luciddreams/ito-controller/3d-review/isometric.png

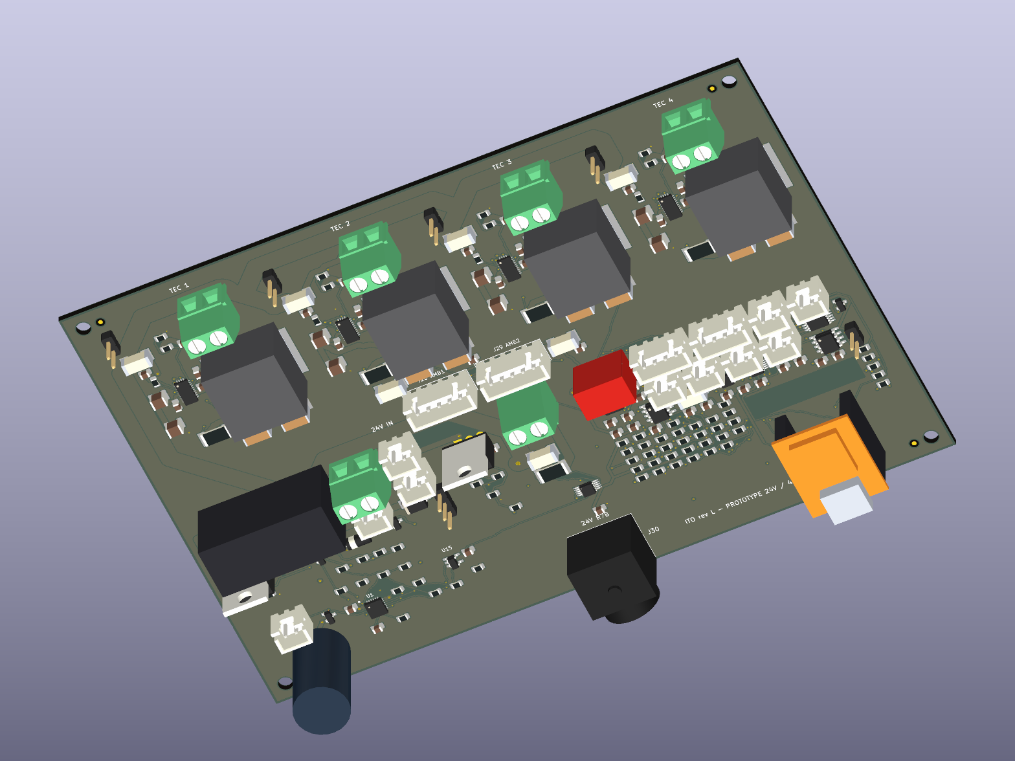
3d-review/isometric.png
