luciddreams/ito-controller/3d-review/top.png

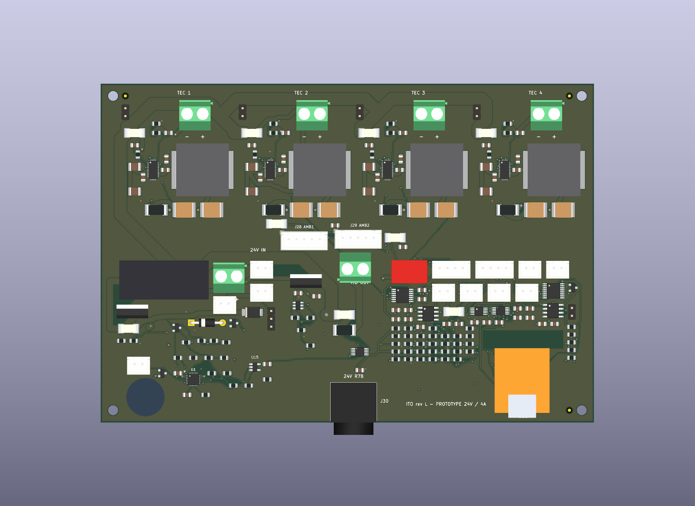
3d-review/top.png
