luciddreams/ito-controller/datasheets/README.md

# Datasheets and component index

Retrieved/checked on 26 September 2026. Exact suffixes and order codes in the BOM remain authoritative. This is a reference collection, not new component qualification.

Local PDFs were checked for readability. All 202 PCB positions are indexed; missing PDF downloads are explicit. Unselected external parts cannot yet have definitive applicable datasheets.

## Complete PCB BOM

| Manufacturer / MPN | References | Document |
|---|---|---|
| Samtec SSW-107-01-G-S | J1, J2 | [Samtec-SSW](Samtec-SSW.pdf) |
| TRACO Power TSR 1-2450 | M1 | [TSR1](TSR1.pdf) |
| Samtec TSW-102-07-G-S | JP1, TP11, TP12, TP13, TP14 | [Samtec-TSW](Samtec-TSW.pdf) |
| Murata GRM21BR61E106KA73L | C1, C2 | [GRM21BR61E106KA73L](GRM21BR61E106KA73L.pdf) |
| Yageo RC0805FR-072K2L | R1, R2, R20 | [Yageo-RC](Yageo-RC.pdf) |
| Yageo RC0805FR-0710KL | R3, R15, R24, R74 | [Yageo-RC](Yageo-RC.pdf) |
| JST B2B-XH-A(LF)(SN) | J5, J6, J7, J8, J21, J22, J23, J24, J25, J9 | [JST-XH](JST-XH.pdf) |
| Yageo RC0805JR-070RL | R4 | [Yageo-RC](Yageo-RC.pdf) |
| Yageo RT0805BRD0710KL | R5, R11, R13, R17, R42, R43, R44, R45, R46, R47, R48, R49, R61, R62, R63, R64, R70 | [Yageo-RT](Yageo-RT.pdf) |
| Yageo RC0805FR-071KL | R6, R18, R65, R66, R67, R68, R71 | [Yageo-RC](Yageo-RC.pdf) |
| Murata GRM21BR71H104KA01L | C3, C4, C10, C12, C20, C21, C22, C23, C24, C26, C28, C30, C31, C105, C205, C305, C405, C40, C41, C42, C43, C44, C50, C7 | [GRM21BR71H104KA01L](GRM21BR71H104KA01L.pdf) |
| Yageo RC0805FR-074K7L | R7, R72 | [Yageo-RC](Yageo-RC.pdf) |
| Phoenix Contact 1715721 | J3, J4, J11, J12, J13, J14 | **PDF missing** — [source](https://www.phoenixcontact.com/services/products/1715721/pdf) |
| Littelfuse 0451010.MRL | F1 | [Littelfuse-451-453](Littelfuse-451-453.pdf) |
| Littelfuse SMBJ33CA | D1 | [SMBJ](SMBJ.pdf) |
| Texas Instruments TPS26630RGER | U1 | [TPS2663](TPS2663.pdf) |
| Yageo RT0805BRD07156KL | R10 | [Yageo-RT](Yageo-RT.pdf) |
| Yageo RT0805BRD07223KL | R12 | [Yageo-RT](Yageo-RT.pdf) |
| Yageo RT0805BRD074K02L | R14 | [Yageo-RT](Yageo-RT.pdf) |
| Infineon IRLB4030PBF | Q2 | [IRLB4030](IRLB4030.pdf) |
| onsemi BSS138LT1G | Q3 | [BSS138](BSS138.pdf) |
| Yageo RT0805BRD07150KL | R16 | [Yageo-RT](Yageo-RT.pdf) |
| Panasonic EEUFR1H471 | C5 | [Panasonic-FR](Panasonic-FR.pdf) |
| Murata GRM21BR71H105KA12L | C6, C11, C103, C104, C203, C204, C303, C304, C403, C404, C51, C52 | [GRM21BR71H105KA12L](GRM21BR71H105KA12L.pdf) |
| Omron G2RL-1A-E DC24 | K1 | [Omron-G2RL](Omron-G2RL.pdf) |
| Vishay 1N4007-E3/54 | D2 | [1N4007](1N4007.pdf) |
| onsemi MMBT3904LT1G | Q4, Q5, Q6 | [MMBT3904](MMBT3904.pdf) |
| Yageo RC0805FR-07100KL | R21, R22, R23, R32, R33, R51, R55, R52, R56, R53, R57, R54, R58, R103, R203, R303, R403, R73, R19 | [Yageo-RC](Yageo-RC.pdf) |
| Panasonic ERJP06F1002V | R25 | [Panasonic-ERJP06](Panasonic-ERJP06.pdf) |
| Samtec TSW-103-07-G-S | TP1 | [Samtec-TSW](Samtec-TSW.pdf) |
| Littelfuse 0451005.MRL | F2 | [Littelfuse-451-453](Littelfuse-451-453.pdf) |
| Vishay WSL2512R0100FEA | RSH1 | [WSL](WSL.pdf) |
| STMicroelectronics STP55NF06L | Q1 | [STP55NF06L](STP55NF06L.pdf) |
| Texas Instruments UCC27511DBVR | U2 | [UCC27511](UCC27511.pdf) |
| Yageo RC0805FR-0722RL | R30 | [Yageo-RC](Yageo-RC.pdf) |
| Yageo RC0805FR-0710RL | R31 | [Yageo-RC](Yageo-RC.pdf) |
| Texas Instruments INA226AIDGSR | U3 | [INA226](INA226.pdf) |
| Microchip MCP4728-E/UN | U4 | [MCP4728](MCP4728.pdf) |
| Texas Instruments OPA2333AIDR | U5, U6 | [OPA333](OPA333.pdf) |
| Texas Instruments TCA9534PWR | U7 | [TCA9534](TCA9534.pdf) |
| Texas Instruments SN74LVC08APWR | U8 | [SN74LVC08A](SN74LVC08A.pdf) |
| Analog Devices LT8613EUDE#PBF | U11, U12, U13, U14 | [LT8613](LT8613.pdf) |
| Littelfuse 045102.5MRL | F11, F12, F13, F14 | [Littelfuse-451-453](Littelfuse-451-453.pdf) |
| Murata GRM32ER71H106KA12L | C101, C102, C201, C202, C301, C302, C401, C402 | **PDF missing** — [Murata product search](https://pim.murata.com/en-global/pim/details/?partNum=GRM32ER71H106KA12L) |
| Murata GRM21BR71H103KA01L | C106, C206, C306, C406 | **PDF missing** — [Murata product search](https://pim.murata.com/en-global/pim/details/?partNum=GRM21BR71H103KA01L) |
| Yageo RC0805FR-0788K7L | R101, R201, R301, R401 | [Yageo-RC](Yageo-RC.pdf) |
| Vishay IHLP6767GZEK100M11 | L1, L2, L3, L4 | [IHLP6767GZ](IHLP6767GZ.pdf) |
| KEMET C2220C476M3R2C7186 | C107, C108, C207, C208, C307, C308, C407, C408 | [KEMET-KPS-X7R](KEMET-KPS-X7R.pdf) |
| Vishay WSL2512R0250FEA | RS1, RS2, RS3, RS4 | [WSL](WSL.pdf) |
| Yageo RC0805FR-071M13L | R102, R202, R302, R402 | [Yageo-RC](Yageo-RC.pdf) |
| KEMET C0805C100J5GACTU | C109, C209, C309, C409 | [KEMET-C0G](KEMET-C0G.pdf) |
| Texas Instruments ADS1115IDGSR | U9 | [ADS1115](ADS1115.pdf) |
| JST B4B-XH-A(LF)(SN) | J26, J27 | [JST-XH](JST-XH.pdf) |
| Littelfuse 0451001.MRL | F3 | [Littelfuse-451-453](Littelfuse-451-453.pdf) |
| Texas Instruments SN74AHC1G08DBVR | U15 | [SN74AHC1G08](SN74AHC1G08.pdf) |
| JST B5B-XH-A(LF)(SN) | J28, J29 | [JST-XH](JST-XH.pdf) |
| Littelfuse 0451.250MRL | F4, F5 | [Littelfuse-451-453](Littelfuse-451-453.pdf) |
| Kycon KPJX-4S | J30 | [KPJX-4S](KPJX-4S.pdf) |

## System and external modules

| Item | Reference |
|---|---|
| GST160A | [GST160A.pdf](GST160A.pdf) |
| XIAO-nRF52840-schematic | [XIAO-nRF52840-schematic.pdf](XIAO-nRF52840-schematic.pdf) |
| XIAO-series-manual | [XIAO-series-manual.pdf](XIAO-series-manual.pdf) |
| TEC1-12706-reference | [TEC1-12706-reference.pdf](TEC1-12706-reference.pdf) |
| PCA9615 | [PCA9615.pdf](PCA9615.pdf) |
| SHT3x-DIS | [SHT3x-DIS.pdf](SHT3x-DIS.pdf) |
| SparkFun COM-16988 | [Official adapter schematic](https://github.com/sparkfun/QwiicBus_EndPoint/blob/main/Hardware/SparkFun_QwiicBus_Endpoint.sch) |
| Adafruit 2857 | [Official module guide](https://learn.adafruit.com/adafruit-sht31-d-temperature-and-humidity-sensor-breakout/pinouts); SHT3x PDF above |
| Phoenix 1715721 | [Official product data and drawings](https://www.phoenixcontact.com/en-sg/products/printed-circuit-board-terminal-mkds-15-2-508-1715721) |

TEC1-12706 is a generic type designation; the reference PDF does not identify the manufacturer of the purchased modules. XIAO documents may cover several variants: use the BLE nRF52840 and the specified pinout, not Plus/Sense.

Still to select: exact 10 kΩ NTC probes, NC thermostats/emergency stop, 24 V fan, air/water cooling, coating and thermal interfaces. Definitive datasheets depend on the eventual order codes.

## Provenance and integrity

`manifest.json` records source URL, date, size and SHA-256, or a download error. `bom-coverage.json` maps all 202 positions. The GRM21BR61E106KA73L manufacturer document was retrieved through a third-party mirror; this does not establish that it is the latest revision. Check current manufacturer specifications before production.
