luciddreams/ito-controller/manufacturing/drill-report.txt

Drill report for ito-controller.kicad_pcb
Created on 2026-09-24T10:47:52+0100

Copper Layer Stackup:
    =============================================================
    L1 :  F.Cu                      front
    L2 :  In1.Cu                    in1
    L3 :  In2.Cu                    in2
    L4 :  B.Cu                      back

Drill file 'ito-controller-PTH.drl' contains
    plated through holes:
    =============================================================
    T1  0.250mm  0.0098"  (159 holes)
    T2  0.300mm  0.0118"  (126 holes)
    T3  0.350mm  0.0138"  (1 hole)
    T4  0.400mm  0.0157"  (4 holes)
    T5  0.500mm  0.0197"  (27 holes)
    T6  0.600mm  0.0236"  (4 holes)
    T7  0.600mm  0.0236"  (4 holes)  (with 4 slots)
    T8  0.950mm  0.0374"  (18 holes)
    T9  1.000mm  0.0394"  (2 holes)
    T10  1.000mm  0.0394"  (50 holes)
    T11  1.100mm  0.0433"  (8 holes)
    T12  1.200mm  0.0472"  (2 holes)
    T13  1.300mm  0.0512"  (18 holes)

    Total plated holes count 423

Drill file 'ito-controller-NPTH.drl' contains
    unplated through holes:
    =============================================================
    T1  1.000mm  0.0394"  (1 hole)  (with 1 slot)
    T2  1.700mm  0.0669"  (2 holes)
    T3  3.200mm  0.1260"  (4 holes)

    Total unplated holes count 7
