luciddreams/ito-controller/docs/GITHUB-IMPORT.md

# Revision L GitHub import

Target: https://github.com/luciddreams/ito-controller

On 26 September 2026, access was confirmed for the connected user `jasjazuidmeer`, including write permission. The repository was empty before the import. Initial full-project commit: `78a5e5b91e51cb6c364b3cd9b65e039dc381aa2d`.

The import included revision L, firmware, fabrication output, models, detailed documentation and 40 available manufacturer PDFs. The datasheet index maps all 202 PCB positions and explicitly identifies three part types with missing PDFs. Exact external NTC probes, fan and thermostats remain unselected.

PCB, schematic and firmware engineering files were unchanged by the initial documentation import. Existing checks were retained; no physical tests were performed. Historical revisions are explicitly archived. No project license has been selected.

The subsequent English-language update translates current documentation and schematic annotations. See `english-localization-validation.json` for verification of that update.
