luciddreams/ito-controller/THIRD-PARTY-NOTICES.md

# Third-party documents and models

Manufacturer datasheets, drawings, module names and trademarks remain the property of their respective rights holders. They are included as engineering references at the project owner's request and are not relicensed under a new project license. Source URL, retrieval date and SHA-256 are recorded in `datasheets/manifest.json`. Family datasheets cover multiple order codes; verify the exact suffix and ratings before ordering.

Model provenance is described in `3D-INSPECTION.md` and the model directory. Firmware depends on the external Seeed/Adafruit board core described in `firmware/README.md`; the complete core is not bundled. No license has been selected for the project's own work. Manufacturer documents retain their original language and content.
