luciddreams/ito-controller/3d-review/bottom.png

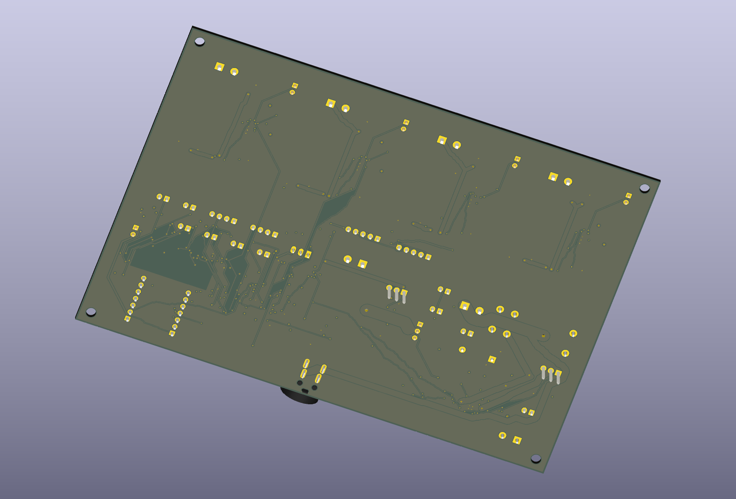
3d-review/bottom.png
