luciddreams/ito-controller/pcb-routing-preview.png

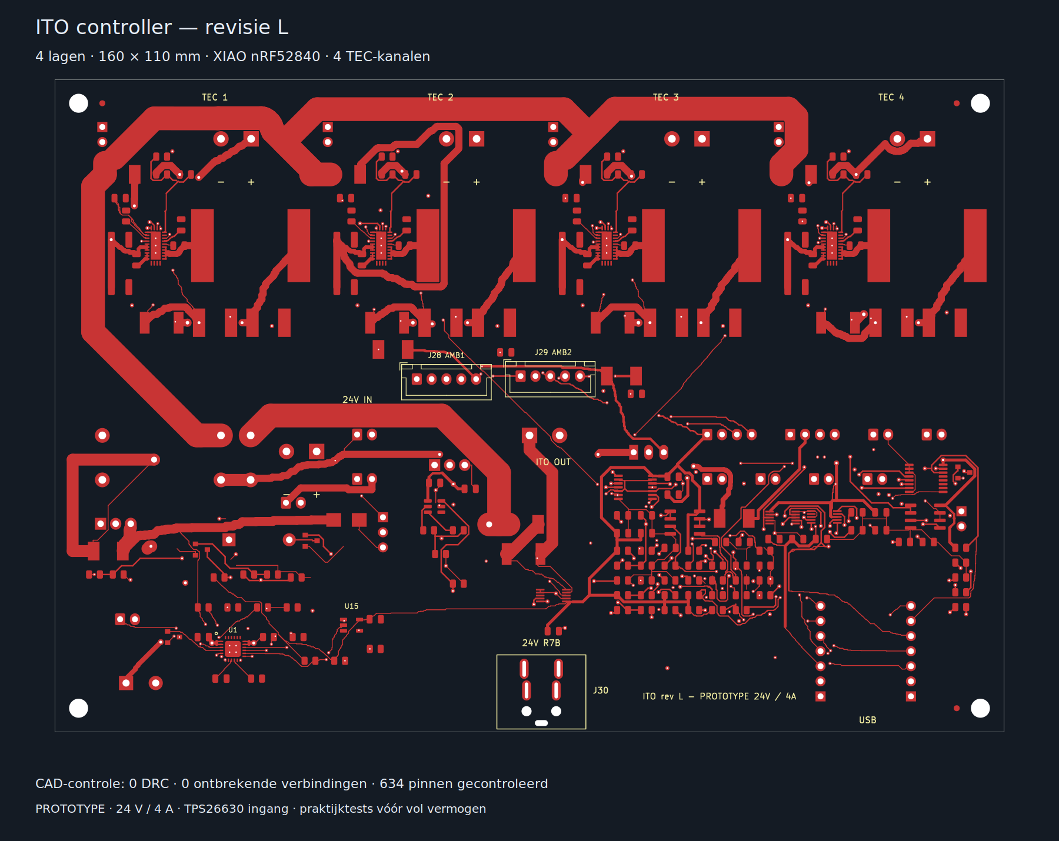
pcb-routing-preview.png
