luciddreams/ito-controller/BOM-prototype.csv

Reference | Quantity | Value | Description_EN | Manufacturer | MPN | Footprint | Specification | Assembly
J1 | 1 | XIAO right socket 1x7 - USB down | XIAO right socket 1x7 - USB down | Samtec | SSW-107-01-G-S | ITO_PCB:PinSocket_1x07_P2.54mm_Vertical |  | THT manual
J2 | 1 | XIAO left socket 1x7 - USB down | XIAO left socket 1x7 - USB down | Samtec | SSW-107-01-G-S | ITO_PCB:PinSocket_1x07_P2.54mm_Vertical |  | THT manual
M1 | 1 | TSR 1-2450 | TSR 1-2450 | TRACO Power | TSR 1-2450 | ITO_PCB:Converter_DCDC_TRACO_TSR-1_THT |  | THT manual
JP1 | 1 | Voedingsjumper - standaard OPEN | Power jumper - default OPEN | Samtec | TSW-102-07-G-S | ITO_PCB:PinHeader_1x02_P2.54mm_Vertical |  | THT manual
C1 | 1 | 10u / 10V | 10u / 10V | Murata | GRM21BR61E106KA73L | ITO_PCB:C_0805_2012Metric | 0805, 10uF, 25V, X5R, 10%; used on <=5V rails | SMT
C2 | 1 | 10u / 10V | 10u / 10V | Murata | GRM21BR61E106KA73L | ITO_PCB:C_0805_2012Metric | 0805, 10uF, 25V, X5R, 10%; used on <=5V rails | SMT
R1 | 1 | 2k2 | 2k2 | Yageo | RC0805FR-072K2L | ITO_PCB:R_0805_2012Metric | 0805, 1%, >=0.125W, >=50V | SMT
R2 | 1 | 2k2 | 2k2 | Yageo | RC0805FR-072K2L | ITO_PCB:R_0805_2012Metric | 0805, 1%, >=0.125W, >=50V | SMT
R3 | 1 | 10k | 10k | Yageo | RC0805FR-0710KL | ITO_PCB:R_0805_2012Metric | 0805, 1%, >=0.125W, >=50V | SMT
J5 | 1 | Connector 2 pins | Connector 2 pins | JST | B2B-XH-A(LF)(SN) | ITO_PCB:JST_XH_B2B-XH-A_1x02_P2.50mm_Vertical |  | THT manual
R4 | 1 | 0R | 0R | Yageo | RC0805JR-070RL | ITO_PCB:R_0805_2012Metric | 0805 zero-ohm link; signal only | SMT
R5 | 1 | 10k 0.1% | 10k 0.1% | Yageo | RT0805BRD0710KL | ITO_PCB:R_0805_2012Metric | 0805 thin film, 0.1%, 25ppm/K or better, >=0.125W | SMT
R6 | 1 | 1k | 1k | Yageo | RC0805FR-071KL | ITO_PCB:R_0805_2012Metric | 0805, 1%, >=0.125W, >=50V | SMT
C3 | 1 | 100n | 100n | Murata | GRM21BR71H104KA01L | ITO_PCB:C_0805_2012Metric | 0805, 100nF, 50V, X7R, 10% | SMT
R7 | 1 | 4k7 | 4k7 | Yageo | RC0805FR-074K7L | ITO_PCB:R_0805_2012Metric | 0805, 1%, >=0.125W, >=50V | SMT
J3 | 1 | Connector 2 pins | Connector 2 pins | Phoenix Contact | 1715721 | ITO_PCB:TerminalBlock_Phoenix_MKDS-1,5-2-5.08_1x02_P5.08mm_Horizontal | MKDS 1,5/2-5,08; 2 positions, pitch 5.08mm | THT manual
F1 | 1 | 10A / 125V DC 0451010.MRL | 10A / 125V DC 0451010.MRL | Littelfuse | 0451010.MRL | ITO_PCB:Littelfuse_451 |  | SMT
D1 | 1 | SMBJ33CA bidirectioneel | SMBJ33CA bidirectioneel | Littelfuse | SMBJ33CA | ITO_PCB:D_SMB |  | SMT
U1 | 1 | TPS26630RGER | TPS26630RGER | Texas Instruments | TPS26630RGER | ITO_PCB:TI_RGE0024H_4x4_EP2.7 |  | SMT
R10 | 1 | 156k 0.1% | 156k 0.1% | Yageo | RT0805BRD07156KL | ITO_PCB:R_0805_2012Metric | 0805 thin film, 0.1%, 25ppm/K or better, >=0.125W | SMT
R11 | 1 | 10k 0.1% | 10k 0.1% | Yageo | RT0805BRD0710KL | ITO_PCB:R_0805_2012Metric | 0805 thin film, 0.1%, 25ppm/K or better, >=0.125W | SMT
R12 | 1 | 223k 0.1% | 223k 0.1% | Yageo | RT0805BRD07223KL | ITO_PCB:R_0805_2012Metric | 0805 thin film, 0.1%, 25ppm/K or better, >=0.125W | SMT
R13 | 1 | 10k 0.1% | 10k 0.1% | Yageo | RT0805BRD0710KL | ITO_PCB:R_0805_2012Metric | 0805 thin film, 0.1%, 25ppm/K or better, >=0.125W | SMT
R14 | 1 | 4.02k 0.1% | 4.02k 0.1% | Yageo | RT0805BRD074K02L | ITO_PCB:R_0805_2012Metric | 0805 thin film, 0.1%, 25ppm/K or better, >=0.125W | SMT
R15 | 1 | 10k | 10k | Yageo | RC0805FR-0710KL | ITO_PCB:R_0805_2012Metric | 0805, 1%, >=0.125W, >=50V | SMT
Q2 | 1 | IRLB4030PBF | IRLB4030PBF | Infineon | IRLB4030PBF | ITO_PCB:TO-220-3_Vertical |  | THT manual
Q3 | 1 | BSS138LT1G | BSS138LT1G | onsemi | BSS138LT1G | ITO_PCB:SOT-23 |  | SMT
R16 | 1 | 150k 0.1% | 150k 0.1% | Yageo | RT0805BRD07150KL | ITO_PCB:R_0805_2012Metric | 0805 thin film, 0.1%, 25ppm/K or better, >=0.125W | SMT
R17 | 1 | 10k 0.1% | 10k 0.1% | Yageo | RT0805BRD0710KL | ITO_PCB:R_0805_2012Metric | 0805 thin film, 0.1%, 25ppm/K or better, >=0.125W | SMT
R18 | 1 | 1k | 1k | Yageo | RC0805FR-071KL | ITO_PCB:R_0805_2012Metric | 0805, 1%, >=0.125W, >=50V | SMT
C4 | 1 | 100n / 50V X7R 10% | 100n / 50V X7R 10% | Murata | GRM21BR71H104KA01L | ITO_PCB:C_0805_2012Metric | dVdt timing; calculate with effective C = 70..127nF, including temperature/aging allowance | SMT
C5 | 1 | 470u / 50V EEUFR1H471 | 470u / 50V EEUFR1H471 | Panasonic | EEUFR1H471 | ITO_PCB:CP_Radial_D12.5mm_P5.00mm | 470uF 50V radial; 12.5mm diameter, 5mm pitch; reserve22mm height | THT manual
C6 | 1 | 1u / 50V X7R | 1u / 50V X7R | Murata | GRM21BR71H105KA12L | ITO_PCB:C_0805_2012Metric | 0805, 1uF, 50V, X7R, 10% | SMT
J6 | 1 | Connector 2 pins | Connector 2 pins | JST | B2B-XH-A(LF)(SN) | ITO_PCB:JST_XH_B2B-XH-A_1x02_P2.50mm_Vertical |  | THT manual
J7 | 1 | Connector 2 pins | Connector 2 pins | JST | B2B-XH-A(LF)(SN) | ITO_PCB:JST_XH_B2B-XH-A_1x02_P2.50mm_Vertical |  | THT manual
J8 | 1 | Connector 2 pins | Connector 2 pins | JST | B2B-XH-A(LF)(SN) | ITO_PCB:JST_XH_B2B-XH-A_1x02_P2.50mm_Vertical |  | THT manual
K1 | 1 | G2RL-1A-E DC24 | G2RL-1A-E DC24 | Omron | G2RL-1A-E DC24 | ITO_PCB:G2RL_1A_E_review |  | THT manual
D2 | 1 | 1N4007 | 1N4007 | Vishay | 1N4007-E3/54 | ITO_PCB:D_DO-41_SOD81_P10.16mm_Horizontal |  | THT manual
Q4 | 1 | MMBT3904 | MMBT3904 | onsemi | MMBT3904LT1G | ITO_PCB:SOT-23 |  | SMT
R20 | 1 | 2k2 | 2k2 | Yageo | RC0805FR-072K2L | ITO_PCB:R_0805_2012Metric | 0805, 1%, >=0.125W, >=50V | SMT
R21 | 1 | 100k | 100k | Yageo | RC0805FR-07100KL | ITO_PCB:R_0805_2012Metric | 0805, 1%, >=0.125W, >=50V | SMT
Q5 | 1 | MMBT3904 | MMBT3904 | onsemi | MMBT3904LT1G | ITO_PCB:SOT-23 |  | SMT
R22 | 1 | 100k | 100k | Yageo | RC0805FR-07100KL | ITO_PCB:R_0805_2012Metric | 0805, 1%, >=0.125W, >=50V | SMT
R23 | 1 | 100k | 100k | Yageo | RC0805FR-07100KL | ITO_PCB:R_0805_2012Metric | 0805, 1%, >=0.125W, >=50V | SMT
R24 | 1 | 10k | 10k | Yageo | RC0805FR-0710KL | ITO_PCB:R_0805_2012Metric | 0805, 1%, >=0.125W, >=50V | SMT
R25 | 1 | 10k / 0.25W | 10k / 0.25W | Panasonic | ERJP06F1002V | ITO_PCB:R_0805_2012Metric | 0805 10k 1%, 0.5W; output bleeder. | SMT
TP1 | 1 | Connector 3 pins | Connector 3 pins | Samtec | TSW-103-07-G-S | ITO_PCB:PinHeader_1x03_P2.54mm_Vertical |  | THT manual
F2 | 1 | 5A / 125V DC 0451005.MRL | 5A / 125V DC 0451005.MRL | Littelfuse | 0451005.MRL | ITO_PCB:Littelfuse_451 |  | SMT
RSH1 | 1 | 10m / 1W / 1% WSL2512R0100FEA | 10m / 1W / 1% WSL2512R0100FEA | Vishay | WSL2512R0100FEA | ITO_PCB:WSL2512_7m_to_500m |  | SMT
J4 | 1 | Connector 2 pins | Connector 2 pins | Phoenix Contact | 1715721 | ITO_PCB:TerminalBlock_Phoenix_MKDS-1,5-2-5.08_1x02_P5.08mm_Horizontal | MKDS 1,5/2-5,08; 2 positions, pitch 5.08mm | THT manual
Q1 | 1 | STP55NF06L | STP55NF06L | STMicroelectronics | STP55NF06L | ITO_PCB:TO-220-3_Vertical |  | THT manual
U2 | 1 | UCC27511DBV | UCC27511DBV | Texas Instruments | UCC27511DBVR | ITO_PCB:SOT-23-6 |  | SMT
R30 | 1 | 22R | 22R | Yageo | RC0805FR-0722RL | ITO_PCB:R_0805_2012Metric | 0805, 1%, >=0.125W, >=50V | SMT
R31 | 1 | 10R | 10R | Yageo | RC0805FR-0710RL | ITO_PCB:R_0805_2012Metric | 0805, 1%, >=0.125W, >=50V | SMT
R32 | 1 | 100k | 100k | Yageo | RC0805FR-07100KL | ITO_PCB:R_0805_2012Metric | 0805, 1%, >=0.125W, >=50V | SMT
R33 | 1 | 100k | 100k | Yageo | RC0805FR-07100KL | ITO_PCB:R_0805_2012Metric | 0805, 1%, >=0.125W, >=50V | SMT
C10 | 1 | 100n / 10V | 100n / 10V | Murata | GRM21BR71H104KA01L | ITO_PCB:C_0805_2012Metric | 0805, 100nF, 50V, X7R, 10% | SMT
C11 | 1 | 1u / 10V | 1u / 10V | Murata | GRM21BR71H105KA12L | ITO_PCB:C_0805_2012Metric | 0805, 1uF, 50V, X7R, 10% | SMT
U3 | 1 | INA226AIDGS | INA226AIDGS | Texas Instruments | INA226AIDGSR | ITO_PCB:VSSOP-10_3x3mm_P0.5mm |  | SMT
C12 | 1 | 100n / 10V | 100n / 10V | Murata | GRM21BR71H104KA01L | ITO_PCB:C_0805_2012Metric | 0805, 100nF, 50V, X7R, 10% | SMT
U4 | 1 | MCP4728-E-UN | MCP4728-E-UN | Microchip | MCP4728-E/UN | ITO_PCB:MSOP-10_3x3mm_P0.5mm |  | SMT
C20 | 1 | 100n / 10V | 100n / 10V | Murata | GRM21BR71H104KA01L | ITO_PCB:C_0805_2012Metric | 0805, 100nF, 50V, X7R, 10% | SMT
R42 | 1 | 10k 0.1% | 10k 0.1% | Yageo | RT0805BRD0710KL | ITO_PCB:R_0805_2012Metric | 0805 thin film, 0.1%, 25ppm/K or better, >=0.125W | SMT
R43 | 1 | 10k 0.1% | 10k 0.1% | Yageo | RT0805BRD0710KL | ITO_PCB:R_0805_2012Metric | 0805 thin film, 0.1%, 25ppm/K or better, >=0.125W | SMT
C21 | 1 | 100n / 10V | 100n / 10V | Murata | GRM21BR71H104KA01L | ITO_PCB:C_0805_2012Metric | 0805, 100nF, 50V, X7R, 10% | SMT
R44 | 1 | 10k 0.1% | 10k 0.1% | Yageo | RT0805BRD0710KL | ITO_PCB:R_0805_2012Metric | 0805 thin film, 0.1%, 25ppm/K or better, >=0.125W | SMT
R45 | 1 | 10k 0.1% | 10k 0.1% | Yageo | RT0805BRD0710KL | ITO_PCB:R_0805_2012Metric | 0805 thin film, 0.1%, 25ppm/K or better, >=0.125W | SMT
C22 | 1 | 100n / 10V | 100n / 10V | Murata | GRM21BR71H104KA01L | ITO_PCB:C_0805_2012Metric | 0805, 100nF, 50V, X7R, 10% | SMT
R46 | 1 | 10k 0.1% | 10k 0.1% | Yageo | RT0805BRD0710KL | ITO_PCB:R_0805_2012Metric | 0805 thin film, 0.1%, 25ppm/K or better, >=0.125W | SMT
R47 | 1 | 10k 0.1% | 10k 0.1% | Yageo | RT0805BRD0710KL | ITO_PCB:R_0805_2012Metric | 0805 thin film, 0.1%, 25ppm/K or better, >=0.125W | SMT
C23 | 1 | 100n / 10V | 100n / 10V | Murata | GRM21BR71H104KA01L | ITO_PCB:C_0805_2012Metric | 0805, 100nF, 50V, X7R, 10% | SMT
R48 | 1 | 10k 0.1% | 10k 0.1% | Yageo | RT0805BRD0710KL | ITO_PCB:R_0805_2012Metric | 0805 thin film, 0.1%, 25ppm/K or better, >=0.125W | SMT
R49 | 1 | 10k 0.1% | 10k 0.1% | Yageo | RT0805BRD0710KL | ITO_PCB:R_0805_2012Metric | 0805 thin film, 0.1%, 25ppm/K or better, >=0.125W | SMT
C24 | 1 | 100n / 10V | 100n / 10V | Murata | GRM21BR71H104KA01L | ITO_PCB:C_0805_2012Metric | 0805, 100nF, 50V, X7R, 10% | SMT
U5 | 1 | OPA2333AID | OPA2333AID | Texas Instruments | OPA2333AIDR | ITO_PCB:SOIC-8_3.9x4.9mm_P1.27mm |  | SMT
C26 | 1 | 100n / 10V | 100n / 10V | Murata | GRM21BR71H104KA01L | ITO_PCB:C_0805_2012Metric | 0805, 100nF, 50V, X7R, 10% | SMT
U6 | 1 | OPA2333AID | OPA2333AID | Texas Instruments | OPA2333AIDR | ITO_PCB:SOIC-8_3.9x4.9mm_P1.27mm |  | SMT
C28 | 1 | 100n / 10V | 100n / 10V | Murata | GRM21BR71H104KA01L | ITO_PCB:C_0805_2012Metric | 0805, 100nF, 50V, X7R, 10% | SMT
U7 | 1 | TCA9534PWR | TCA9534PWR | Texas Instruments | TCA9534PWR | ITO_PCB:TSSOP-16_4.4x5mm_P0.65mm |  | SMT
U8 | 1 | SN74LVC08APWR | SN74LVC08APWR | Texas Instruments | SN74LVC08APWR | ITO_PCB:TSSOP-14_4.4x5mm_P0.65mm |  | SMT
C30 | 1 | 100n / 10V | 100n / 10V | Murata | GRM21BR71H104KA01L | ITO_PCB:C_0805_2012Metric | 0805, 100nF, 50V, X7R, 10% | SMT
C31 | 1 | 100n / 10V | 100n / 10V | Murata | GRM21BR71H104KA01L | ITO_PCB:C_0805_2012Metric | 0805, 100nF, 50V, X7R, 10% | SMT
R51 | 1 | 100k | 100k | Yageo | RC0805FR-07100KL | ITO_PCB:R_0805_2012Metric | 0805, 1%, >=0.125W, >=50V | SMT
R55 | 1 | 100k | 100k | Yageo | RC0805FR-07100KL | ITO_PCB:R_0805_2012Metric | 0805, 1%, >=0.125W, >=50V | SMT
R52 | 1 | 100k | 100k | Yageo | RC0805FR-07100KL | ITO_PCB:R_0805_2012Metric | 0805, 1%, >=0.125W, >=50V | SMT
R56 | 1 | 100k | 100k | Yageo | RC0805FR-07100KL | ITO_PCB:R_0805_2012Metric | 0805, 1%, >=0.125W, >=50V | SMT
R53 | 1 | 100k | 100k | Yageo | RC0805FR-07100KL | ITO_PCB:R_0805_2012Metric | 0805, 1%, >=0.125W, >=50V | SMT
R57 | 1 | 100k | 100k | Yageo | RC0805FR-07100KL | ITO_PCB:R_0805_2012Metric | 0805, 1%, >=0.125W, >=50V | SMT
R54 | 1 | 100k | 100k | Yageo | RC0805FR-07100KL | ITO_PCB:R_0805_2012Metric | 0805, 1%, >=0.125W, >=50V | SMT
R58 | 1 | 100k | 100k | Yageo | RC0805FR-07100KL | ITO_PCB:R_0805_2012Metric | 0805, 1%, >=0.125W, >=50V | SMT
U11 | 1 | LT8613EUDE | LT8613EUDE | Analog Devices | LT8613EUDE#PBF | ITO_PCB:QFN-28-1EP_3x6mm_P0.5mm_EP1.7x4.75mm |  | SMT
F11 | 1 | 2.5A / 125V DC 045102.5MRL | 2.5A / 125V DC 045102.5MRL | Littelfuse | 045102.5MRL | ITO_PCB:Littelfuse_451 |  | SMT
C101 | 1 | 10u / 50V X7R | 10u / 50V X7R | Murata | GRM32ER71H106KA12L | ITO_PCB:C_1210_3225Metric | 1210, 10uF, 50V, X7R, 10%; no 0805 substitution | SMT
C102 | 1 | 10u / 50V X7R | 10u / 50V X7R | Murata | GRM32ER71H106KA12L | ITO_PCB:C_1210_3225Metric | 1210, 10uF, 50V, X7R, 10%; no 0805 substitution | SMT
C103 | 1 | 1u / 50V X7R | 1u / 50V X7R | Murata | GRM21BR71H105KA12L | ITO_PCB:C_0805_2012Metric | 0805, 1uF, 50V, X7R, 10% | SMT
C104 | 1 | 1u / 10V | 1u / 10V | Murata | GRM21BR71H105KA12L | ITO_PCB:C_0805_2012Metric | 0805, 1uF, 50V, X7R, 10% | SMT
C105 | 1 | 100n / 10V | 100n / 10V | Murata | GRM21BR71H104KA01L | ITO_PCB:C_0805_2012Metric | 0805, 100nF, 50V, X7R, 10% | SMT
C106 | 1 | 10n / 10V | 10n / 10V | Murata | GRM21BR71H103KA01L | ITO_PCB:C_0805_2012Metric | 0805, 10nF, 50V, X7R, 10% | SMT
R101 | 1 | 88k7 1% | 88k7 1% | Yageo | RC0805FR-0788K7L | ITO_PCB:R_0805_2012Metric | 0805, 1%, >=0.125W, >=50V | SMT
L1 | 1 | 10uH IHLP6767GZEK100M11 | 10uH IHLP6767GZEK100M11 | Vishay | IHLP6767GZEK100M11 | ITO_PCB:L_Vishay_IHLP-6767 |  | SMT
C107 | 1 | 47u / 25V X7R C2220C476M3R2C7186 | 47u / 25V X7R C2220C476M3R2C7186 | KEMET | C2220C476M3R2C7186 | ITO_PCB:KEMET_KPS_2220_Double | KPS stacked 2220, 47uF, 25V, X7R, 20%; custom pads | SMT
C108 | 1 | 47u / 25V X7R C2220C476M3R2C7186 | 47u / 25V X7R C2220C476M3R2C7186 | KEMET | C2220C476M3R2C7186 | ITO_PCB:KEMET_KPS_2220_Double | KPS stacked 2220, 47uF, 25V, X7R, 20%; custom pads | SMT
RS1 | 1 | 25m / 1W / 1% WSL2512R0250FEA | 25m / 1W / 1% WSL2512R0250FEA | Vishay | WSL2512R0250FEA | ITO_PCB:WSL2512_7m_to_500m |  | SMT
R102 | 1 | 1M13 1% | 1M13 1% | Yageo | RC0805FR-071M13L | ITO_PCB:R_0805_2012Metric | 0805, 1%, >=0.125W, >=50V | SMT
R103 | 1 | 100k 1% | 100k 1% | Yageo | RC0805FR-07100KL | ITO_PCB:R_0805_2012Metric | 0805, 1%, >=0.125W, >=50V | SMT
C109 | 1 | 10p C0G | 10p C0G | KEMET | C0805C100J5GACTU | ITO_PCB:C_0805_2012Metric | 0805, 10pF, C0G, 50V, 5% | SMT
J11 | 1 | Connector 2 pins | Connector 2 pins | Phoenix Contact | 1715721 | ITO_PCB:TerminalBlock_Phoenix_MKDS-1,5-2-5.08_1x02_P5.08mm_Horizontal | MKDS 1,5/2-5,08; 2 positions, pitch 5.08mm | THT manual
TP11 | 1 | Connector 2 pins | Connector 2 pins | Samtec | TSW-102-07-G-S | ITO_PCB:PinHeader_1x02_P2.54mm_Vertical |  | THT manual
U12 | 1 | LT8613EUDE | LT8613EUDE | Analog Devices | LT8613EUDE#PBF | ITO_PCB:QFN-28-1EP_3x6mm_P0.5mm_EP1.7x4.75mm |  | SMT
F12 | 1 | 2.5A / 125V DC 045102.5MRL | 2.5A / 125V DC 045102.5MRL | Littelfuse | 045102.5MRL | ITO_PCB:Littelfuse_451 |  | SMT
C201 | 1 | 10u / 50V X7R | 10u / 50V X7R | Murata | GRM32ER71H106KA12L | ITO_PCB:C_1210_3225Metric | 1210, 10uF, 50V, X7R, 10%; no 0805 substitution | SMT
C202 | 1 | 10u / 50V X7R | 10u / 50V X7R | Murata | GRM32ER71H106KA12L | ITO_PCB:C_1210_3225Metric | 1210, 10uF, 50V, X7R, 10%; no 0805 substitution | SMT
C203 | 1 | 1u / 50V X7R | 1u / 50V X7R | Murata | GRM21BR71H105KA12L | ITO_PCB:C_0805_2012Metric | 0805, 1uF, 50V, X7R, 10% | SMT
C204 | 1 | 1u / 10V | 1u / 10V | Murata | GRM21BR71H105KA12L | ITO_PCB:C_0805_2012Metric | 0805, 1uF, 50V, X7R, 10% | SMT
C205 | 1 | 100n / 10V | 100n / 10V | Murata | GRM21BR71H104KA01L | ITO_PCB:C_0805_2012Metric | 0805, 100nF, 50V, X7R, 10% | SMT
C206 | 1 | 10n / 10V | 10n / 10V | Murata | GRM21BR71H103KA01L | ITO_PCB:C_0805_2012Metric | 0805, 10nF, 50V, X7R, 10% | SMT
R201 | 1 | 88k7 1% | 88k7 1% | Yageo | RC0805FR-0788K7L | ITO_PCB:R_0805_2012Metric | 0805, 1%, >=0.125W, >=50V | SMT
L2 | 1 | 10uH IHLP6767GZEK100M11 | 10uH IHLP6767GZEK100M11 | Vishay | IHLP6767GZEK100M11 | ITO_PCB:L_Vishay_IHLP-6767 |  | SMT
C207 | 1 | 47u / 25V X7R C2220C476M3R2C7186 | 47u / 25V X7R C2220C476M3R2C7186 | KEMET | C2220C476M3R2C7186 | ITO_PCB:KEMET_KPS_2220_Double | KPS stacked 2220, 47uF, 25V, X7R, 20%; custom pads | SMT
C208 | 1 | 47u / 25V X7R C2220C476M3R2C7186 | 47u / 25V X7R C2220C476M3R2C7186 | KEMET | C2220C476M3R2C7186 | ITO_PCB:KEMET_KPS_2220_Double | KPS stacked 2220, 47uF, 25V, X7R, 20%; custom pads | SMT
RS2 | 1 | 25m / 1W / 1% WSL2512R0250FEA | 25m / 1W / 1% WSL2512R0250FEA | Vishay | WSL2512R0250FEA | ITO_PCB:WSL2512_7m_to_500m |  | SMT
R202 | 1 | 1M13 1% | 1M13 1% | Yageo | RC0805FR-071M13L | ITO_PCB:R_0805_2012Metric | 0805, 1%, >=0.125W, >=50V | SMT
R203 | 1 | 100k 1% | 100k 1% | Yageo | RC0805FR-07100KL | ITO_PCB:R_0805_2012Metric | 0805, 1%, >=0.125W, >=50V | SMT
C209 | 1 | 10p C0G | 10p C0G | KEMET | C0805C100J5GACTU | ITO_PCB:C_0805_2012Metric | 0805, 10pF, C0G, 50V, 5% | SMT
J12 | 1 | Connector 2 pins | Connector 2 pins | Phoenix Contact | 1715721 | ITO_PCB:TerminalBlock_Phoenix_MKDS-1,5-2-5.08_1x02_P5.08mm_Horizontal | MKDS 1,5/2-5,08; 2 positions, pitch 5.08mm | THT manual
TP12 | 1 | Connector 2 pins | Connector 2 pins | Samtec | TSW-102-07-G-S | ITO_PCB:PinHeader_1x02_P2.54mm_Vertical |  | THT manual
U13 | 1 | LT8613EUDE | LT8613EUDE | Analog Devices | LT8613EUDE#PBF | ITO_PCB:QFN-28-1EP_3x6mm_P0.5mm_EP1.7x4.75mm |  | SMT
F13 | 1 | 2.5A / 125V DC 045102.5MRL | 2.5A / 125V DC 045102.5MRL | Littelfuse | 045102.5MRL | ITO_PCB:Littelfuse_451 |  | SMT
C301 | 1 | 10u / 50V X7R | 10u / 50V X7R | Murata | GRM32ER71H106KA12L | ITO_PCB:C_1210_3225Metric | 1210, 10uF, 50V, X7R, 10%; no 0805 substitution | SMT
C302 | 1 | 10u / 50V X7R | 10u / 50V X7R | Murata | GRM32ER71H106KA12L | ITO_PCB:C_1210_3225Metric | 1210, 10uF, 50V, X7R, 10%; no 0805 substitution | SMT
C303 | 1 | 1u / 50V X7R | 1u / 50V X7R | Murata | GRM21BR71H105KA12L | ITO_PCB:C_0805_2012Metric | 0805, 1uF, 50V, X7R, 10% | SMT
C304 | 1 | 1u / 10V | 1u / 10V | Murata | GRM21BR71H105KA12L | ITO_PCB:C_0805_2012Metric | 0805, 1uF, 50V, X7R, 10% | SMT
C305 | 1 | 100n / 10V | 100n / 10V | Murata | GRM21BR71H104KA01L | ITO_PCB:C_0805_2012Metric | 0805, 100nF, 50V, X7R, 10% | SMT
C306 | 1 | 10n / 10V | 10n / 10V | Murata | GRM21BR71H103KA01L | ITO_PCB:C_0805_2012Metric | 0805, 10nF, 50V, X7R, 10% | SMT
R301 | 1 | 88k7 1% | 88k7 1% | Yageo | RC0805FR-0788K7L | ITO_PCB:R_0805_2012Metric | 0805, 1%, >=0.125W, >=50V | SMT
L3 | 1 | 10uH IHLP6767GZEK100M11 | 10uH IHLP6767GZEK100M11 | Vishay | IHLP6767GZEK100M11 | ITO_PCB:L_Vishay_IHLP-6767 |  | SMT
C307 | 1 | 47u / 25V X7R C2220C476M3R2C7186 | 47u / 25V X7R C2220C476M3R2C7186 | KEMET | C2220C476M3R2C7186 | ITO_PCB:KEMET_KPS_2220_Double | KPS stacked 2220, 47uF, 25V, X7R, 20%; custom pads | SMT
C308 | 1 | 47u / 25V X7R C2220C476M3R2C7186 | 47u / 25V X7R C2220C476M3R2C7186 | KEMET | C2220C476M3R2C7186 | ITO_PCB:KEMET_KPS_2220_Double | KPS stacked 2220, 47uF, 25V, X7R, 20%; custom pads | SMT
RS3 | 1 | 25m / 1W / 1% WSL2512R0250FEA | 25m / 1W / 1% WSL2512R0250FEA | Vishay | WSL2512R0250FEA | ITO_PCB:WSL2512_7m_to_500m |  | SMT
R302 | 1 | 1M13 1% | 1M13 1% | Yageo | RC0805FR-071M13L | ITO_PCB:R_0805_2012Metric | 0805, 1%, >=0.125W, >=50V | SMT
R303 | 1 | 100k 1% | 100k 1% | Yageo | RC0805FR-07100KL | ITO_PCB:R_0805_2012Metric | 0805, 1%, >=0.125W, >=50V | SMT
C309 | 1 | 10p C0G | 10p C0G | KEMET | C0805C100J5GACTU | ITO_PCB:C_0805_2012Metric | 0805, 10pF, C0G, 50V, 5% | SMT
J13 | 1 | Connector 2 pins | Connector 2 pins | Phoenix Contact | 1715721 | ITO_PCB:TerminalBlock_Phoenix_MKDS-1,5-2-5.08_1x02_P5.08mm_Horizontal | MKDS 1,5/2-5,08; 2 positions, pitch 5.08mm | THT manual
TP13 | 1 | Connector 2 pins | Connector 2 pins | Samtec | TSW-102-07-G-S | ITO_PCB:PinHeader_1x02_P2.54mm_Vertical |  | THT manual
U14 | 1 | LT8613EUDE | LT8613EUDE | Analog Devices | LT8613EUDE#PBF | ITO_PCB:QFN-28-1EP_3x6mm_P0.5mm_EP1.7x4.75mm |  | SMT
F14 | 1 | 2.5A / 125V DC 045102.5MRL | 2.5A / 125V DC 045102.5MRL | Littelfuse | 045102.5MRL | ITO_PCB:Littelfuse_451 |  | SMT
C401 | 1 | 10u / 50V X7R | 10u / 50V X7R | Murata | GRM32ER71H106KA12L | ITO_PCB:C_1210_3225Metric | 1210, 10uF, 50V, X7R, 10%; no 0805 substitution | SMT
C402 | 1 | 10u / 50V X7R | 10u / 50V X7R | Murata | GRM32ER71H106KA12L | ITO_PCB:C_1210_3225Metric | 1210, 10uF, 50V, X7R, 10%; no 0805 substitution | SMT
C403 | 1 | 1u / 50V X7R | 1u / 50V X7R | Murata | GRM21BR71H105KA12L | ITO_PCB:C_0805_2012Metric | 0805, 1uF, 50V, X7R, 10% | SMT
C404 | 1 | 1u / 10V | 1u / 10V | Murata | GRM21BR71H105KA12L | ITO_PCB:C_0805_2012Metric | 0805, 1uF, 50V, X7R, 10% | SMT
C405 | 1 | 100n / 10V | 100n / 10V | Murata | GRM21BR71H104KA01L | ITO_PCB:C_0805_2012Metric | 0805, 100nF, 50V, X7R, 10% | SMT
C406 | 1 | 10n / 10V | 10n / 10V | Murata | GRM21BR71H103KA01L | ITO_PCB:C_0805_2012Metric | 0805, 10nF, 50V, X7R, 10% | SMT
R401 | 1 | 88k7 1% | 88k7 1% | Yageo | RC0805FR-0788K7L | ITO_PCB:R_0805_2012Metric | 0805, 1%, >=0.125W, >=50V | SMT
L4 | 1 | 10uH IHLP6767GZEK100M11 | 10uH IHLP6767GZEK100M11 | Vishay | IHLP6767GZEK100M11 | ITO_PCB:L_Vishay_IHLP-6767 |  | SMT
C407 | 1 | 47u / 25V X7R C2220C476M3R2C7186 | 47u / 25V X7R C2220C476M3R2C7186 | KEMET | C2220C476M3R2C7186 | ITO_PCB:KEMET_KPS_2220_Double | KPS stacked 2220, 47uF, 25V, X7R, 20%; custom pads | SMT
C408 | 1 | 47u / 25V X7R C2220C476M3R2C7186 | 47u / 25V X7R C2220C476M3R2C7186 | KEMET | C2220C476M3R2C7186 | ITO_PCB:KEMET_KPS_2220_Double | KPS stacked 2220, 47uF, 25V, X7R, 20%; custom pads | SMT
RS4 | 1 | 25m / 1W / 1% WSL2512R0250FEA | 25m / 1W / 1% WSL2512R0250FEA | Vishay | WSL2512R0250FEA | ITO_PCB:WSL2512_7m_to_500m |  | SMT
R402 | 1 | 1M13 1% | 1M13 1% | Yageo | RC0805FR-071M13L | ITO_PCB:R_0805_2012Metric | 0805, 1%, >=0.125W, >=50V | SMT
R403 | 1 | 100k 1% | 100k 1% | Yageo | RC0805FR-07100KL | ITO_PCB:R_0805_2012Metric | 0805, 1%, >=0.125W, >=50V | SMT
C409 | 1 | 10p C0G | 10p C0G | KEMET | C0805C100J5GACTU | ITO_PCB:C_0805_2012Metric | 0805, 10pF, C0G, 50V, 5% | SMT
J14 | 1 | Connector 2 pins | Connector 2 pins | Phoenix Contact | 1715721 | ITO_PCB:TerminalBlock_Phoenix_MKDS-1,5-2-5.08_1x02_P5.08mm_Horizontal | MKDS 1,5/2-5,08; 2 positions, pitch 5.08mm | THT manual
TP14 | 1 | Connector 2 pins | Connector 2 pins | Samtec | TSW-102-07-G-S | ITO_PCB:PinHeader_1x02_P2.54mm_Vertical |  | THT manual
U9 | 1 | ADS1115IDGS | ADS1115IDGS | Texas Instruments | ADS1115IDGSR | ITO_PCB:VSSOP-10_3x3mm_P0.5mm |  | SMT
C40 | 1 | 100n / 10V | 100n / 10V | Murata | GRM21BR71H104KA01L | ITO_PCB:C_0805_2012Metric | 0805, 100nF, 50V, X7R, 10% | SMT
R61 | 1 | 10k 0.1% | 10k 0.1% | Yageo | RT0805BRD0710KL | ITO_PCB:R_0805_2012Metric | 0805 thin film, 0.1%, 25ppm/K or better, >=0.125W | SMT
R65 | 1 | 1k | 1k | Yageo | RC0805FR-071KL | ITO_PCB:R_0805_2012Metric | 0805, 1%, >=0.125W, >=50V | SMT
C41 | 1 | 100n / 10V | 100n / 10V | Murata | GRM21BR71H104KA01L | ITO_PCB:C_0805_2012Metric | 0805, 100nF, 50V, X7R, 10% | SMT
J21 | 1 | Connector 2 pins | Connector 2 pins | JST | B2B-XH-A(LF)(SN) | ITO_PCB:JST_XH_B2B-XH-A_1x02_P2.50mm_Vertical |  | THT manual
R62 | 1 | 10k 0.1% | 10k 0.1% | Yageo | RT0805BRD0710KL | ITO_PCB:R_0805_2012Metric | 0805 thin film, 0.1%, 25ppm/K or better, >=0.125W | SMT
R66 | 1 | 1k | 1k | Yageo | RC0805FR-071KL | ITO_PCB:R_0805_2012Metric | 0805, 1%, >=0.125W, >=50V | SMT
C42 | 1 | 100n / 10V | 100n / 10V | Murata | GRM21BR71H104KA01L | ITO_PCB:C_0805_2012Metric | 0805, 100nF, 50V, X7R, 10% | SMT
J22 | 1 | Connector 2 pins | Connector 2 pins | JST | B2B-XH-A(LF)(SN) | ITO_PCB:JST_XH_B2B-XH-A_1x02_P2.50mm_Vertical |  | THT manual
R63 | 1 | 10k 0.1% | 10k 0.1% | Yageo | RT0805BRD0710KL | ITO_PCB:R_0805_2012Metric | 0805 thin film, 0.1%, 25ppm/K or better, >=0.125W | SMT
R67 | 1 | 1k | 1k | Yageo | RC0805FR-071KL | ITO_PCB:R_0805_2012Metric | 0805, 1%, >=0.125W, >=50V | SMT
C43 | 1 | 100n / 10V | 100n / 10V | Murata | GRM21BR71H104KA01L | ITO_PCB:C_0805_2012Metric | 0805, 100nF, 50V, X7R, 10% | SMT
J23 | 1 | Connector 2 pins | Connector 2 pins | JST | B2B-XH-A(LF)(SN) | ITO_PCB:JST_XH_B2B-XH-A_1x02_P2.50mm_Vertical |  | THT manual
R64 | 1 | 10k 0.1% | 10k 0.1% | Yageo | RT0805BRD0710KL | ITO_PCB:R_0805_2012Metric | 0805 thin film, 0.1%, 25ppm/K or better, >=0.125W | SMT
R68 | 1 | 1k | 1k | Yageo | RC0805FR-071KL | ITO_PCB:R_0805_2012Metric | 0805, 1%, >=0.125W, >=50V | SMT
C44 | 1 | 100n / 10V | 100n / 10V | Murata | GRM21BR71H104KA01L | ITO_PCB:C_0805_2012Metric | 0805, 100nF, 50V, X7R, 10% | SMT
J24 | 1 | Connector 2 pins | Connector 2 pins | JST | B2B-XH-A(LF)(SN) | ITO_PCB:JST_XH_B2B-XH-A_1x02_P2.50mm_Vertical |  | THT manual
R70 | 1 | 10k 0.1% | 10k 0.1% | Yageo | RT0805BRD0710KL | ITO_PCB:R_0805_2012Metric | 0805 thin film, 0.1%, 25ppm/K or better, >=0.125W | SMT
R71 | 1 | 1k | 1k | Yageo | RC0805FR-071KL | ITO_PCB:R_0805_2012Metric | 0805, 1%, >=0.125W, >=50V | SMT
C50 | 1 | 100n / 10V | 100n / 10V | Murata | GRM21BR71H104KA01L | ITO_PCB:C_0805_2012Metric | 0805, 100nF, 50V, X7R, 10% | SMT
J25 | 1 | Connector 2 pins | Connector 2 pins | JST | B2B-XH-A(LF)(SN) | ITO_PCB:JST_XH_B2B-XH-A_1x02_P2.50mm_Vertical |  | THT manual
J26 | 1 | Connector 4 pins | Connector 4 pins | JST | B4B-XH-A(LF)(SN) | ITO_PCB:JST_XH_B4B-XH-A_1x04_P2.50mm_Vertical |  | THT manual
F3 | 1 | 1A / 125V DC 0451001.MRL | 1A / 125V DC 0451001.MRL | Littelfuse | 0451001.MRL | ITO_PCB:Littelfuse_451 |  | SMT
J27 | 1 | Connector 4 pins | Connector 4 pins | JST | B4B-XH-A(LF)(SN) | ITO_PCB:JST_XH_B4B-XH-A_1x04_P2.50mm_Vertical |  | THT manual
Q6 | 1 | MMBT3904 | MMBT3904 | onsemi | MMBT3904LT1G | ITO_PCB:SOT-23 |  | SMT
R72 | 1 | 4k7 | 4k7 | Yageo | RC0805FR-074K7L | ITO_PCB:R_0805_2012Metric | 0805, 1%, >=0.125W, >=50V | SMT
R73 | 1 | 100k | 100k | Yageo | RC0805FR-07100KL | ITO_PCB:R_0805_2012Metric | 0805, 1%, >=0.125W, >=50V | SMT
R74 | 1 | 10k | 10k | Yageo | RC0805FR-0710KL | ITO_PCB:R_0805_2012Metric | 0805, 1%, >=0.125W, >=50V | SMT
J9 | 1 | EFUSE RESET NO | EFUSE RESET NO | JST | B2B-XH-A(LF)(SN) | ITO_PCB:JST_XH_B2B-XH-A_1x02_P2.50mm_Vertical |  | THT manual
U15 | 1 | SN74AHC1G08DBVR | SN74AHC1G08DBVR | Texas Instruments | SN74AHC1G08DBVR | ITO_PCB:SOT-23-5 |  | SMT
C7 | 1 | 100n / 10V | 100n / 10V | Murata | GRM21BR71H104KA01L | ITO_PCB:C_0805_2012Metric | 0805, 100nF, 50V, X7R, 10% | SMT
R19 | 1 | 100k | 100k | Yageo | RC0805FR-07100KL | ITO_PCB:R_0805_2012Metric | 0805, 1%, >=0.125W, >=50V | SMT
J28 | 1 | AMBIENT 1 - LOCAL ADAPTER | AMBIENT 1 - LOCAL ADAPTER | JST | B5B-XH-A(LF)(SN) | ITO_PCB:JST_XH_B5B-XH-A_1x05_P2.50mm_Vertical | Short <=10cm lead to local PCA9615 adapter; differential cable only beyond adapter. Pin1=3V3 reference, pin5=fused5V. See REMOTE-SENSORS.md. | THT manual
F4 | 1 | 250mA / 125V 0451.250MRL | 250mA / 125V 0451.250MRL | Littelfuse | 0451.250MRL | ITO_PCB:Littelfuse_451 | Remote adapter/cable 5V branch fuse; normal branch budget <=150mA. | SMT
C51 | 1 | 1u / 50V X7R | 1u / 50V X7R | Murata | GRM21BR71H105KA12L | ITO_PCB:C_0805_2012Metric | Connector branch decoupling. | SMT
J29 | 1 | AMBIENT 2 - LOCAL ADAPTER | AMBIENT 2 - LOCAL ADAPTER | JST | B5B-XH-A(LF)(SN) | ITO_PCB:JST_XH_B5B-XH-A_1x05_P2.50mm_Vertical | Short <=10cm lead to local PCA9615 adapter; differential cable only beyond adapter. Pin1=3V3 reference, pin5=fused5V. See REMOTE-SENSORS.md. | THT manual
F5 | 1 | 250mA / 125V 0451.250MRL | 250mA / 125V 0451.250MRL | Littelfuse | 0451.250MRL | ITO_PCB:Littelfuse_451 | Remote adapter/cable 5V branch fuse; normal branch budget <=150mA. | SMT
C52 | 1 | 1u / 50V X7R | 1u / 50V X7R | Murata | GRM21BR71H105KA12L | ITO_PCB:C_0805_2012Metric | Connector branch decoupling. | SMT
J30 | 1 | R7B 24V IN - KPJX-4S | R7B 24V IN - KPJX-4S | Kycon | KPJX-4S | ITO_PCB:Kycon_KPJX-4S | 7.5A per contact at48VDC; use both contacts per polarity; 4P snap-lock PCB socket; Direct GST160A24-R7B input. Pins1/4=+24_IN, pins2/3=GND. J3 alternative input only; never connect two supplies. Prototype remains <=4A total. | THT manual
