luciddreams/ito-controller/procurement/ITO-Controller-Order-Tracker.xlsx

ITO controller — purchasing BOM
202 PCB positions · 58 PCB part types · 6 remote sensor items · 4 system items
Build quantity | 1 |  | Priced order total (EUR) | €0.00 |  | Order lines missing price | 0
Amber cells are editable. Ordered / Delivered: choose Yes or No. Prices: EUR excluding VAT and shipping.
Delivered means the whole order arrived. Also enter Received qty; partial deliveries remain visible.
Stock is the quantity already on hand before these orders. Each row assumes one supplier and unit price.
Source: github.com/luciddreams/ito-controller, commit 02f71dd. Browser and Excel progress are independent.
Scope excludes unresolved thermal/mechanical parts and remaining wiring; see procurement/README.md.
Part / MPN | Category | Per build | Required | Stock | Still needed | Ordered | Order qty | Supplier | Supplier SKU | Unit price EUR | Line total EUR | Received qty | Delivered | Status | Order reference | Expected date | Product URL | References / purpose | Specification / notes | Manufacturer
LT8613EUDE#PBF | PCB | 4 | 4 | 0 | 4 | No | 0 |  |  |  |  | 0 | No | To order |  |  |  | U11, U12, U13, U14 | LT8613EUDE | Analog Devices
IRLB4030PBF | PCB | 1 | 1 | 0 | 1 | No | 0 |  |  |  |  | 0 | No | To order |  |  |  | Q2 | IRLB4030PBF | Infineon
B2B-XH-A(LF)(SN) | PCB | 10 | 10 | 0 | 10 | No | 0 |  |  |  |  | 0 | No | To order |  |  |  | J5, J6, J7, J8, J21, J22, J23, J24, J25, J9 | Connector 2 pins / EFUSE RESET NO | JST
B4B-XH-A(LF)(SN) | PCB | 2 | 2 | 0 | 2 | No | 0 |  |  |  |  | 0 | No | To order |  |  |  | J26, J27 | Connector 4 pins | JST
B5B-XH-A(LF)(SN) | PCB | 2 | 2 | 0 | 2 | No | 0 |  |  |  |  | 0 | No | To order |  |  |  | J28, J29 | Short <=10cm lead to local PCA9615 adapter; differential cable only beyond adapter. Pin1=3V3 reference, pin5=fused5V. See REMOTE-SENSORS.md. | JST
C0805C100J5GACTU | PCB | 4 | 4 | 0 | 4 | No | 0 |  |  |  |  | 0 | No | To order |  |  |  | C109, C209, C309, C409 | 0805, 10pF, C0G, 50V, 5% | KEMET
C2220C476M3R2C7186 | PCB | 8 | 8 | 0 | 8 | No | 0 |  |  |  |  | 0 | No | To order |  |  |  | C107, C108, C207, C208, C307, C308, C407, C408 | KPS stacked 2220, 47uF, 25V, X7R, 20%; custom pads | KEMET
KPJX-4S | PCB | 1 | 1 | 0 | 1 | No | 0 |  |  |  |  | 0 | No | To order |  |  |  | J30 | 7.5A per contact at48VDC; use both contacts per polarity; 4P snap-lock PCB socket; Direct GST160A24-R7B input. Pins1/4=+24_IN, pins2/3=GND. J3 alternative input only; never connect two supplies. Prototype remains <=4A total. | Kycon
0451.250MRL | PCB | 2 | 2 | 0 | 2 | No | 0 |  |  |  |  | 0 | No | To order |  |  |  | F4, F5 | Remote adapter/cable 5V branch fuse; normal branch budget <=150mA. | Littelfuse
0451001.MRL | PCB | 1 | 1 | 0 | 1 | No | 0 |  |  |  |  | 0 | No | To order |  |  |  | F3 | 1A / 125V DC 0451001.MRL | Littelfuse
0451005.MRL | PCB | 1 | 1 | 0 | 1 | No | 0 |  |  |  |  | 0 | No | To order |  |  |  | F2 | 5A / 125V DC 0451005.MRL | Littelfuse
0451010.MRL | PCB | 1 | 1 | 0 | 1 | No | 0 |  |  |  |  | 0 | No | To order |  |  |  | F1 | 10A / 125V DC 0451010.MRL | Littelfuse
045102.5MRL | PCB | 4 | 4 | 0 | 4 | No | 0 |  |  |  |  | 0 | No | To order |  |  |  | F11, F12, F13, F14 | 2.5A / 125V DC 045102.5MRL | Littelfuse
SMBJ33CA | PCB | 1 | 1 | 0 | 1 | No | 0 |  |  |  |  | 0 | No | To order |  |  |  | D1 | SMBJ33CA bidirectioneel | Littelfuse
MCP4728-E/UN | PCB | 1 | 1 | 0 | 1 | No | 0 |  |  |  |  | 0 | No | To order |  |  |  | U4 | MCP4728-E-UN | Microchip
GRM21BR61E106KA73L | PCB | 2 | 2 | 0 | 2 | No | 0 |  |  |  |  | 0 | No | To order |  |  |  | C1, C2 | 0805, 10uF, 25V, X5R, 10%; used on <=5V rails | Murata
GRM21BR71H103KA01L | PCB | 4 | 4 | 0 | 4 | No | 0 |  |  |  |  | 0 | No | To order |  |  |  | C106, C206, C306, C406 | 0805, 10nF, 50V, X7R, 10% | Murata
GRM21BR71H104KA01L | PCB | 24 | 24 | 0 | 24 | No | 0 |  |  |  |  | 0 | No | To order |  |  |  | C3, C4, C10, C12, C20, C21, C22, C23, C24, C26, C28, C30, C31, C105, C205, C305, C405, C40, C41, C42, C43, C44, C50, C7 | 0805, 100nF, 50V, X7R, 10% / dVdt timing; calculate with effective C = 70..127nF, including temperature/aging allowance | Murata
GRM21BR71H105KA12L | PCB | 12 | 12 | 0 | 12 | No | 0 |  |  |  |  | 0 | No | To order |  |  |  | C6, C11, C103, C104, C203, C204, C303, C304, C403, C404, C51, C52 | 0805, 1uF, 50V, X7R, 10% / Connector branch decoupling. | Murata
GRM32ER71H106KA12L | PCB | 8 | 8 | 0 | 8 | No | 0 |  |  |  |  | 0 | No | To order |  |  |  | C101, C102, C201, C202, C301, C302, C401, C402 | 1210, 10uF, 50V, X7R, 10%; no 0805 substitution | Murata
G2RL-1A-E DC24 | PCB | 1 | 1 | 0 | 1 | No | 0 |  |  |  |  | 0 | No | To order |  |  |  | K1 | G2RL-1A-E DC24 | Omron
BSS138LT1G | PCB | 1 | 1 | 0 | 1 | No | 0 |  |  |  |  | 0 | No | To order |  |  |  | Q3 | BSS138LT1G | onsemi
MMBT3904LT1G | PCB | 3 | 3 | 0 | 3 | No | 0 |  |  |  |  | 0 | No | To order |  |  |  | Q4, Q5, Q6 | MMBT3904 | onsemi
EEUFR1H471 | PCB | 1 | 1 | 0 | 1 | No | 0 |  |  |  |  | 0 | No | To order |  |  |  | C5 | 470uF 50V radial; 12.5mm diameter, 5mm pitch; reserve22mm height | Panasonic
ERJP06F1002V | PCB | 1 | 1 | 0 | 1 | No | 0 |  |  |  |  | 0 | No | To order |  |  |  | R25 | 0805 10k 1%, 0.5W; output bleeder. | Panasonic
1715721 | PCB | 6 | 6 | 0 | 6 | No | 0 |  |  |  |  | 0 | No | To order |  |  |  | J3, J4, J11, J12, J13, J14 | MKDS 1,5/2-5,08; 2 positions, pitch 5.08mm | Phoenix Contact
SSW-107-01-G-S | PCB | 2 | 2 | 0 | 2 | No | 0 |  |  |  |  | 0 | No | To order |  |  |  | J1, J2 | XIAO right socket 1x7 - USB down / XIAO left socket 1x7 - USB down | Samtec
TSW-102-07-G-S | PCB | 5 | 5 | 0 | 5 | No | 0 |  |  |  |  | 0 | No | To order |  |  |  | JP1, TP11, TP12, TP13, TP14 | Power jumper - default OPEN / Connector 2 pins | Samtec
TSW-103-07-G-S | PCB | 1 | 1 | 0 | 1 | No | 0 |  |  |  |  | 0 | No | To order |  |  |  | TP1 | Connector 3 pins | Samtec
STP55NF06L | PCB | 1 | 1 | 0 | 1 | No | 0 |  |  |  |  | 0 | No | To order |  |  |  | Q1 | STP55NF06L | STMicroelectronics
ADS1115IDGSR | PCB | 1 | 1 | 0 | 1 | No | 0 |  |  |  |  | 0 | No | To order |  |  |  | U9 | ADS1115IDGS | Texas Instruments
INA226AIDGSR | PCB | 1 | 1 | 0 | 1 | No | 0 |  |  |  |  | 0 | No | To order |  |  |  | U3 | INA226AIDGS | Texas Instruments
OPA2333AIDR | PCB | 2 | 2 | 0 | 2 | No | 0 |  |  |  |  | 0 | No | To order |  |  |  | U5, U6 | OPA2333AID | Texas Instruments
SN74AHC1G08DBVR | PCB | 1 | 1 | 0 | 1 | No | 0 |  |  |  |  | 0 | No | To order |  |  |  | U15 | SN74AHC1G08DBVR | Texas Instruments
SN74LVC08APWR | PCB | 1 | 1 | 0 | 1 | No | 0 |  |  |  |  | 0 | No | To order |  |  |  | U8 | SN74LVC08APWR | Texas Instruments
TCA9534PWR | PCB | 1 | 1 | 0 | 1 | No | 0 |  |  |  |  | 0 | No | To order |  |  |  | U7 | TCA9534PWR | Texas Instruments
TPS26630RGER | PCB | 1 | 1 | 0 | 1 | No | 0 |  |  |  |  | 0 | No | To order |  |  |  | U1 | TPS26630RGER | Texas Instruments
UCC27511DBVR | PCB | 1 | 1 | 0 | 1 | No | 0 |  |  |  |  | 0 | No | To order |  |  |  | U2 | UCC27511DBV | Texas Instruments
TSR 1-2450 | PCB | 1 | 1 | 0 | 1 | No | 0 |  |  |  |  | 0 | No | To order |  |  |  | M1 | TSR 1-2450 | TRACO Power
1N4007-E3/54 | PCB | 1 | 1 | 0 | 1 | No | 0 |  |  |  |  | 0 | No | To order |  |  |  | D2 | 1N4007 | Vishay
IHLP6767GZEK100M11 | PCB | 4 | 4 | 0 | 4 | No | 0 |  |  |  |  | 0 | No | To order |  |  |  | L1, L2, L3, L4 | 10uH IHLP6767GZEK100M11 | Vishay
WSL2512R0100FEA | PCB | 1 | 1 | 0 | 1 | No | 0 |  |  |  |  | 0 | No | To order |  |  |  | RSH1 | 10m / 1W / 1% WSL2512R0100FEA | Vishay
WSL2512R0250FEA | PCB | 4 | 4 | 0 | 4 | No | 0 |  |  |  |  | 0 | No | To order |  |  |  | RS1, RS2, RS3, RS4 | 25m / 1W / 1% WSL2512R0250FEA | Vishay
RC0805FR-07100KL | PCB | 19 | 19 | 0 | 19 | No | 0 |  |  |  |  | 0 | No | To order |  |  |  | R21, R22, R23, R32, R33, R51, R55, R52, R56, R53, R57, R54, R58, R103, R203, R303, R403, R73, R19 | 0805, 1%, >=0.125W, >=50V | Yageo
RC0805FR-0710KL | PCB | 4 | 4 | 0 | 4 | No | 0 |  |  |  |  | 0 | No | To order |  |  |  | R3, R15, R24, R74 | 0805, 1%, >=0.125W, >=50V | Yageo
RC0805FR-0710RL | PCB | 1 | 1 | 0 | 1 | No | 0 |  |  |  |  | 0 | No | To order |  |  |  | R31 | 0805, 1%, >=0.125W, >=50V | Yageo
RC0805FR-071KL | PCB | 7 | 7 | 0 | 7 | No | 0 |  |  |  |  | 0 | No | To order |  |  |  | R6, R18, R65, R66, R67, R68, R71 | 0805, 1%, >=0.125W, >=50V | Yageo
RC0805FR-071M13L | PCB | 4 | 4 | 0 | 4 | No | 0 |  |  |  |  | 0 | No | To order |  |  |  | R102, R202, R302, R402 | 0805, 1%, >=0.125W, >=50V | Yageo
RC0805FR-0722RL | PCB | 1 | 1 | 0 | 1 | No | 0 |  |  |  |  | 0 | No | To order |  |  |  | R30 | 0805, 1%, >=0.125W, >=50V | Yageo
RC0805FR-072K2L | PCB | 3 | 3 | 0 | 3 | No | 0 |  |  |  |  | 0 | No | To order |  |  |  | R1, R2, R20 | 0805, 1%, >=0.125W, >=50V | Yageo
RC0805FR-074K7L | PCB | 2 | 2 | 0 | 2 | No | 0 |  |  |  |  | 0 | No | To order |  |  |  | R7, R72 | 0805, 1%, >=0.125W, >=50V | Yageo
RC0805FR-0788K7L | PCB | 4 | 4 | 0 | 4 | No | 0 |  |  |  |  | 0 | No | To order |  |  |  | R101, R201, R301, R401 | 0805, 1%, >=0.125W, >=50V | Yageo
RC0805JR-070RL | PCB | 1 | 1 | 0 | 1 | No | 0 |  |  |  |  | 0 | No | To order |  |  |  | R4 | 0805 zero-ohm link; signal only | Yageo
RT0805BRD0710KL | PCB | 17 | 17 | 0 | 17 | No | 0 |  |  |  |  | 0 | No | To order |  |  |  | R5, R11, R13, R17, R42, R43, R44, R45, R46, R47, R48, R49, R61, R62, R63, R64, R70 | 0805 thin film, 0.1%, 25ppm/K or better, >=0.125W | Yageo
RT0805BRD07150KL | PCB | 1 | 1 | 0 | 1 | No | 0 |  |  |  |  | 0 | No | To order |  |  |  | R16 | 0805 thin film, 0.1%, 25ppm/K or better, >=0.125W | Yageo
RT0805BRD07156KL | PCB | 1 | 1 | 0 | 1 | No | 0 |  |  |  |  | 0 | No | To order |  |  |  | R10 | 0805 thin film, 0.1%, 25ppm/K or better, >=0.125W | Yageo
RT0805BRD07223KL | PCB | 1 | 1 | 0 | 1 | No | 0 |  |  |  |  | 0 | No | To order |  |  |  | R12 | 0805 thin film, 0.1%, 25ppm/K or better, >=0.125W | Yageo
RT0805BRD074K02L | PCB | 1 | 1 | 0 | 1 | No | 0 |  |  |  |  | 0 | No | To order |  |  |  | R14 | 0805 thin film, 0.1%, 25ppm/K or better, >=0.125W | Yageo
COM-16988 QwiicBus EndPoint | Remote sensors | 4 | 4 | 0 | 4 | No | 0 |  |  |  |  | 0 | No | To order |  |  |  | 2 local + 2 remote PCA9615 adapters | Set jumpers exactly as REMOTE-SENSORS.md | SparkFun
2857 SHT31-D breakout | Remote sensors | 2 | 2 | 0 | 2 | No | 0 |  |  |  |  | 0 | No | To order |  |  |  | Remote T/RH sensing | Vin5V; addresses0x44/0x45 | Adafruit
XHP-5 | Remote sensors | 2 | 2 | 0 | 2 | No | 0 |  |  |  |  | 0 | No | To order |  |  |  | Cable housing at J28/J29 | 2.5mm XH | JST
SXH-001T-P0.6 | Remote sensors | 10 | 10 | 0 | 10 | No | 0 |  |  |  |  | 0 | No | To order |  |  |  | Crimp contacts | Use wire within contact specification | JST
CAT5e/CAT6 straight RJ45 patch cable | Remote sensors | 2 | 2 | 0 | 2 | No | 0 |  |  |  |  | 0 | No | To order |  |  |  | Differential link | Start1m; qualify chosen maximum up to3m | Generic
Ventilated sensor cap | Remote sensors | 2 | 2 | 0 | 2 | No | 0 |  |  |  |  | 0 | No | To order |  |  |  | Ambient exposure | Separate from warm adapter; no coating on sensing aperture | Generic
XIAO BLE nRF52840 | System | 1 | 1 | 0 | 1 | No | 0 |  |  |  |  | 0 | No | To order |  |  |  |  | Module on J1/J2; user already owns a module, enter available stock. | Seeed Studio
GST160A24-R7B | System | 1 | 1 | 0 | 1 | No | 0 |  |  |  |  | 0 | No | To order |  |  |  |  | 24 V supply; direct connection to J30. No P1J adapter required. | Mean Well
TEC1-12706 | System | 4 | 4 | 0 | 4 | No | 0 |  |  |  |  | 0 | No | To order |  |  |  |  | Exact supplier to select; follow prototype operating limits. | Supplier to select
ITO controller revision L bare PCB | System | 1 | 1 | 0 | 1 | No | 0 |  |  |  |  | 0 | No | To order |  |  |  |  | Fabricate to FABRICATION.md; do not order from this checklist alone. | PCB manufacturer to select
