luciddreams/ito-controller/3dmodels/component-coverage.csv

reference | model | status
C1 | C_0805_2012Metric | included
C10 | C_0805_2012Metric | included
C101 | C_1210_3225Metric | included
C102 | C_1210_3225Metric | included
C103 | C_0805_2012Metric | included
C104 | C_0805_2012Metric | included
C105 | C_0805_2012Metric | included
C106 | C_0805_2012Metric | included
C107 | KEMET_KPS_2220_Double | included
C108 | KEMET_KPS_2220_Double | included
C109 | C_0805_2012Metric | included
C11 | C_0805_2012Metric | included
C12 | C_0805_2012Metric | included
C2 | C_0805_2012Metric | included
C20 | C_0805_2012Metric | included
C201 | C_1210_3225Metric | included
C202 | C_1210_3225Metric | included
C203 | C_0805_2012Metric | included
C204 | C_0805_2012Metric | included
C205 | C_0805_2012Metric | included
C206 | C_0805_2012Metric | included
C207 | KEMET_KPS_2220_Double | included
C208 | KEMET_KPS_2220_Double | included
C209 | C_0805_2012Metric | included
C21 | C_0805_2012Metric | included
C22 | C_0805_2012Metric | included
C23 | C_0805_2012Metric | included
C24 | C_0805_2012Metric | included
C26 | C_0805_2012Metric | included
C28 | C_0805_2012Metric | included
C3 | C_0805_2012Metric | included
C30 | C_0805_2012Metric | included
C301 | C_1210_3225Metric | included
C302 | C_1210_3225Metric | included
C303 | C_0805_2012Metric | included
C304 | C_0805_2012Metric | included
C305 | C_0805_2012Metric | included
C306 | C_0805_2012Metric | included
C307 | KEMET_KPS_2220_Double | included
C308 | KEMET_KPS_2220_Double | included
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
U3 | VSSOP-10_3x3mm_P0.5mm | included
U4 | MSOP-10_3x3mm_P0.5mm | included
U5 | SOIC-8_3.9x4.9mm_P1.27mm | included
U6 | SOIC-8_3.9x4.9mm_P1.27mm | included
U7 | TSSOP-16_4.4x5mm_P0.65mm | included
U8 | TSSOP-14_4.4x5mm_P0.65mm | included
U9 | VSSOP-10_3x3mm_P0.5mm | included
