luciddreams/ito-controller/3d-review/ito-controller-rev-l.step

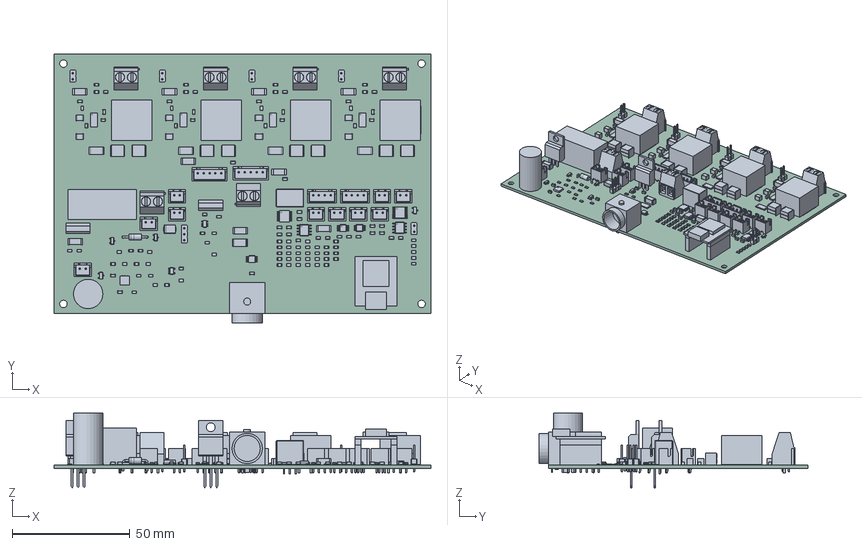
[picture p5: CAD file, 2026-09-26]
3d-review/ito-controller-rev-l.step
160.0 x 114.0 x 31.8 mm
C_0805_2012Metric x 46
R_0805_2012Metric x 68
SOIC-8_3.9x4.9mm_P1.27mm x 2
PinHeader_1x03_P2.54mm_Vertical
D_SMB
TSSOP-16_4.4x5mm_P0.65mm
JST_XH_B5B-XH-A_1x05_P2.50mm_Vertical x 2
JST_XH_B2B-XH-A_1x02_P2.50mm_Vertical x 10
PinHeader_1x02_P2.54mm_Vertical x 5
Converter_DCDC_TRACO_TSR-1_THT
TI_RGE0024H_4x4_EP2.7
QFN-28-1EP_3x6mm_P0.5mm_EP1.7x4.75mm x 4
TerminalBlock_Phoenix_MKDS-1,5-2-5.08_1x02_P5.08mm_Horizontal x 6
D_DO-41_SOD81_P10.16mm_Horizontal
WSL2512_7m_to_500m x 5
SOT-23-6
C_1210_3225Metric x 8
insulator
pin1
pin2
pin3
pin4
TO-220-3_Vertical x 2
JST_XH_B4B-XH-A_1x04_P2.50mm_Vertical x 2
SOT-23 x 4
SOT-23-5
MSOP-10_3x3mm_P0.5mm
VSSOP-10_3x3mm_P0.5mm x 2
TSSOP-14_4.4x5mm_P0.65mm
ito-controller_PCB
