luciddreams/ito-controller/3dmodels/PinHeader_1x03_P2.54mm_Vertical.step

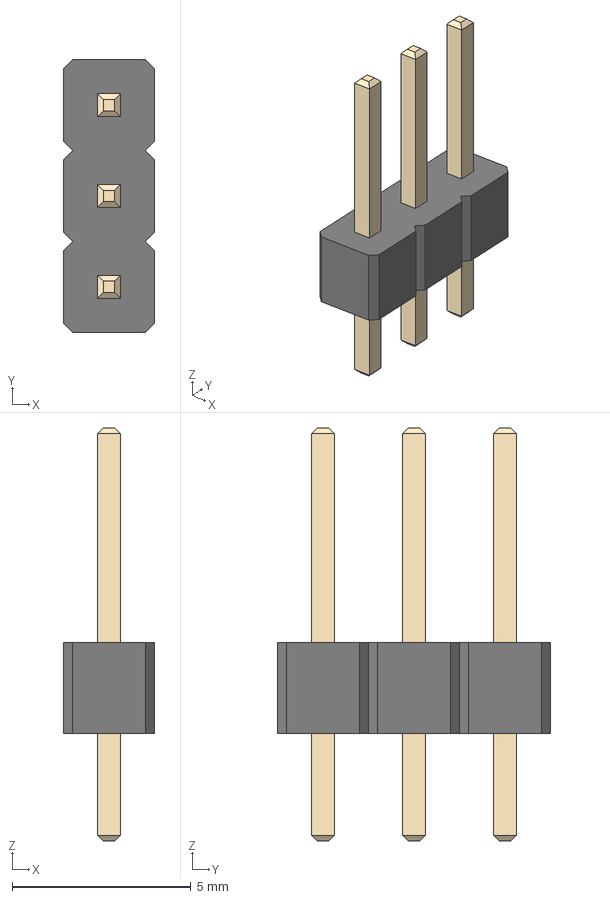
[picture p6: CAD file, 2026-09-26]
3dmodels/PinHeader_1x03_P2.54mm_Vertical.step
2.54 x 7.62 x 11.5 mm
