luciddreams/ito-controller/3dmodels/L_Vishay_IHLP-6767.step

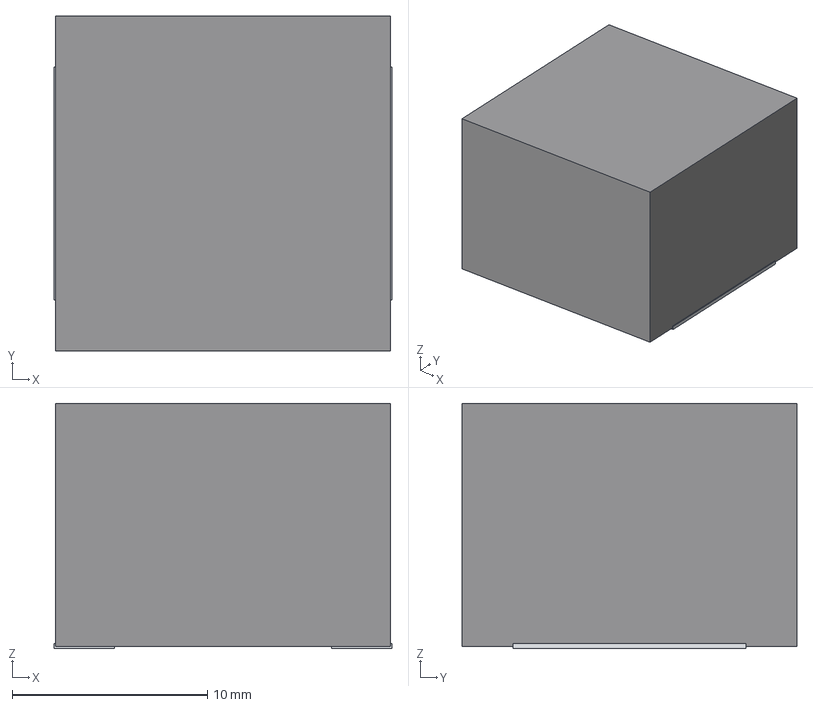
[picture p7: CAD file, 2026-09-26]
3dmodels/L_Vishay_IHLP-6767.step
17.3 x 17.1 x 12.6 mm
