luciddreams/ito-controller/3dmodels/JST_XH_B4B-XH-A_1x04_P2.50mm_Vertical.step

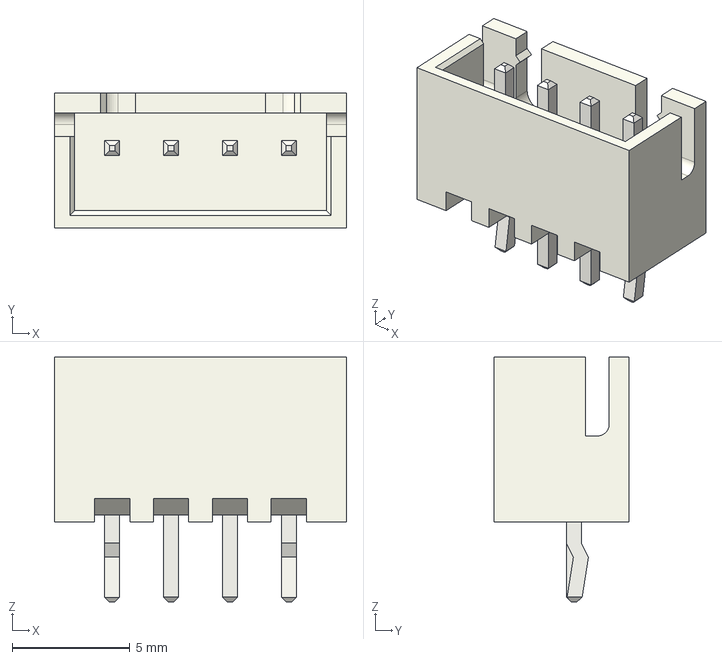
[picture p8: CAD file, 2026-09-26]
3dmodels/JST_XH_B4B-XH-A_1x04_P2.50mm_Vertical.step
12.4 x 5.75 x 10.4 mm
