luciddreams/ito-controller/3dmodels/PinSocket_1x07_P2.54mm_Vertical.step

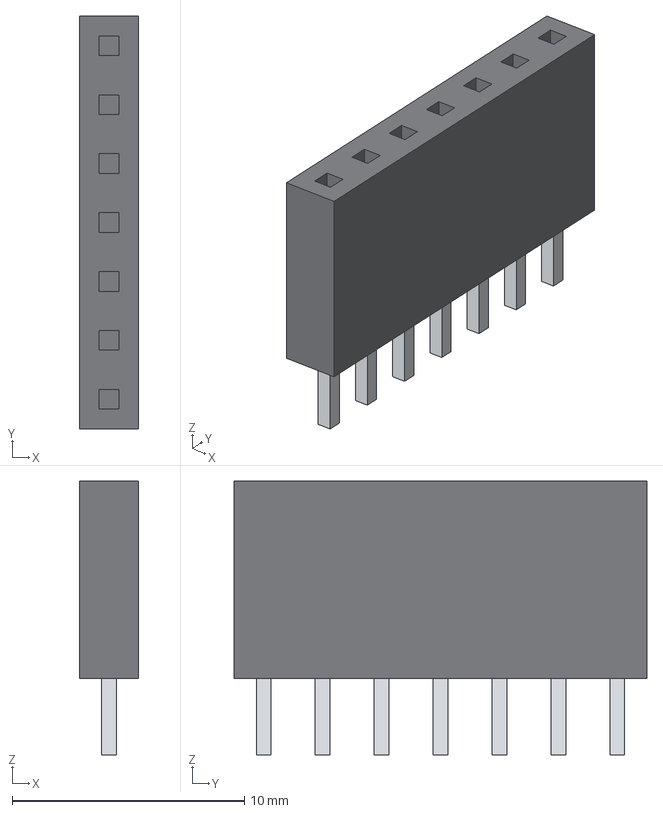
[picture p9: CAD file, 2026-09-26]
3dmodels/PinSocket_1x07_P2.54mm_Vertical.step
2.54 x 17.8 x 11.8 mm
