luciddreams/ito-controller/3dmodels/Littelfuse_451.step

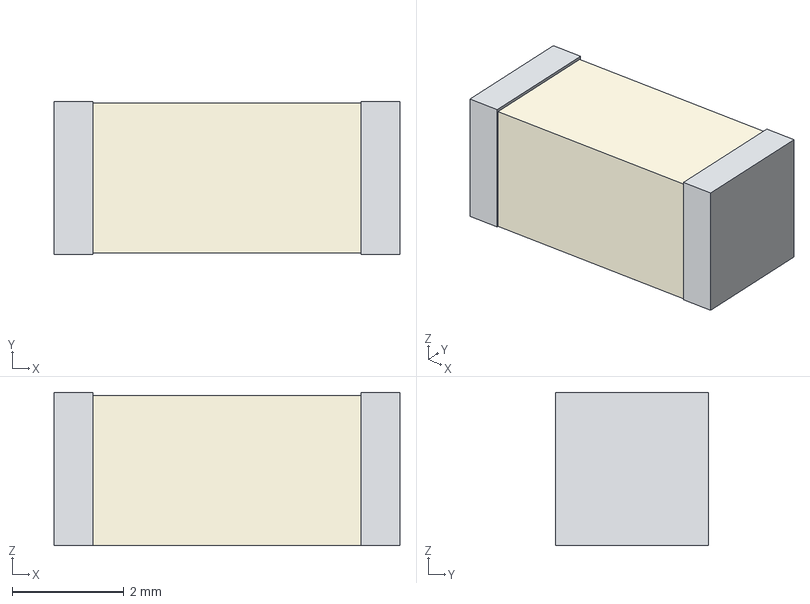
[picture p10: CAD file, 2026-09-26]
3dmodels/Littelfuse_451.step
6.20 x 2.75 x 2.75 mm
