luciddreams/ito-controller/3dmodels/Kycon_KPJX-4S_review.step

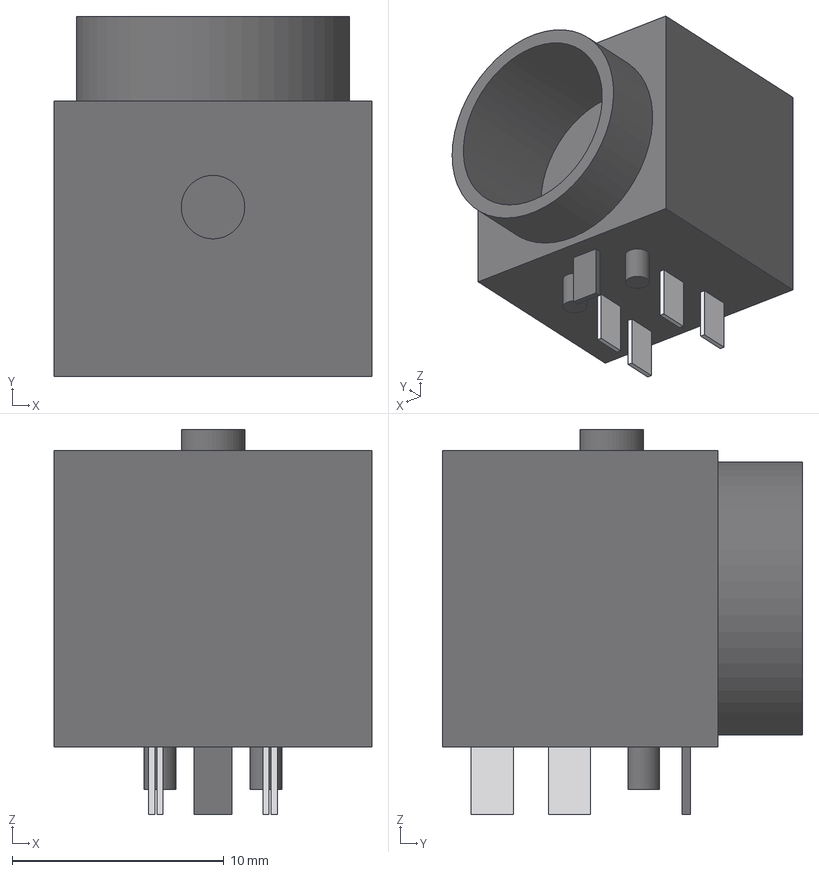
[picture p12: CAD file, 2026-09-26]
3dmodels/Kycon_KPJX-4S_review.step
15.0 x 17.0 x 18.2 mm
insulator
pin1
pin2
pin3
pin4
