luciddreams/ito-controller/3dmodels/TI_RGE0024H_4x4_EP2.7.step

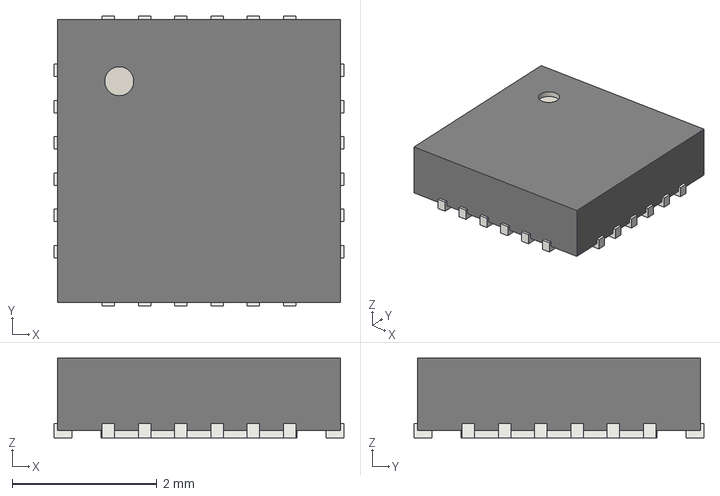
[picture p13: CAD file, 2026-09-26]
3dmodels/TI_RGE0024H_4x4_EP2.7.step
4.00 x 4.00 x 1.10 mm
