luciddreams/ito-controller/3dmodels/R_0805_2012Metric.step

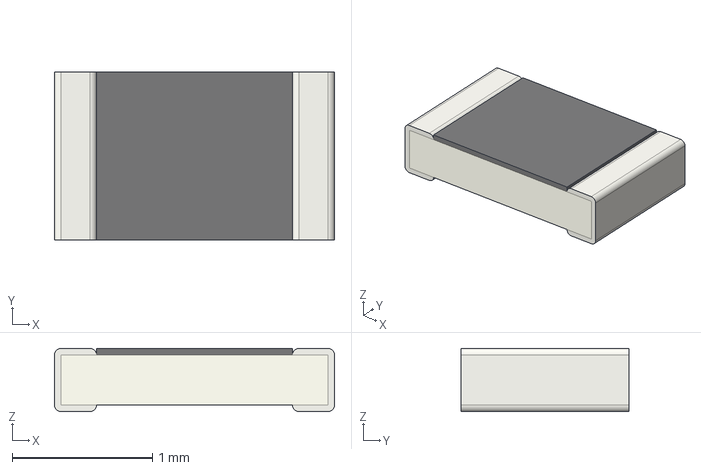
[picture p14: CAD file, 2026-09-26]
3dmodels/R_0805_2012Metric.step
2.00 x 1.20 x 0.45 mm
