luciddreams/ito-controller/3dmodels/D_SMB.step

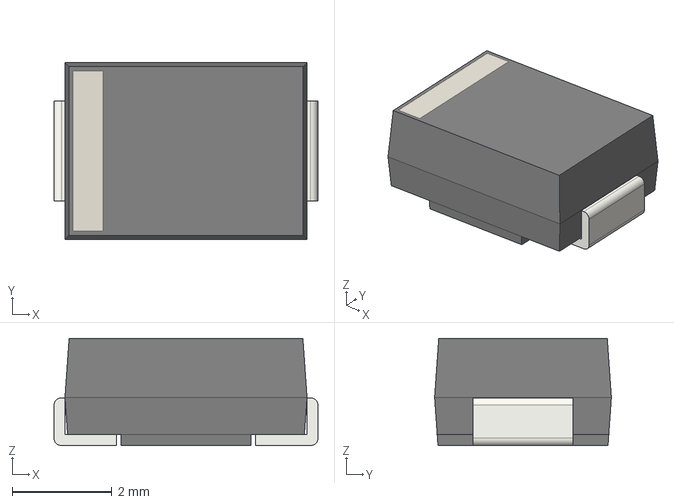
[picture p15: CAD file, 2026-09-26]
3dmodels/D_SMB.step
5.30 x 3.55 x 2.15 mm
