luciddreams/ito-controller/3dmodels/TSOT-23-8.step

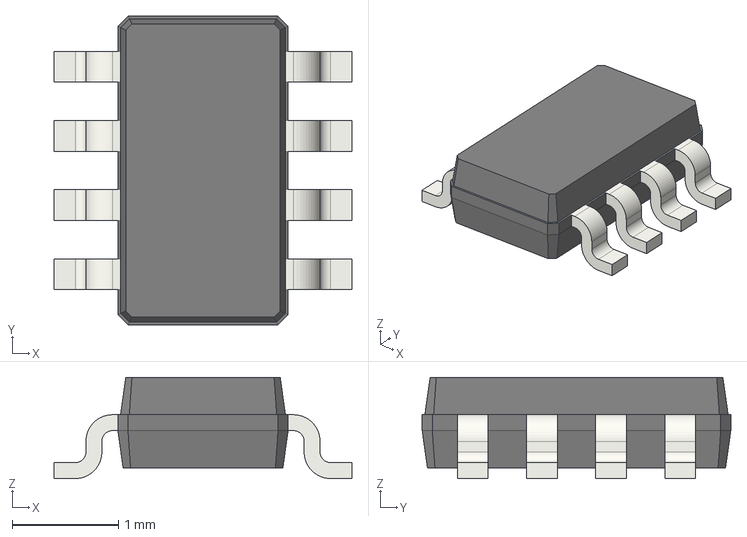
[picture p17: CAD file, 2026-09-26]
3dmodels/TSOT-23-8.step
2.80 x 2.90 x 0.95 mm
