luciddreams/ito-controller/3dmodels/G2RL_1A_E_review.step

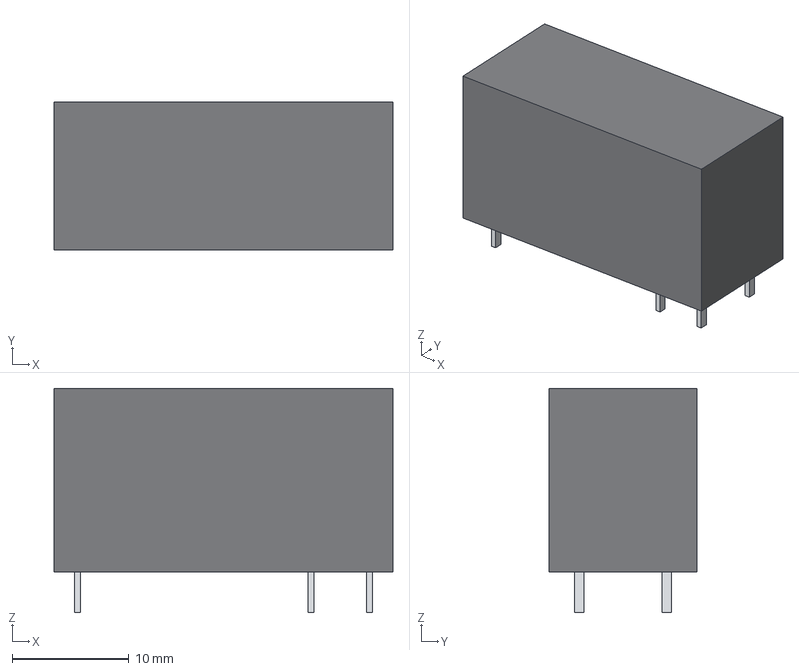
[picture p18: CAD file, 2026-09-26]
3dmodels/G2RL_1A_E_review.step
29.0 x 12.7 x 19.2 mm
