luciddreams/ito-controller/3dmodels/PinHeader_1x02_P2.54mm_Vertical.step

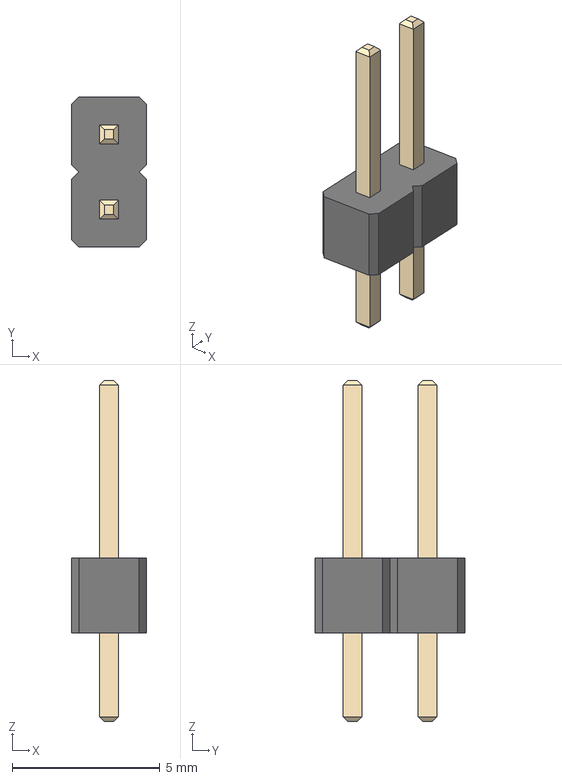
[picture p19: CAD file, 2026-09-26]
3dmodels/PinHeader_1x02_P2.54mm_Vertical.step
2.54 x 5.08 x 11.5 mm
