luciddreams/ito-controller/3dmodels/TO-220-3_Vertical.step

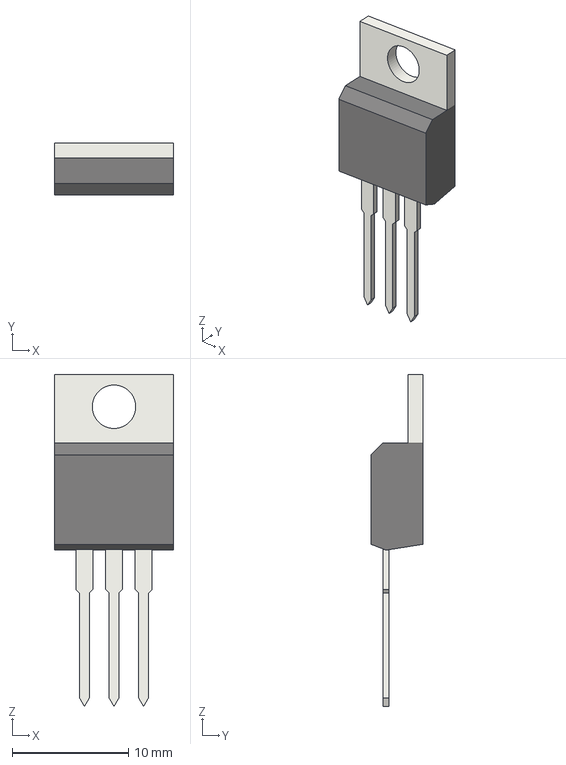
[picture p20: CAD file, 2026-09-26]
3dmodels/TO-220-3_Vertical.step
10.2 x 4.46 x 28.5 mm
