luciddreams/ito-controller/3dmodels/CP_Radial_D12.5mm_P5.00mm.step

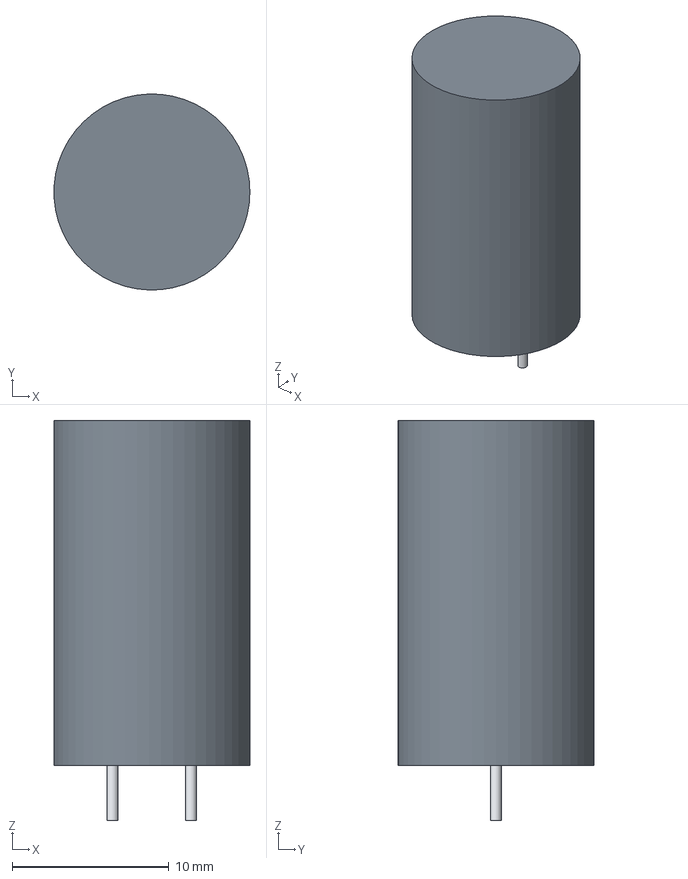
[picture p21: CAD file, 2026-09-26]
3dmodels/CP_Radial_D12.5mm_P5.00mm.step
12.5 x 12.5 x 25.5 mm
