luciddreams/ito-controller/3dmodels/R_2512_6332Metric.step

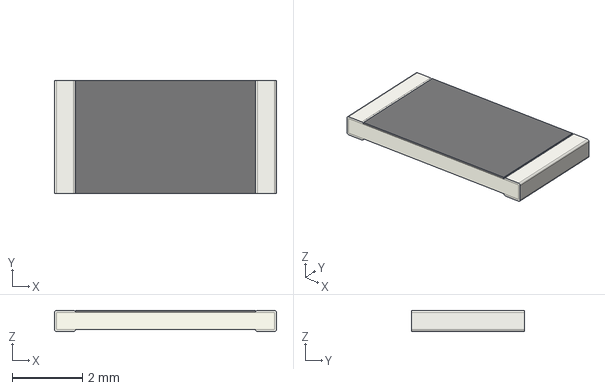
[picture p22: CAD file, 2026-09-26]
3dmodels/R_2512_6332Metric.step
6.30 x 3.20 x 0.6 mm
