luciddreams/ito-controller/3dmodels/KEMET_KPS_2220_Double.step

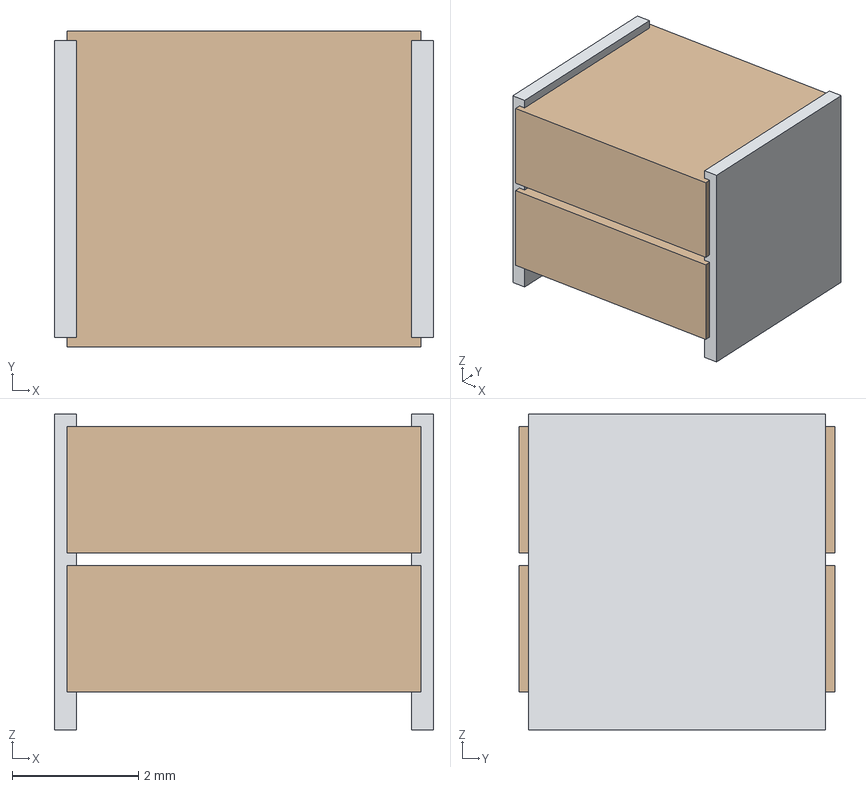
[picture p23: CAD file, 2026-09-26]
3dmodels/KEMET_KPS_2220_Double.step
6.00 x 5.00 x 5.00 mm
