luciddreams/ito-controller/3dmodels/QFN-28-1EP_3x6mm_P0.5mm_EP1.7x4.75mm.step

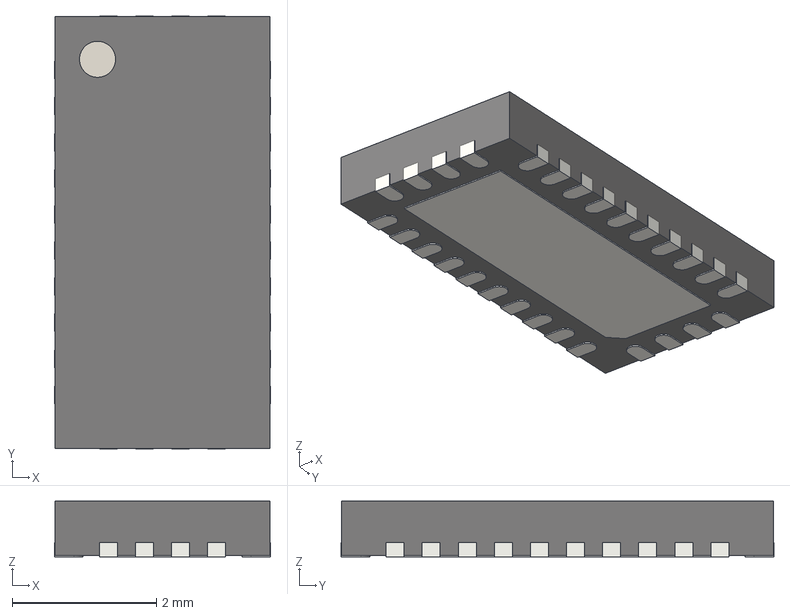
[picture p24: CAD file, 2026-09-26]
3dmodels/QFN-28-1EP_3x6mm_P0.5mm_EP1.7x4.75mm.step
3.00 x 6.00 x 0.77 mm
