luciddreams/ito-controller/3dmodels/TerminalBlock_Phoenix_MKDS-1,5-2-5.08_1x02_P5.08mm_Horizontal.step

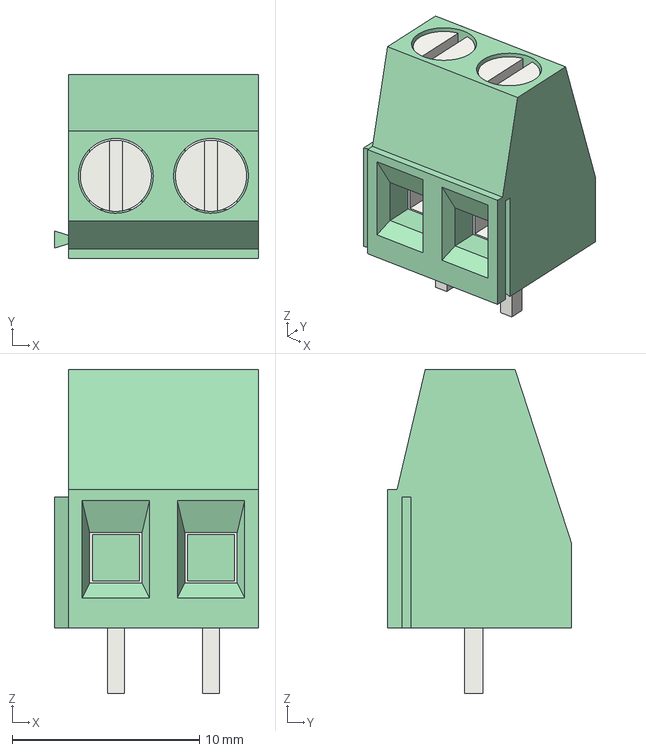
[picture p26: CAD file, 2026-09-26]
3dmodels/TerminalBlock_Phoenix_MKDS-1,5-2-5.08_1x02_P5.08mm_Horizontal.step
10.9 x 9.80 x 17.3 mm
