luciddreams/ito-controller/3dmodels/TSSOP-14_4.4x5mm_P0.65mm.step

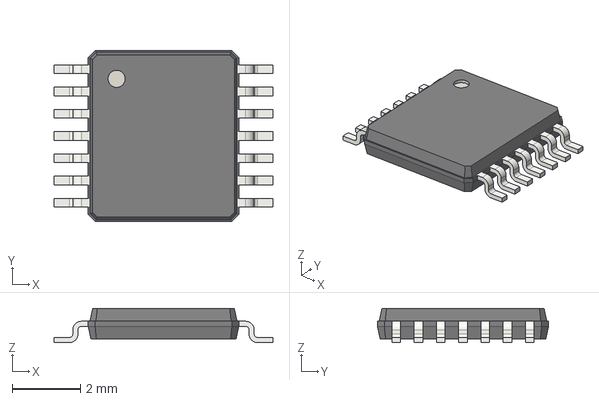
[picture p28: CAD file, 2026-09-26]
3dmodels/TSSOP-14_4.4x5mm_P0.65mm.step
6.40 x 5.00 x 1 mm
