luciddreams/ito-controller/3dmodels/Converter_DCDC_TRACO_TSR-1_THT.step

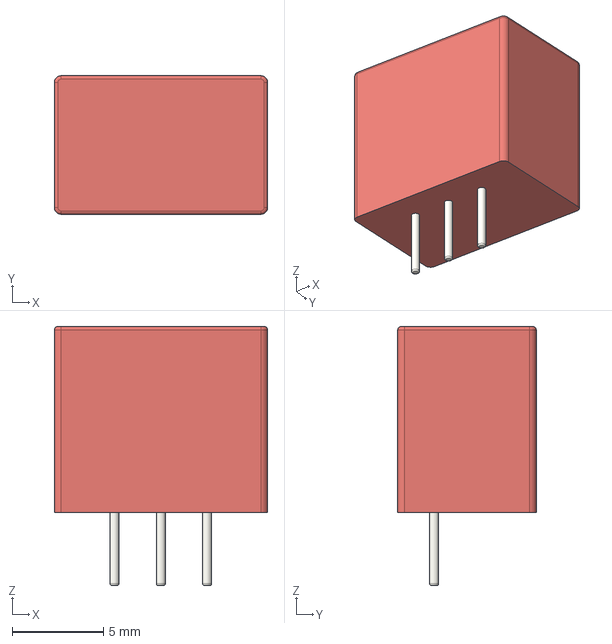
[picture p29: CAD file, 2026-09-26]
3dmodels/Converter_DCDC_TRACO_TSR-1_THT.step
11.7 x 7.60 x 14.2 mm
