luciddreams/ito-controller/3dmodels/JST_XH_B5B-XH-A_1x05_P2.50mm_Vertical.step

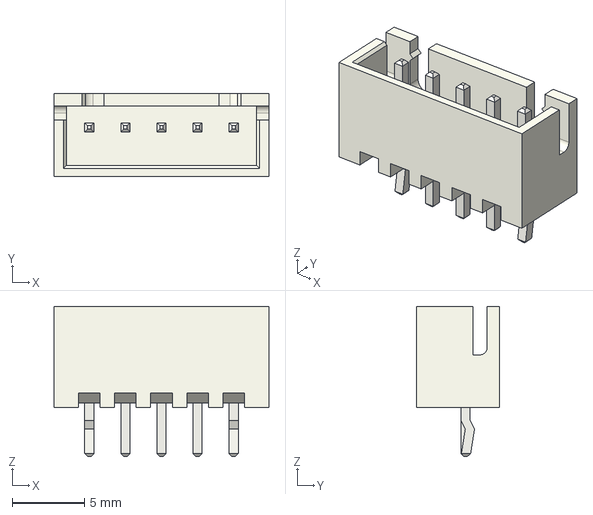
[picture p30: CAD file, 2026-09-26]
3dmodels/JST_XH_B5B-XH-A_1x05_P2.50mm_Vertical.step
14.9 x 5.75 x 10.4 mm
