luciddreams/ito-controller/3dmodels/SOIC-8_3.9x4.9mm_P1.27mm.step

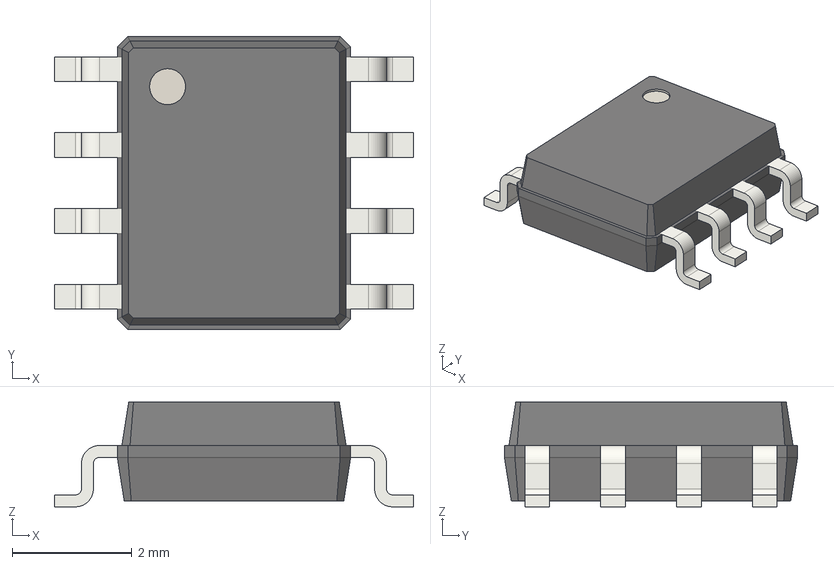
[picture p31: CAD file, 2026-09-26]
3dmodels/SOIC-8_3.9x4.9mm_P1.27mm.step
6.00 x 4.90 x 1.75 mm
