luciddreams/ito-controller/3dmodels/SOT-23-6.step

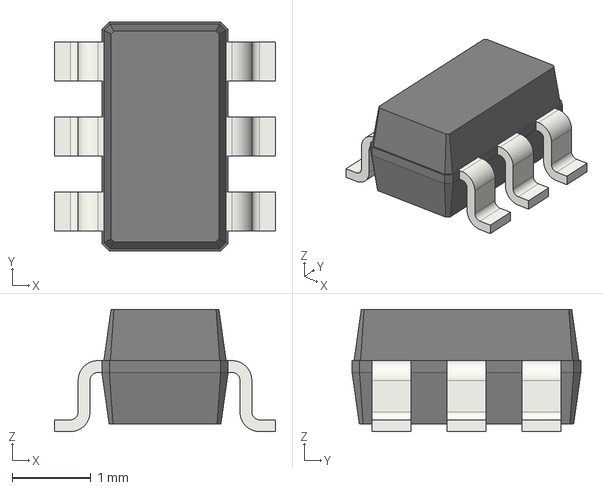
[picture p32: CAD file, 2026-09-26]
3dmodels/SOT-23-6.step
2.80 x 2.90 x 1.55 mm
