luciddreams/ito-controller/3dmodels/C_0805_2012Metric.step

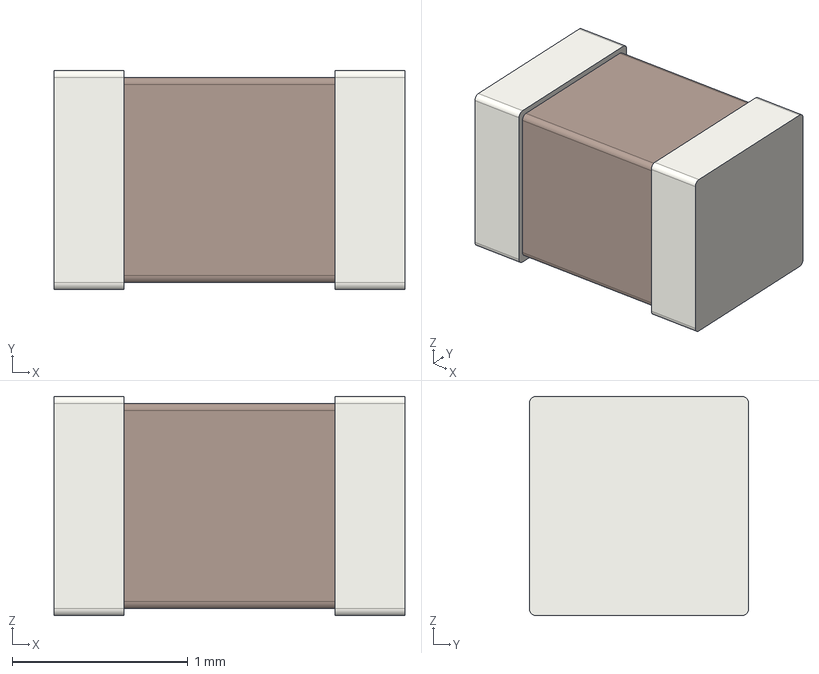
[picture p33: CAD file, 2026-09-26]
3dmodels/C_0805_2012Metric.step
2.00 x 1.25 x 1.25 mm
