luciddreams/ito-controller/3dmodels/C_1210_3225Metric.step

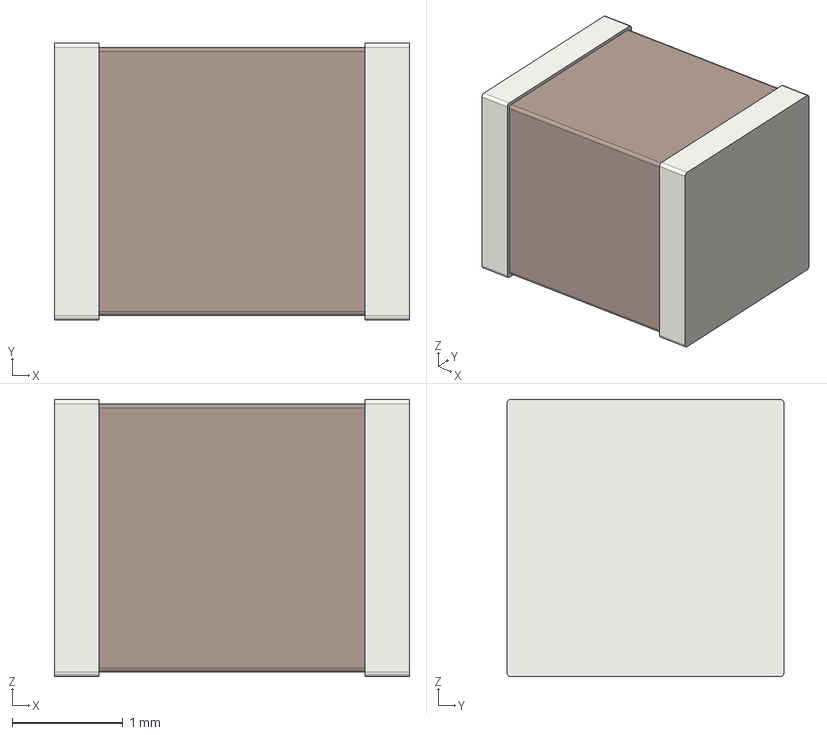
[picture p34: CAD file, 2026-09-26]
3dmodels/C_1210_3225Metric.step
3.20 x 2.50 x 2.50 mm
