luciddreams/ito-controller/3dmodels/SOT-23.step

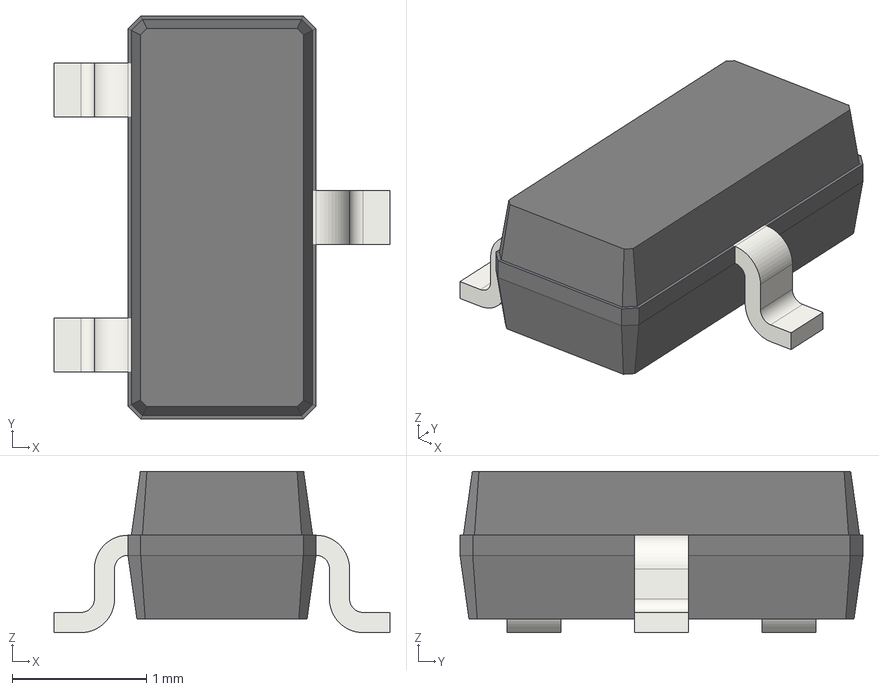
[picture p35: CAD file, 2026-09-26]
3dmodels/SOT-23.step
2.50 x 3.00 x 1.20 mm
