luciddreams/ito-controller/3dmodels/JST_XH_B2B-XH-A_1x02_P2.50mm_Vertical.step

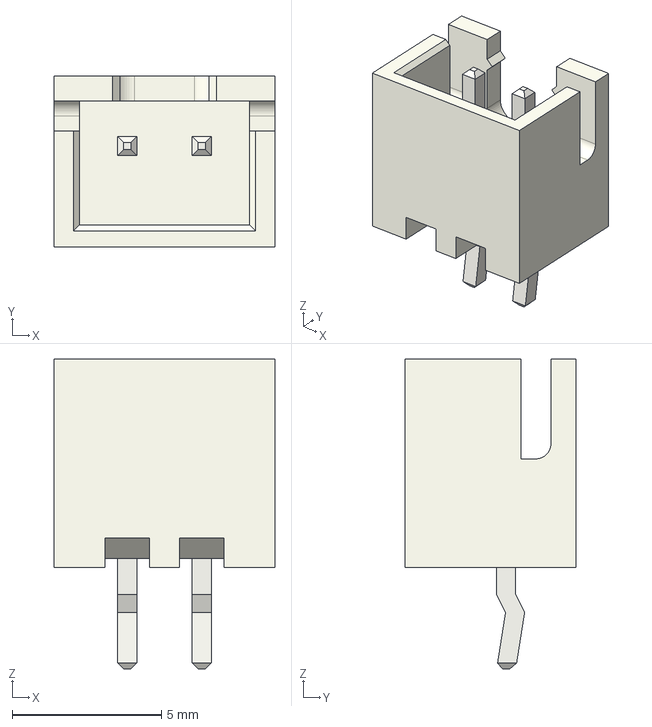
[picture p36: CAD file, 2026-09-26]
3dmodels/JST_XH_B2B-XH-A_1x02_P2.50mm_Vertical.step
7.40 x 5.75 x 10.4 mm
