luciddreams/ito-controller/3dmodels/XIAO_nRF52840_ENVELOPE.step

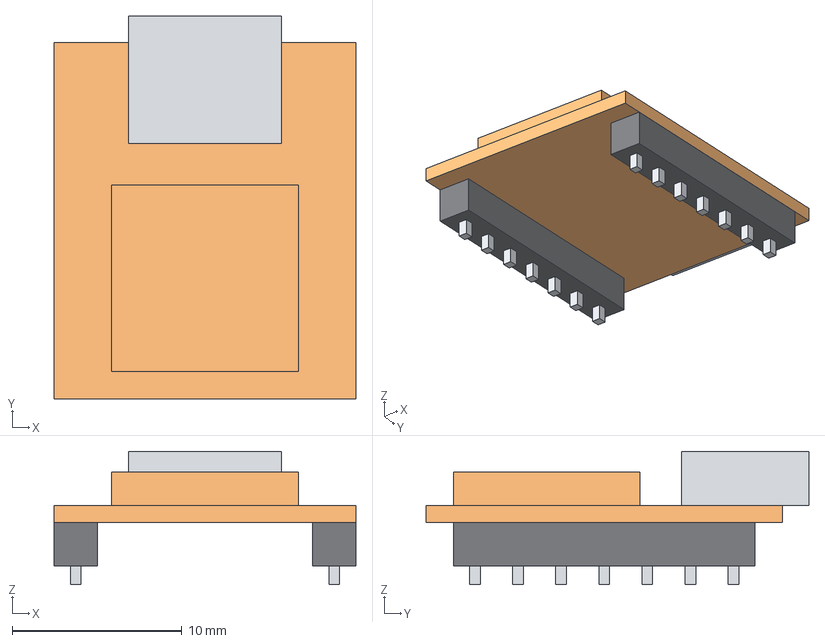
[picture p37: CAD file, 2026-09-26]
3dmodels/XIAO_nRF52840_ENVELOPE.step
17.8 x 22.6 x 7.85 mm
