luciddreams/ito-controller/3dmodels/VSSOP-10_3x3mm_P0.5mm.step

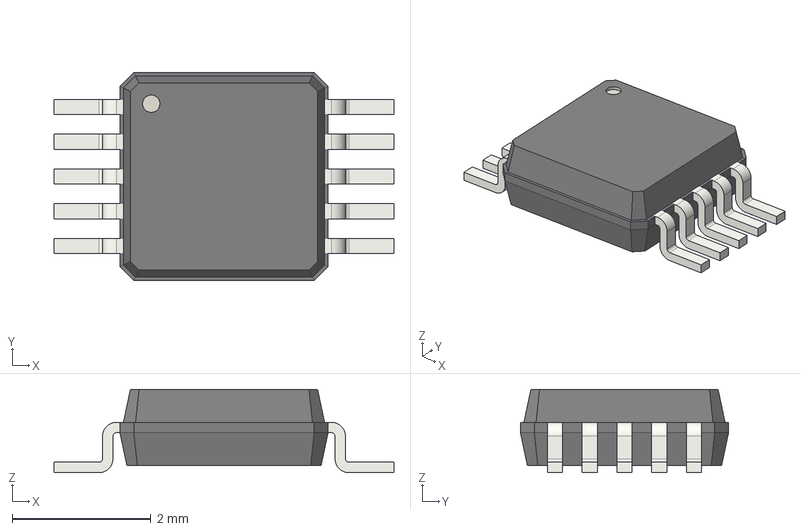
[picture p38: CAD file, 2026-09-26]
3dmodels/VSSOP-10_3x3mm_P0.5mm.step
4.90 x 3.00 x 1.20 mm
