luciddreams/ito-controller/(list of files, cad)

Other CAD files:
3dmodels/Fuse_2410_6125Metric.step
