luciddreams/ito-controller/manufacturing/gerber-bottom-readback.png

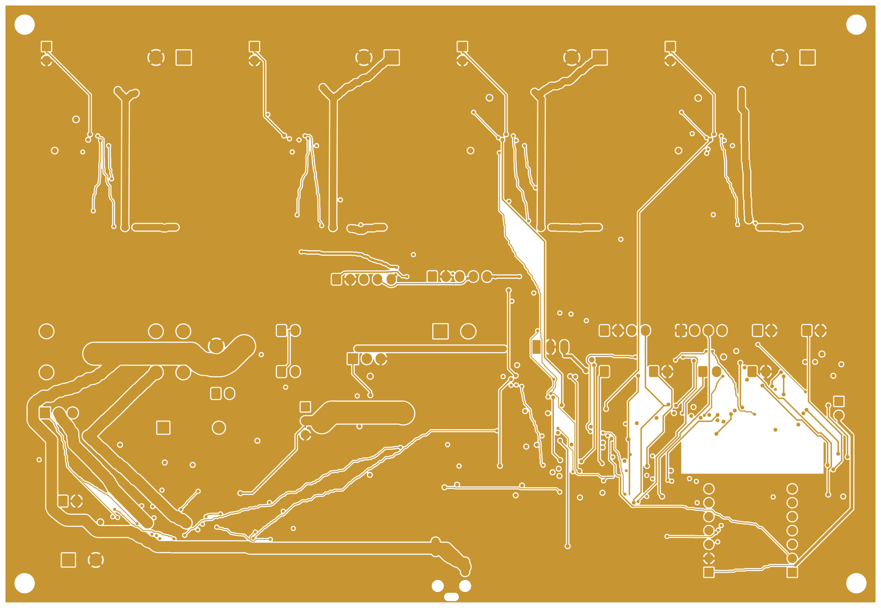
manufacturing/gerber-bottom-readback.png
