luciddreams/ito-controller/manufacturing/gerber-top-readback.png

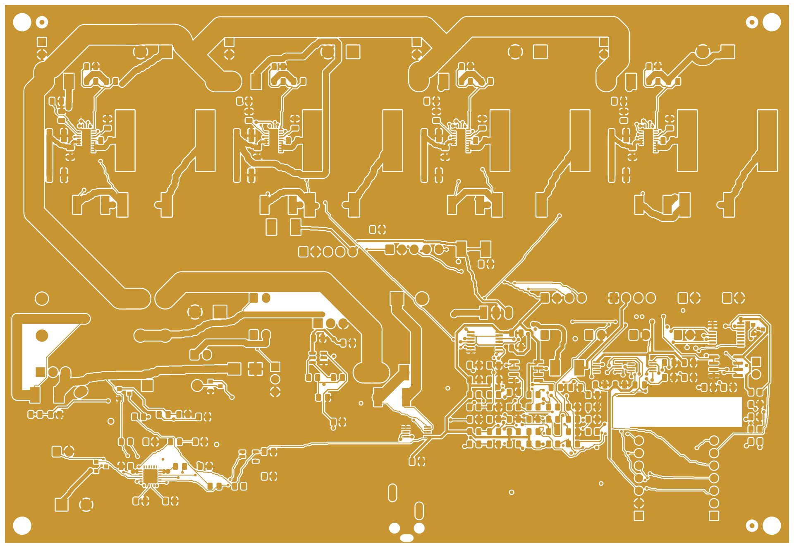
manufacturing/gerber-top-readback.png
