luciddreams/ito-controller/commissioning-results.csv

ID | Test | Acceptance | Status | Measured | Date | Operator | Evidence
A01 | Visual assembly/QFN inspection | Pinout/polarity correct; no bridges | NOT TESTED
A02 | Unpowered short check | No persistent short on input/logic rails | NOT TESTED
A03 | Lab supply logic-only startup | 5V correct; relay/load outputs off | NOT TESTED
A04 | USB/JP1 and XIAO placement | JP1 open with USB; USB points to lower board edge | NOT TESTED
A05 | Reset/I2C timeout/sensor open and short | All power outputs disabled; fault latched | NOT TESTED
A06 | Heater/TEC hardware interlock | TEC_ARM blocks heater at U2 for every PWM state | NOT TESTED
A07 | Current ADC calibration | External meter comparison at two points; <=4A actual limit | NOT TESTED
A08 | eFuse overload and reset | Trip consistent with4.18..4.82A band; specified latch/reset behavior | NOT TESTED
A09 | Cold/hot input plug-in | Stable startup; +24_PROT peak<32V; no repeated oscillation | NOT TESTED
A10 | One TEC channel CC/CV dynamic test | No sustained oscillation; current overshoot remains<=2A; ISP/ISN ripple target<30mVpp | NOT TESTED
A11 | All channels under aggregate budget | Measured input<=4A; measured output<=2A/channel | NOT TESTED
A12 | Thermal steady-state | Below defined component/connector/ambient test limits | NOT TESTED
A13 | Thermostat/e-stop fan failure | Relay drops; firmware fault latched; no automatic power restart | NOT TESTED
A14 | Glass low-power pulses | All sensors plausible; no hotspots/adhesion damage; <=40C provisional stop | NOT TESTED
A15 | Stepped heater boost and clearing time | Power/duration accepted only from recorded temperature/condensation measurements | NOT TESTED
F01 | Power-up diagnosis firmware | Outputs off with default config; all expected devices readable | NOT TESTED
F02 | ADC and NTC calibration | Both ADC channels and all 5 probes verified; independent third current point | NOT TESTED
F03 | Deadman and USB loss | Direct power enables fall; fault latched; no automatic restart | NOT TESTED
F04 | I2C stuck SDA/SCL | Bounded transaction failure; direct power enables off; verify scope timing | NOT TESTED
F05 | Watchdog stall injection | Measured reset near nominal 250ms; output pins low after reset; no resume | NOT TESTED
F06 | DAC/TCA/ADC register reset | Configuration mismatch detected; power disabled | NOT TESTED
F07 | PWM and pulse duration | 10Hz heater waveform; commanded duration plus measured bounded latency; no excessive energy | NOT TESTED
F08 | Fan tach loss | Start prohibited or active pulse stopped; full fan command preserved | NOT TESTED
F09 | Mode change decay | At least2s off; scope proves current decayed before next mode | NOT TESTED
F10 | Calibrated code limits | Each enabled channel <=2A measured incl warm/ripple/overshoot | NOT TESTED
S01 | Adapter jumpers and wiring | 3V3/5V separate; local0-1 open; correct sensor addresses | NOT TESTED
S02 | Remote supply under load | All PCA9615 VDDB3..5.5V; remote target4.5..5.25V; branch<=150mA | NOT TESTED
S03 | 1m and maximum cable signal test | Fresh data and valid CRC with TEC/heater/fan active; scope rise/low levels | NOT TESTED
S04 | Remote sensor removal/fault | Pulse blocked or stopped; missing data not treated as valid | NOT TESTED
S05 | Thermal measurement location | 30min installation off/on comparison; reference outside disturbed airflow | NOT TESTED
