luciddreams/ito-controller/history-rev-j/README.md

# Historische reviewbestanden

Alle bestanden hier zijn achtergrond uit revisie J en ouder. Ze zijn geen montage- of vrijgave-instructie voor revisie K. De ingangstrap, stroommeting, voeding en bedrijfsgrenzen zijn in K gewijzigd. Gebruik de documenten in de hoofdmap.
