luciddreams/ito-controller/history-rev-j/input-stage-candidate/preview/input-stage-candidate.png

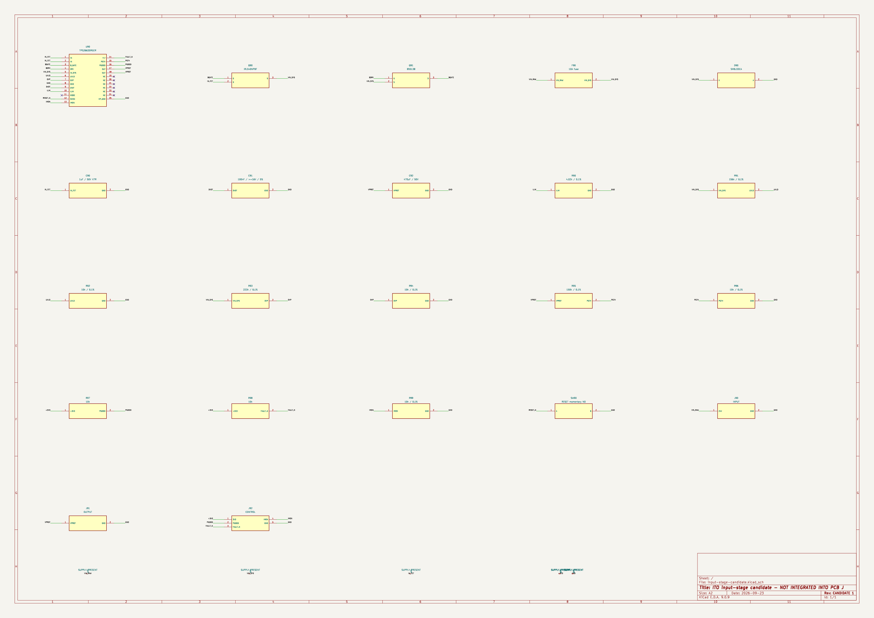
history-rev-j/input-stage-candidate/preview/input-stage-candidate.png
