luciddreams/ito-controller/history-rev-k/ito-controller-schema-rev-k.pdf

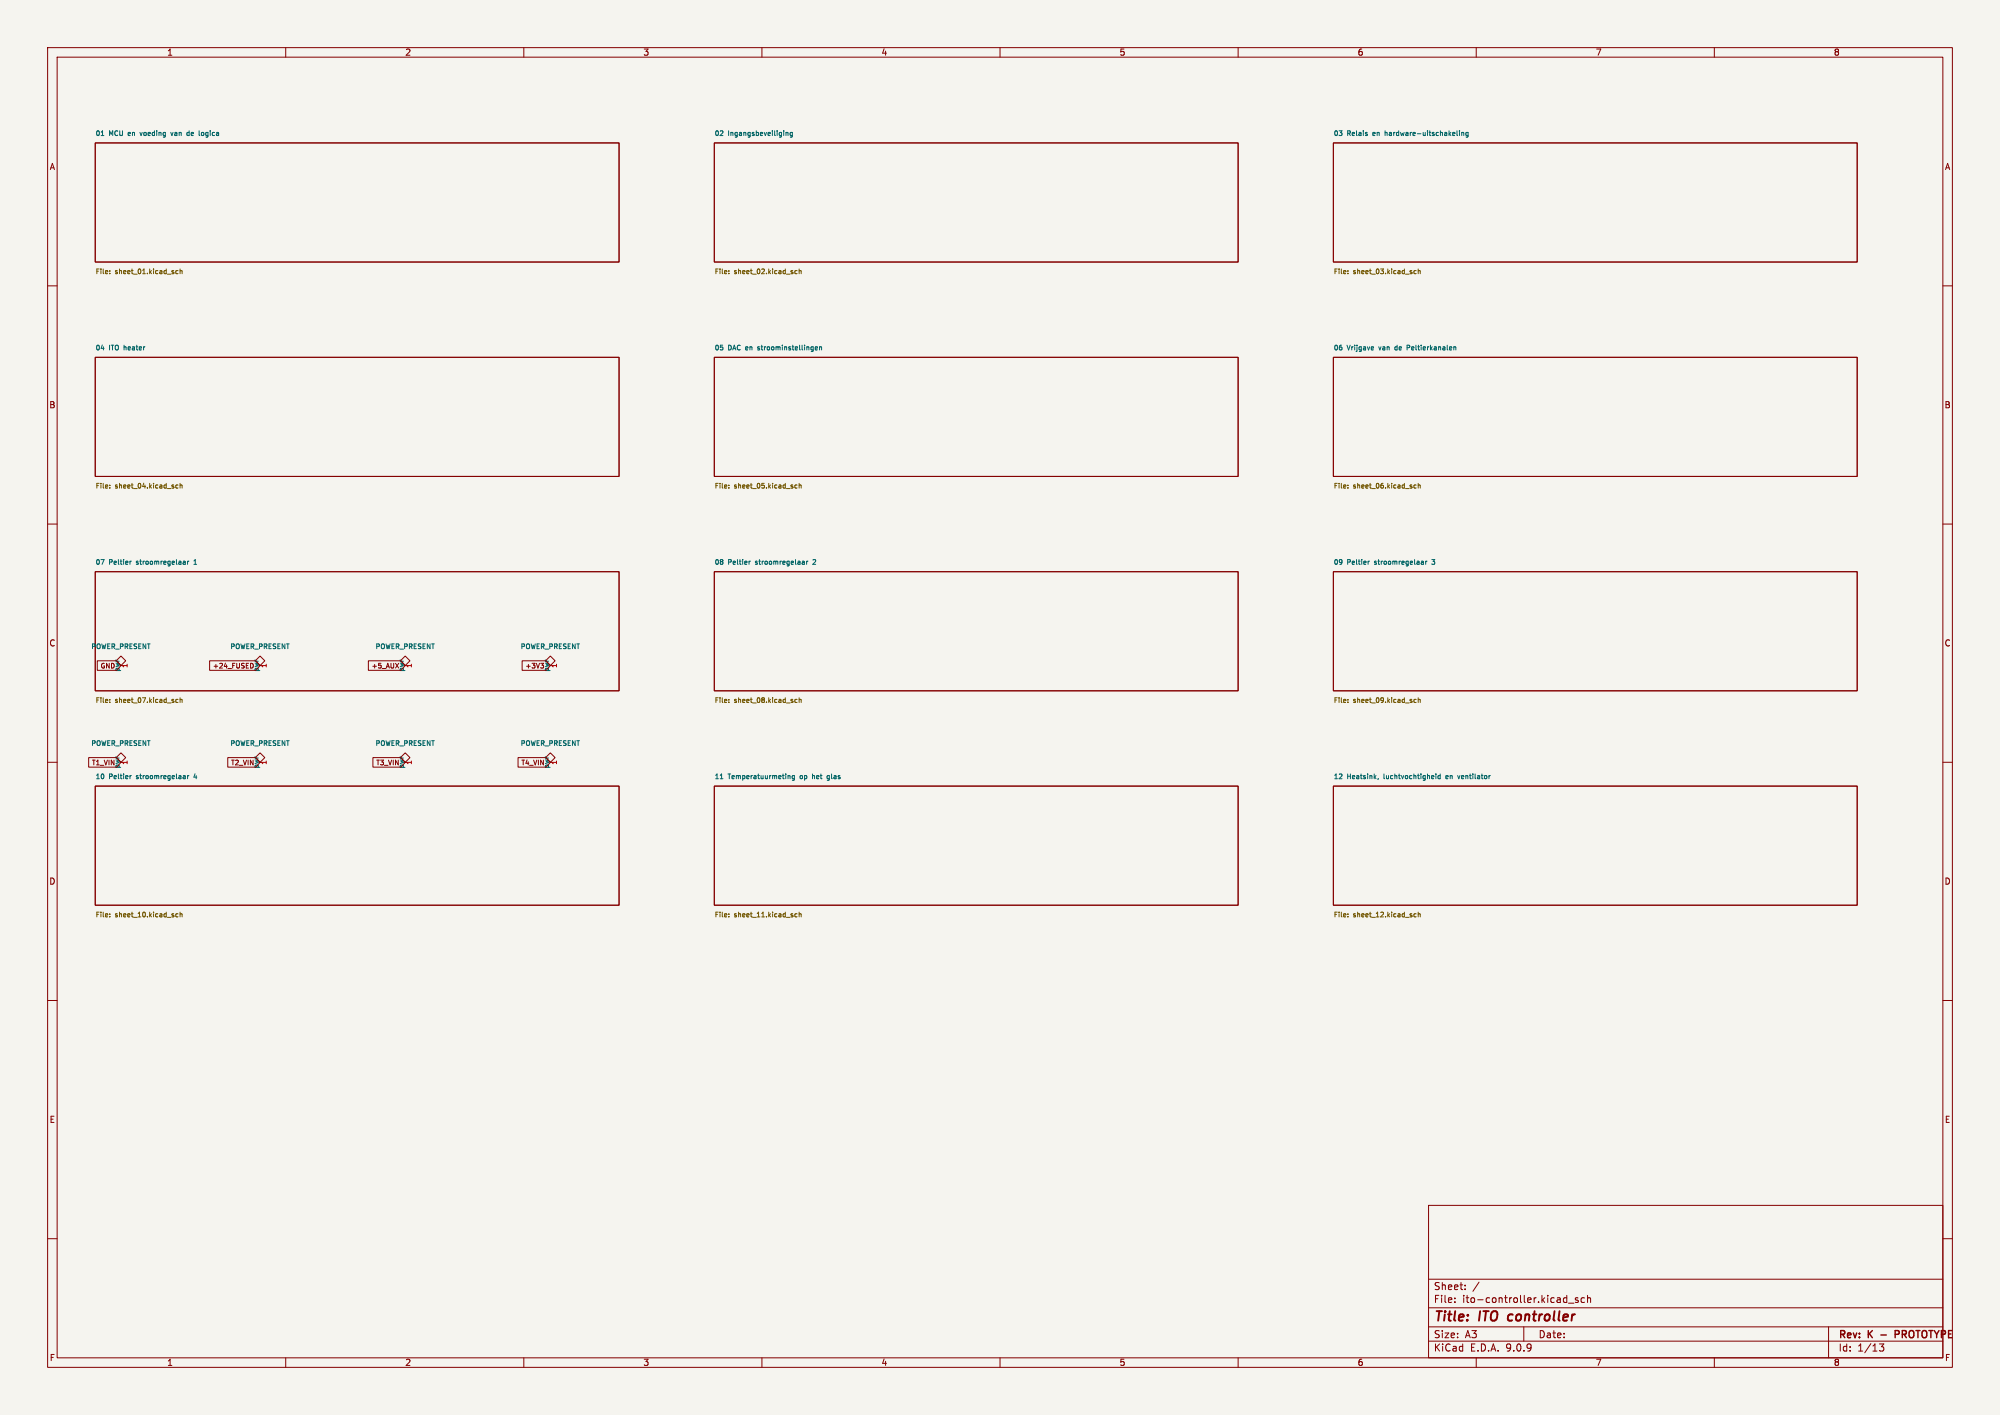
[picture p42: page 1]

01 MCU en voeding van de logica File: sheet_01.kicad_sch

03 Relais en hardware-uitschakeling File: sheet_03.kicad_sch

06 Vrijgave van de Peltierkanalen File: sheet_06.kicad_sch

Id: 1/13 Title: ITO controller File: ito-controller.kicad_sch Sheet: /

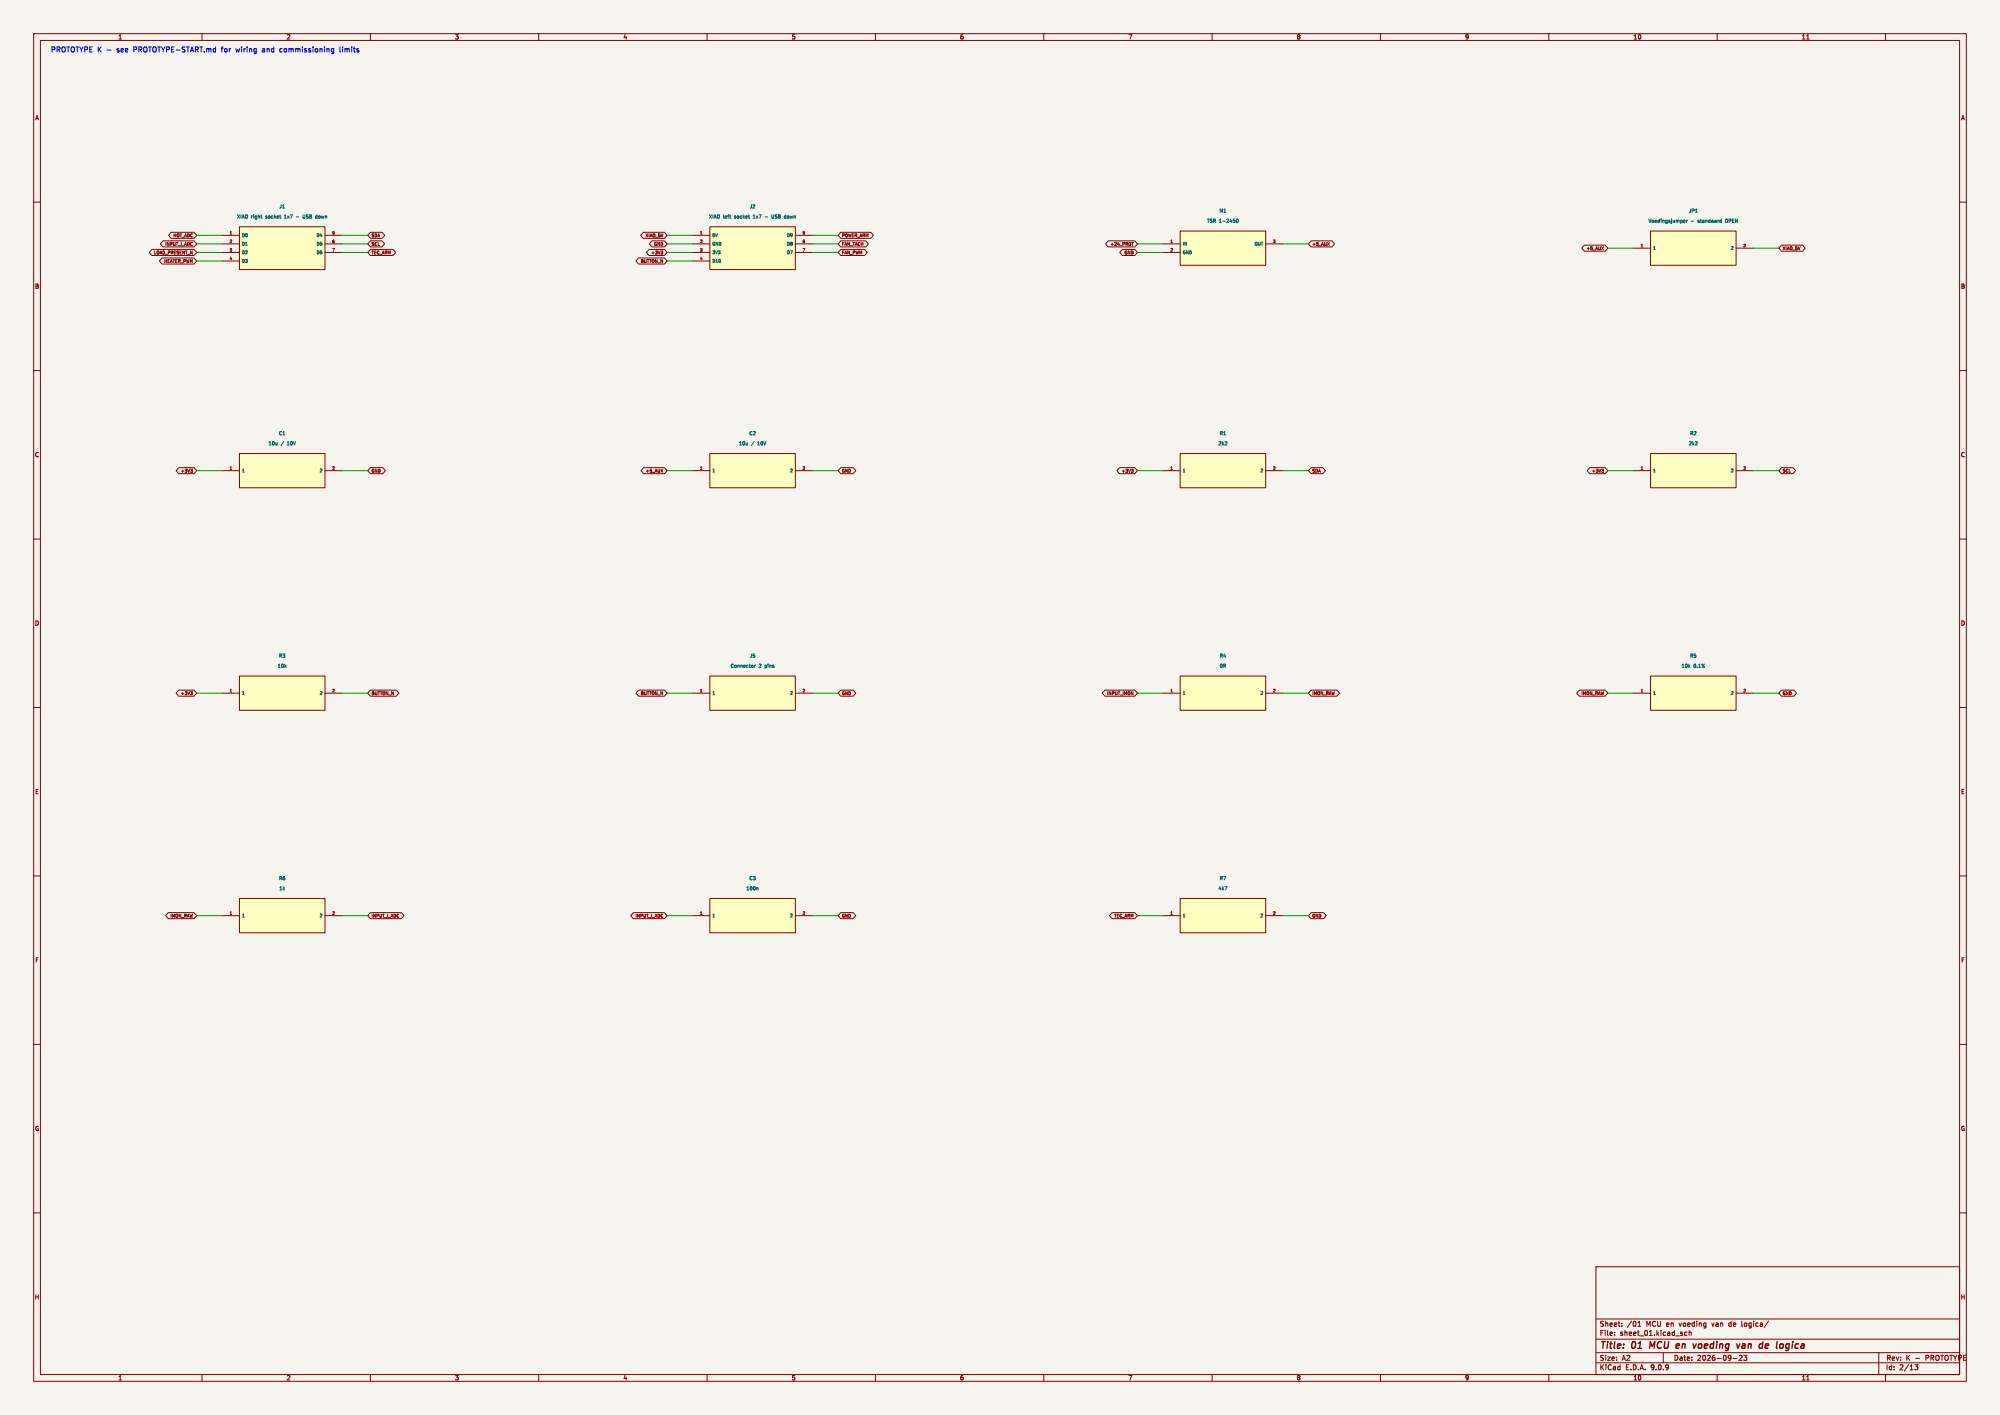
[picture p43: page 2]

7 J1 XIAO right socket 1x7 - USB down

7 J2 XIAO left socket 1x7 - USB down

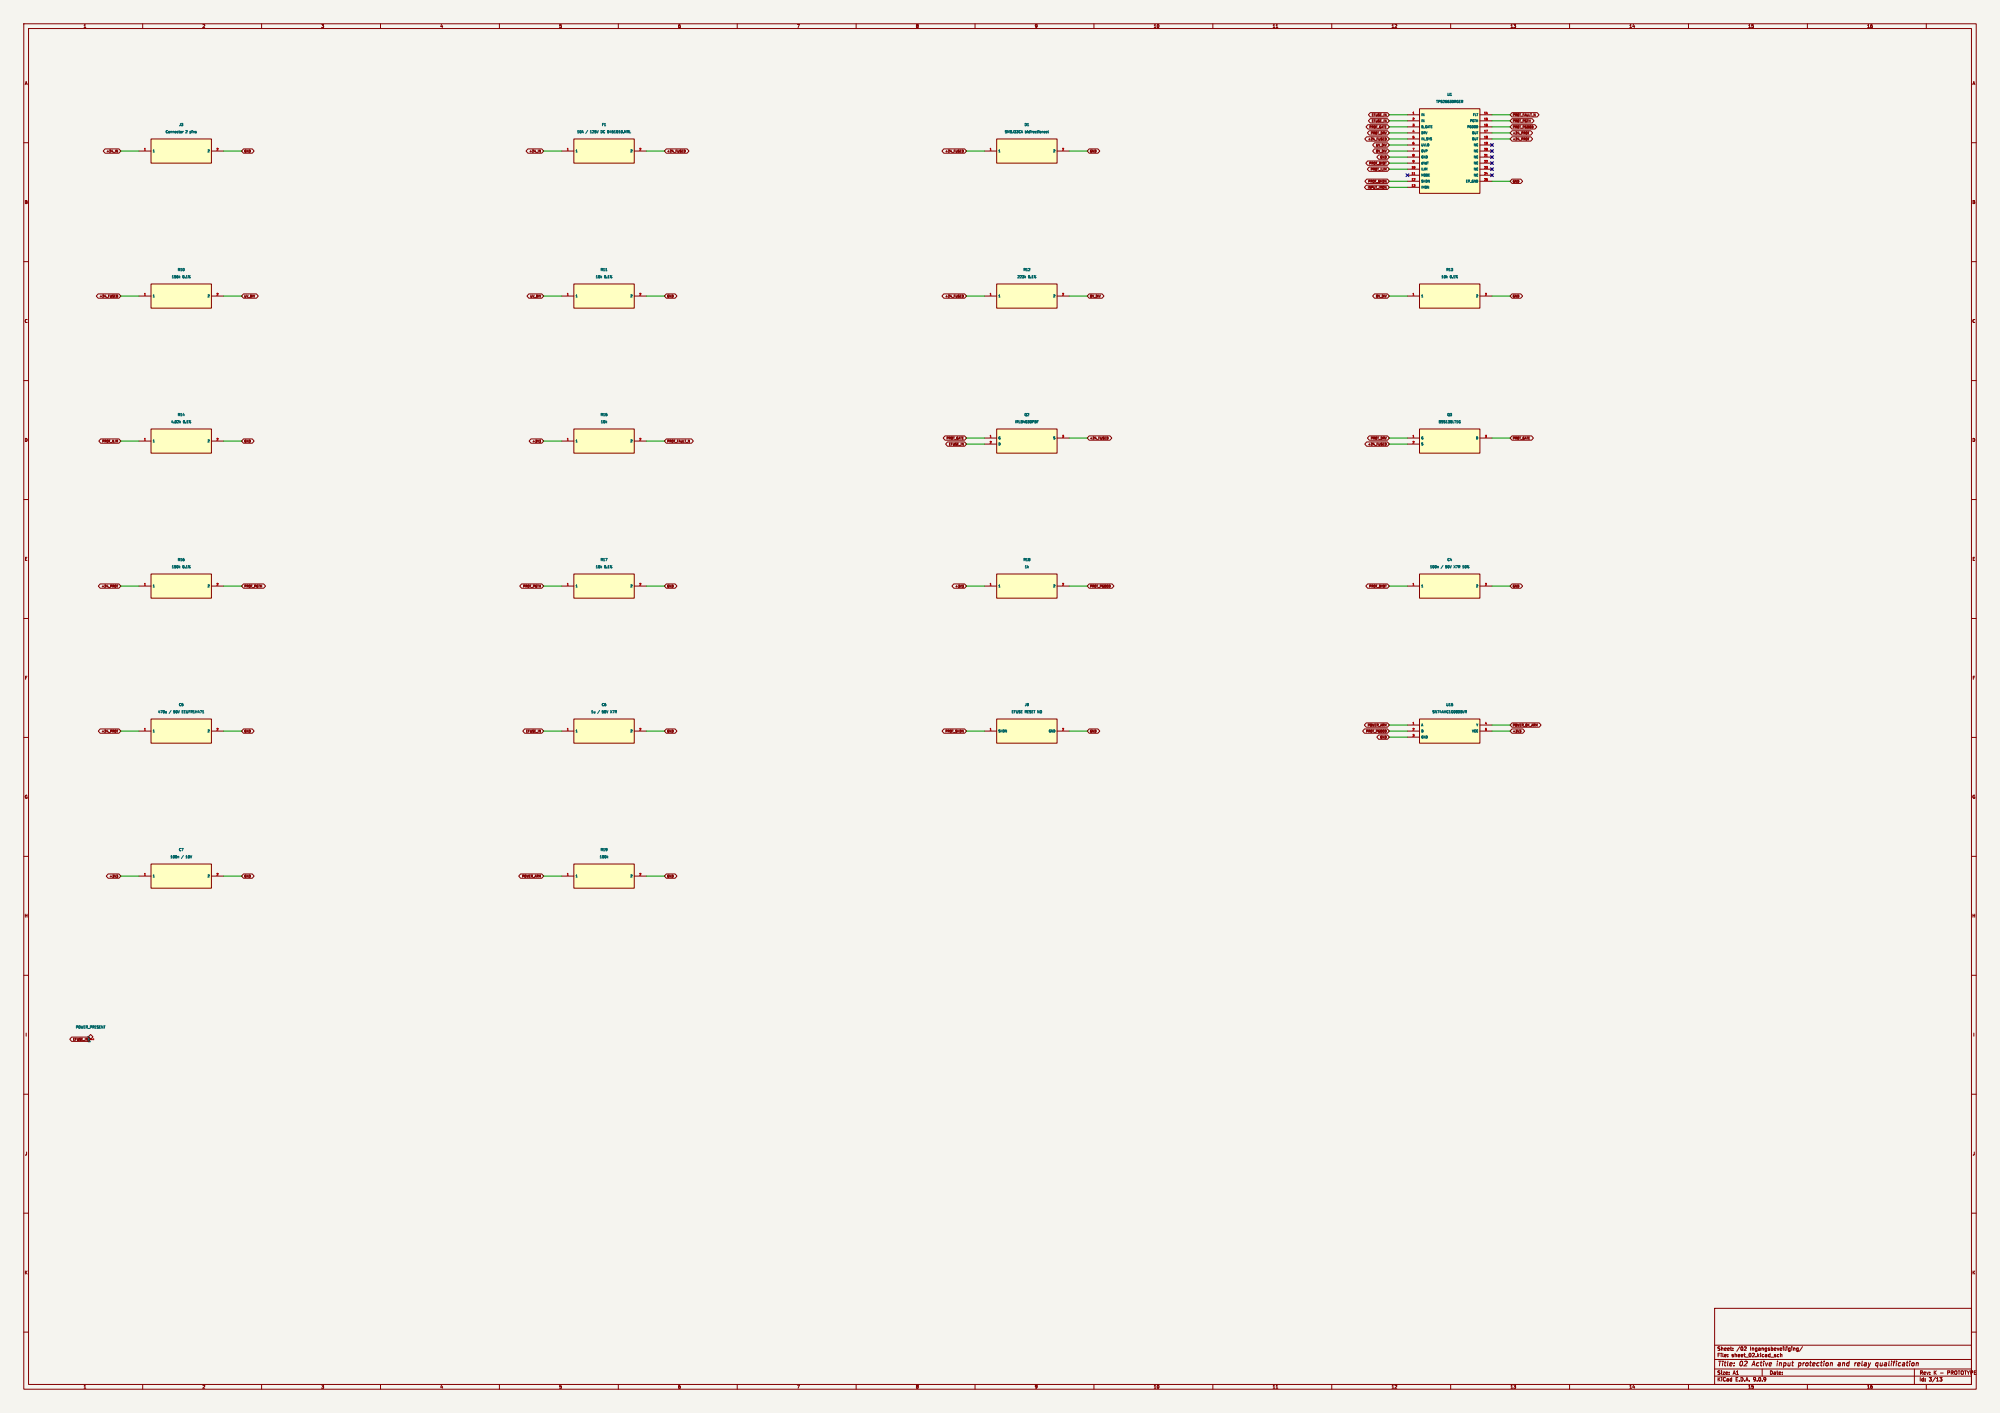
[picture p44: page 3]

Id: 3/13 Title: 02 Active input protection and relay qualification

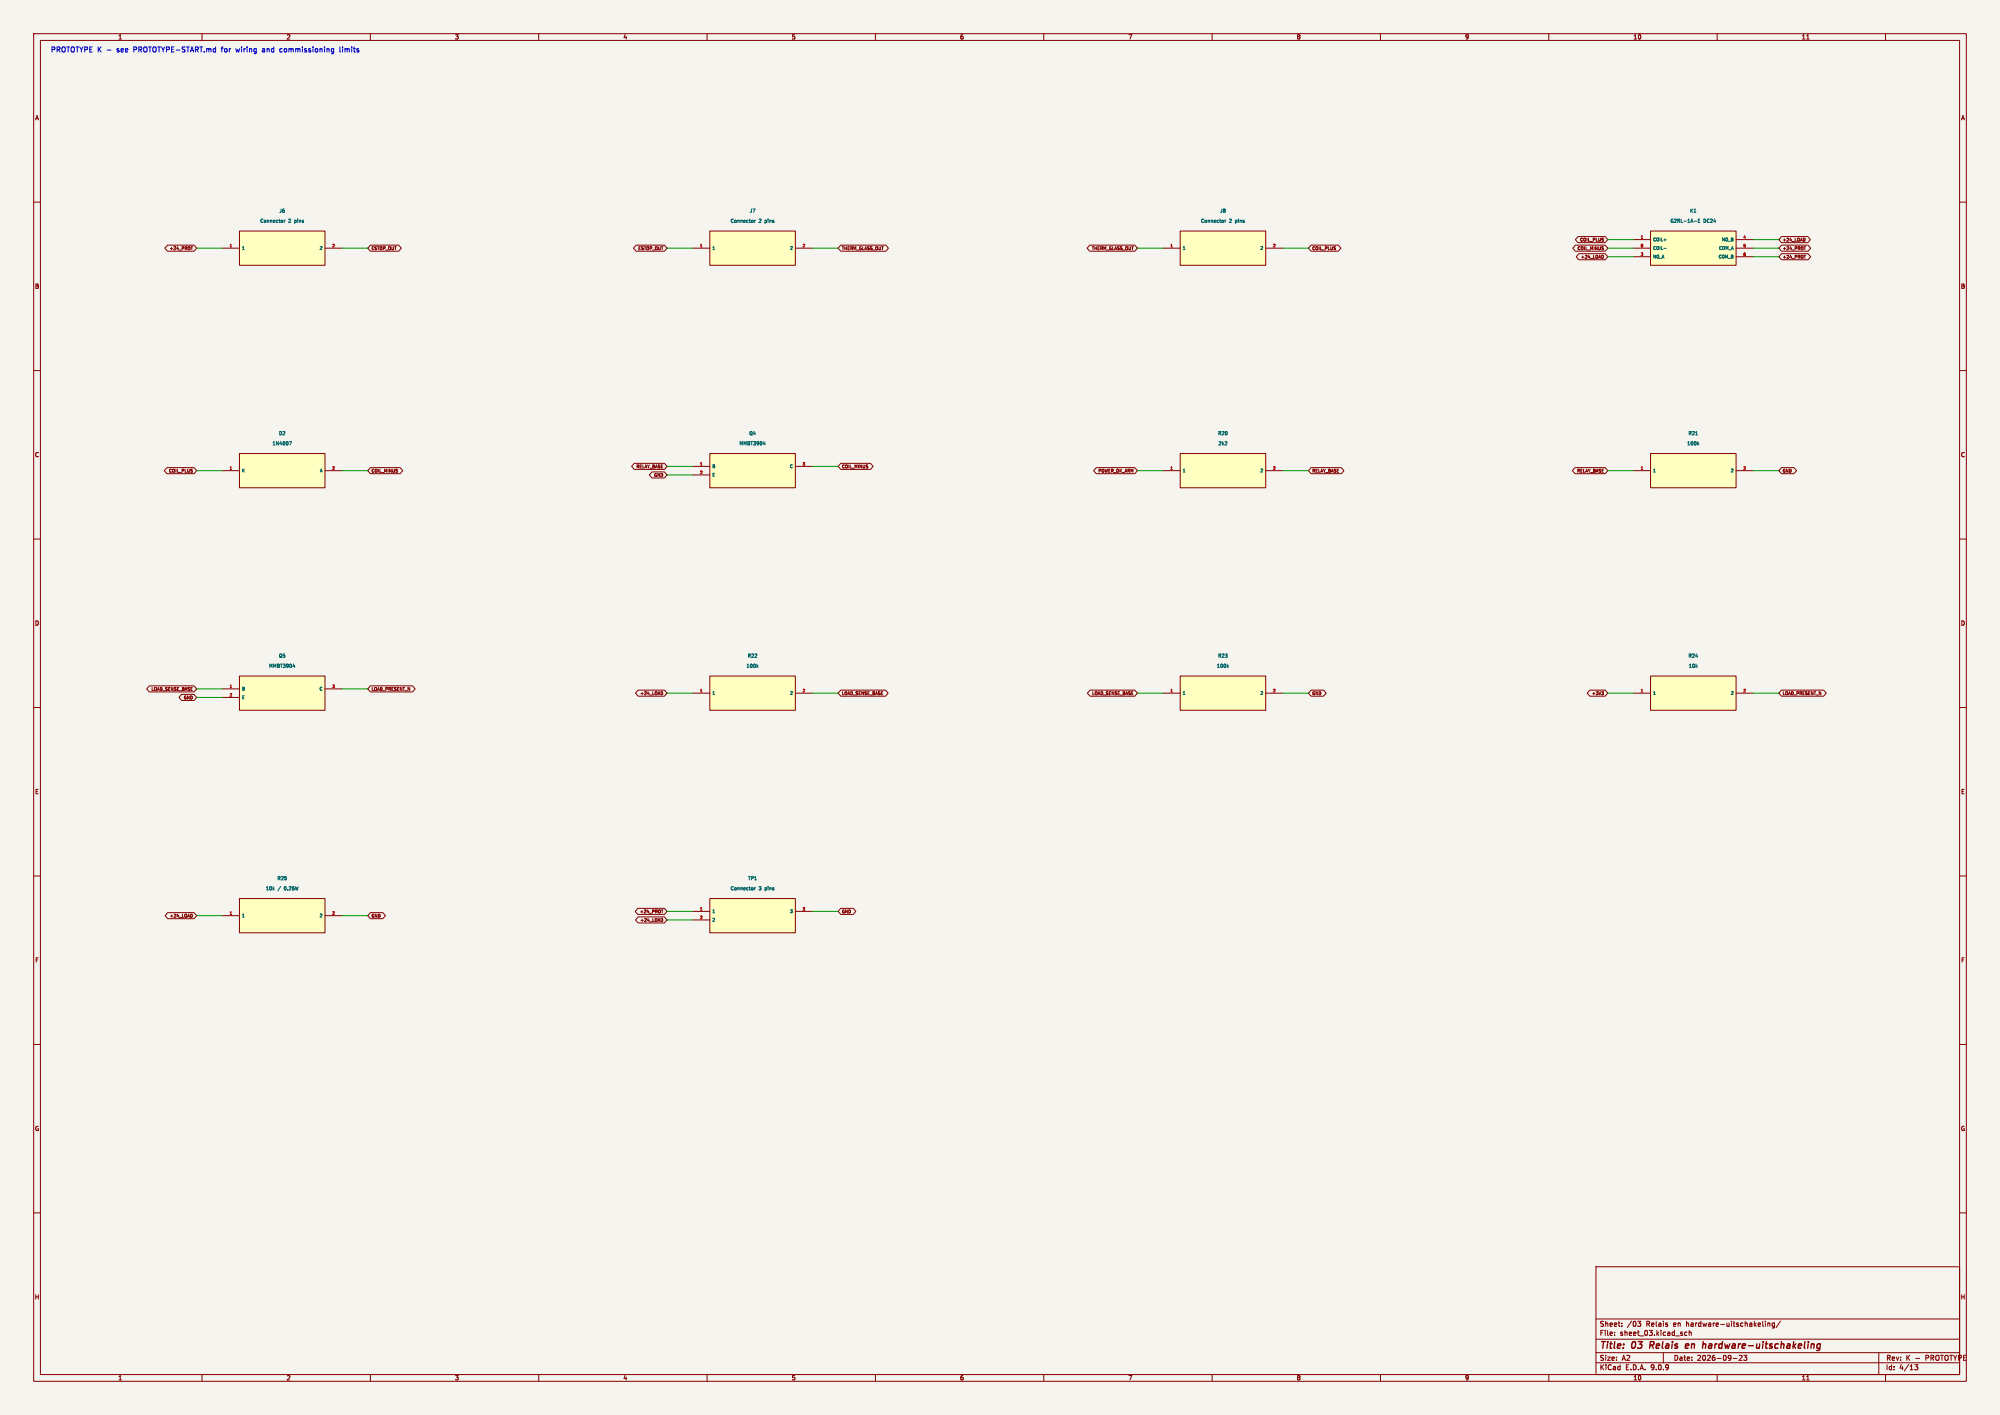
[picture p45: page 4]

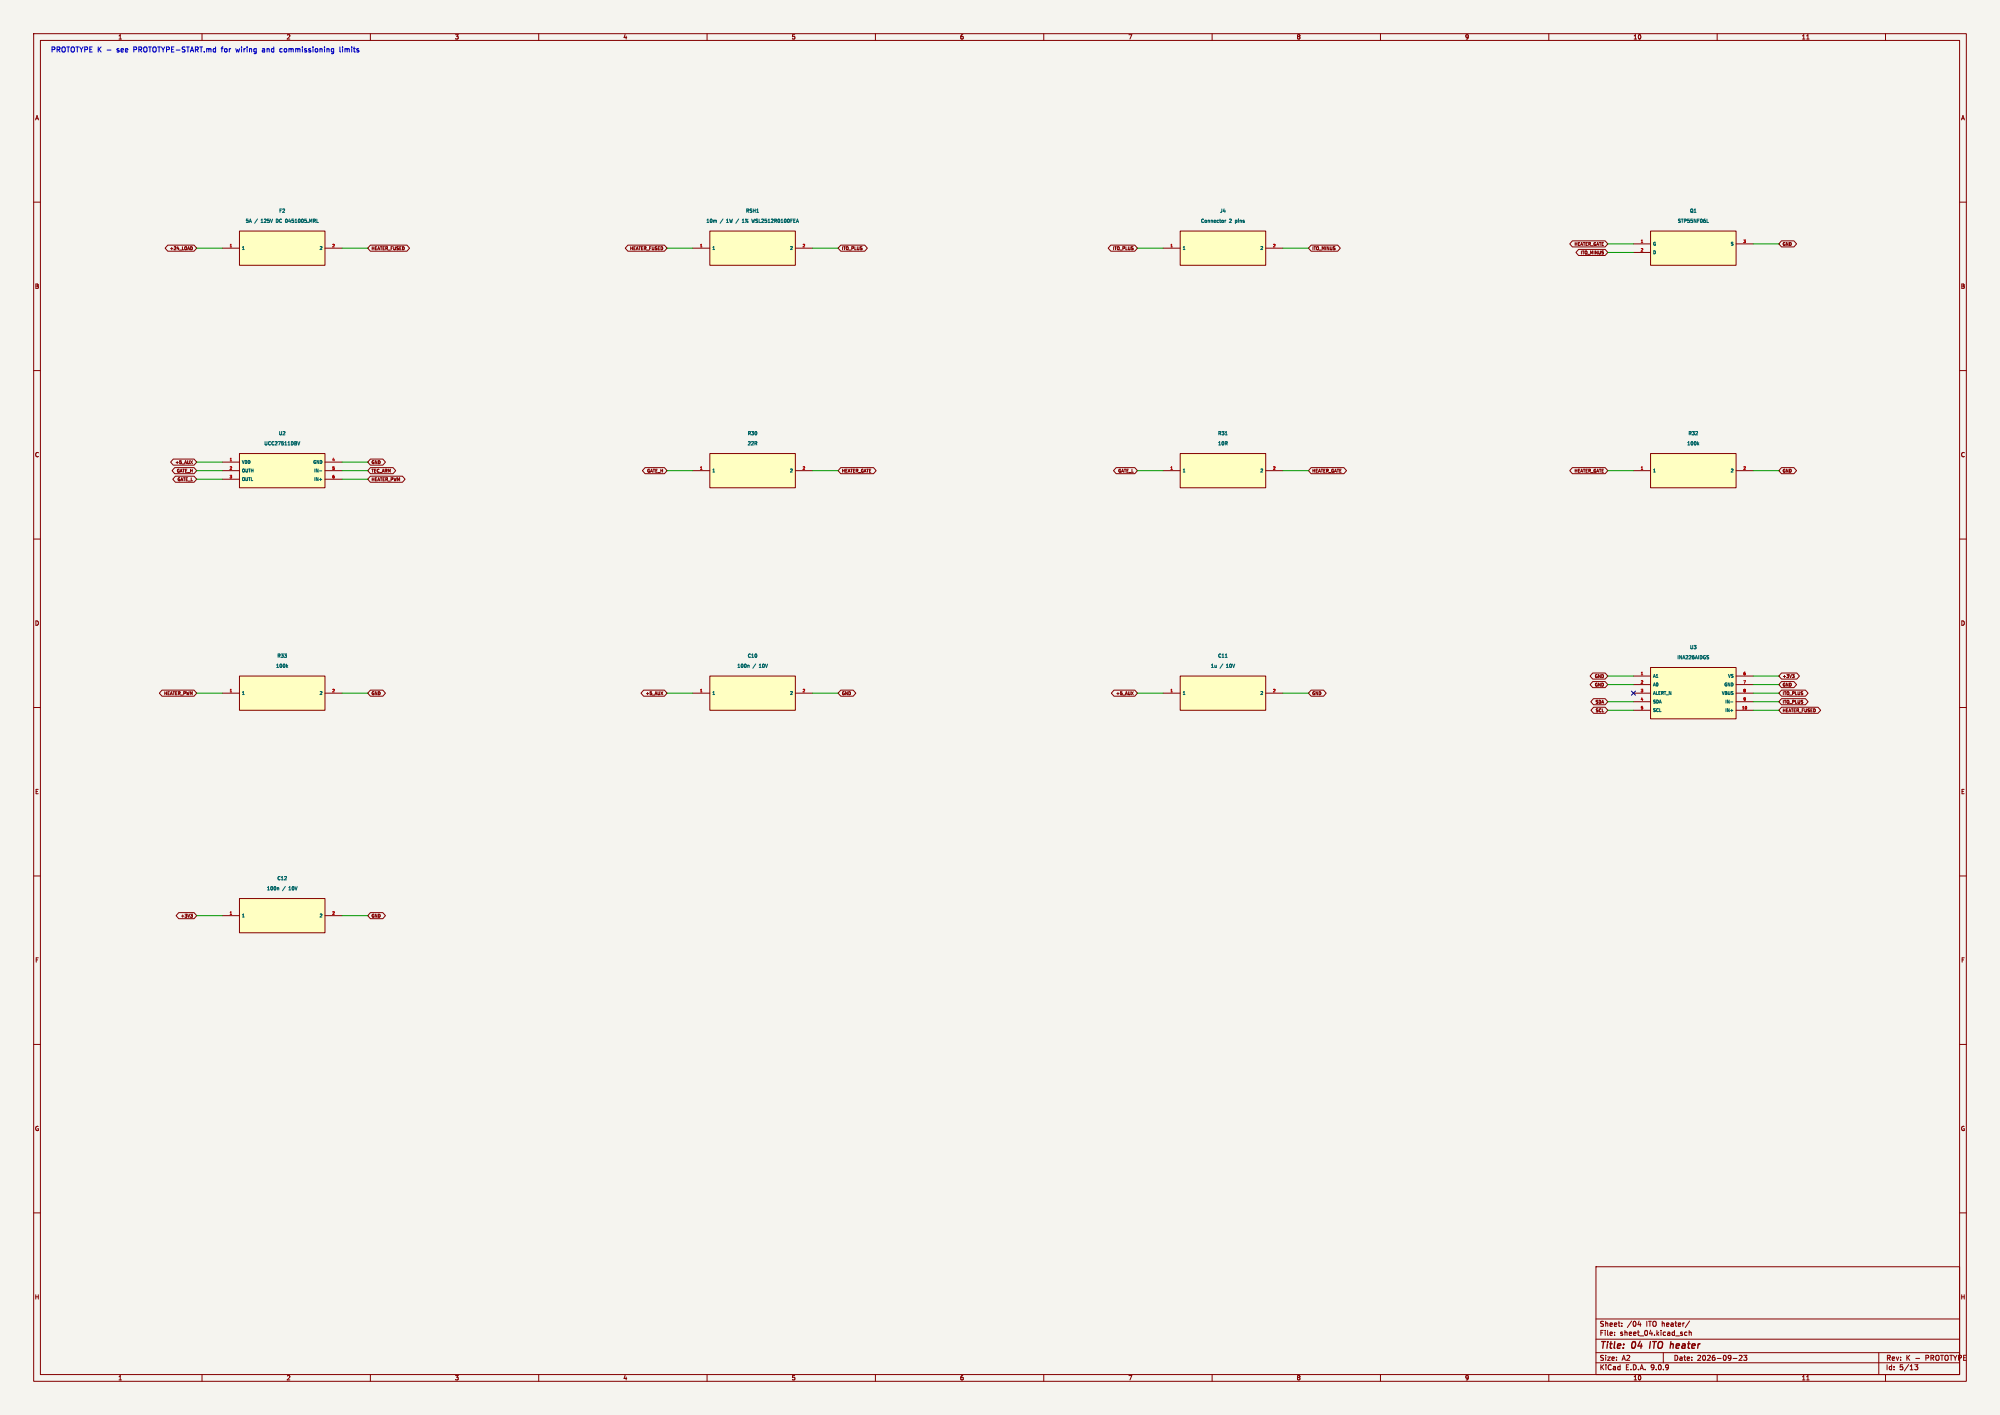
[picture p46: page 5]

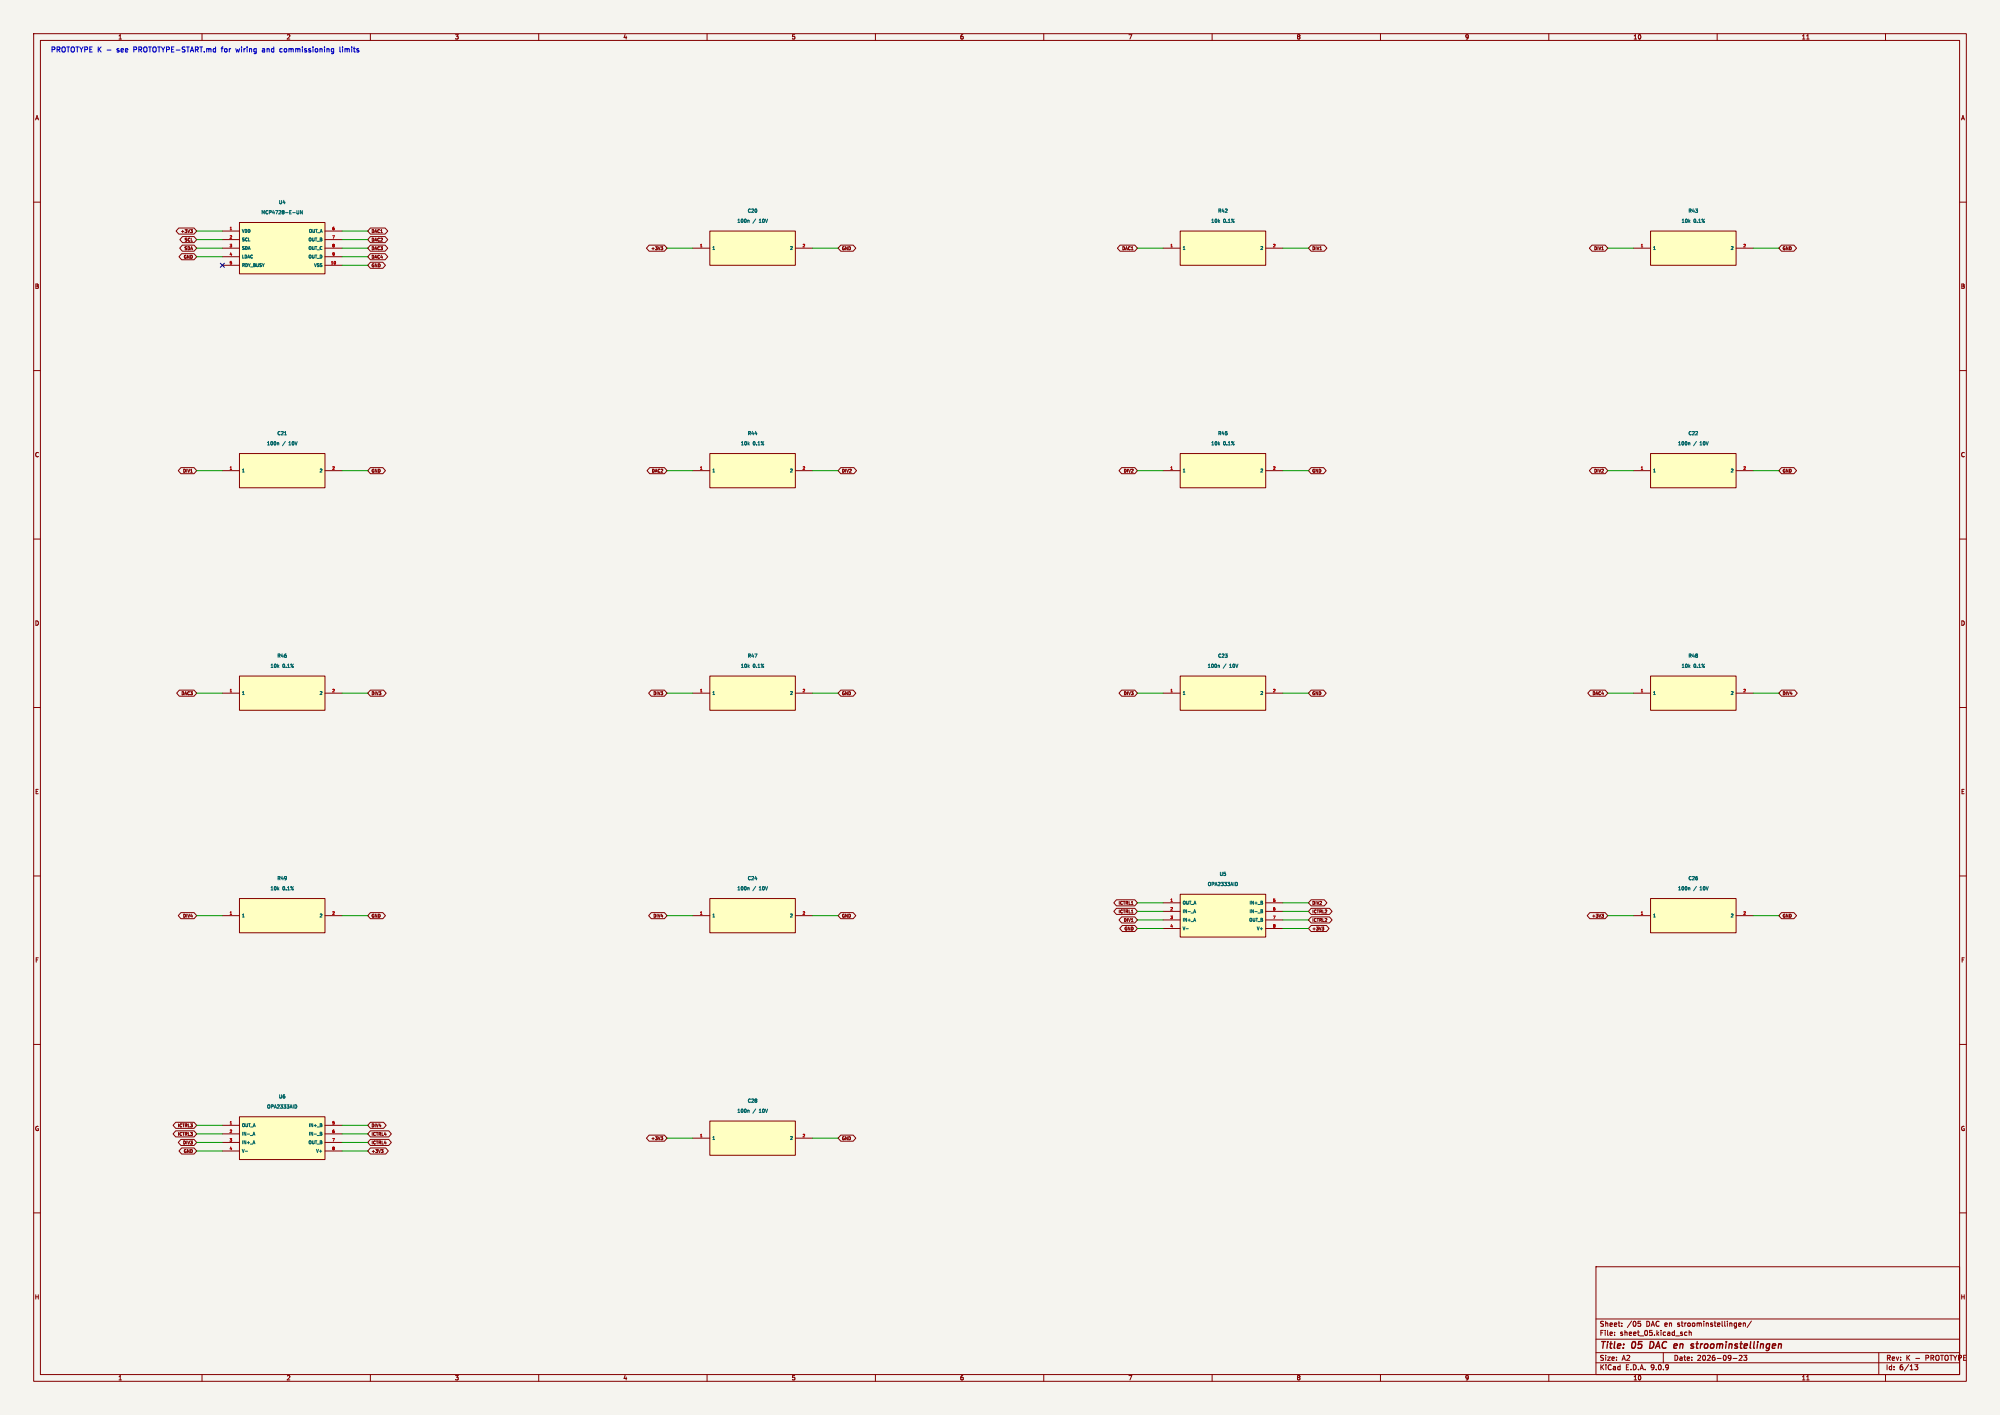
[picture p47: page 6]

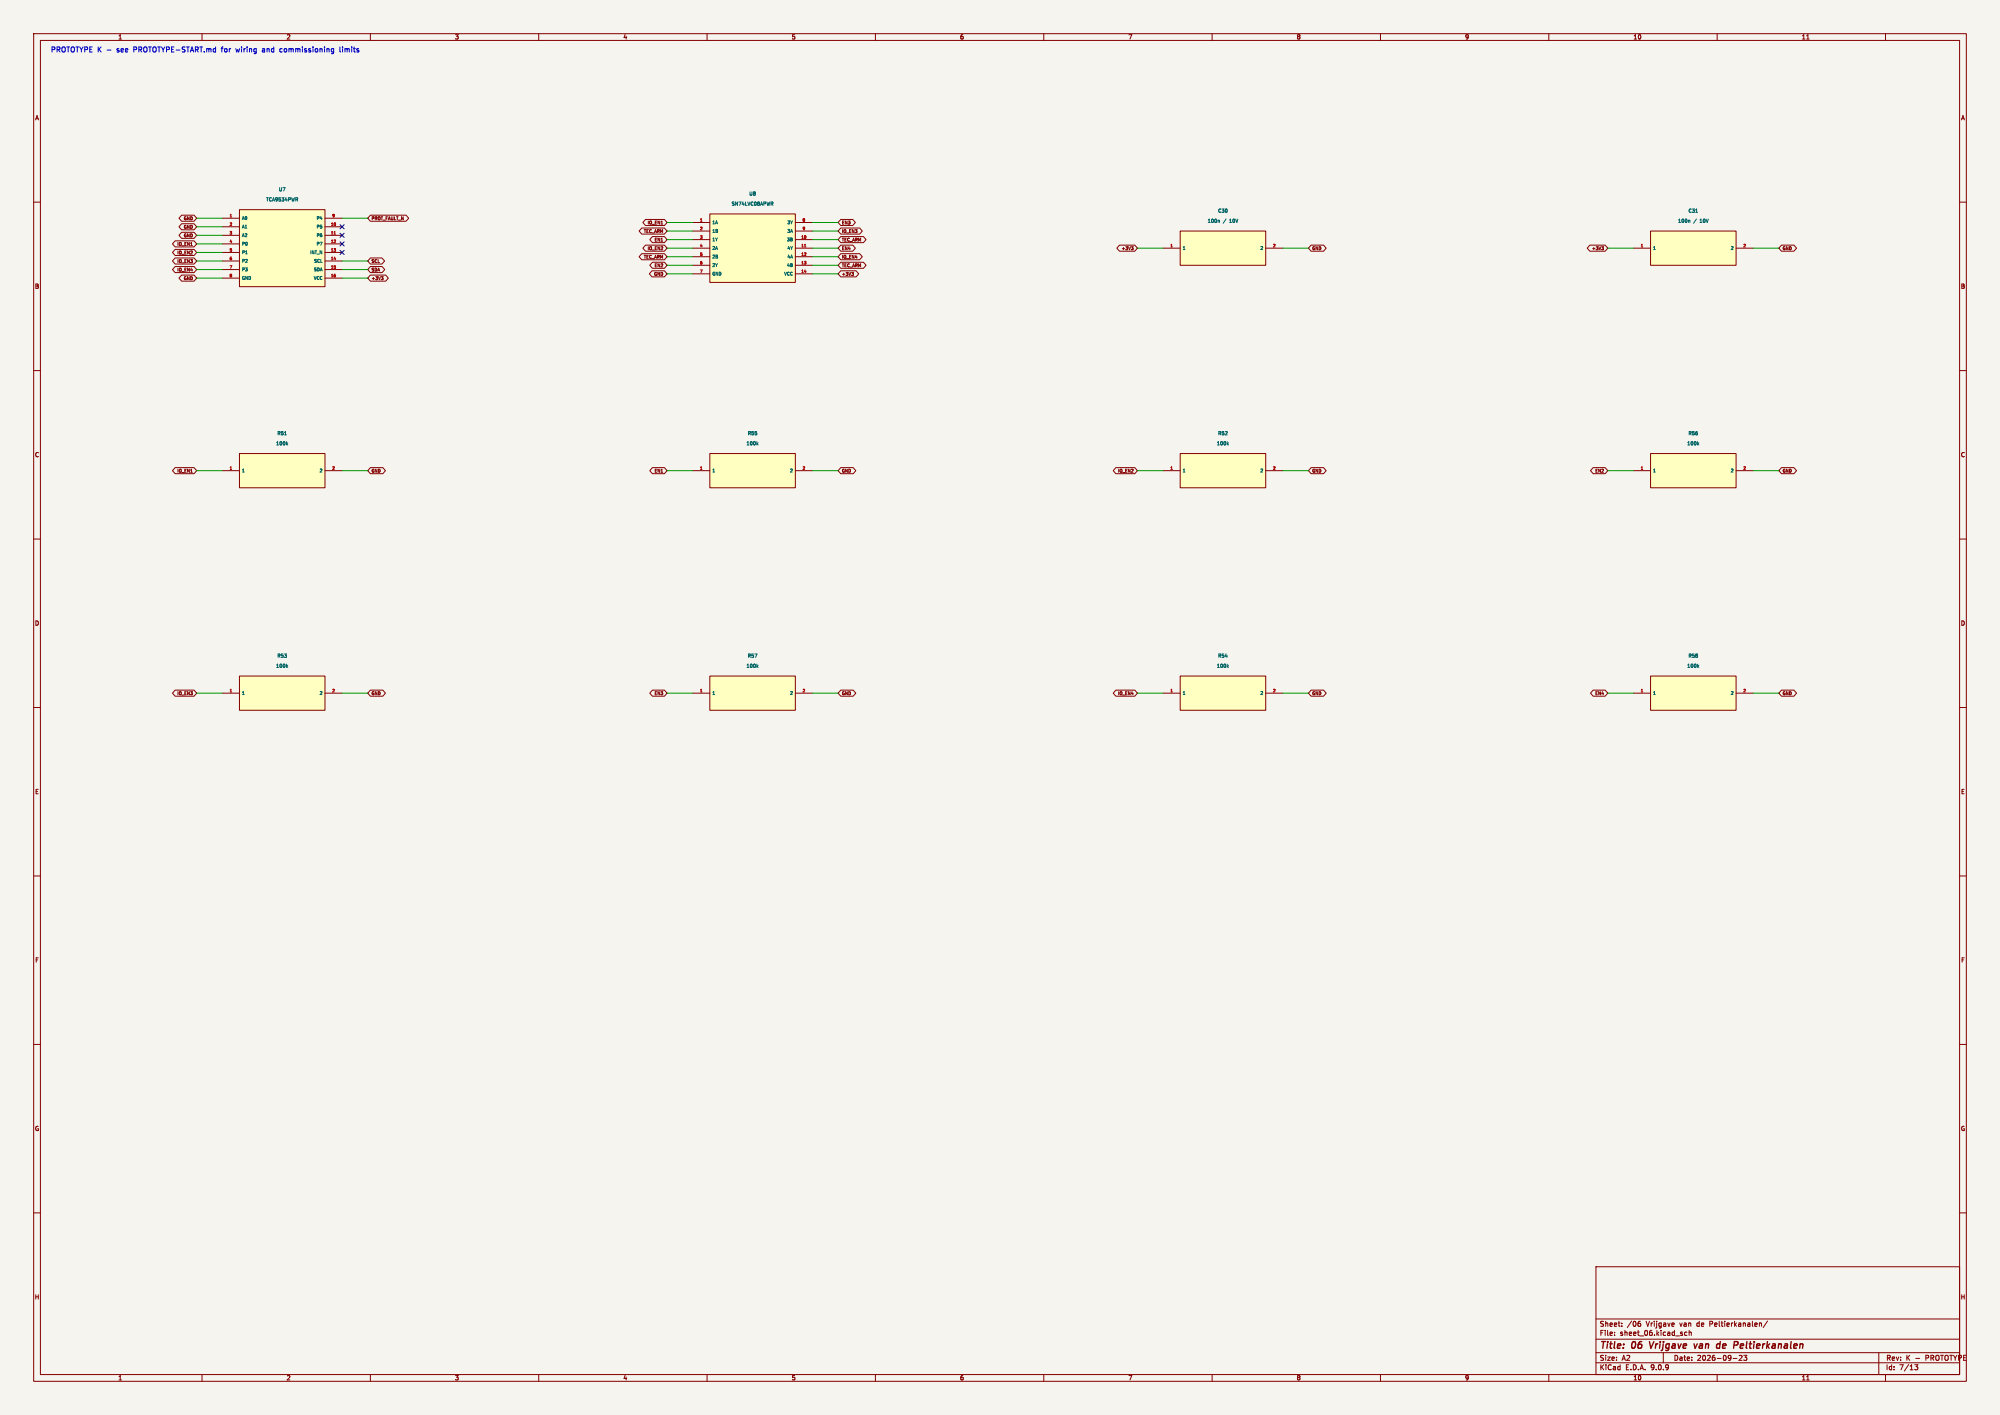
[picture p48: page 7]

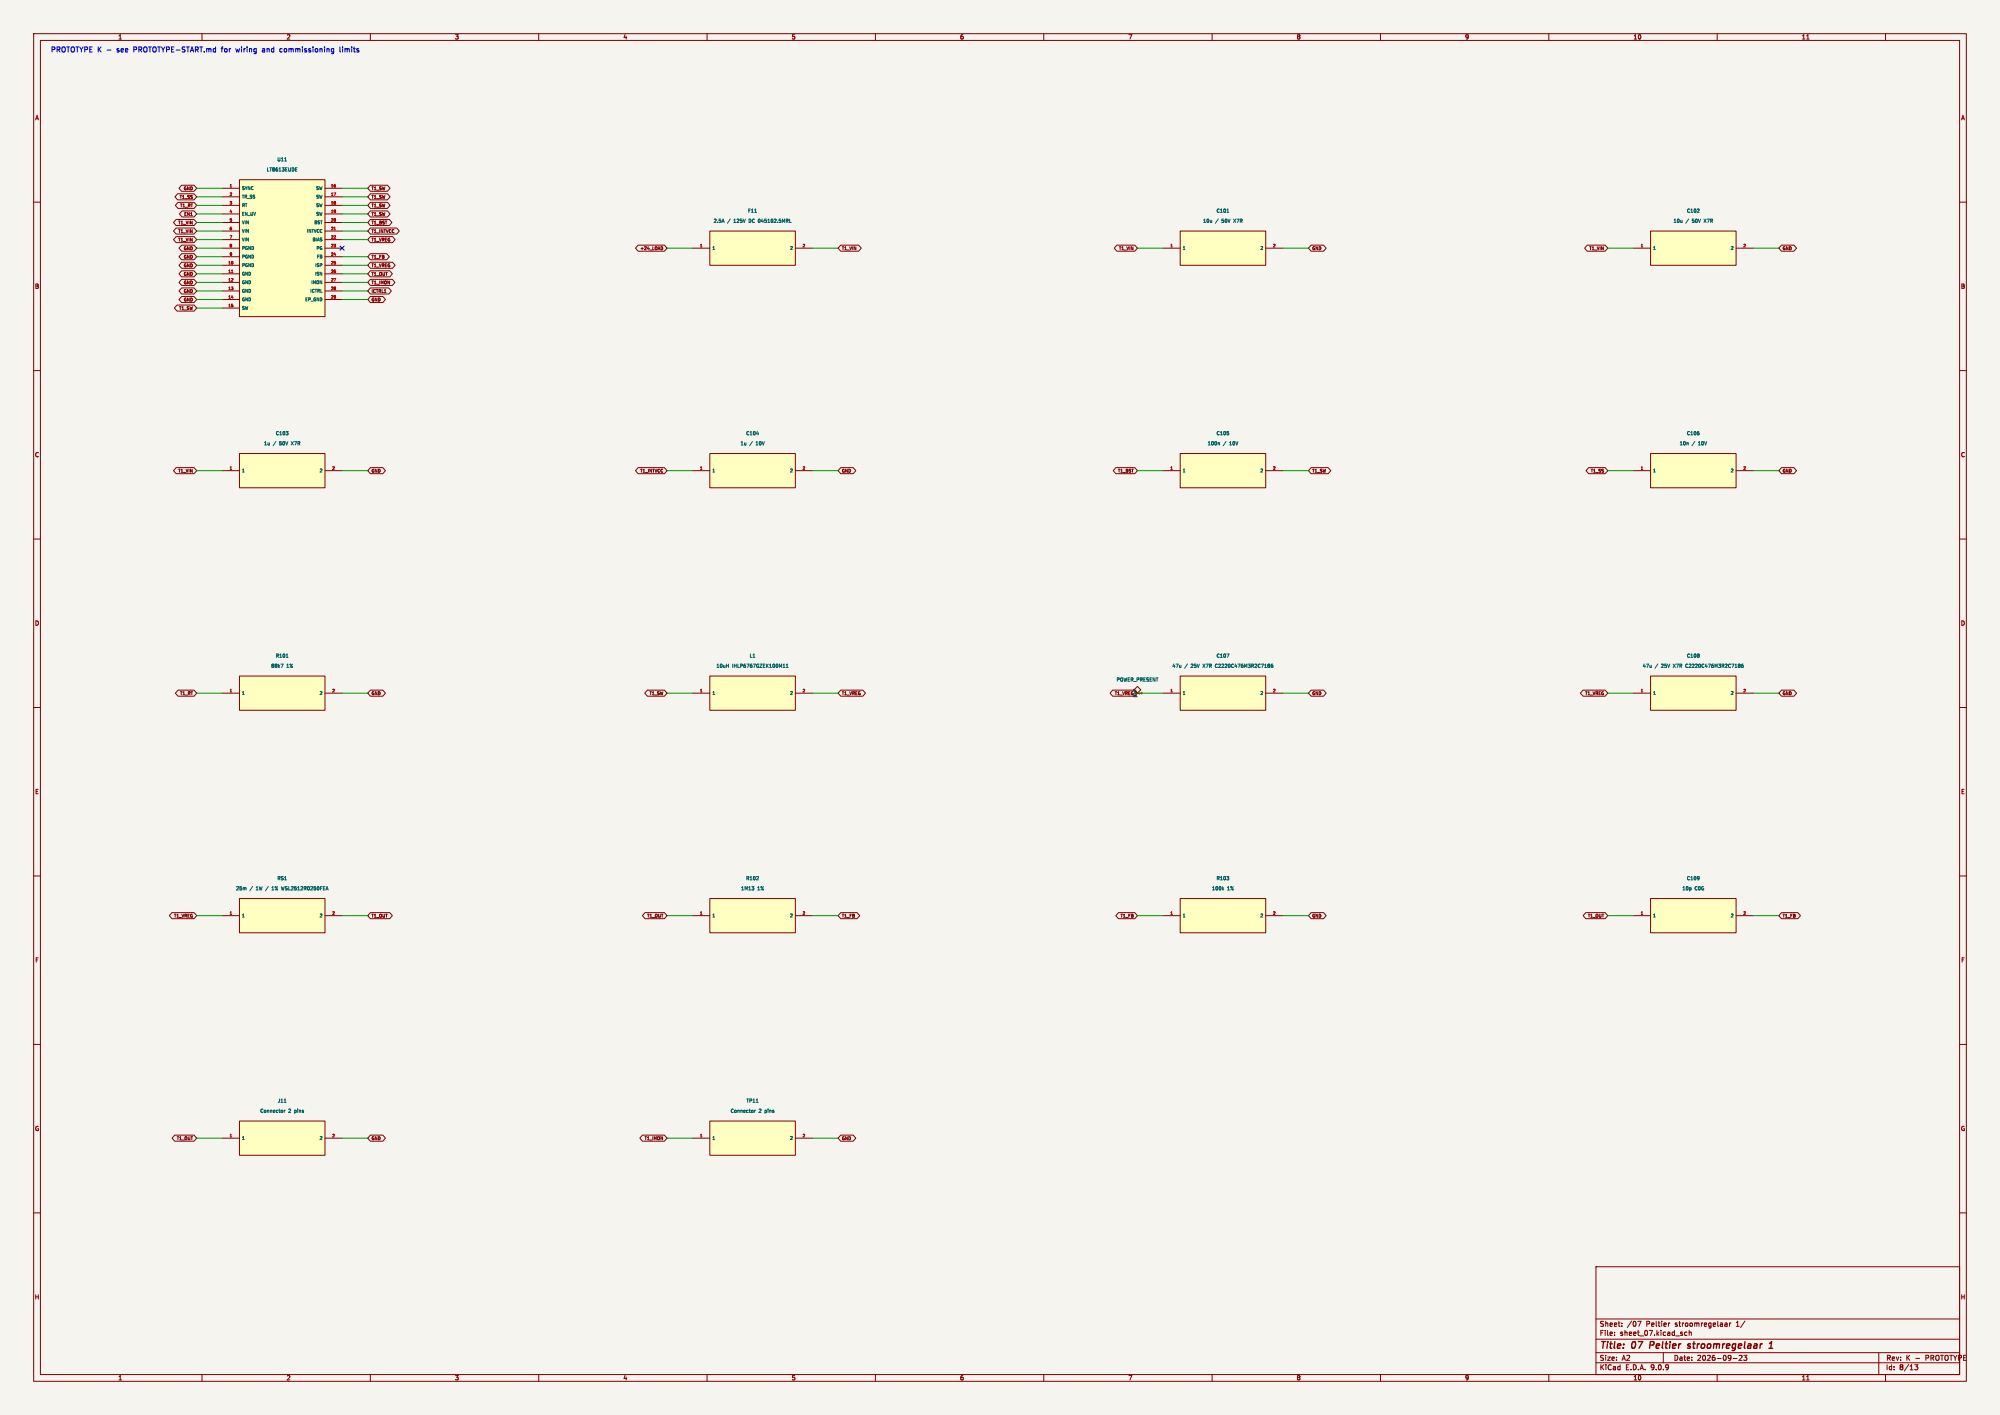
[picture p49: page 8]

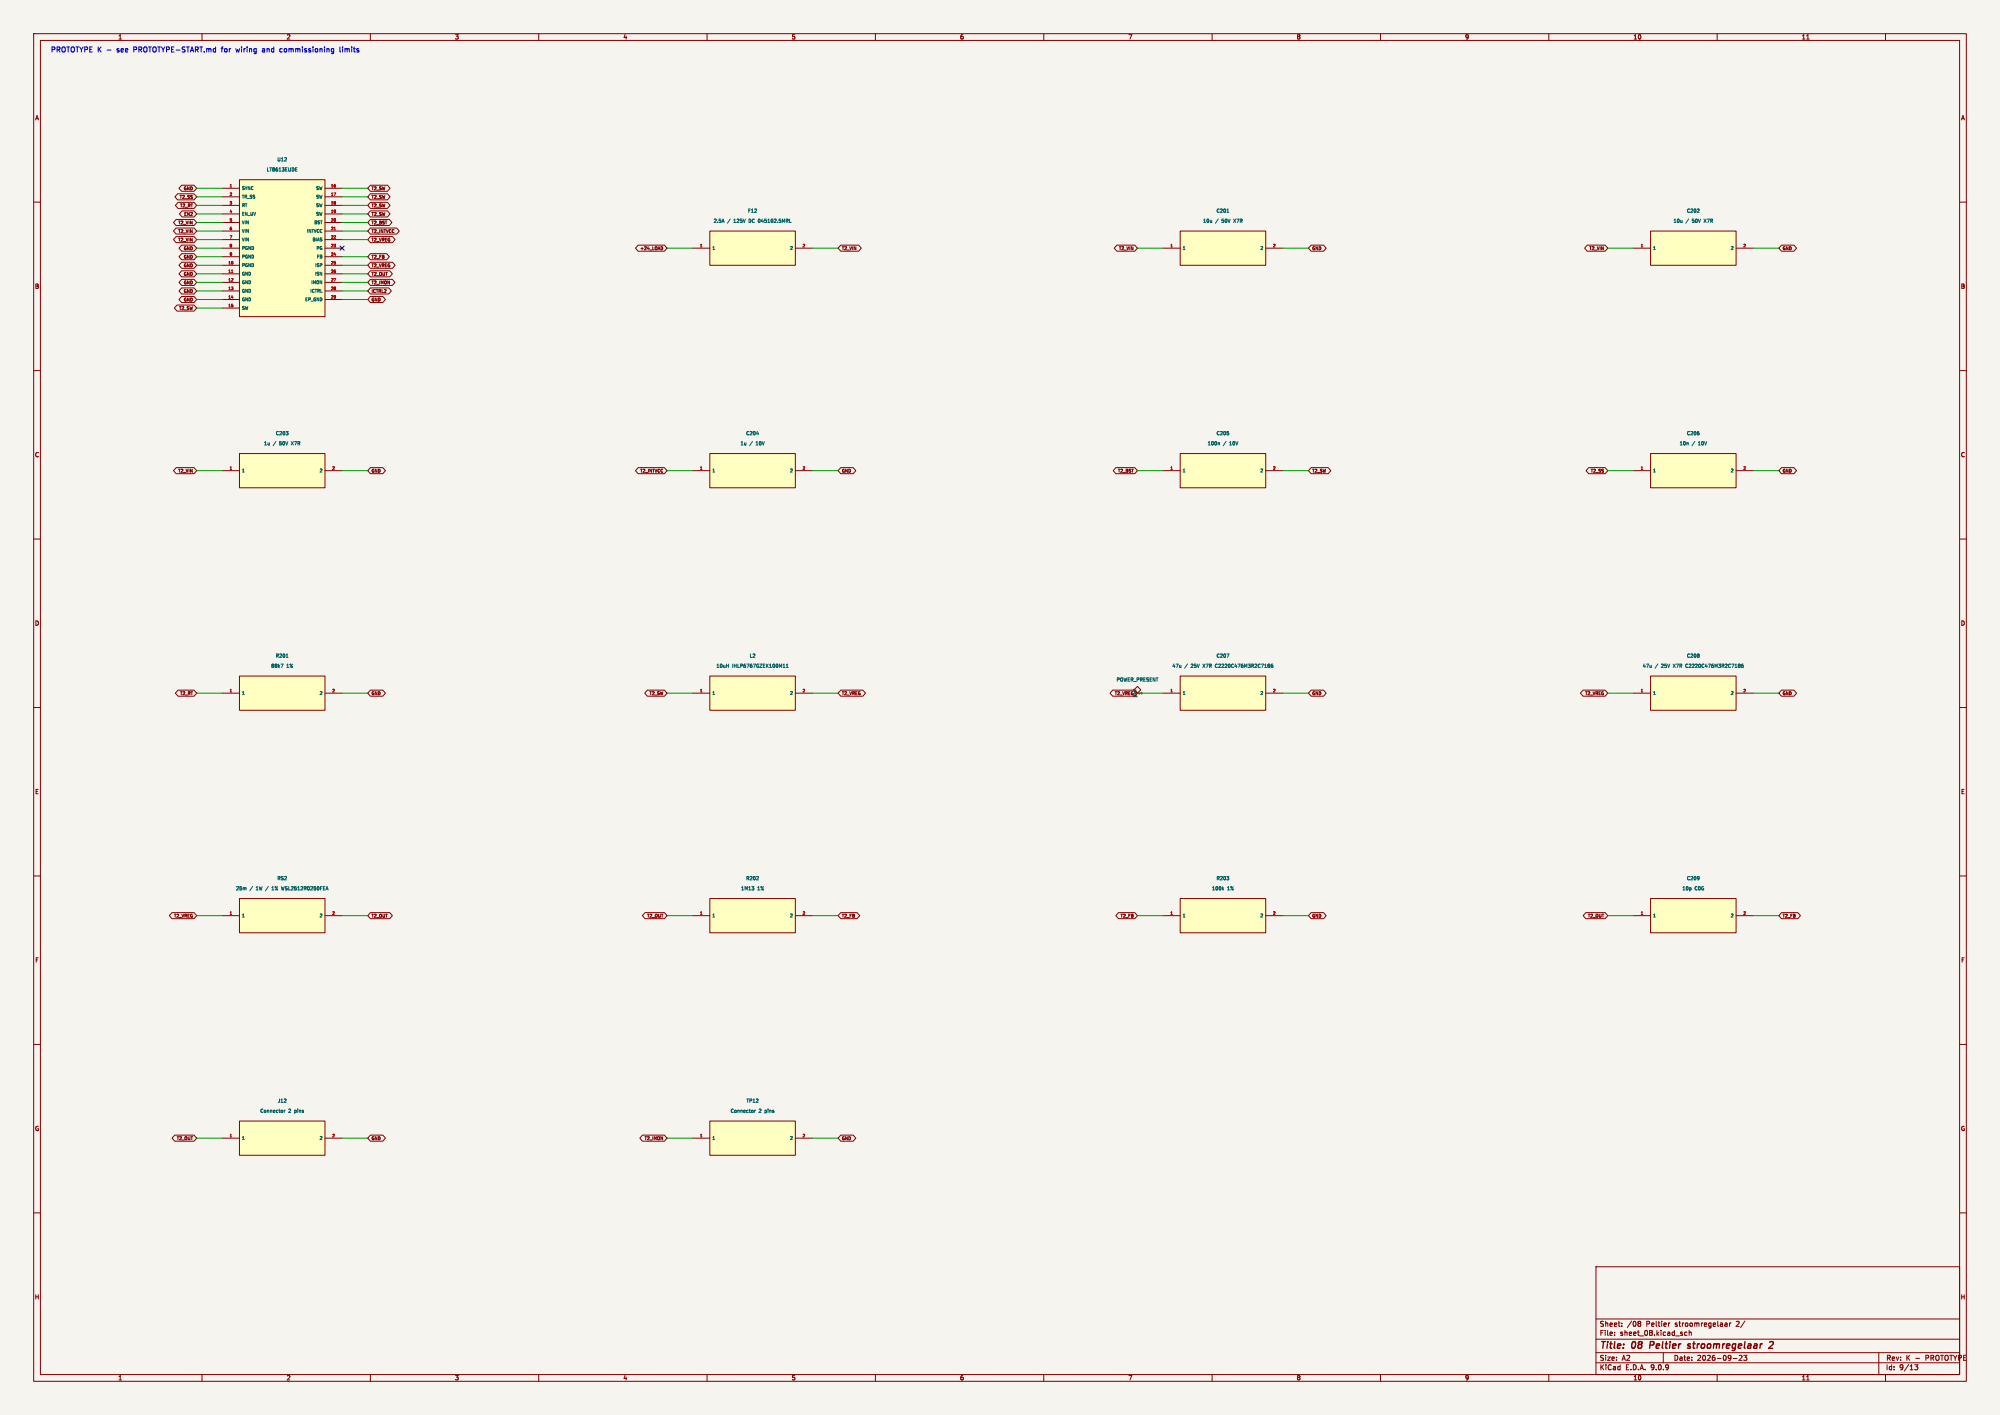
[picture p50: page 9]

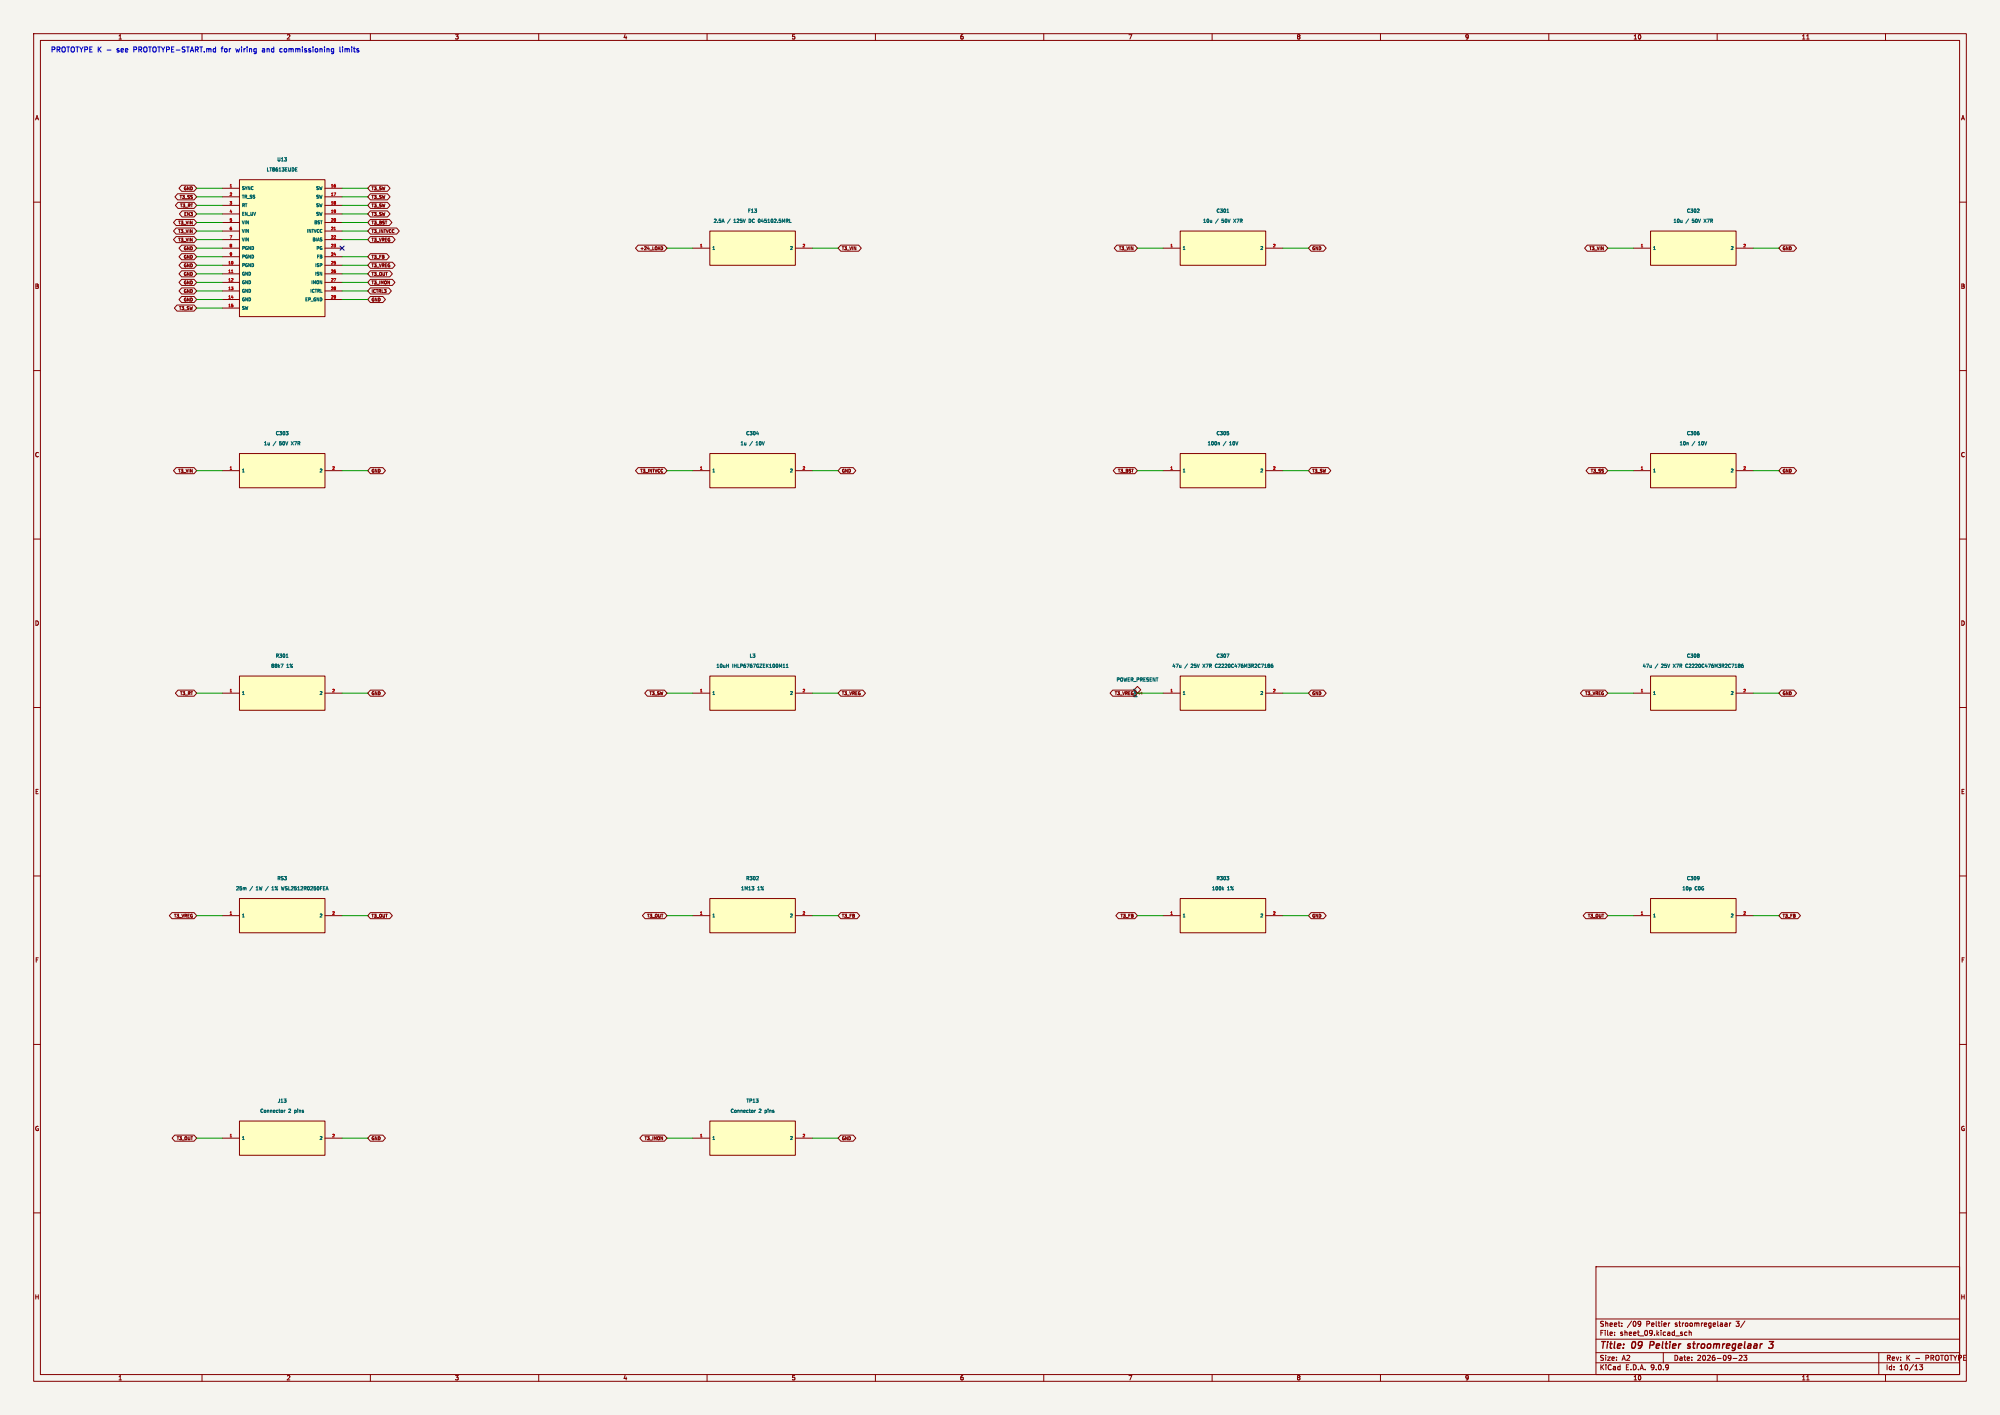
[picture p51: page 10]

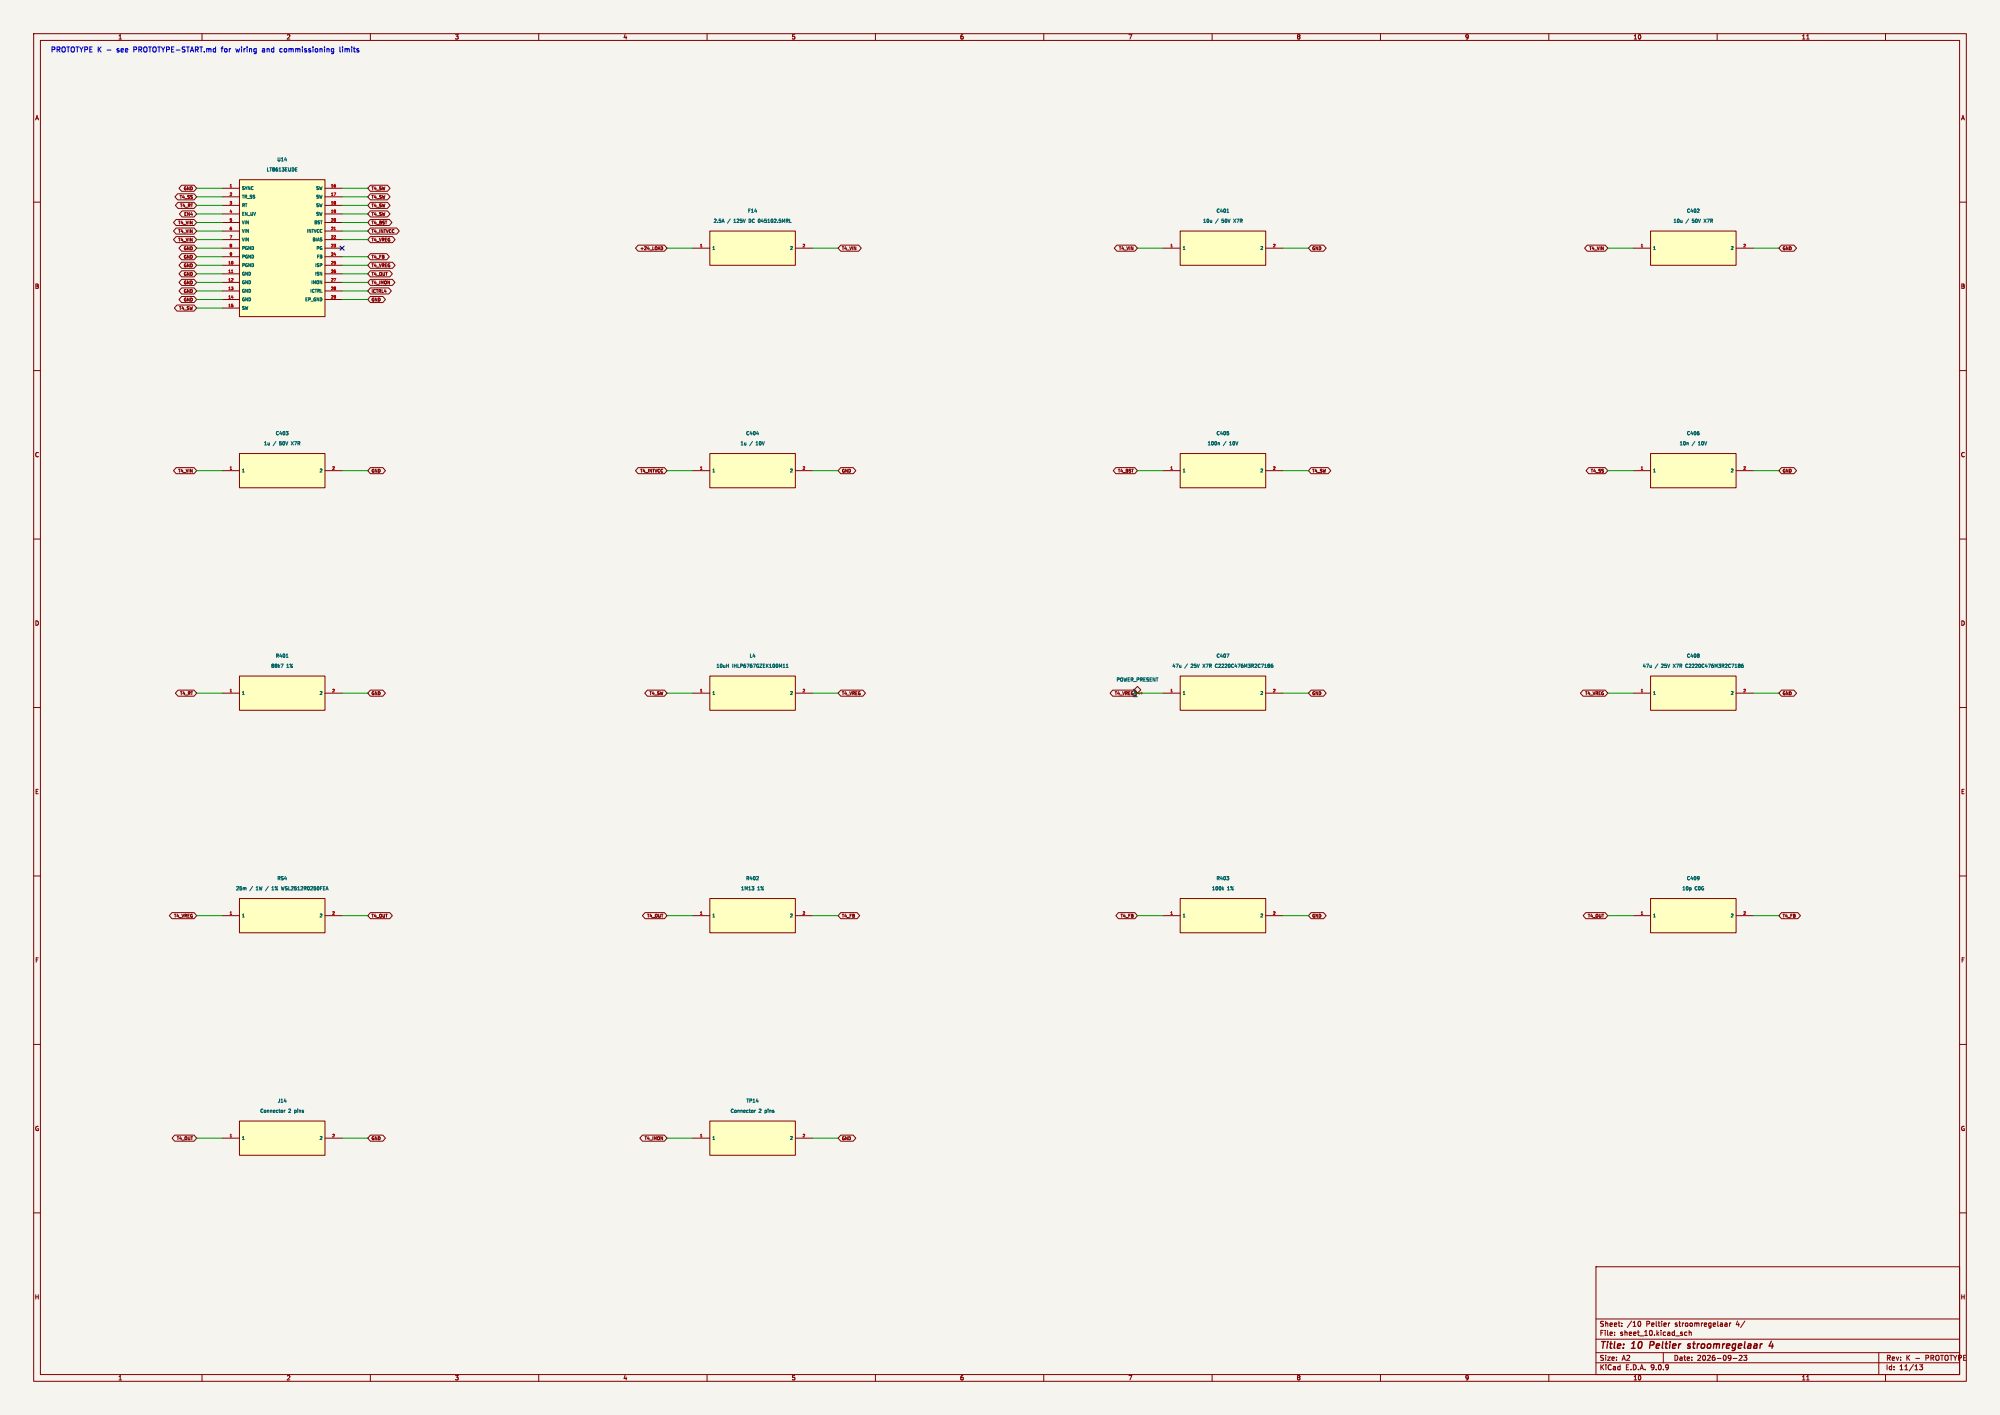
[picture p52: page 11]

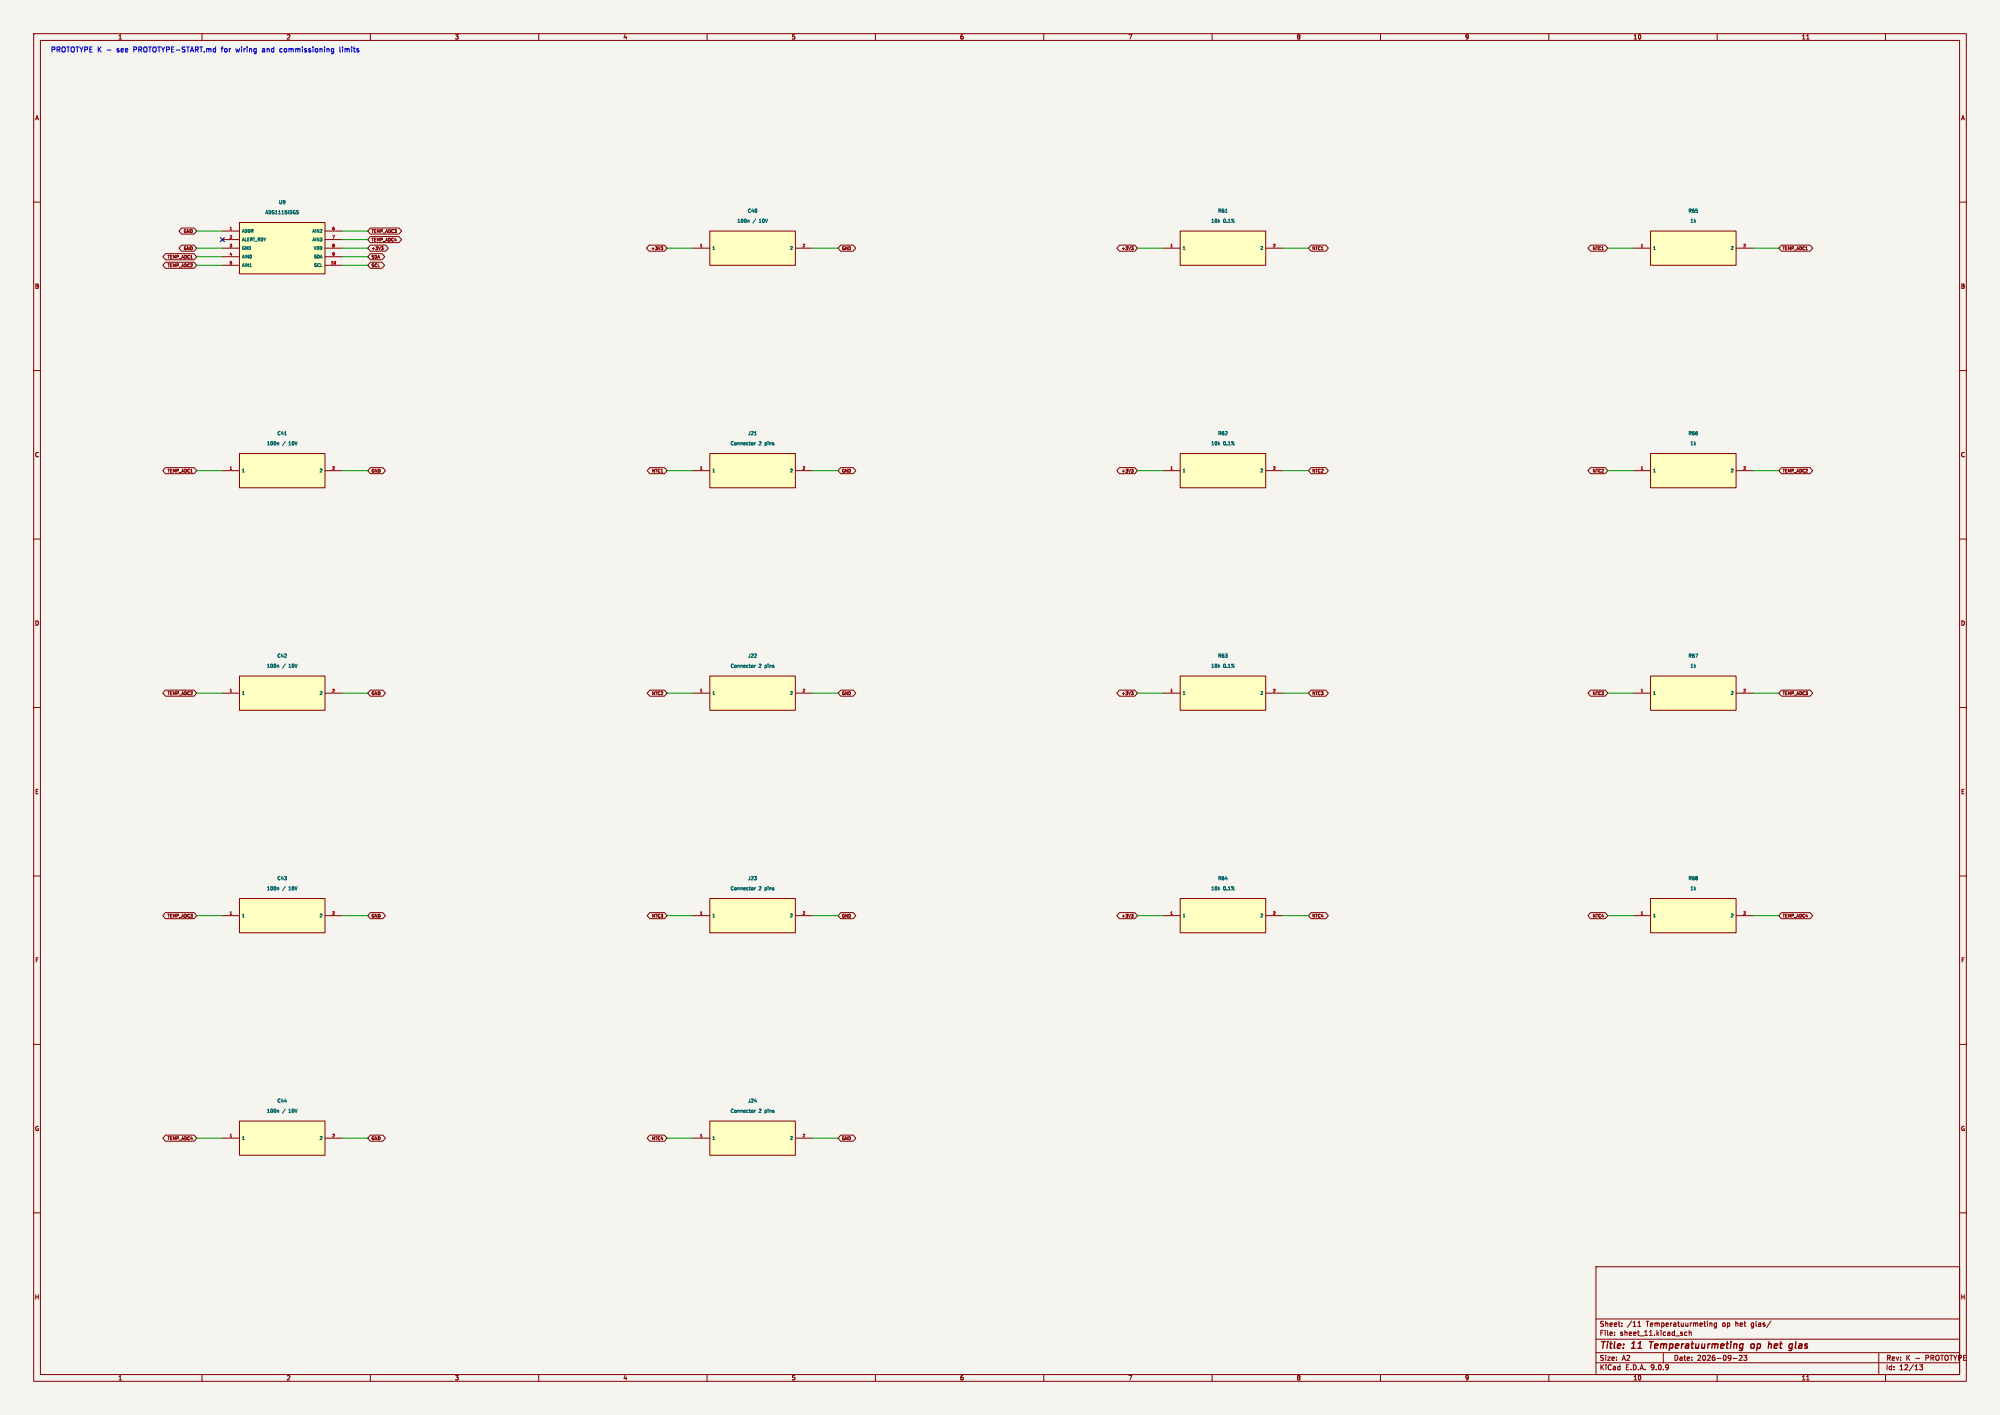
[picture p53: page 12]

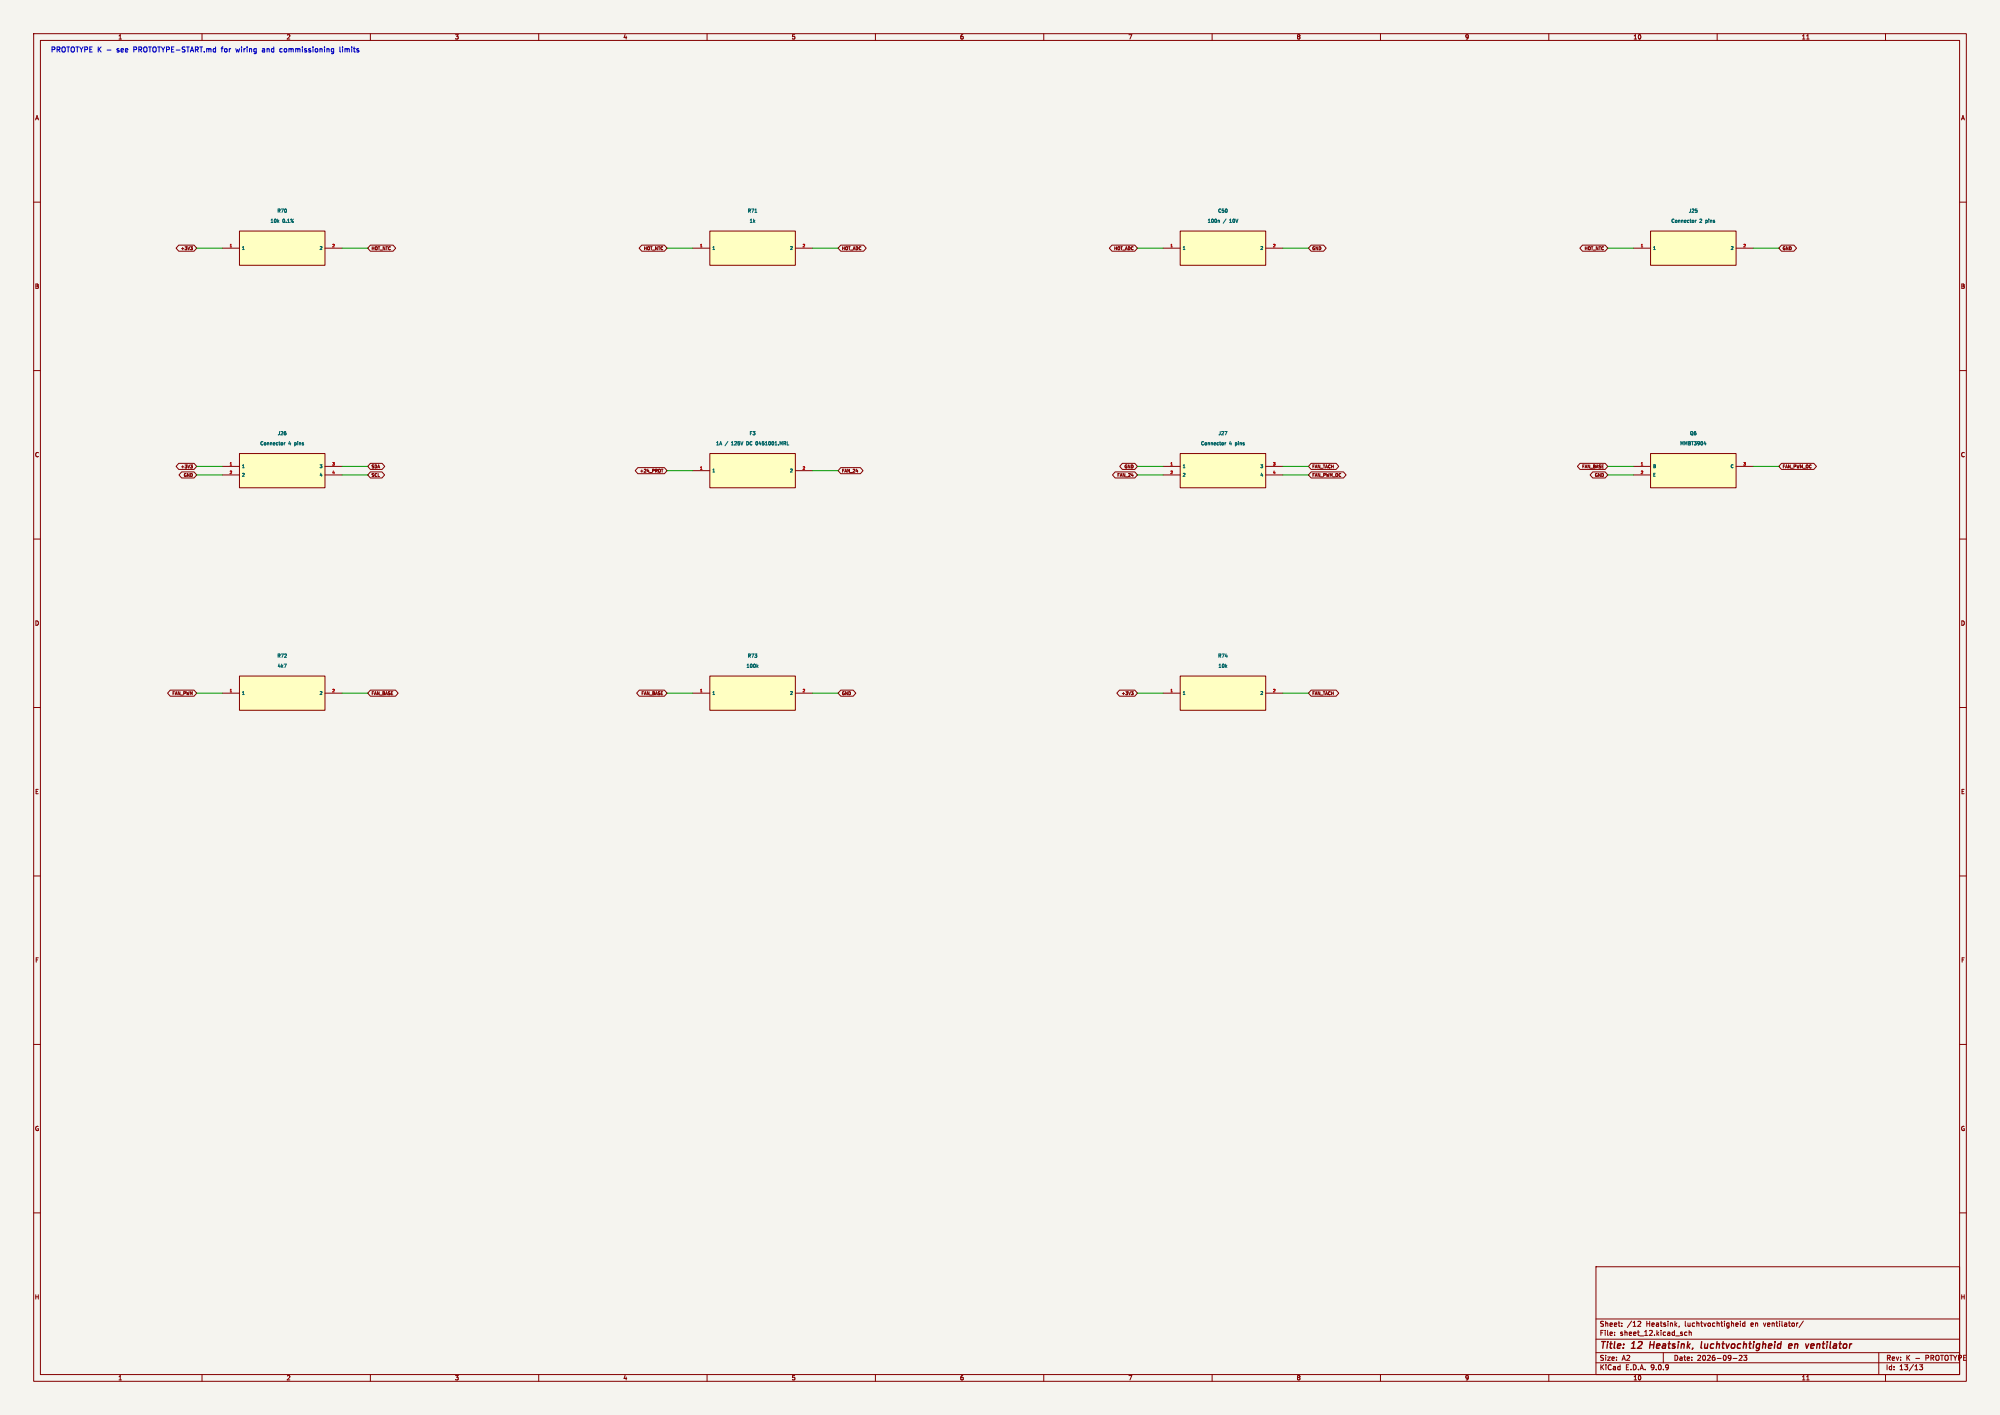
[picture p54: page 13]
