luciddreams/ito-controller/ito-controller-schema-rev-l.pdf

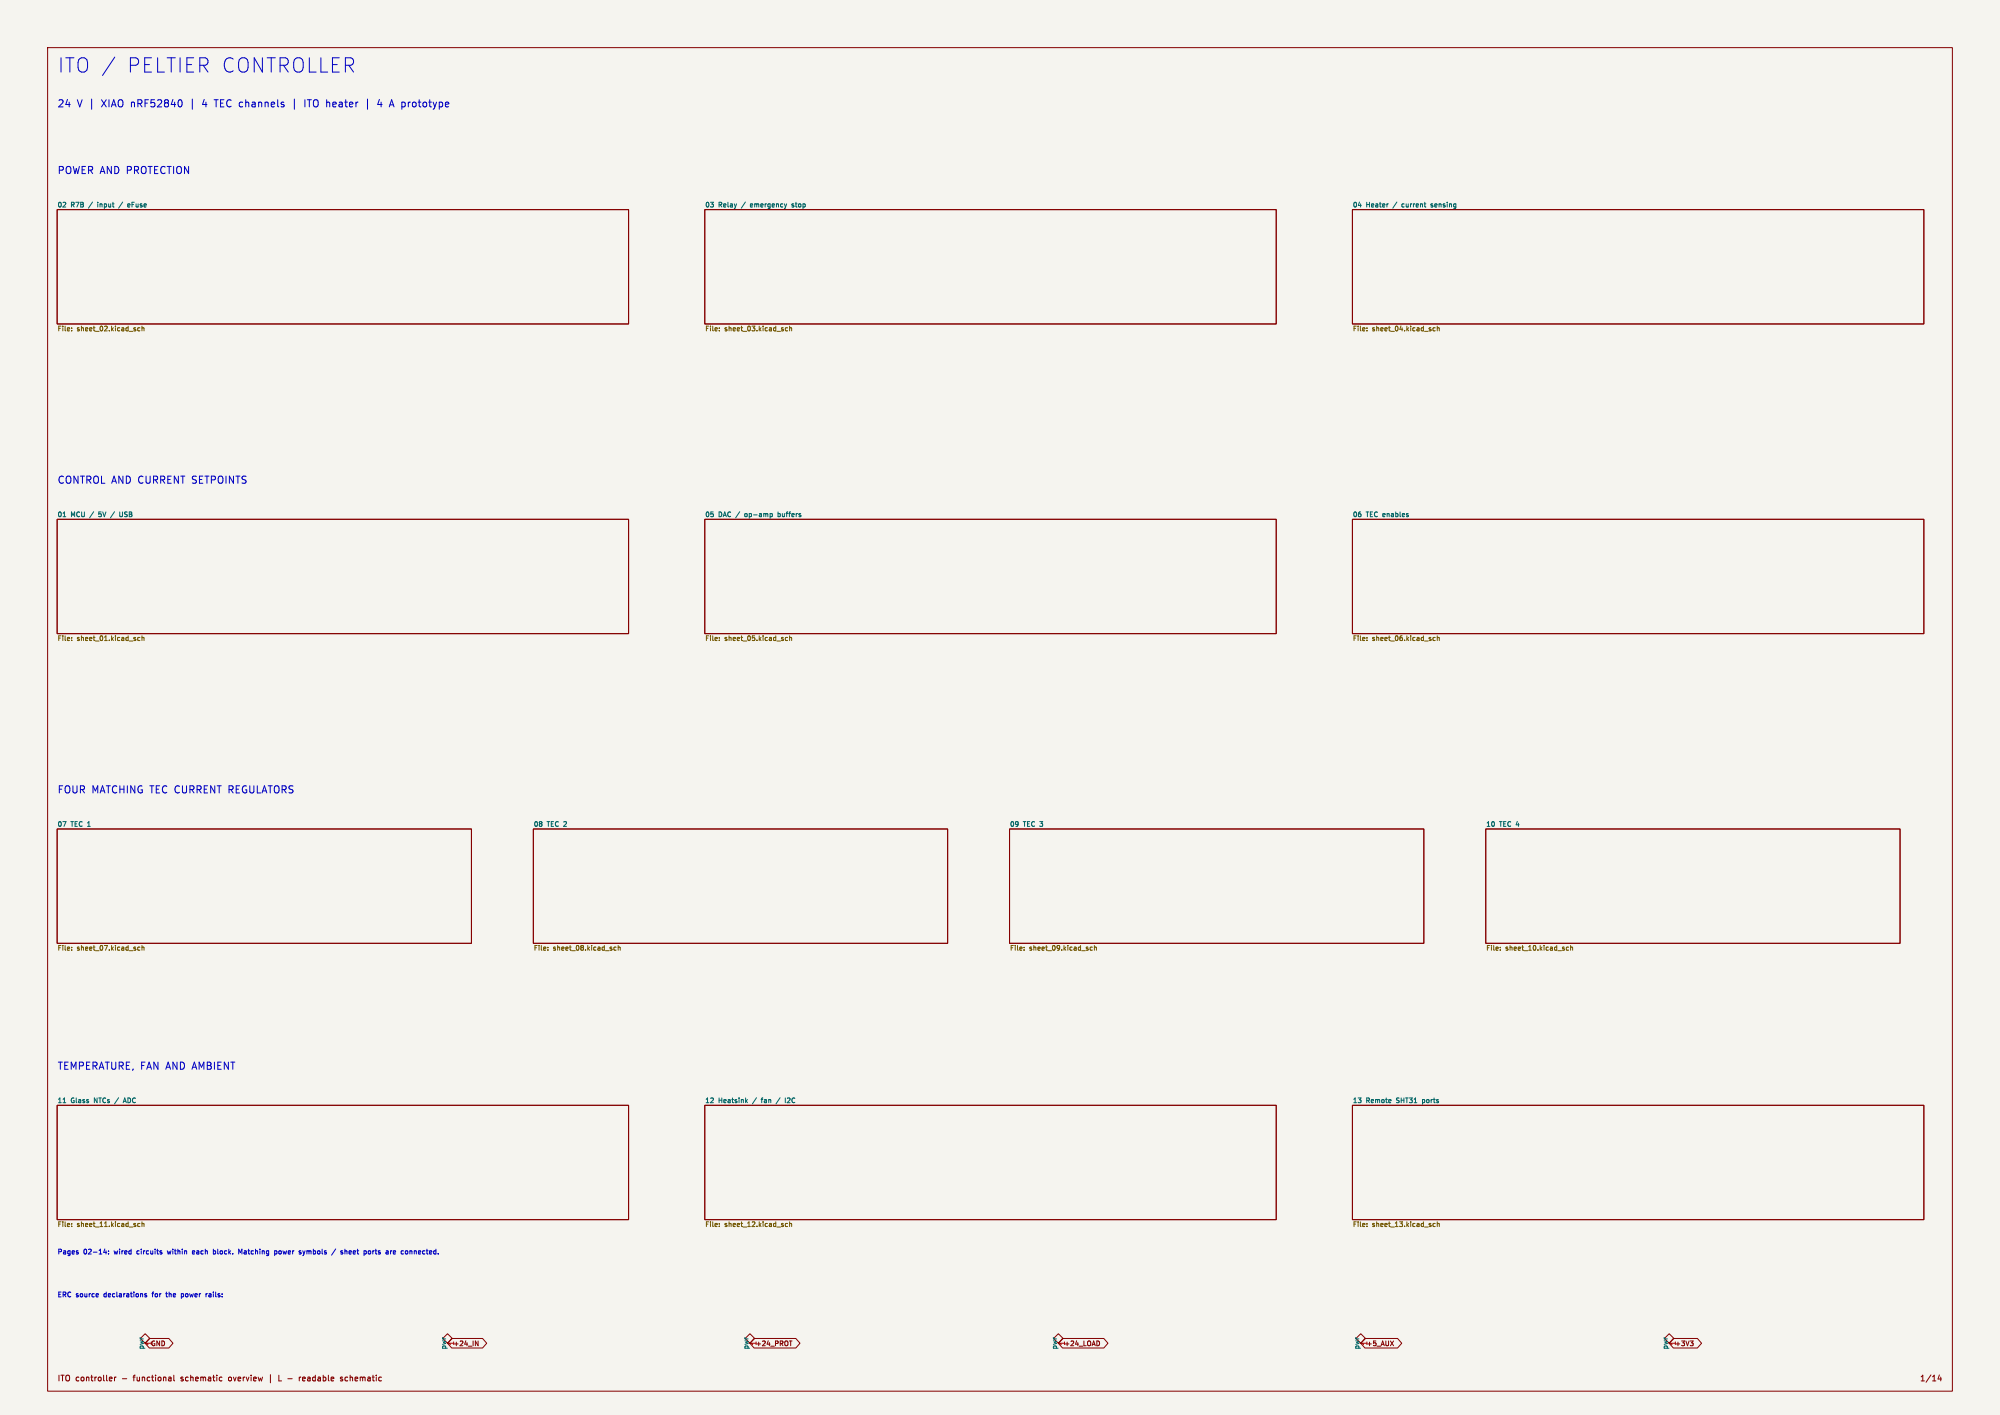
[picture p55: page 1]

CONTROL AND CURRENT SETPOINTS

FOUR MATCHING TEC CURRENT REGULATORS

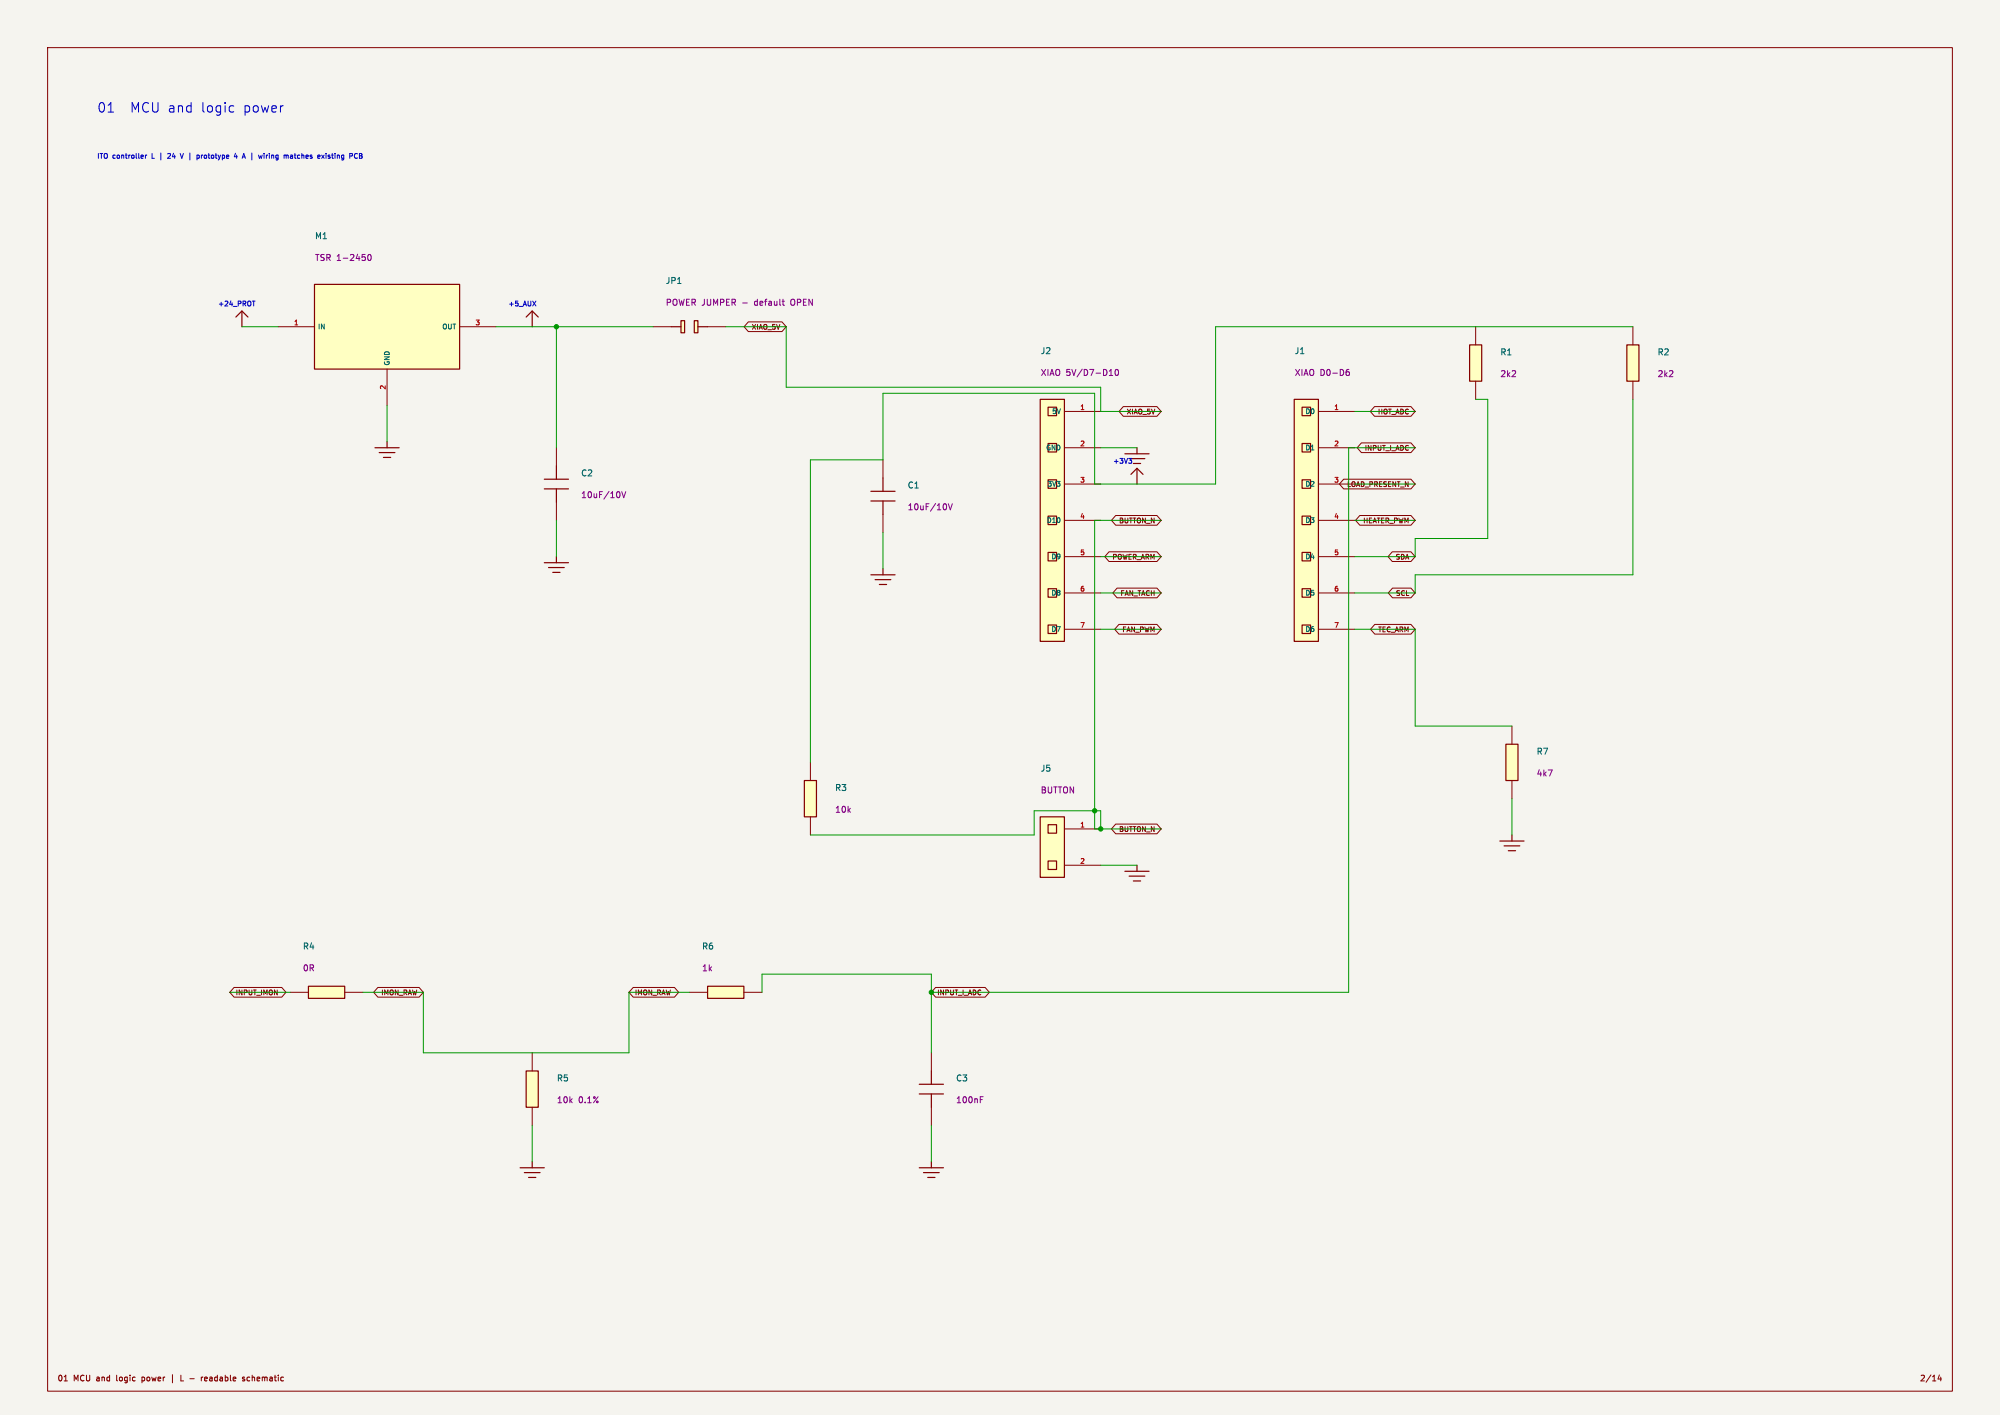
[picture p56: page 2]

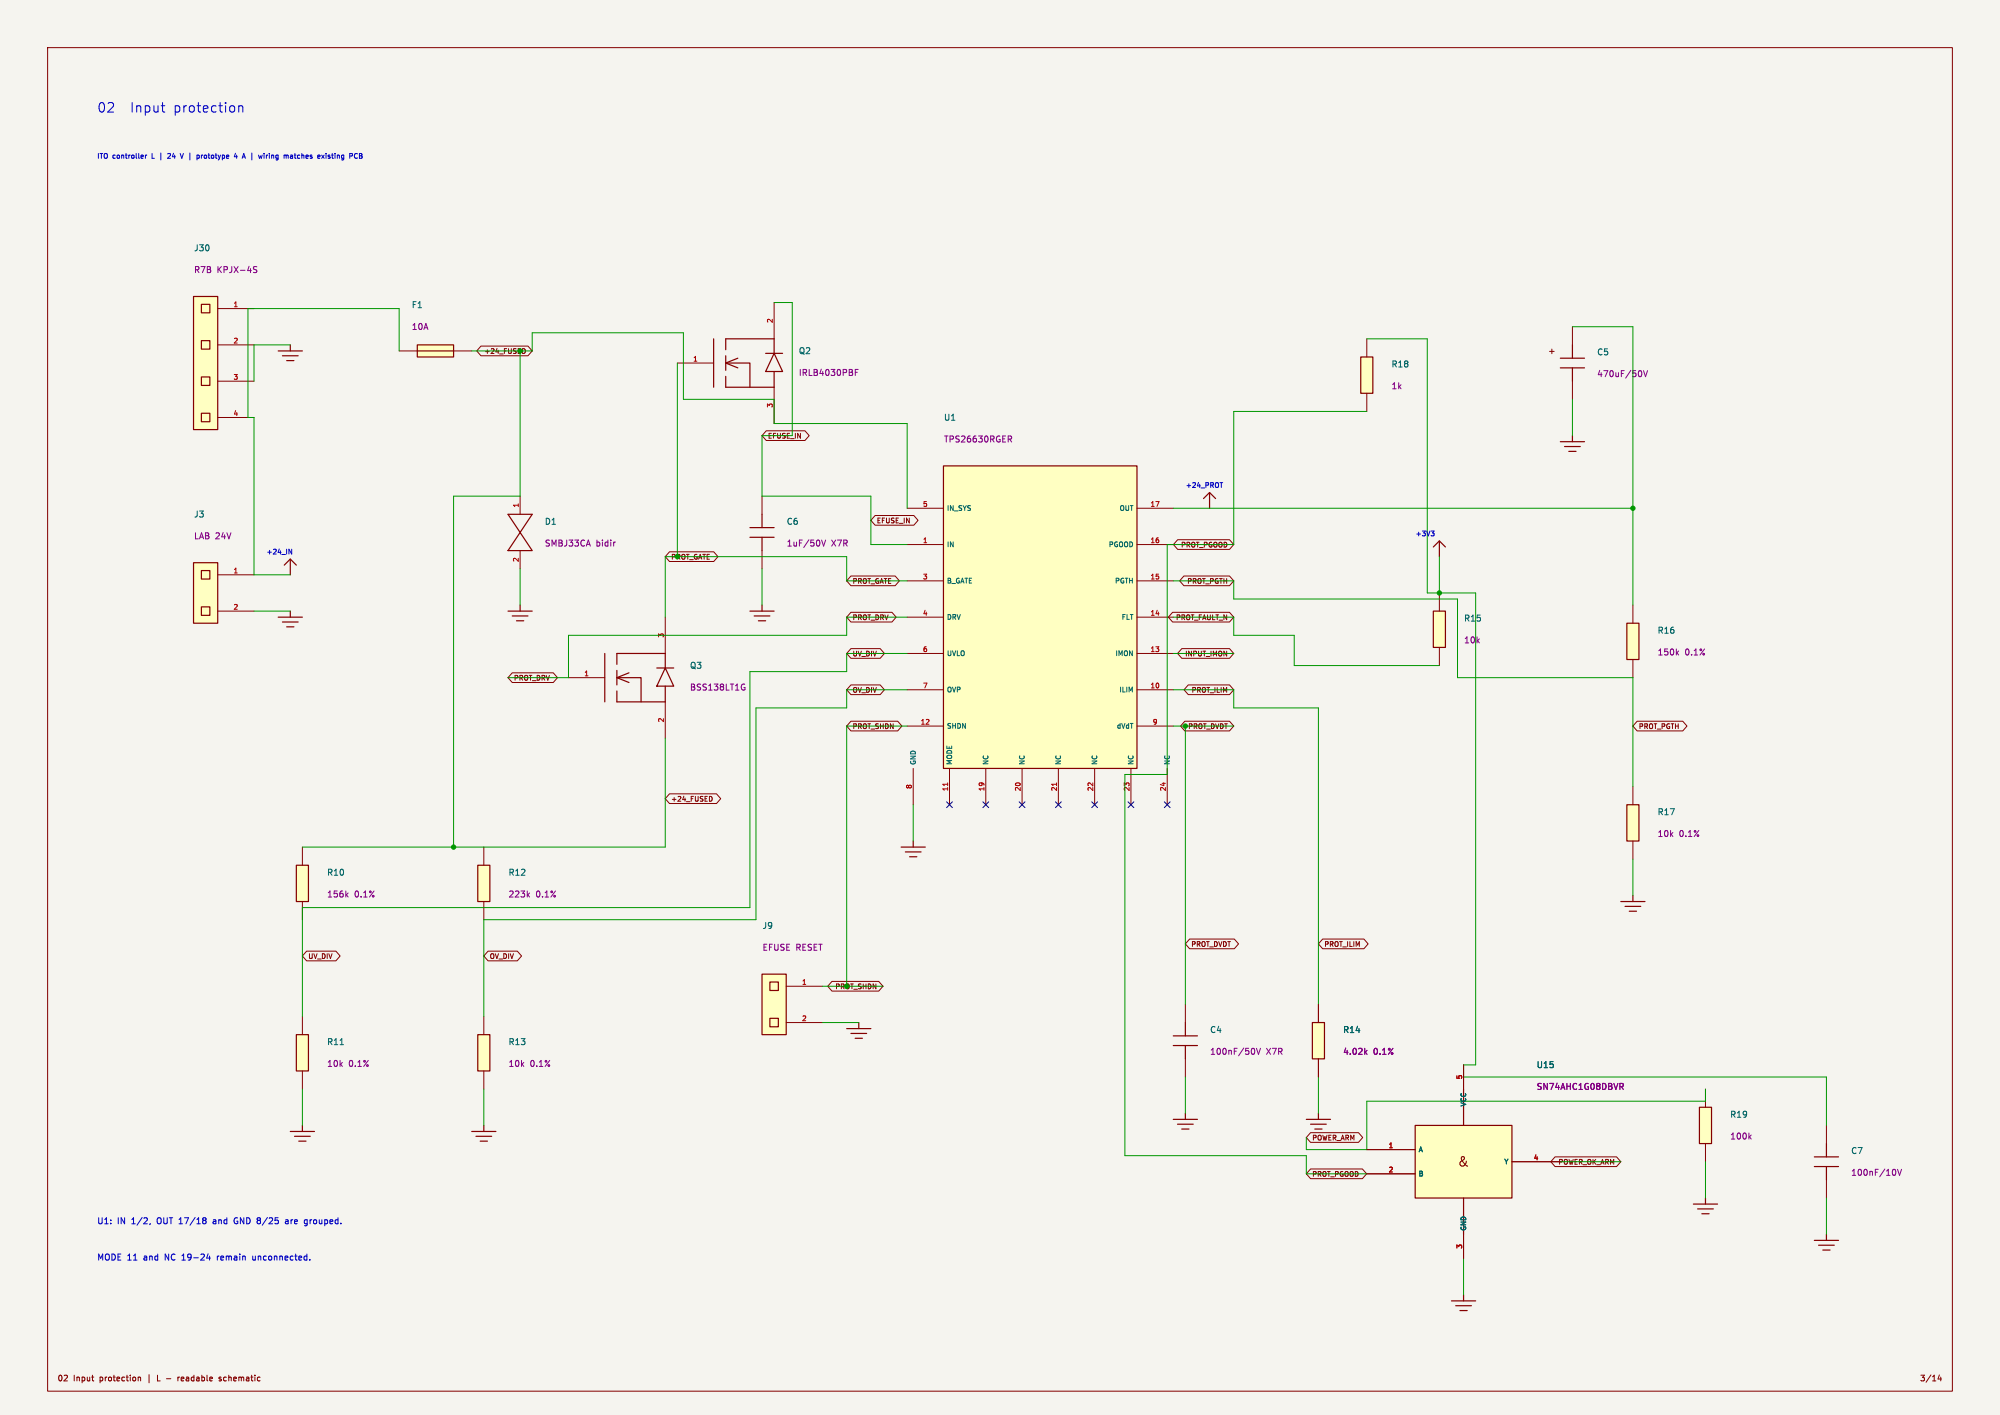
[picture p57: page 3]

8 MODE 11 NC 19 NC 20 NC 21 NC 22 NC 23 NC 24 OUT 17 PGOOD 16 PGTH 15 FLT 14

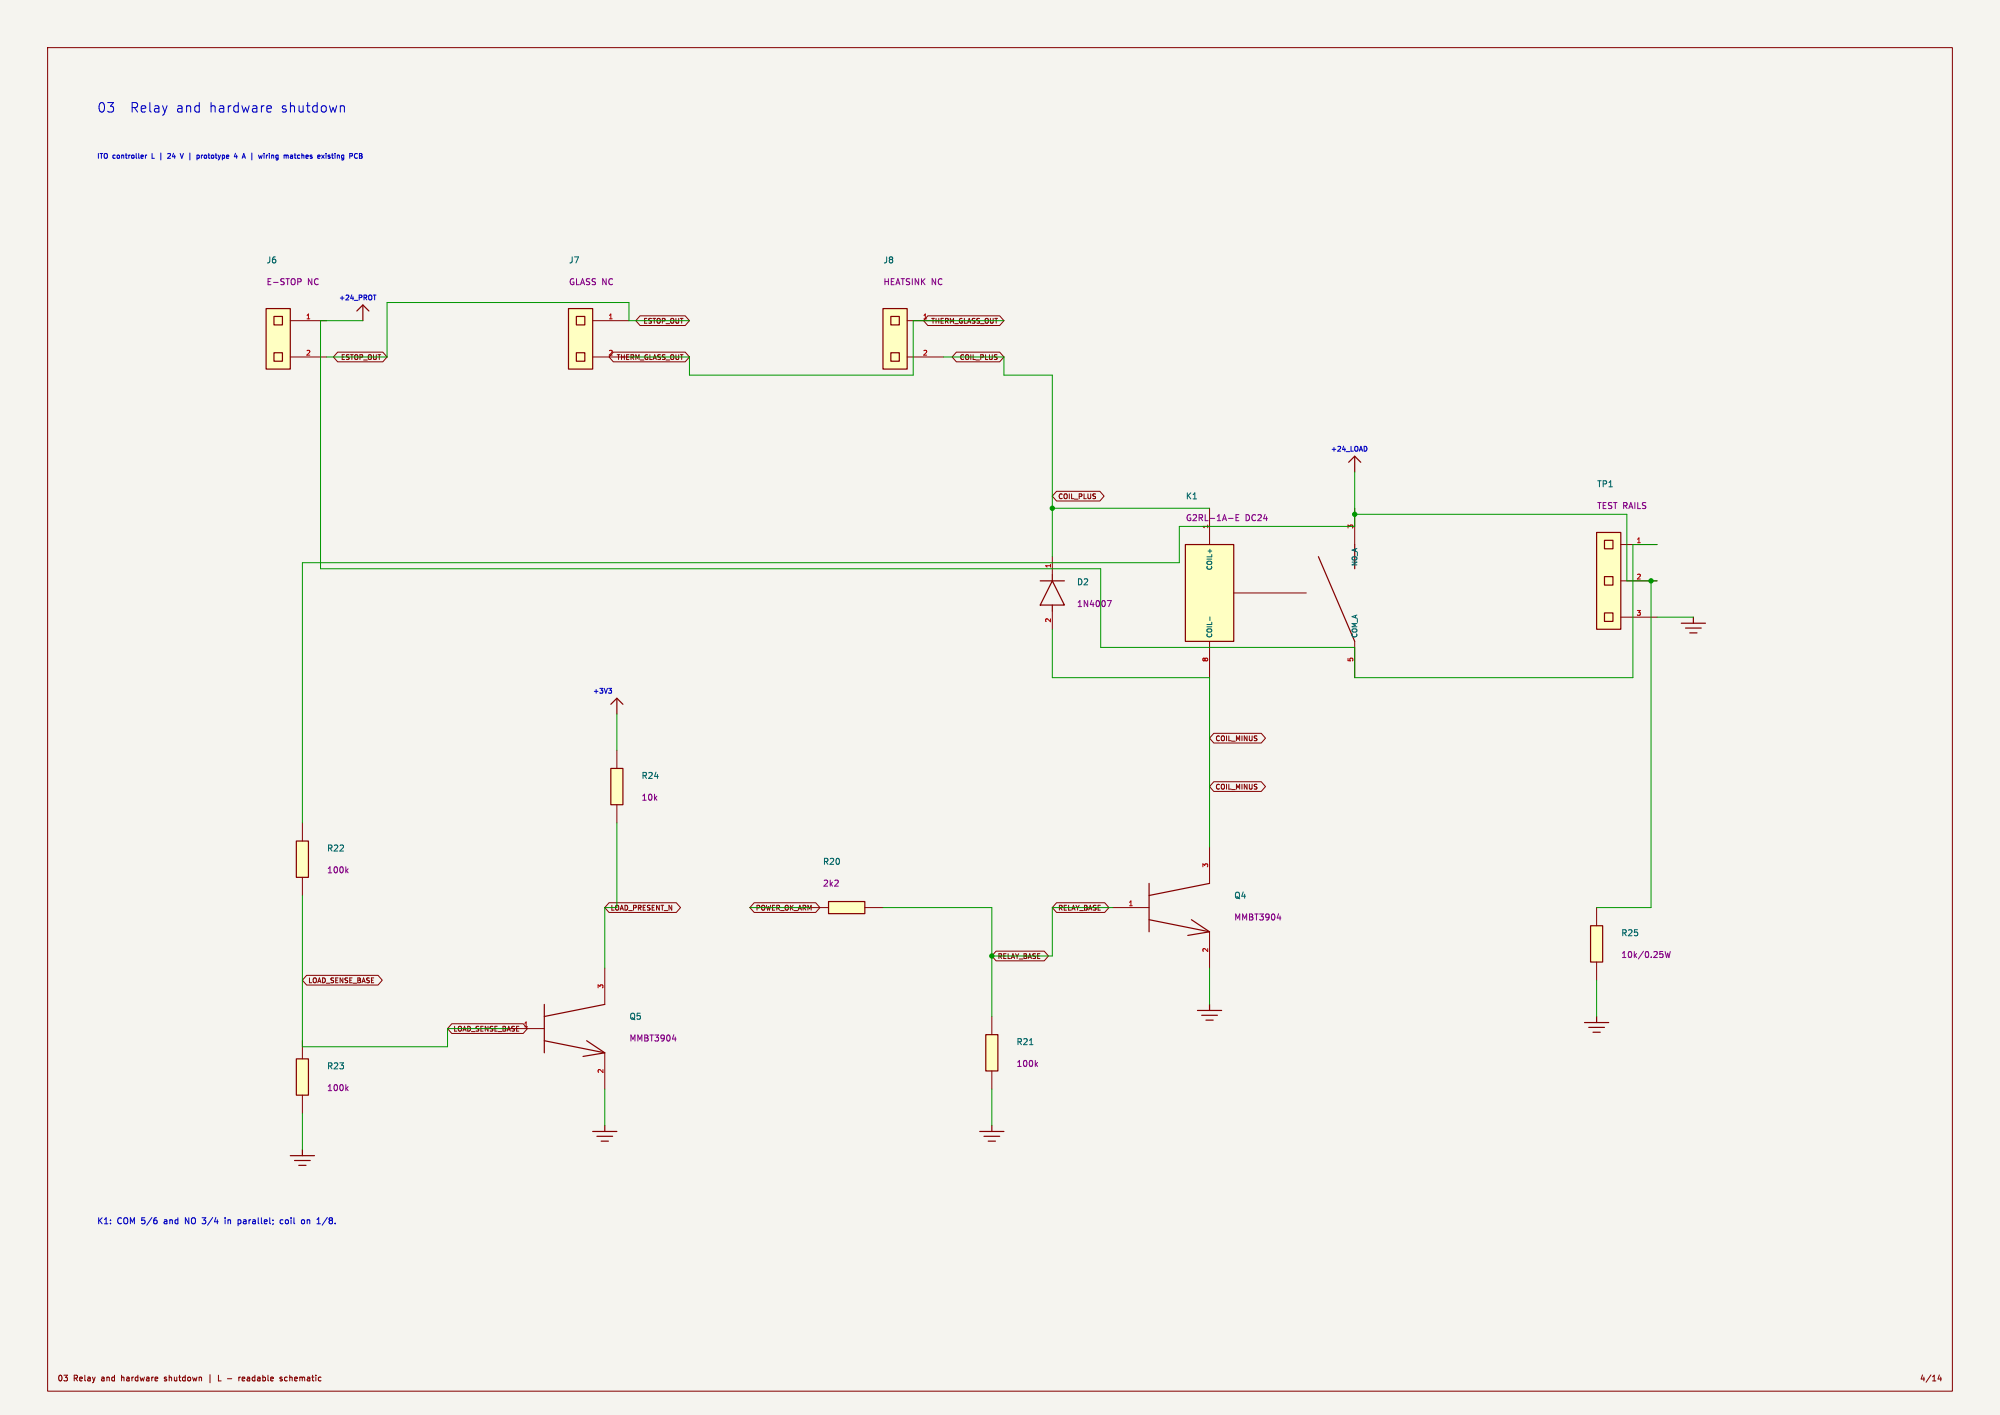
[picture p58: page 4]

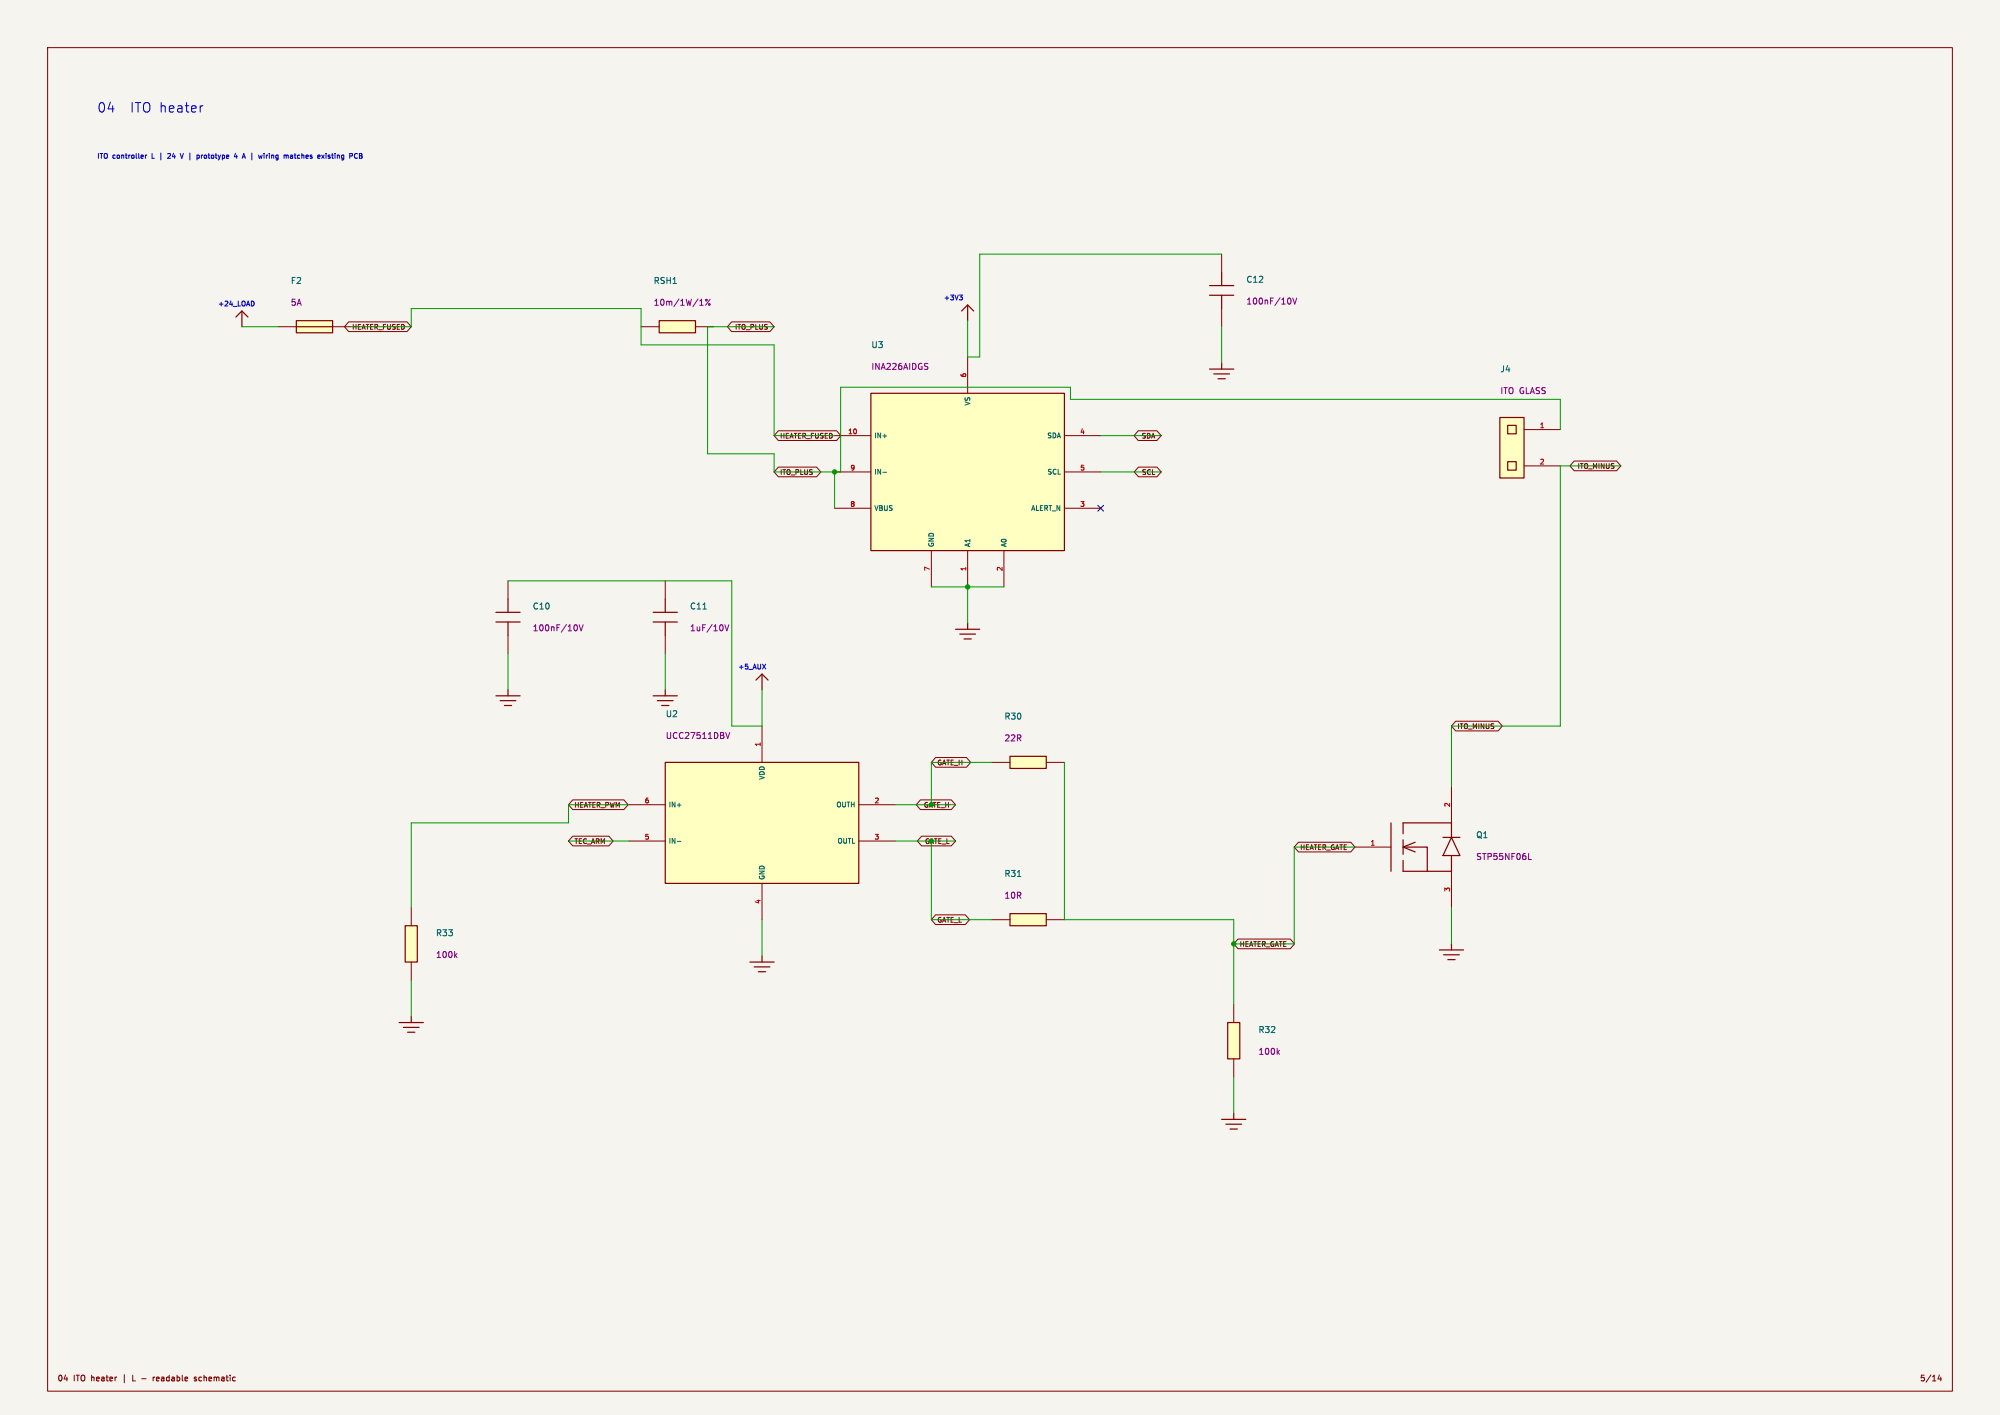
[picture p59: page 5]

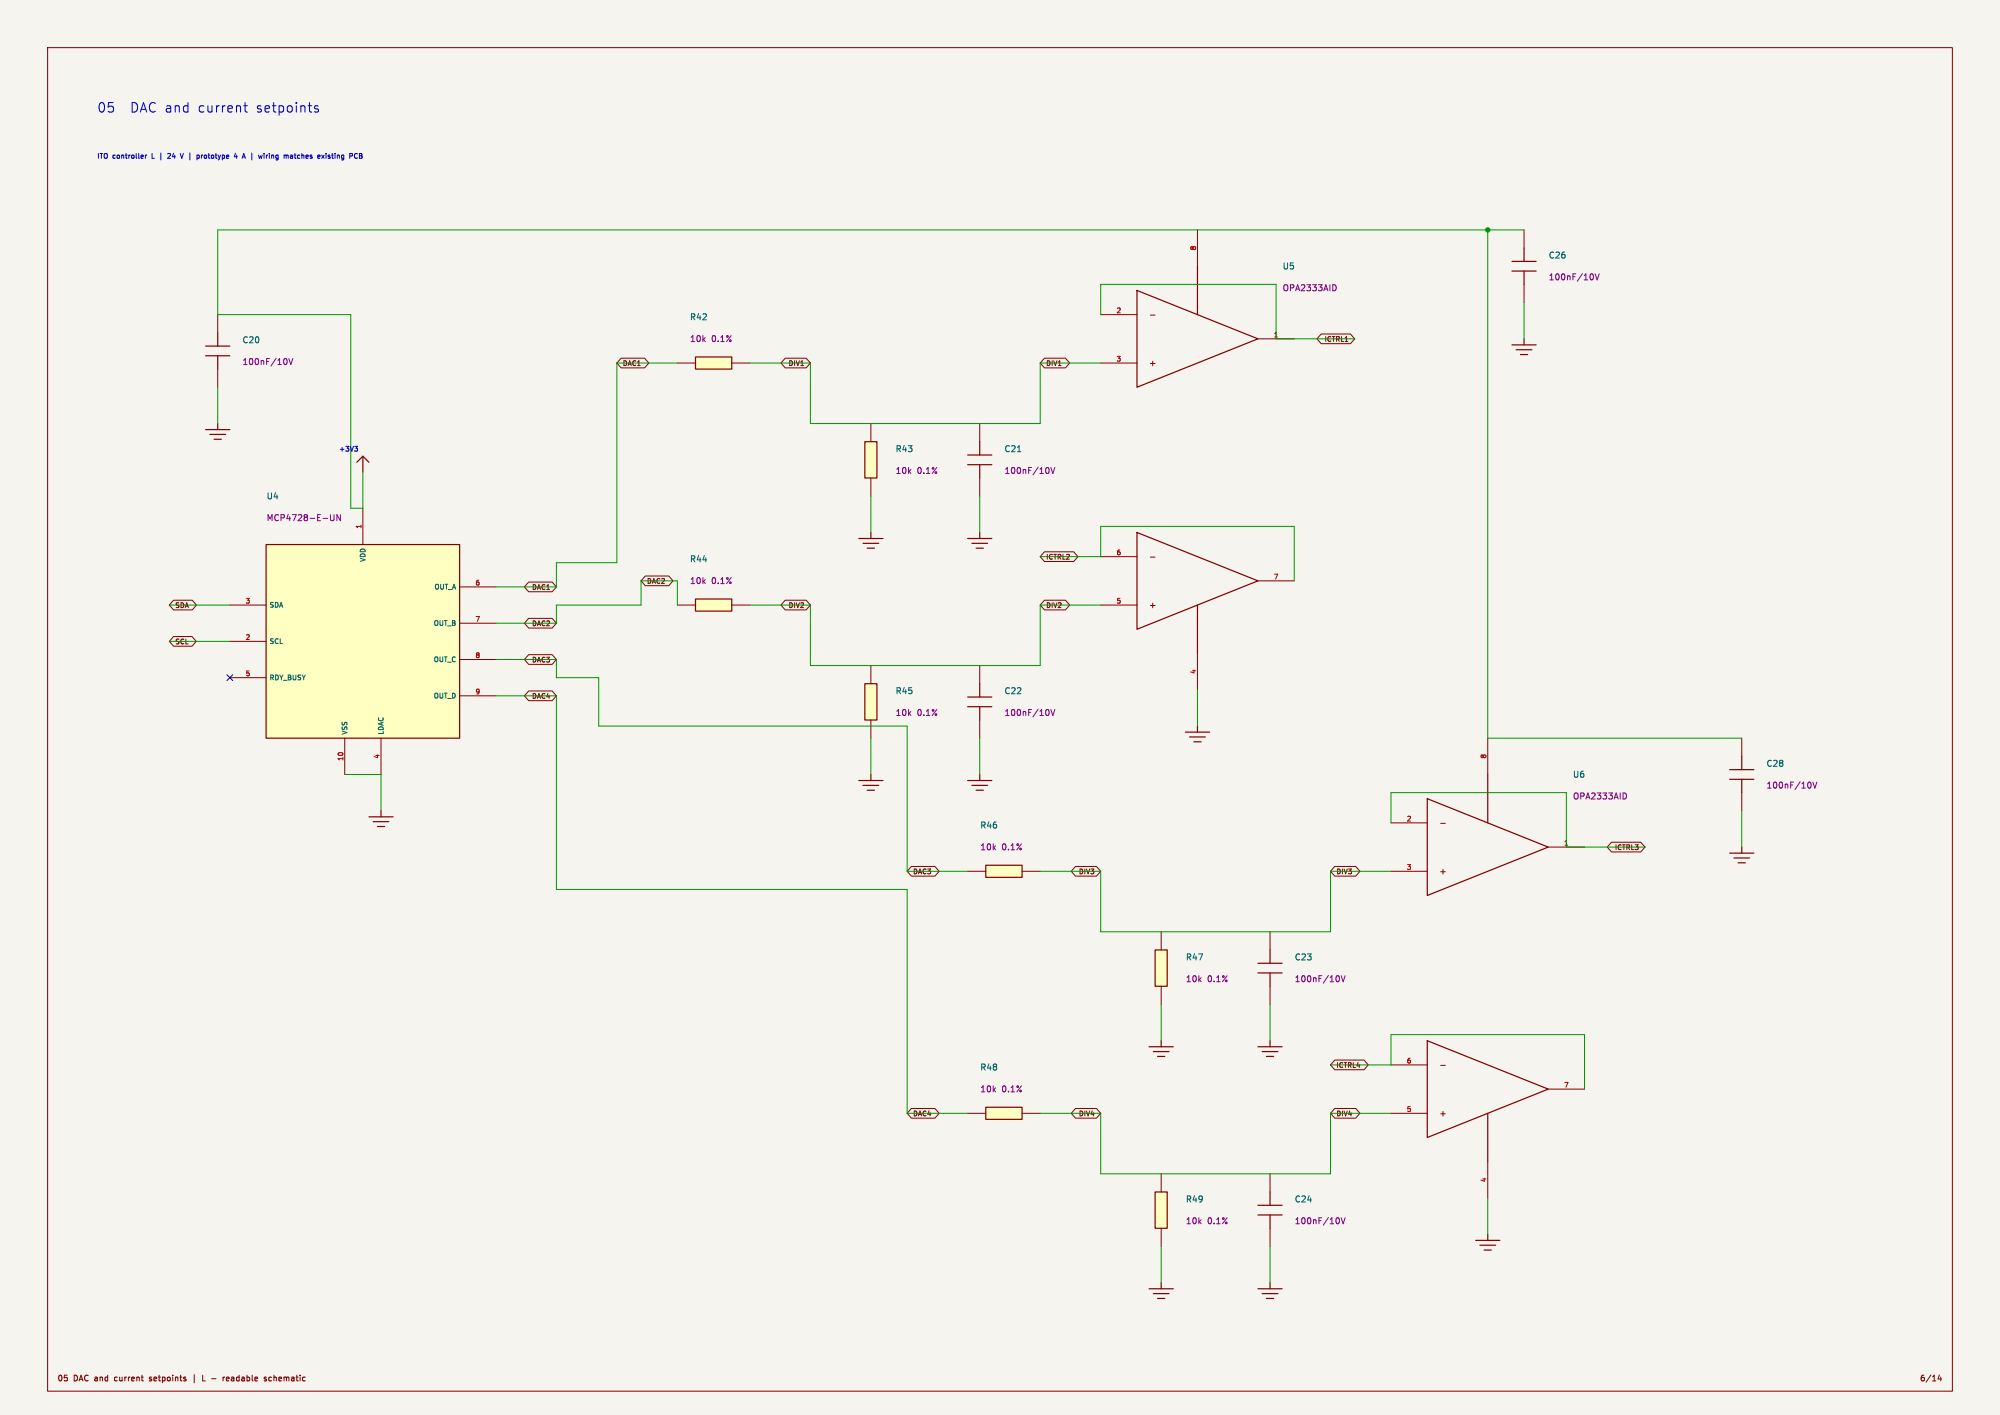
[picture p60: page 6]

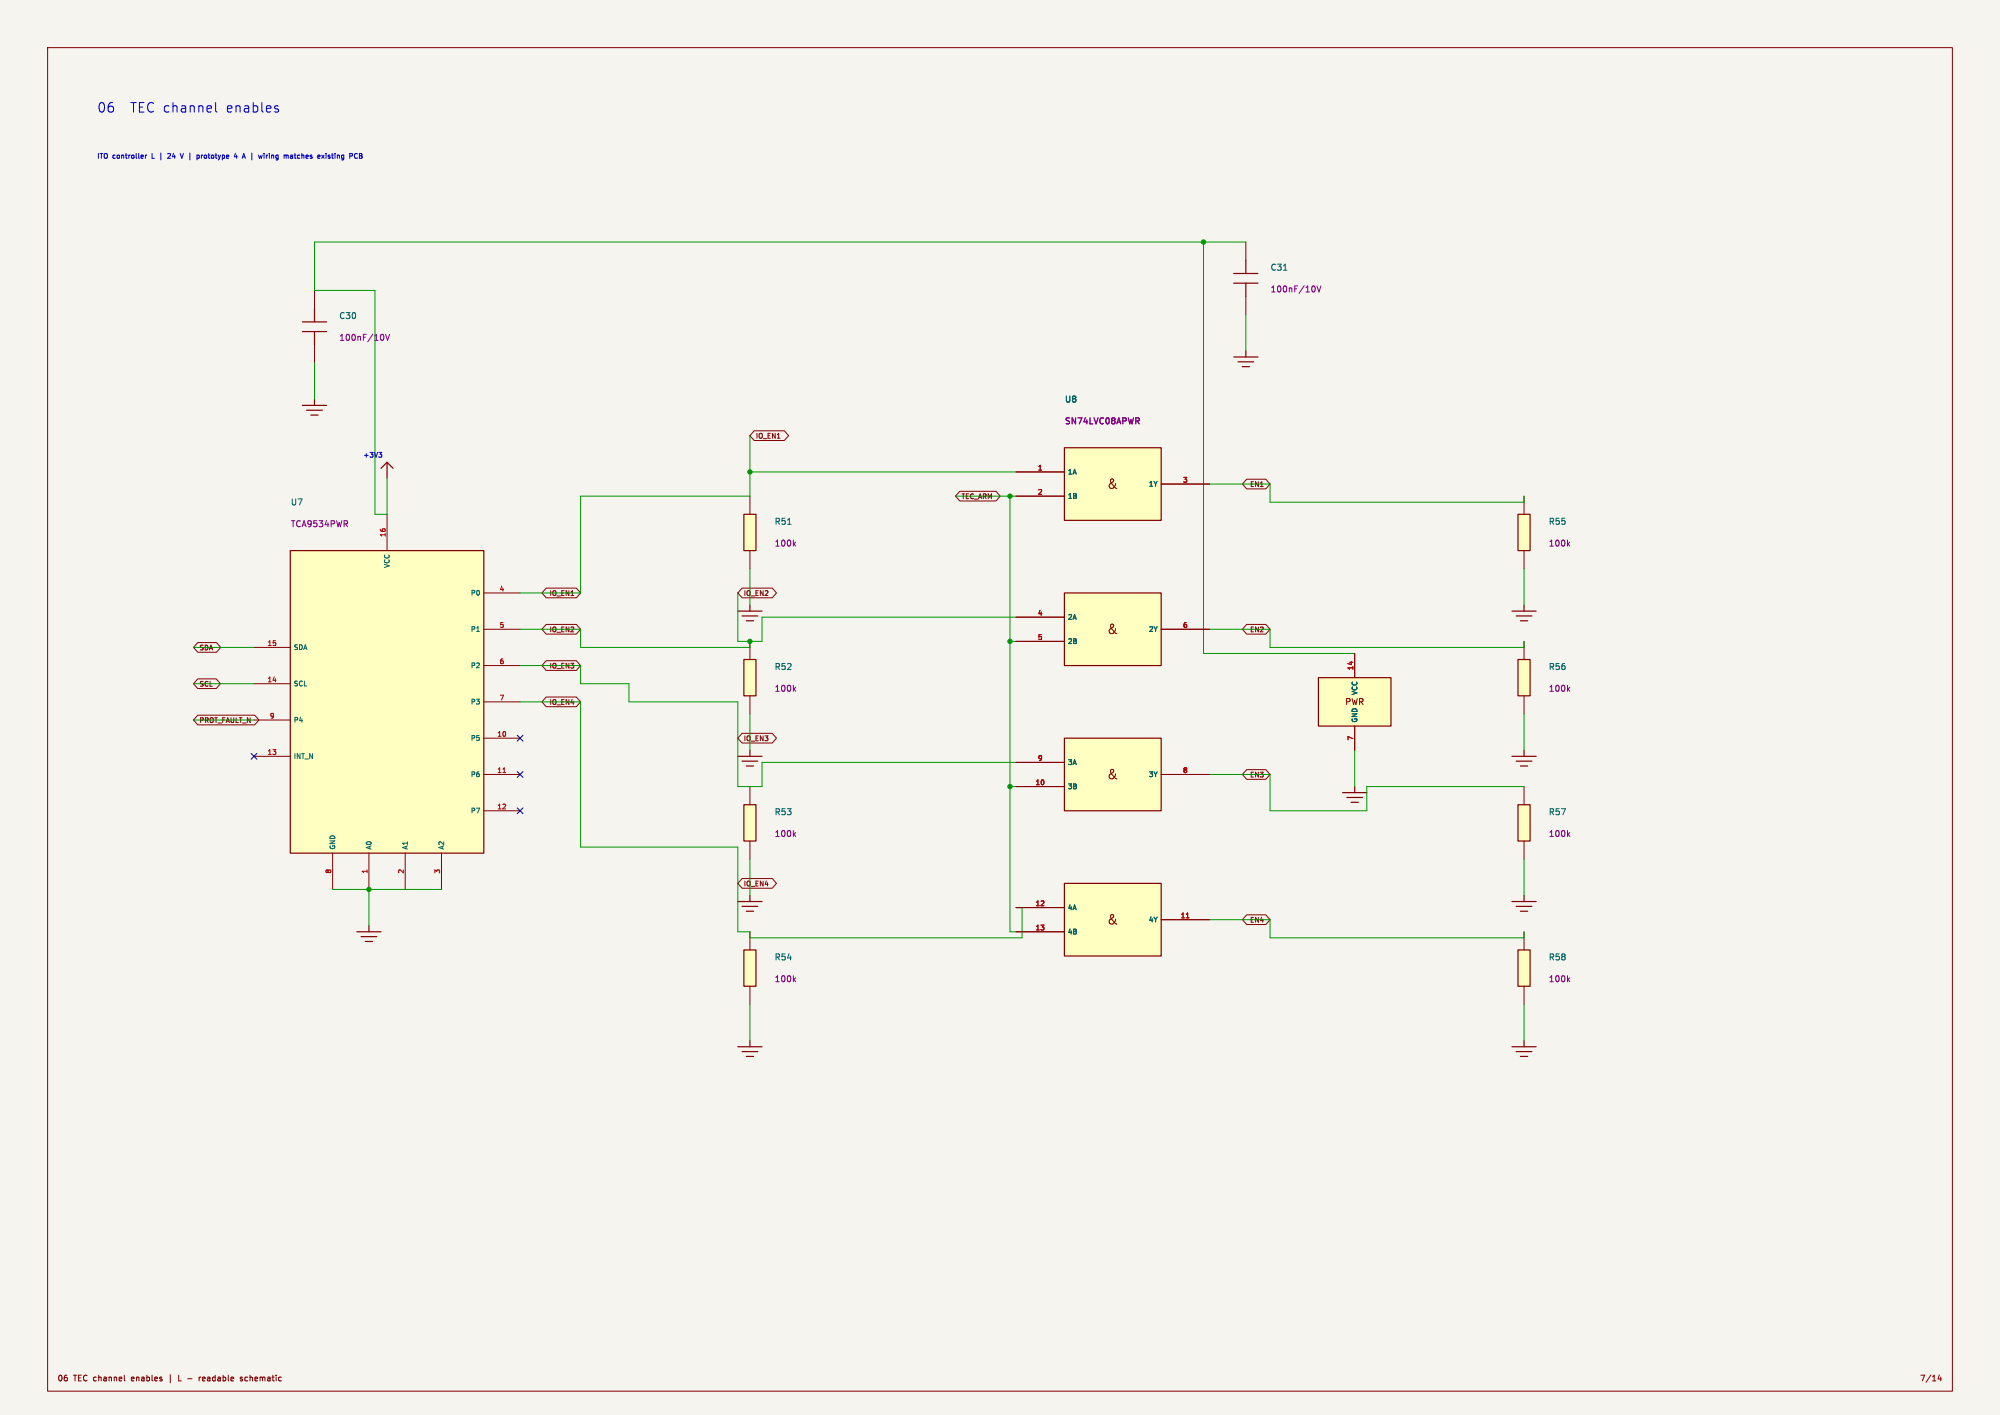
[picture p61: page 7]

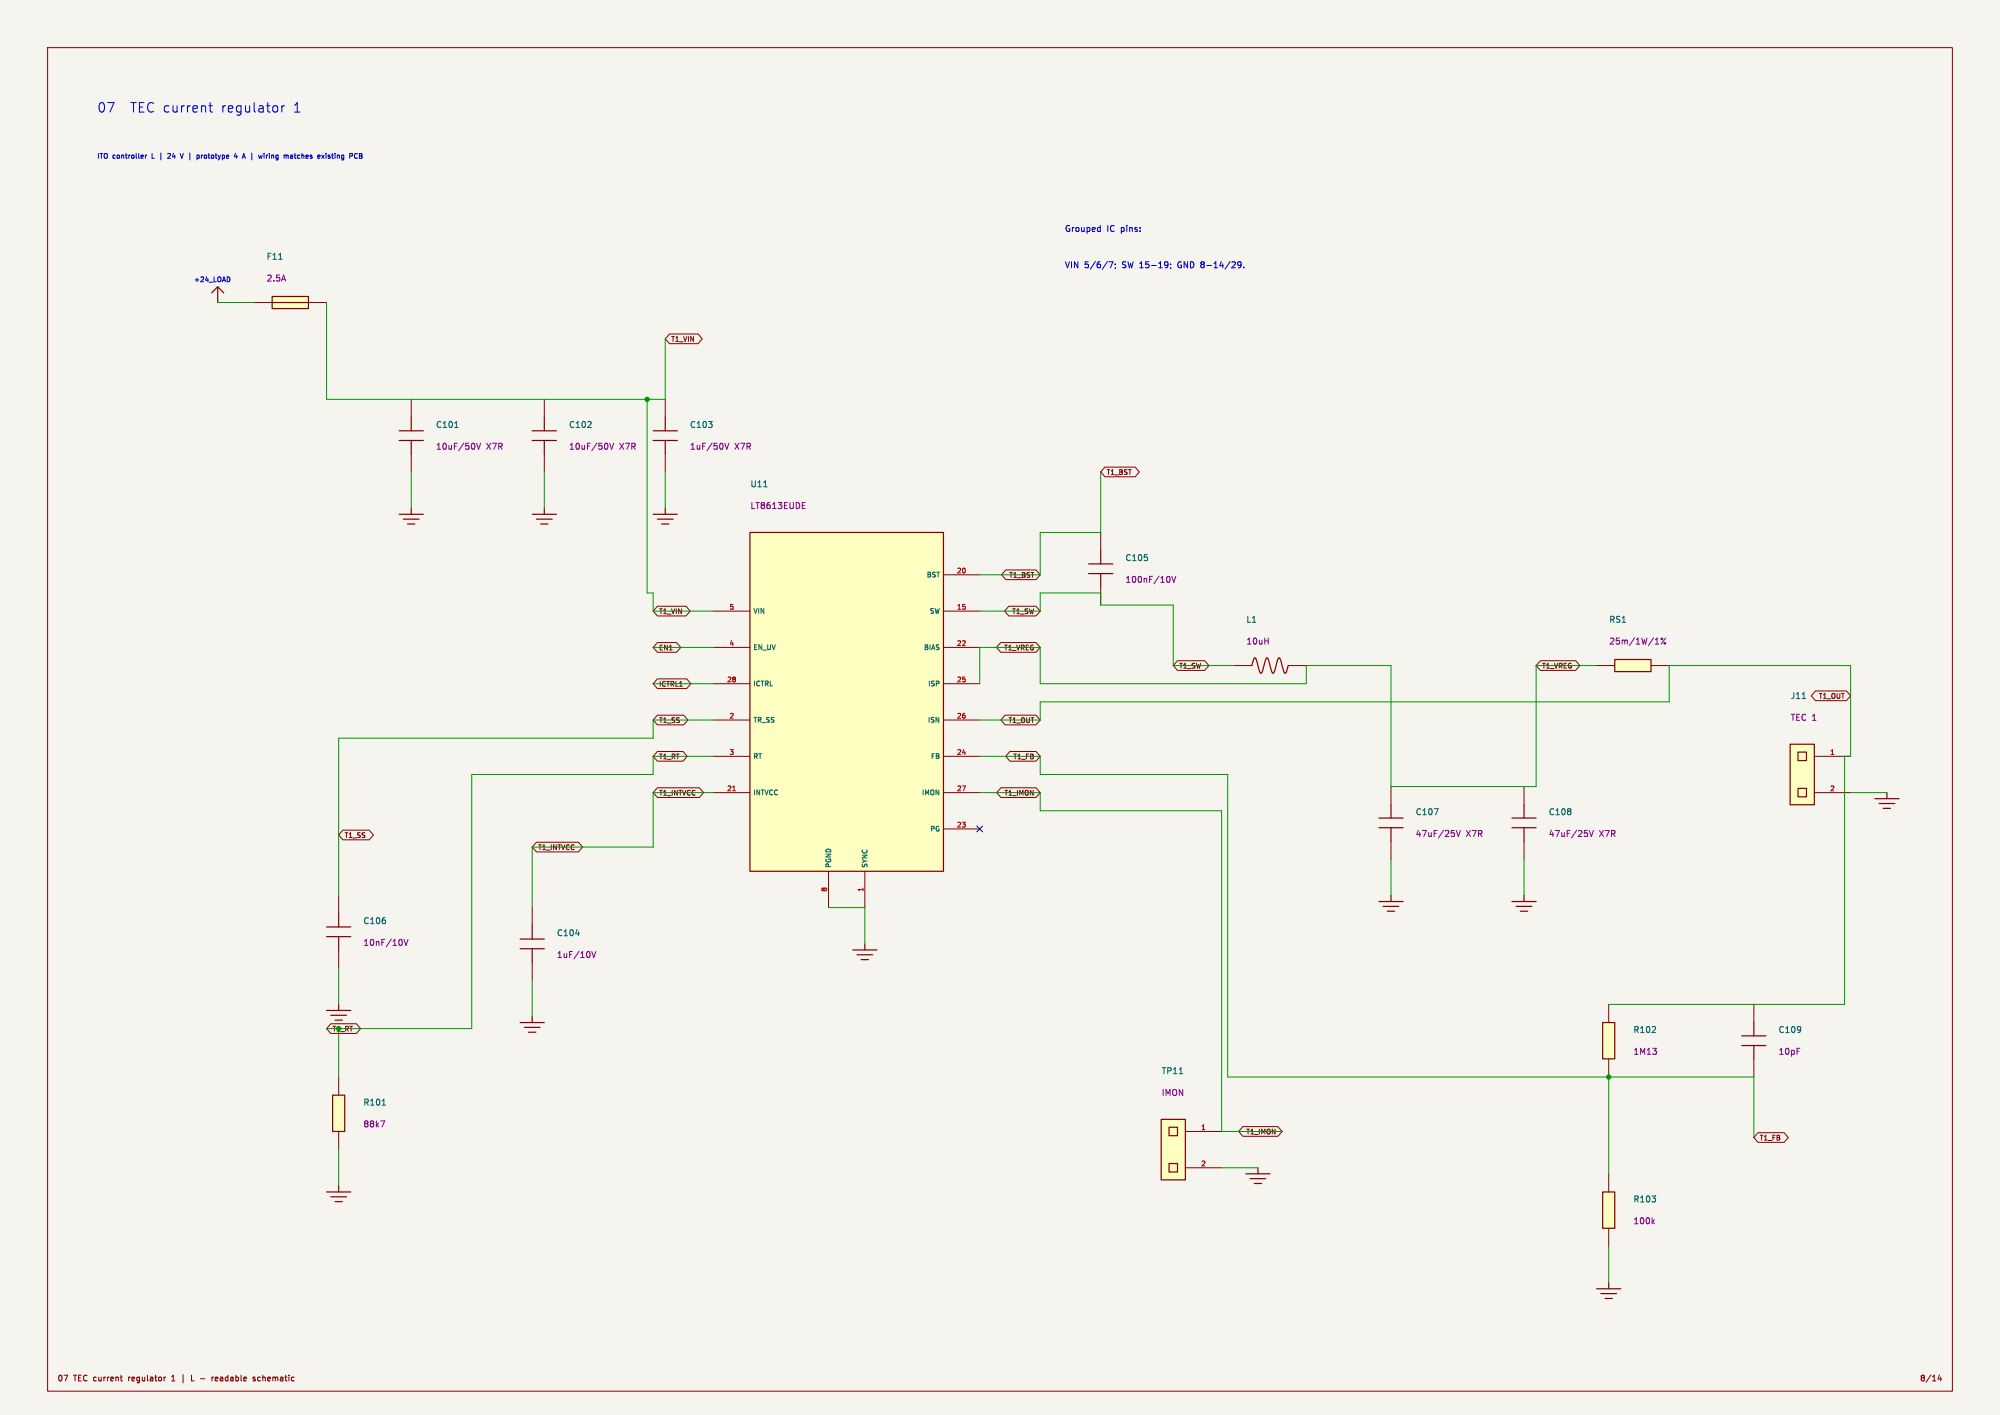
[picture p62: page 8]

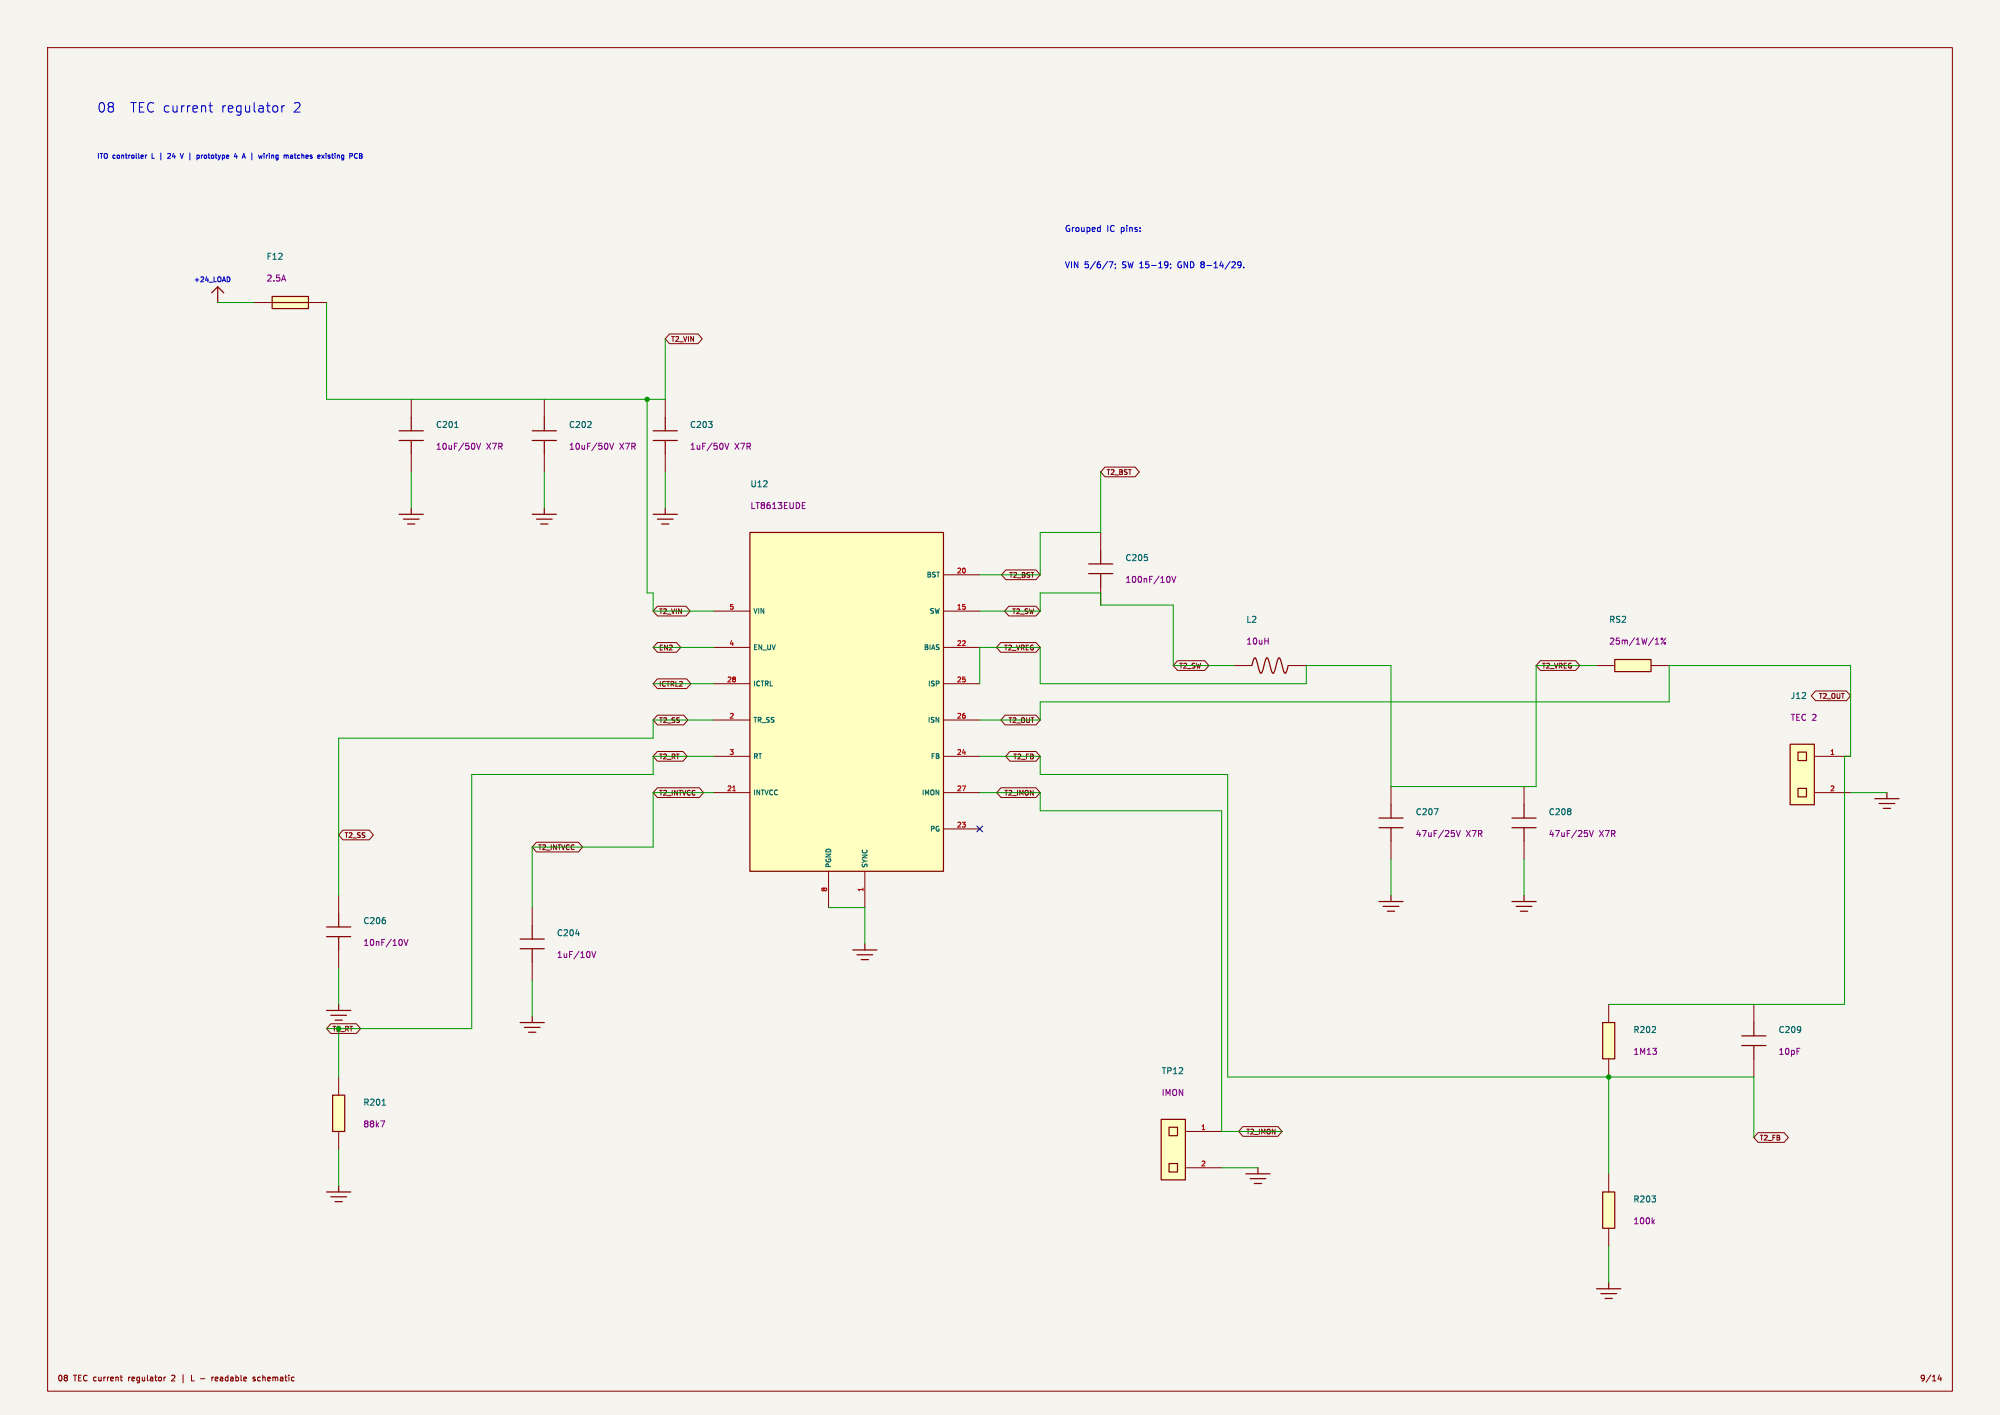
[picture p63: page 9]

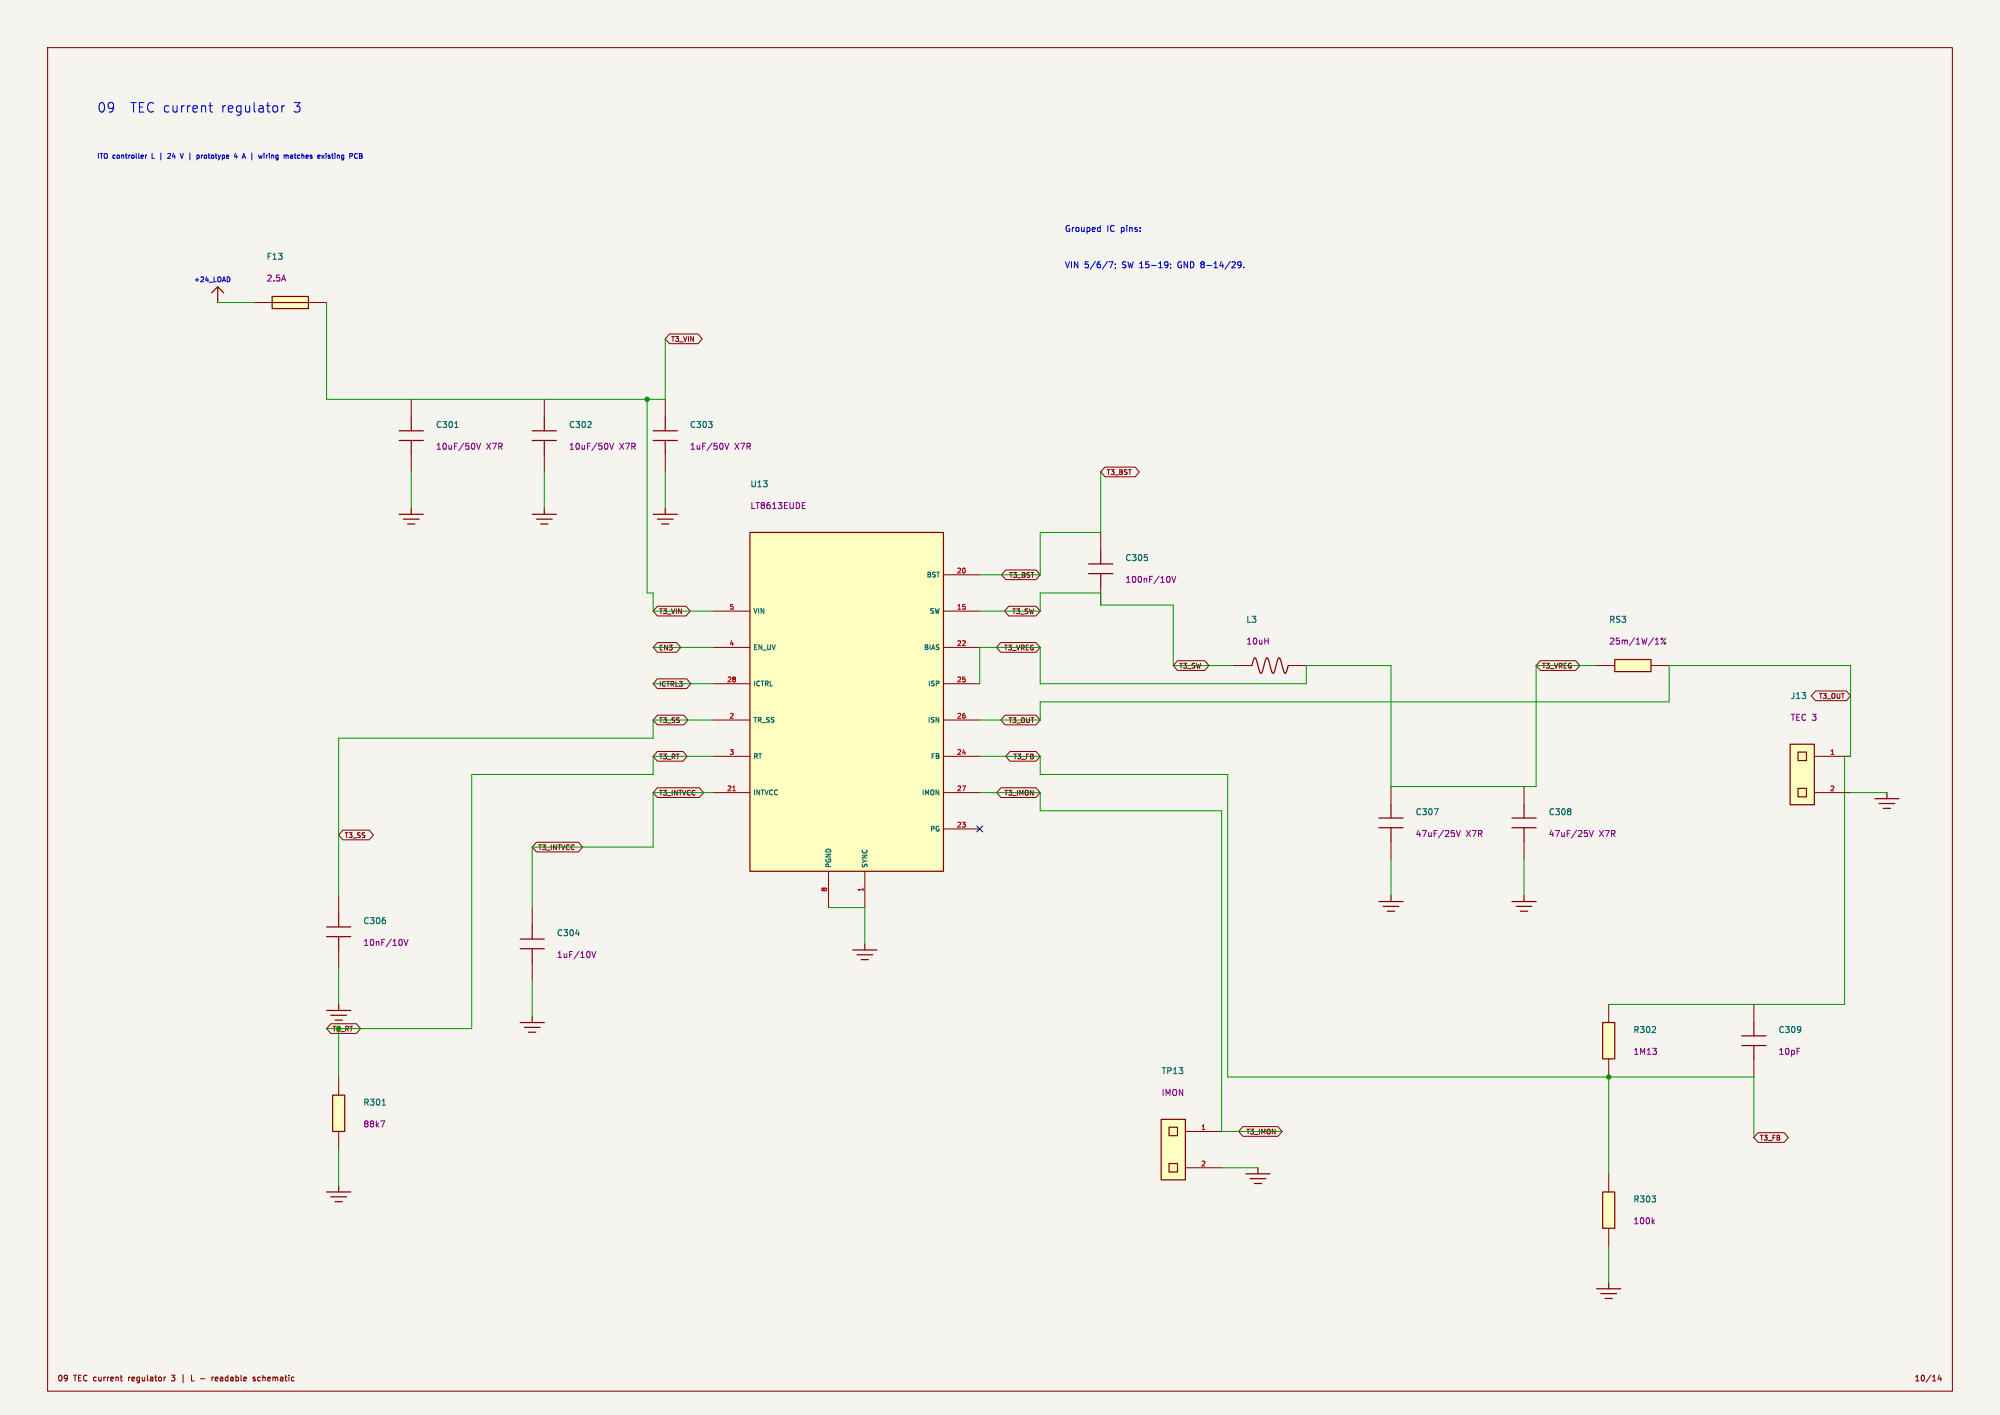
[picture p64: page 10]

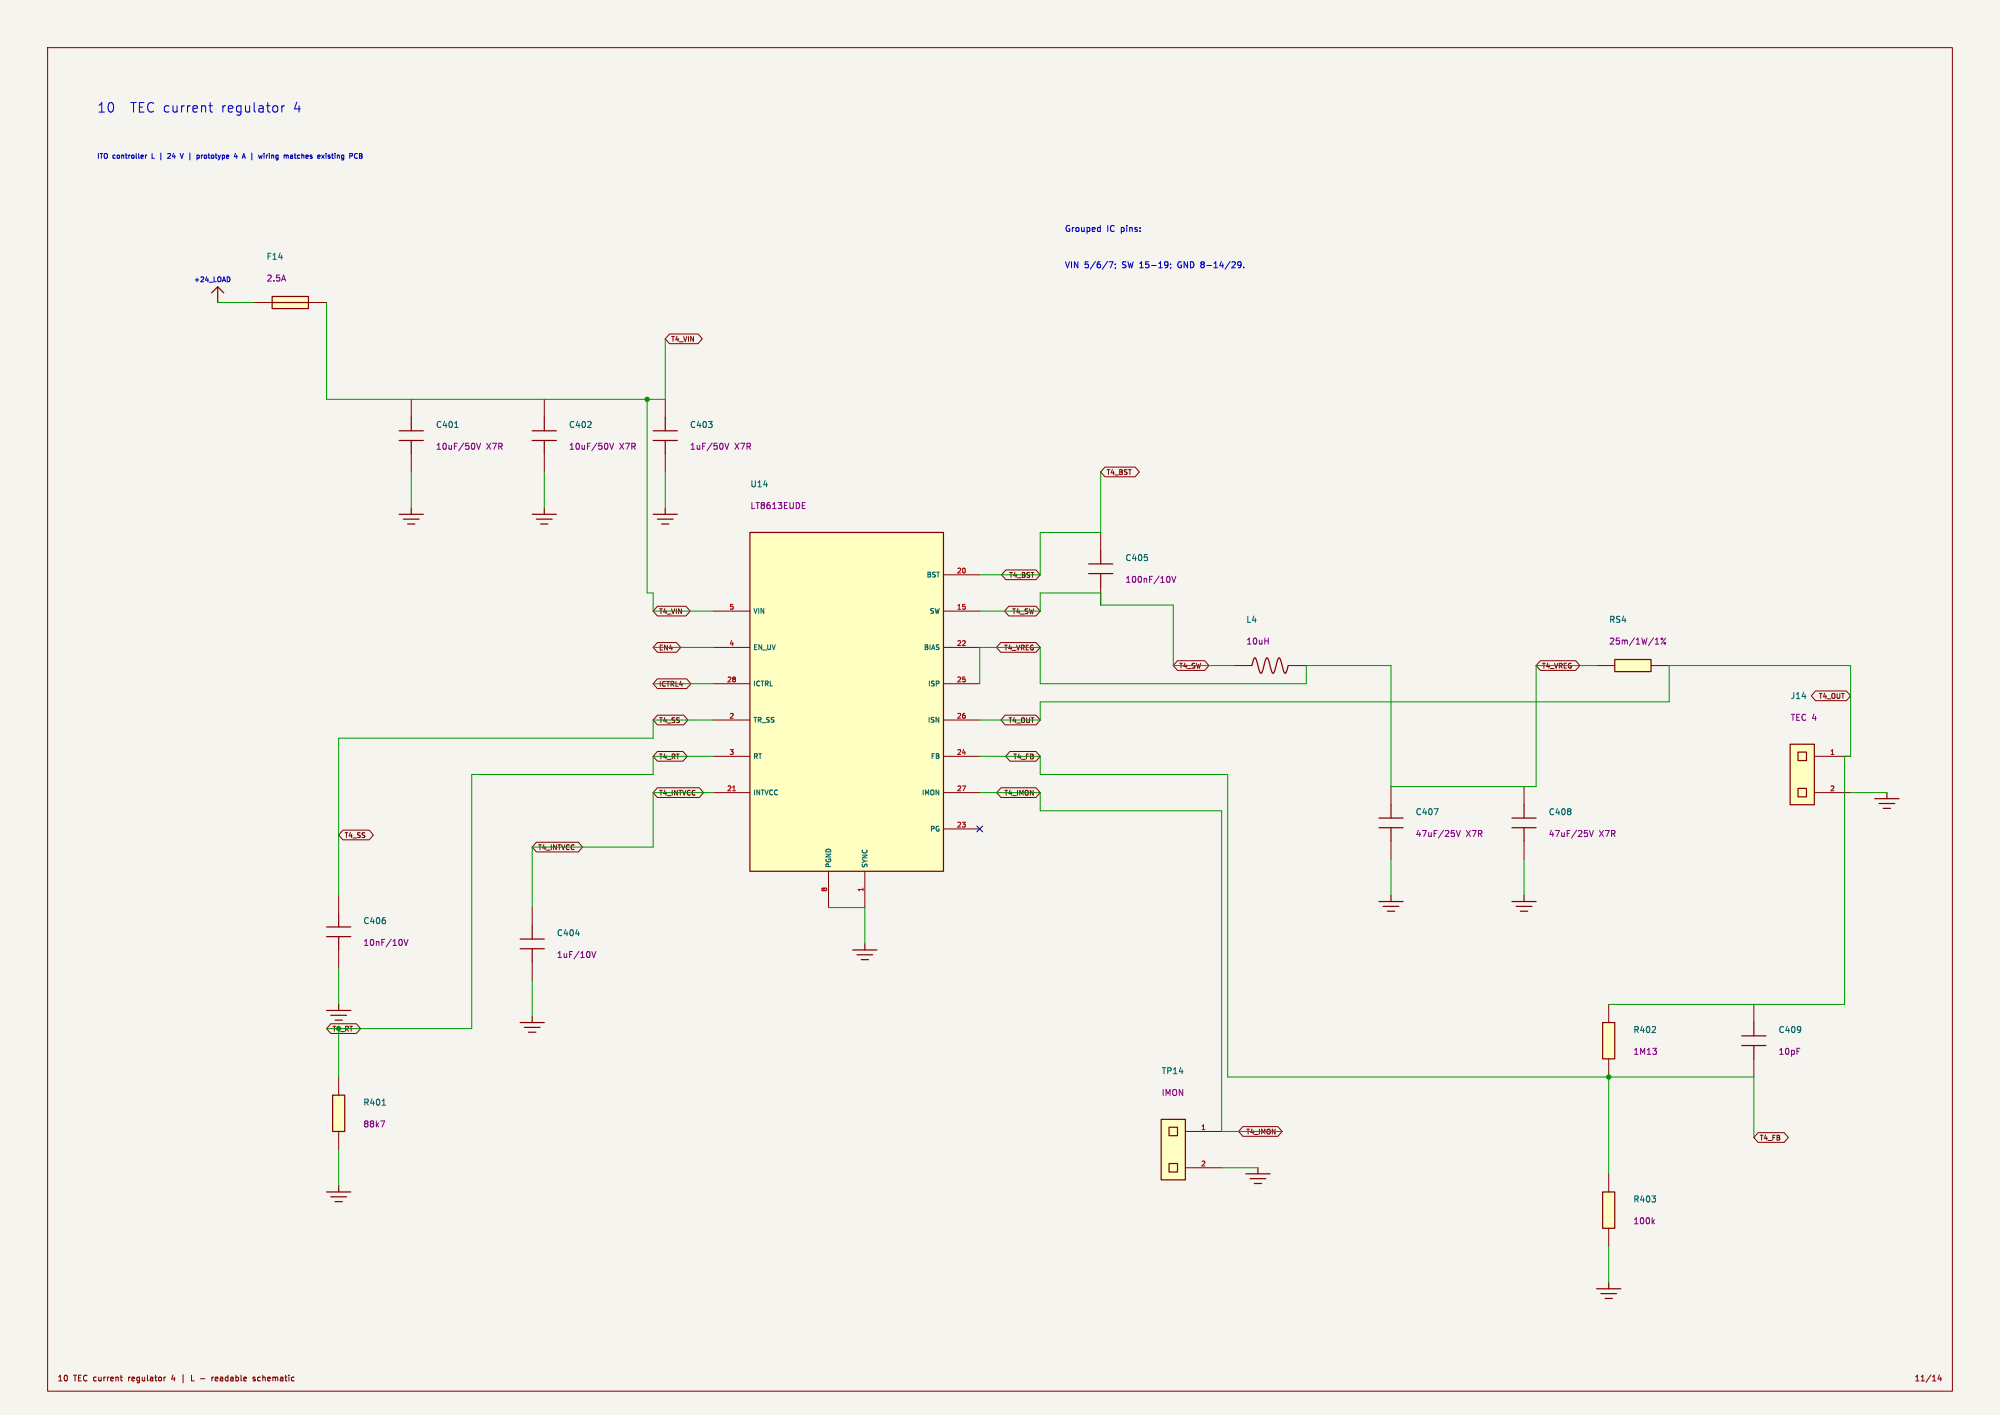
[picture p65: page 11]

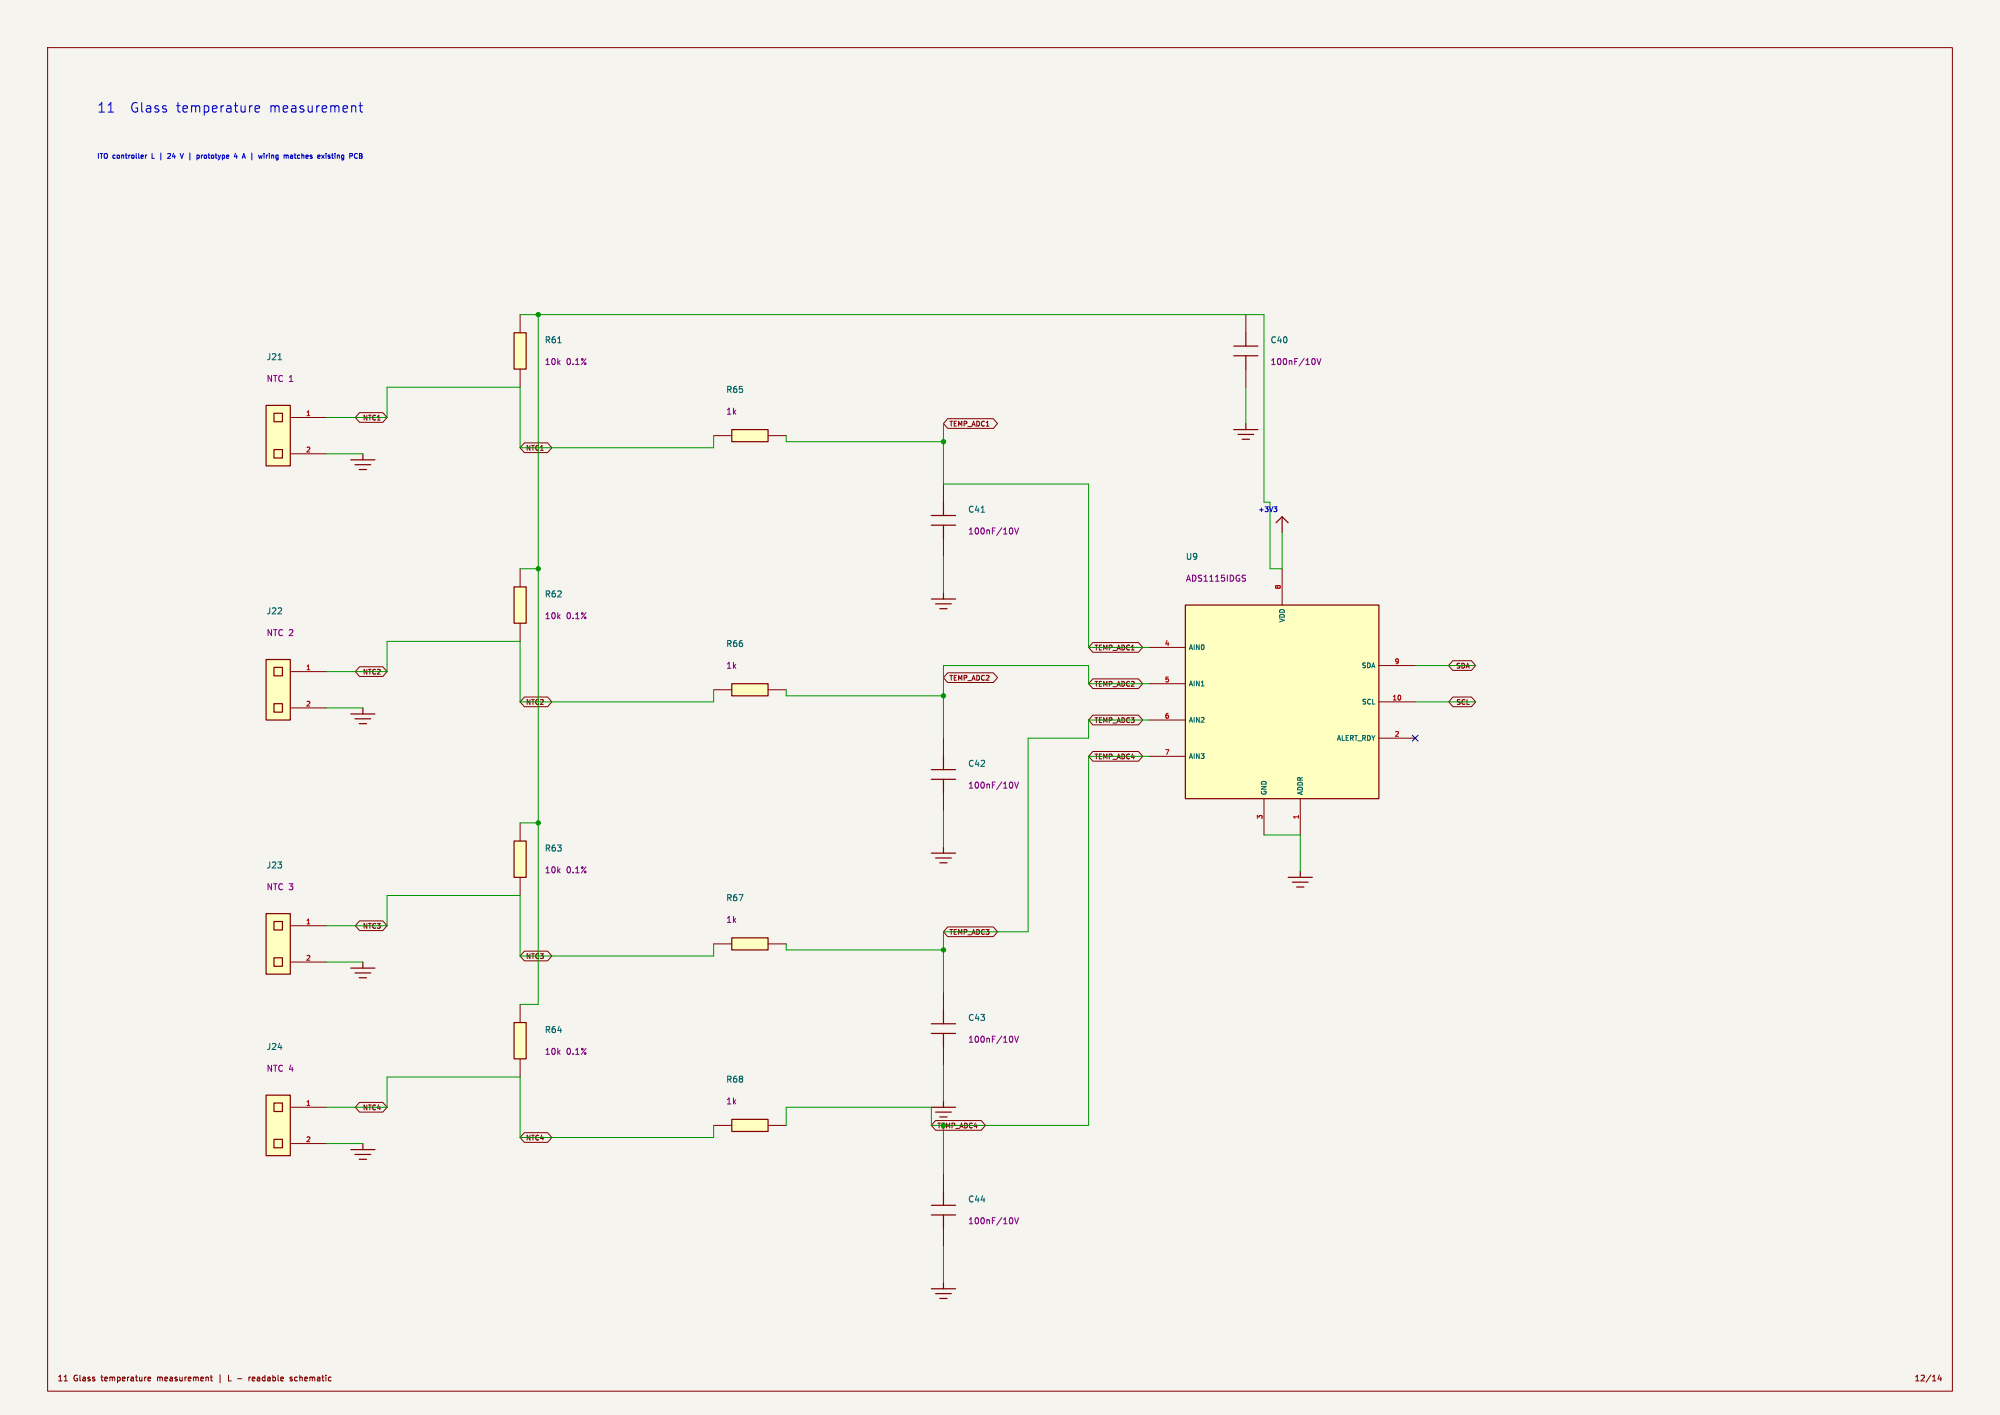
[picture p66: page 12]

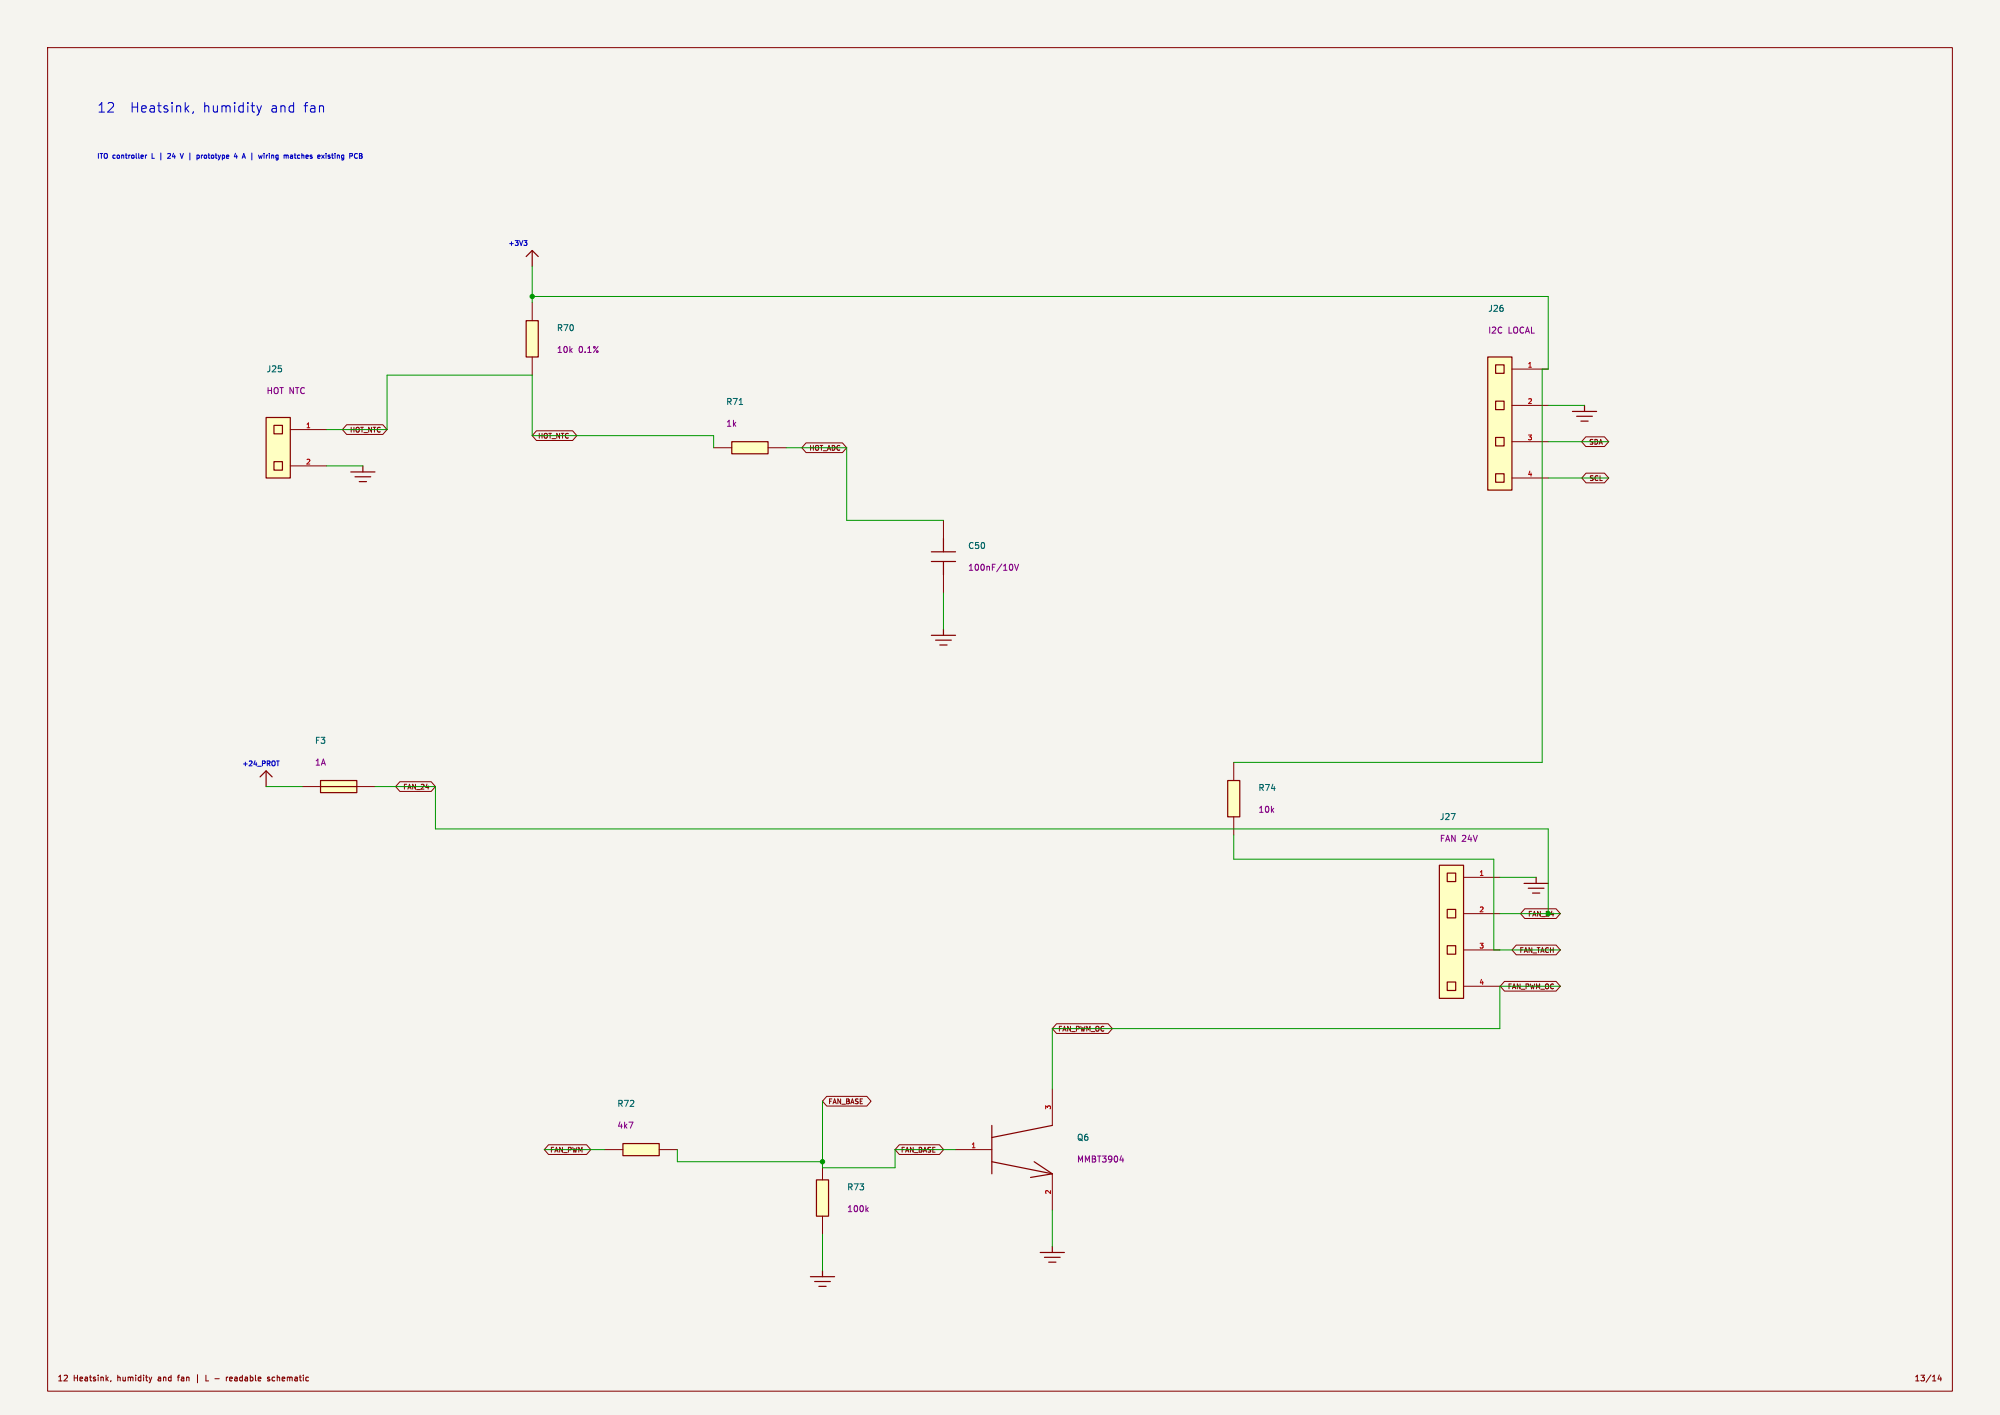
[picture p67: page 13]

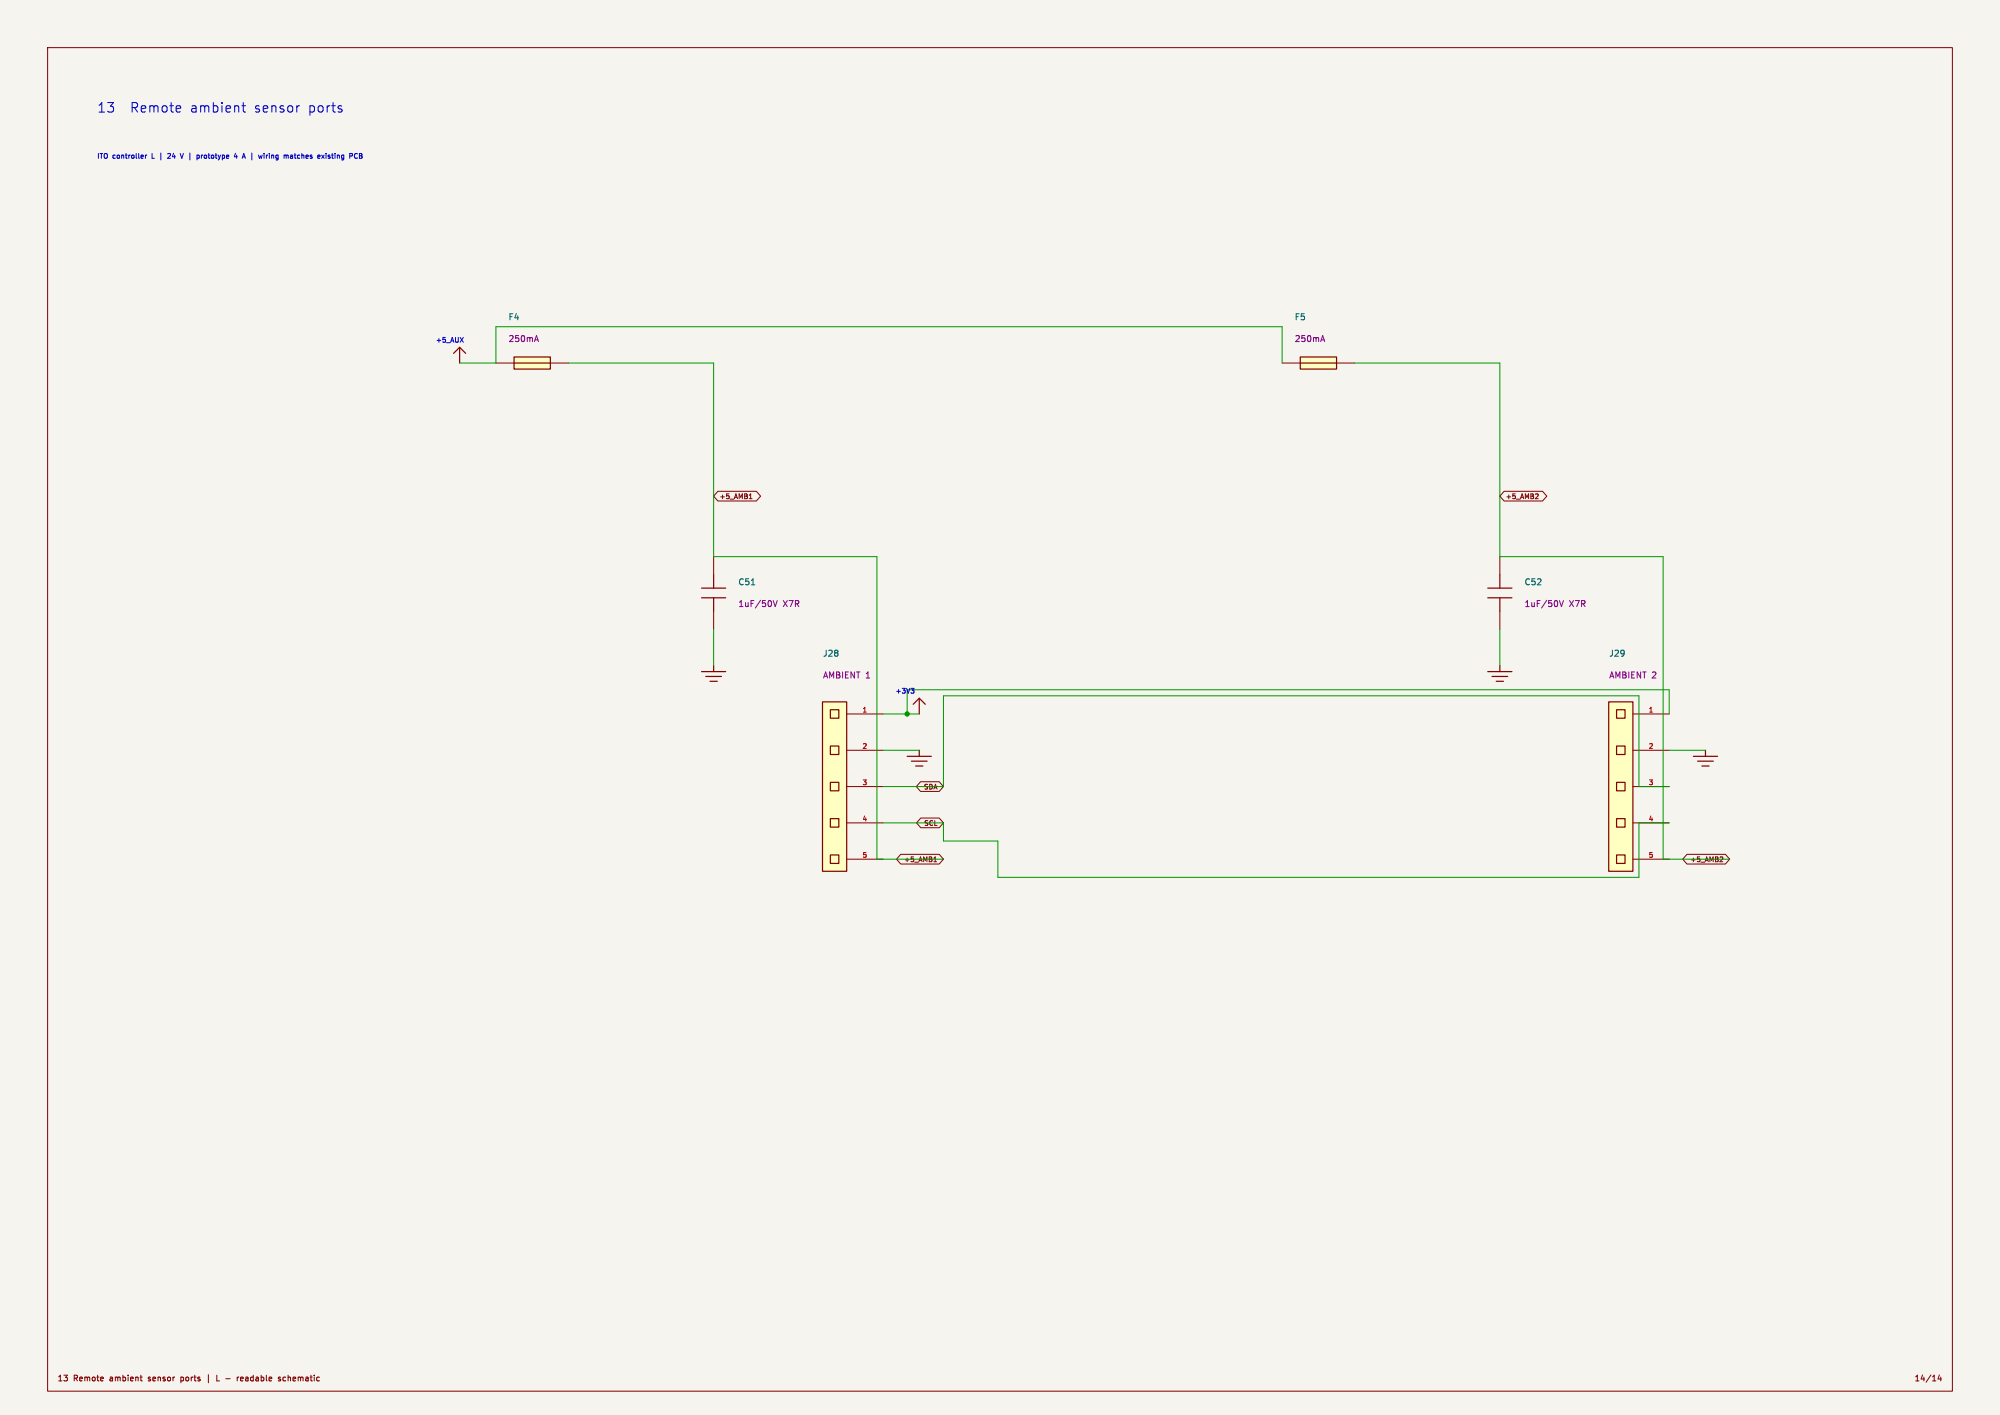
[picture p68: page 14]
