luciddreams/ito-controller/(list of files, drawings)

Other design files:
history-rev-j/pcb-validation.json
pcb-validation.json
schematic-redraw-validation.json
