luciddreams/ito-controller/ito-controller.kicad_pcb

## KiCad design ito-controller.kicad_pcb (2026-09-26)

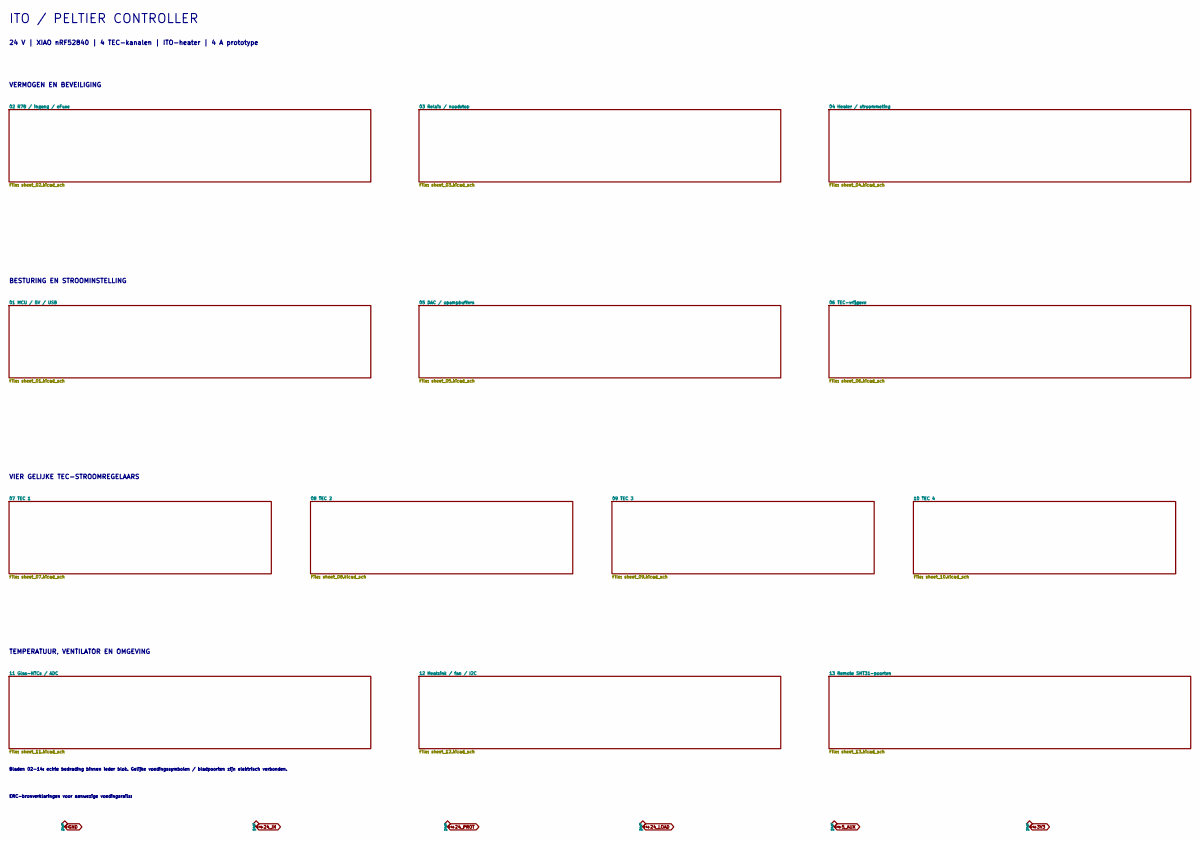
[picture p69: schematic ito-controller.kicad_sch, ITO controller - functioneel schemaoverzicht]

Notes on the sheet:
ITO / PELTIER CONTROLLER
24 V | XIAO nRF52840 | 4 TEC-kanalen | ITO-heater | 4 A prototype
VERMOGEN EN BEVEILIGING
BESTURING EN STROOMINSTELLING
VIER GELIJKE TEC-STROOMREGELAARS
TEMPERATUUR, VENTILATOR EN OMGEVING
ERC-bronverklaringen voor aanwezige voedingsrails:
Bladen 02-14: echte bedrading binnen ieder blok. Gelijke voedingssymbolen / bladpoorten zijn elektrisch verbonden.

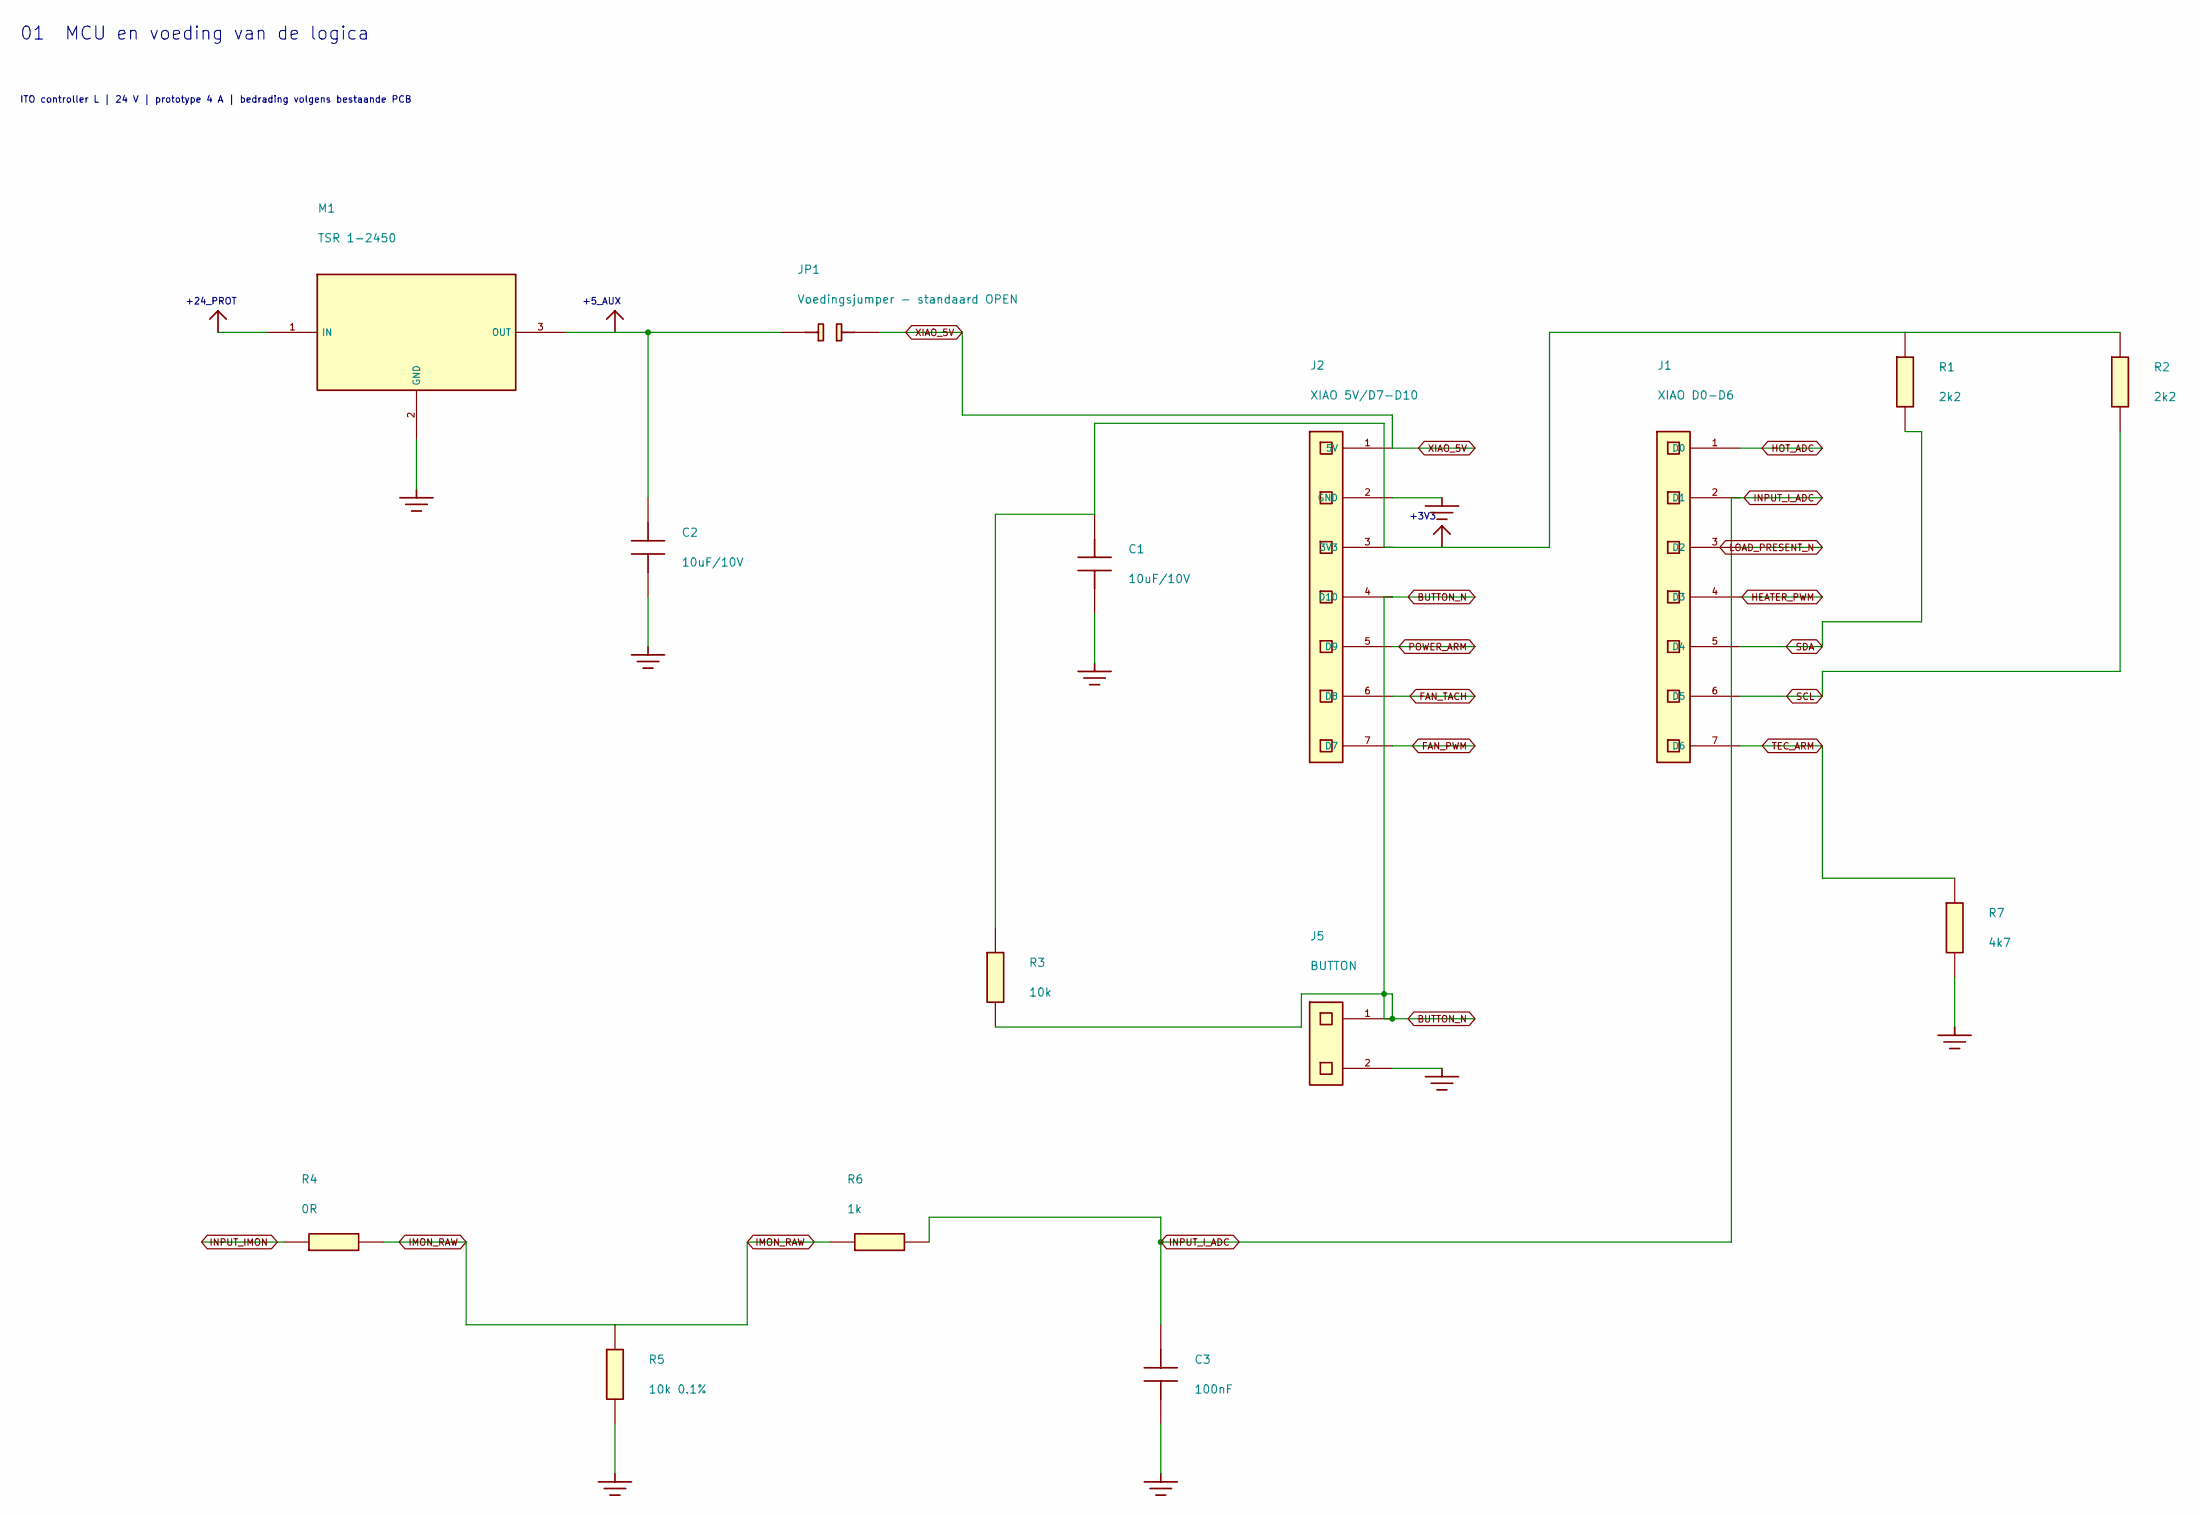
[picture p70: schematic sheet_01.kicad_sch, 01 MCU en voeding van de logica]

Parts:
C1, C2: 10u / 10V; C_0805_2012Metric; MPN GRM21BR61E106KA73L
C3: 100n; C_0805_2012Metric; MPN GRM21BR71H104KA01L
J1: XIAO right socket 1x7 - USB down; PinSocket_1x07_P2.54mm_Vertical; MPN SSW-107-01-G-S
J2: XIAO left socket 1x7 - USB down; PinSocket_1x07_P2.54mm_Vertical; MPN SSW-107-01-G-S
J5: Connector 2 pins; JST_XH_B2B-XH-A_1x02_P2.50mm_Vertical; MPN B2B-XH-A(LF)(SN)
JP1: Voedingsjumper - standaard OPEN; PinHeader_1x02_P2.54mm_Vertical; MPN TSW-102-07-G-S
M1: TSR 1-2450; Converter_DCDC_TRACO_TSR-1_THT; MPN TSR 1-2450
R1, R2: 2k2; R_0805_2012Metric; MPN RC0805FR-072K2L
R3: 10k; R_0805_2012Metric; MPN RC0805FR-0710KL
R4: 0R; R_0805_2012Metric; MPN RC0805JR-070RL
R5: 10k 0.1%; R_0805_2012Metric; MPN RT0805BRD0710KL
R6: 1k; R_0805_2012Metric; MPN RC0805FR-071KL
R7: 4k7; R_0805_2012Metric; MPN RC0805FR-074K7L

Connections:
+3V3: C1.1, J2.3 (3V3), R1.1, R2.1, R3.1; also elsewhere on the board
+5_AUX: C2.1, JP1.1, M1.3 (OUT); also elsewhere on the board
+24_PROT: M1.1 (IN); also elsewhere on the board
BUTTON_N: J2.4 (D10), J5.1, R3.2
FAN_PWM: J2.7 (D7); also elsewhere on the board
FAN_TACH: J2.6 (D8); also elsewhere on the board
GND: C1.2, C2.2, C3.2, J2.2 (GND), J5.2, M1.2 (GND), R5.2, R7.2; also elsewhere on the board
HEATER_PWM: J1.4 (D3); also elsewhere on the board
HOT_ADC: J1.1 (D0); also elsewhere on the board
IMON_RAW: R4.2, R5.1, R6.1
INPUT_IMON: R4.1; also elsewhere on the board
INPUT_I_ADC: C3.1, J1.2 (D1), R6.2
LOAD_PRESENT_N: J1.3 (D2); also elsewhere on the board
POWER_ARM: J2.5 (D9); also elsewhere on the board
SCL: J1.6 (D5), R2.2; also elsewhere on the board
SDA: J1.5 (D4), R1.2; also elsewhere on the board
TEC_ARM: J1.7 (D6), R7.1; also elsewhere on the board
XIAO_5V: J2.1 (5V), JP1.2

Notes on the sheet:
+3V3
+24_PROT
+5_AUX
01 MCU en voeding van de logica
ITO controller L | 24 V | prototype 4 A | bedrading volgens bestaande PCB

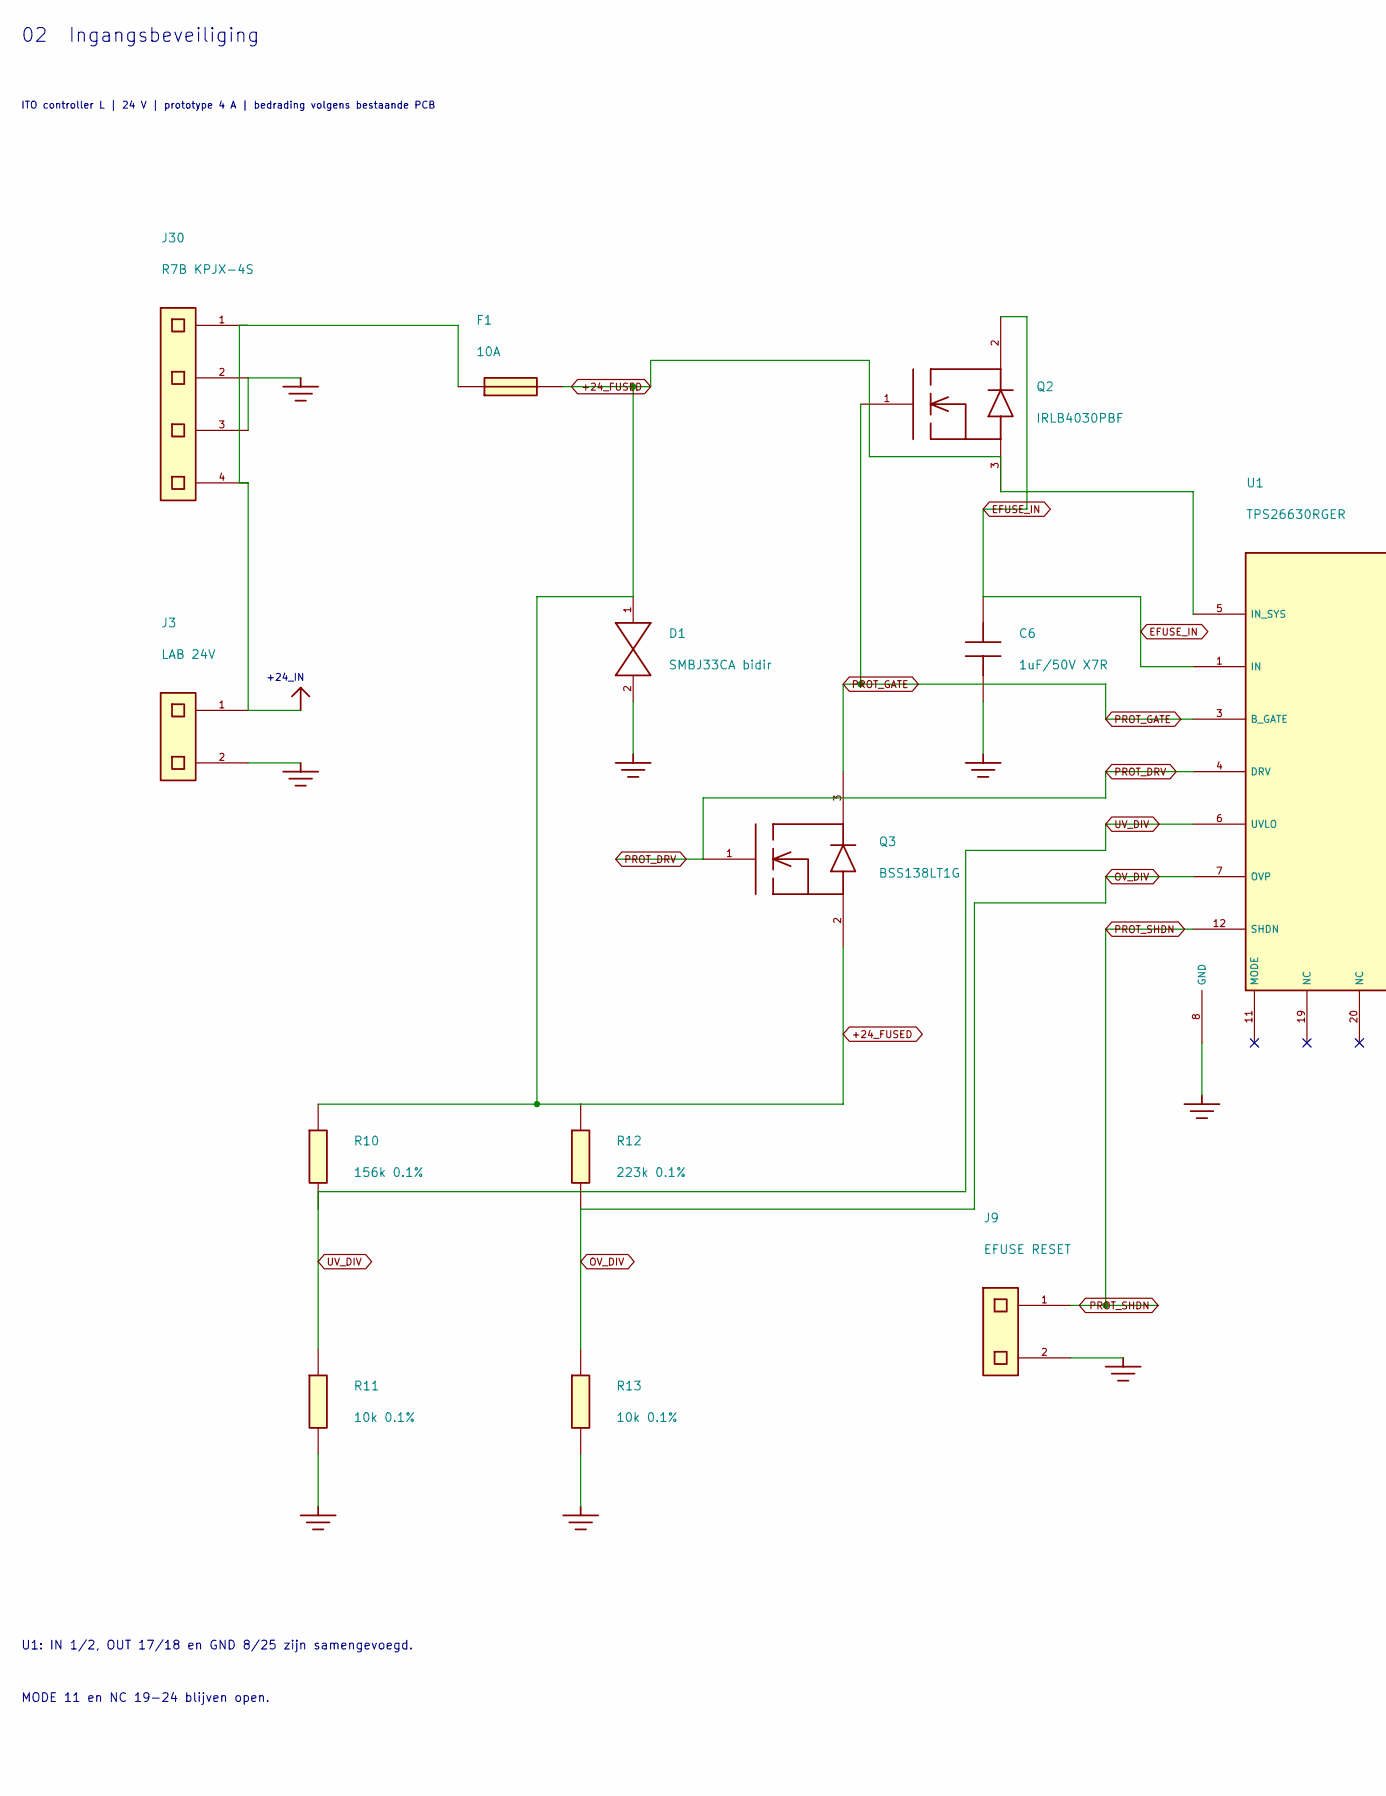
[picture p71: schematic sheet_02.kicad_sch, 02 Ingangsbeveiliging, part in row 1, column 1]

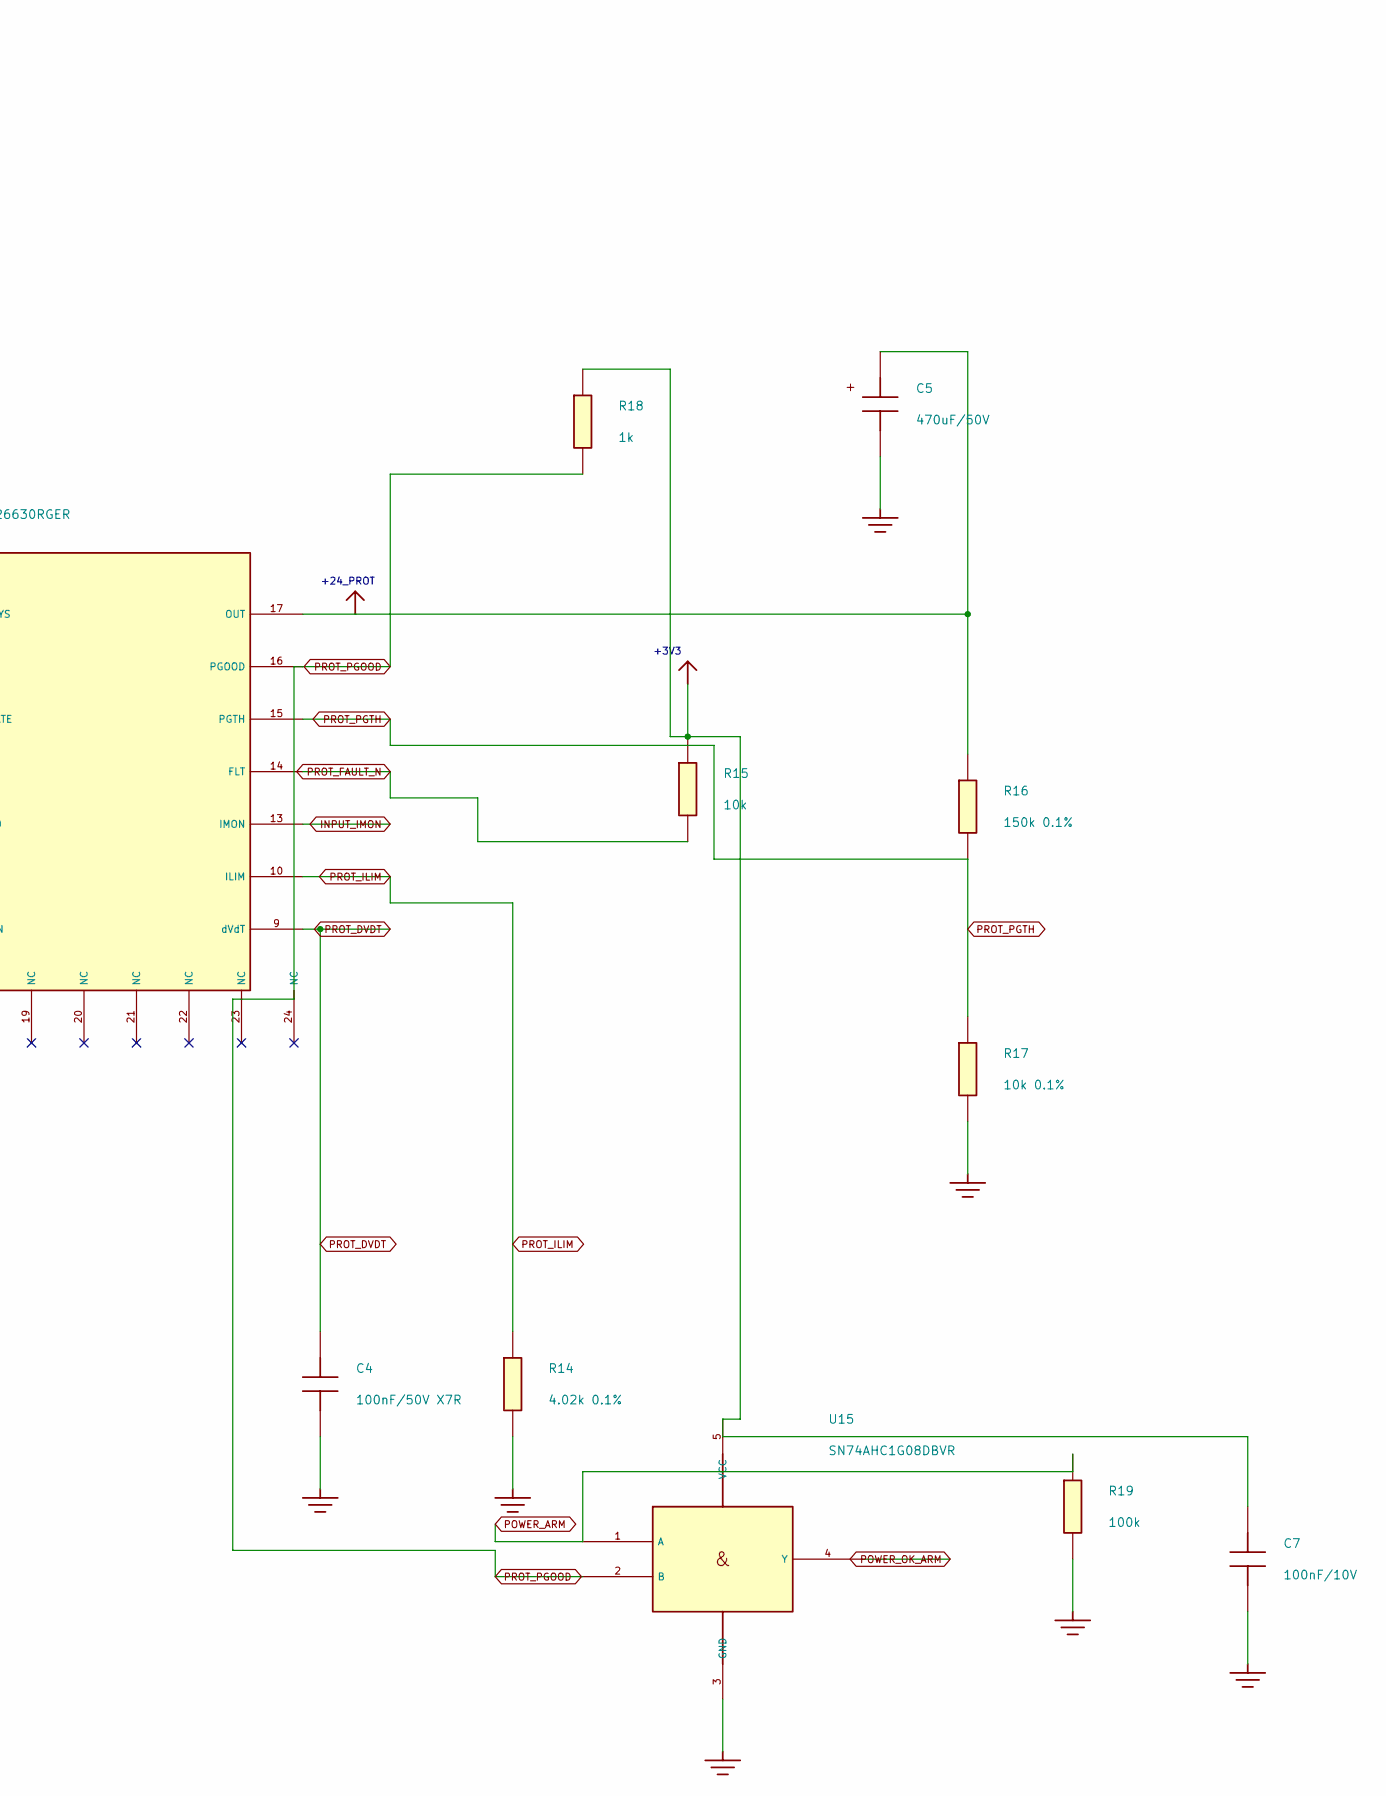
[picture p72: schematic sheet_02.kicad_sch, 02 Ingangsbeveiliging, part in row 1, column 2]

Parts:
C4: 100n / 50V X7R 10%; C_0805_2012Metric; MPN GRM21BR71H104KA01L
C5: 470u / 50V EEUFR1H471; CP_Radial_D12.5mm_P5.00mm; MPN EEUFR1H471
C6: 1u / 50V X7R; C_0805_2012Metric; MPN GRM21BR71H105KA12L
C7: 100n / 10V; C_0805_2012Metric; MPN GRM21BR71H104KA01L
D1: SMBJ33CA bidirectioneel; D_SMB; MPN SMBJ33CA
F1: 10A / 125V DC 0451010.MRL; Littelfuse_451; MPN 0451010.MRL
J3: Connector 2 pins; TerminalBlock_Phoenix_MKDS-1,5-2-5.08_1x02_P5.08mm_Horizont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; MPN 1715721
J9: EFUSE RESET NO; JST_XH_B2B-XH-A_1x02_P2.50mm_Vertical; MPN B2B-XH-A(LF)(SN)
J30: R7B 24V IN - KPJX-4S; Kycon_KPJX-4S; MPN KPJX-4S
Q2: IRLB4030PBF; TO-220-3_Vertical; MPN IRLB4030PBF
Q3: BSS138LT1G; SOT-23; MPN BSS138LT1G
R10: 156k 0.1%; R_0805_2012Metric; MPN RT0805BRD07156KL
R11, R13, R17: 10k 0.1%; R_0805_2012Metric; MPN RT0805BRD0710KL
R12: 223k 0.1%; R_0805_2012Metric; MPN RT0805BRD07223KL
R14: 4.02k 0.1%; R_0805_2012Metric; MPN RT0805BRD074K02L
R15: 10k; R_0805_2012Metric; MPN RC0805FR-0710KL
R16: 150k 0.1%; R_0805_2012Metric; MPN RT0805BRD07150KL
R18: 1k; R_0805_2012Metric; MPN RC0805FR-071KL
R19: 100k; R_0805_2012Metric; MPN RC0805FR-07100KL
U1: TPS26630RGER; TI_RGE0024H_4x4_EP2.7; MPN TPS26630RGER
U15: SN74AHC1G08DBVR; SOT-23-5; MPN SN74AHC1G08DBVR

Connections:
+3V3: C7.1, R15.1, R18.1, U15.5 (VCC); also elsewhere on the board
+24_FUSED: D1.1, F1.2, Q2.3, Q3.2, R10.1, R12.1, U1.5 (IN_SYS)
+24_IN: F1.1, J3.1, J30.1 (VIN), J30.4 (VIN)
+24_PROT: C5.1, R16.1, U1.17 (OUT), U1.18 (OUT); also elsewhere on the board
EFUSE_IN: C6.1, Q2.2, U1.1 (IN), U1.2 (IN)
GND: C4.2, C5.2, C6.2, C7.2, D1.2, J3.2, J9.2 (GND), J30.2 (RETURN), J30.3 (RETURN), R11.2, R13.2, R14.2, R17.2, R19.2, U1.8 (GND), U1.25 (EP_GND), U15.3 (GND); also elsewhere on the board
INPUT_IMON: U1.13 (IMON); also elsewhere on the board
OV_DIV: R12.2, R13.1, U1.7 (OVP)
POWER_ARM: R19.1, U15.1 (A); also elsewhere on the board
POWER_OK_ARM: U15.4 (Y); also elsewhere on the board
PROT_DRV: Q3.1, U1.4 (DRV)
PROT_DVDT: C4.1, U1.9 (dVdT)
PROT_FAULT_N: R15.2, U1.14 (FLT); also elsewhere on the board
PROT_GATE: Q2.1, Q3.3, U1.3 (B_GATE)
PROT_ILIM: R14.1, U1.10 (ILIM)
PROT_PGOOD: R18.2, U1.16 (PGOOD), U15.2 (B)
PROT_PGTH: R16.2, R17.1, U1.15 (PGTH)
PROT_SHDN: J9.1 (SHDN), U1.12 (SHDN)
UV_DIV: R10.2, R11.1, U1.6 (UVLO)

Notes on the sheet:
U1: IN 1/2, OUT 17/18 en GND 8/25 zijn samengevoegd.
MODE 11 en NC 19-24 blijven open.
+24_IN
+24_PROT
+3V3
02 Ingangsbeveiliging
ITO controller L | 24 V | prototype 4 A | bedrading volgens bestaande PCB

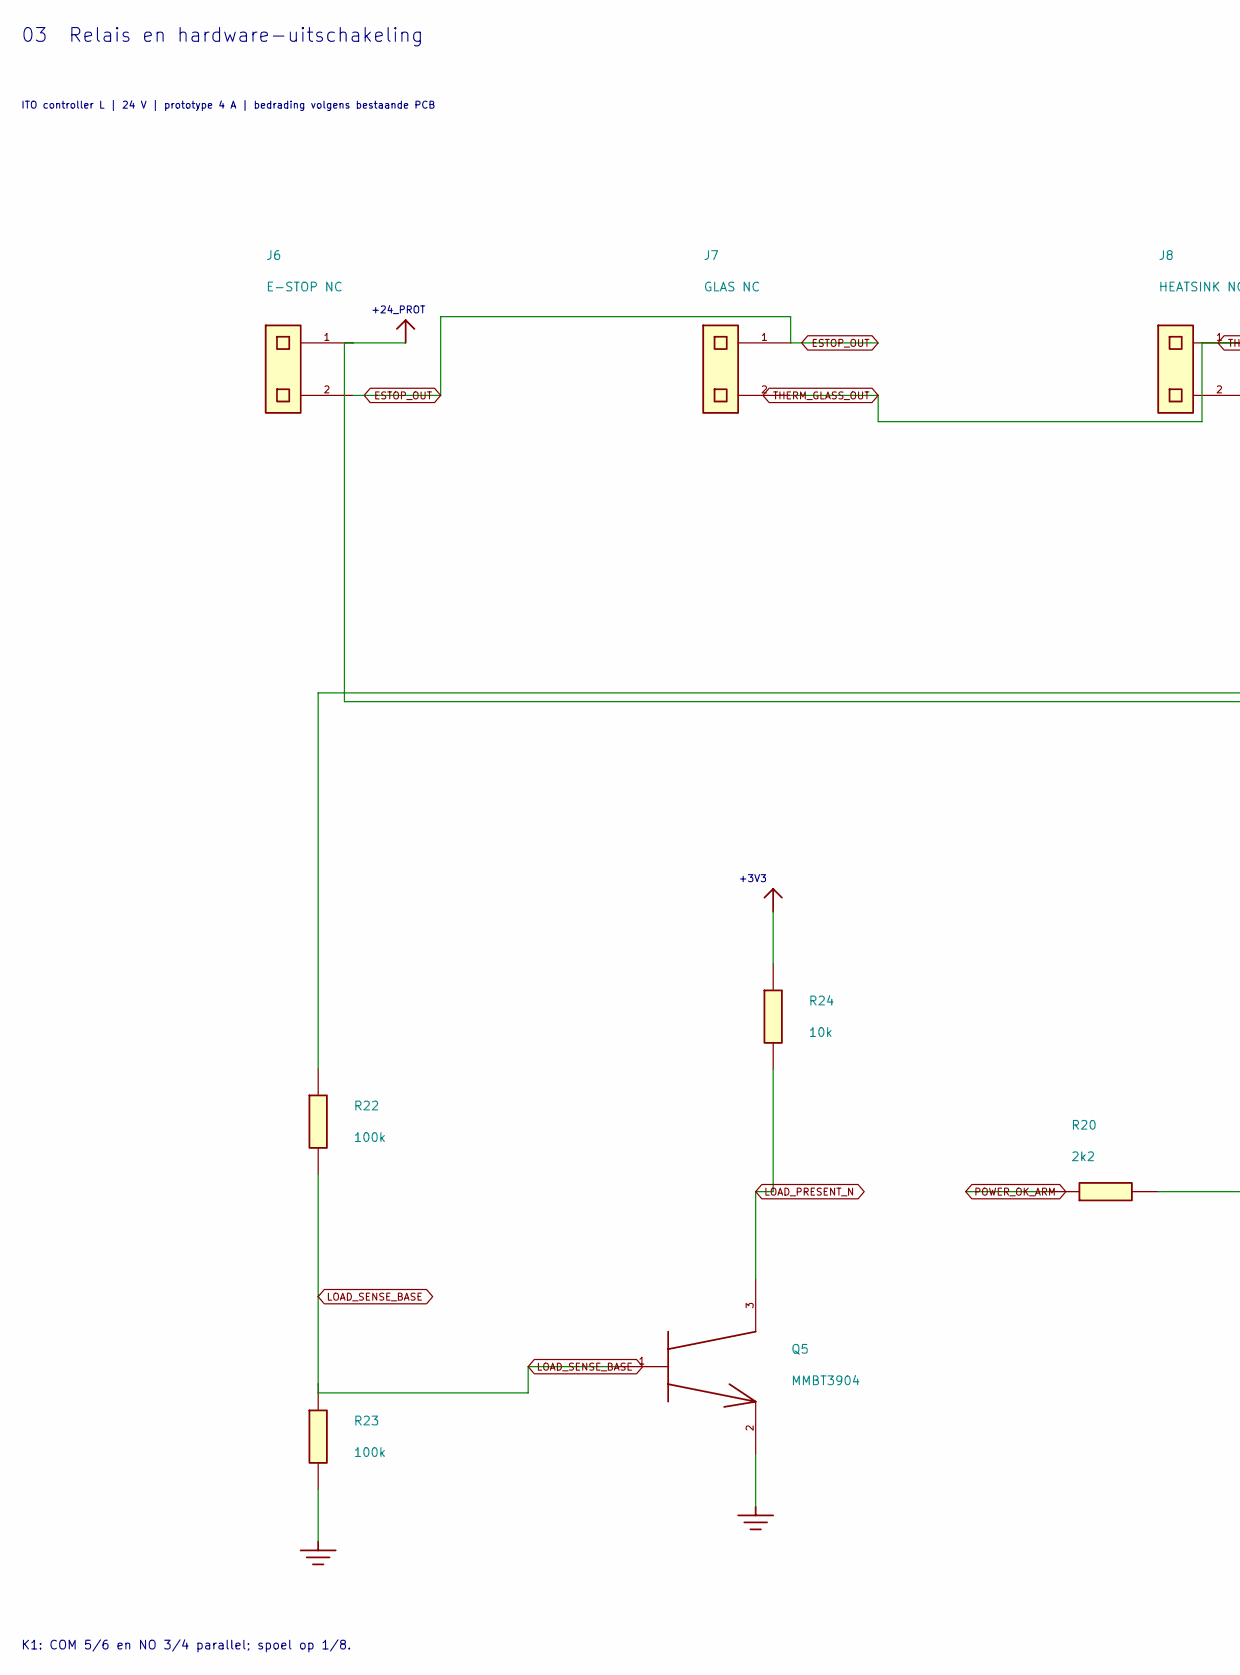
[picture p73: schematic sheet_03.kicad_sch, 03 Relais en hardware-uitschakeling, part in row 1, column 1]

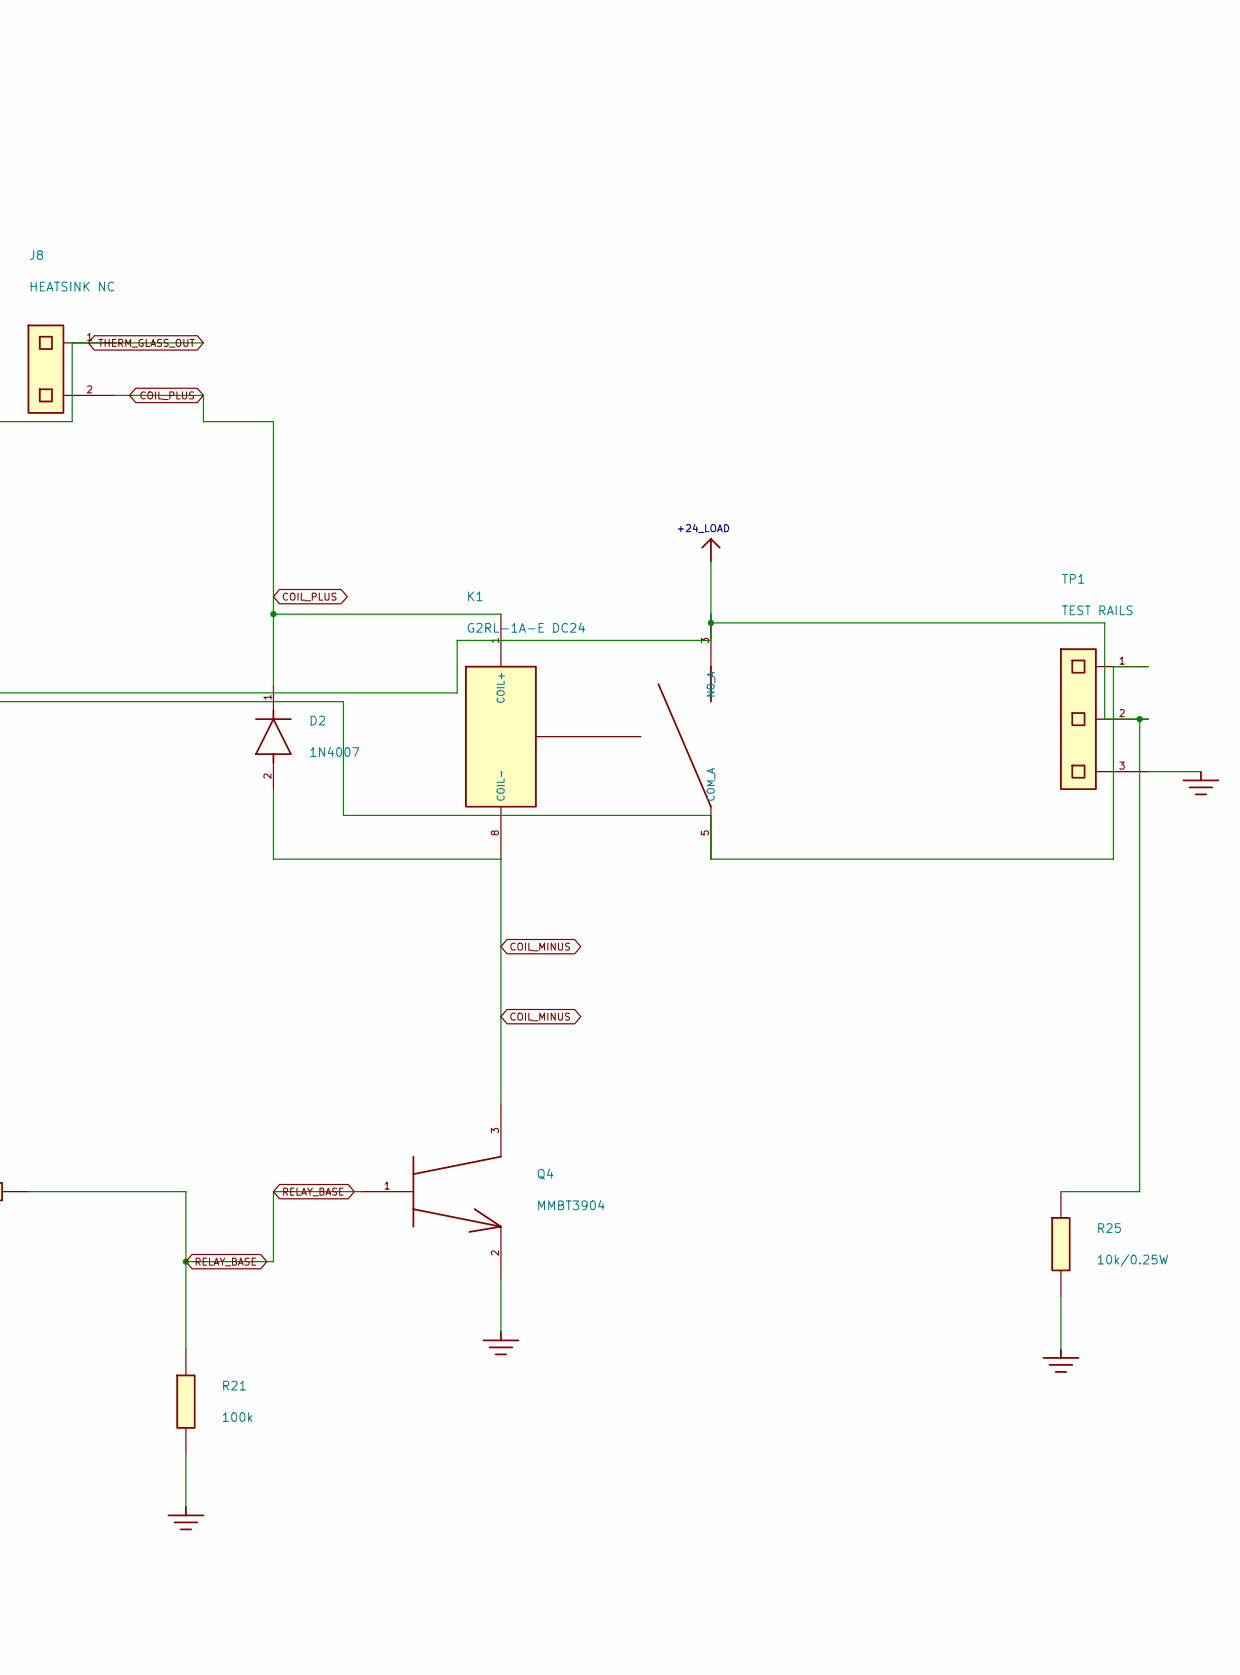
[picture p74: schematic sheet_03.kicad_sch, 03 Relais en hardware-uitschakeling, part in row 1, column 2]

Parts:
D2: 1N4007; D_DO-41_SOD81_P10.16mm_Horizontal; MPN 1N4007-E3/54
J6, J7, J8: Connector 2 pins; JST_XH_B2B-XH-A_1x02_P2.50mm_Vertical; MPN B2B-XH-A(LF)(SN)
K1: G2RL-1A-E DC24; G2RL_1A_E_review; MPN G2RL-1A-E DC24
Q4, Q5: MMBT3904; SOT-23; MPN MMBT3904LT1G
R20: 2k2; R_0805_2012Metric; MPN RC0805FR-072K2L
R21, R22, R23: 100k; R_0805_2012Metric; MPN RC0805FR-07100KL
R24: 10k; R_0805_2012Metric; MPN RC0805FR-0710KL
R25: 10k / 0.25W; R_0805_2012Metric; MPN ERJP06F1002V
TP1: Connector 3 pins; PinHeader_1x03_P2.54mm_Vertical; MPN TSW-103-07-G-S

Connections:
+3V3: R24.1; also elsewhere on the board
+24_LOAD: K1.3 (NO_A), K1.4 (NO_B), R22.1, R25.1, TP1.2; also elsewhere on the board
+24_PROT: J6.1, K1.5 (COM_A), K1.6 (COM_B), TP1.1; also elsewhere on the board
COIL_MINUS: D2.2, K1.8 (COIL-), Q4.3
COIL_PLUS: D2.1, J8.2, K1.1 (COIL+)
ESTOP_OUT: J6.2, J7.1
GND: Q4.2, Q5.2, R21.2, R23.2, R25.2, TP1.3; also elsewhere on the board
LOAD_PRESENT_N: Q5.3, R24.2; also elsewhere on the board
LOAD_SENSE_BASE: Q5.1, R22.2, R23.1
POWER_OK_ARM: R20.1; also elsewhere on the board
RELAY_BASE: Q4.1, R20.2, R21.1
THERM_GLASS_OUT: J7.2, J8.1

Notes on the sheet:
K1: COM 5/6 en NO 3/4 parallel; spoel op 1/8.
+24_PROT
+24_LOAD
+3V3
03 Relais en hardware-uitschakeling
ITO controller L | 24 V | prototype 4 A | bedrading volgens bestaande PCB

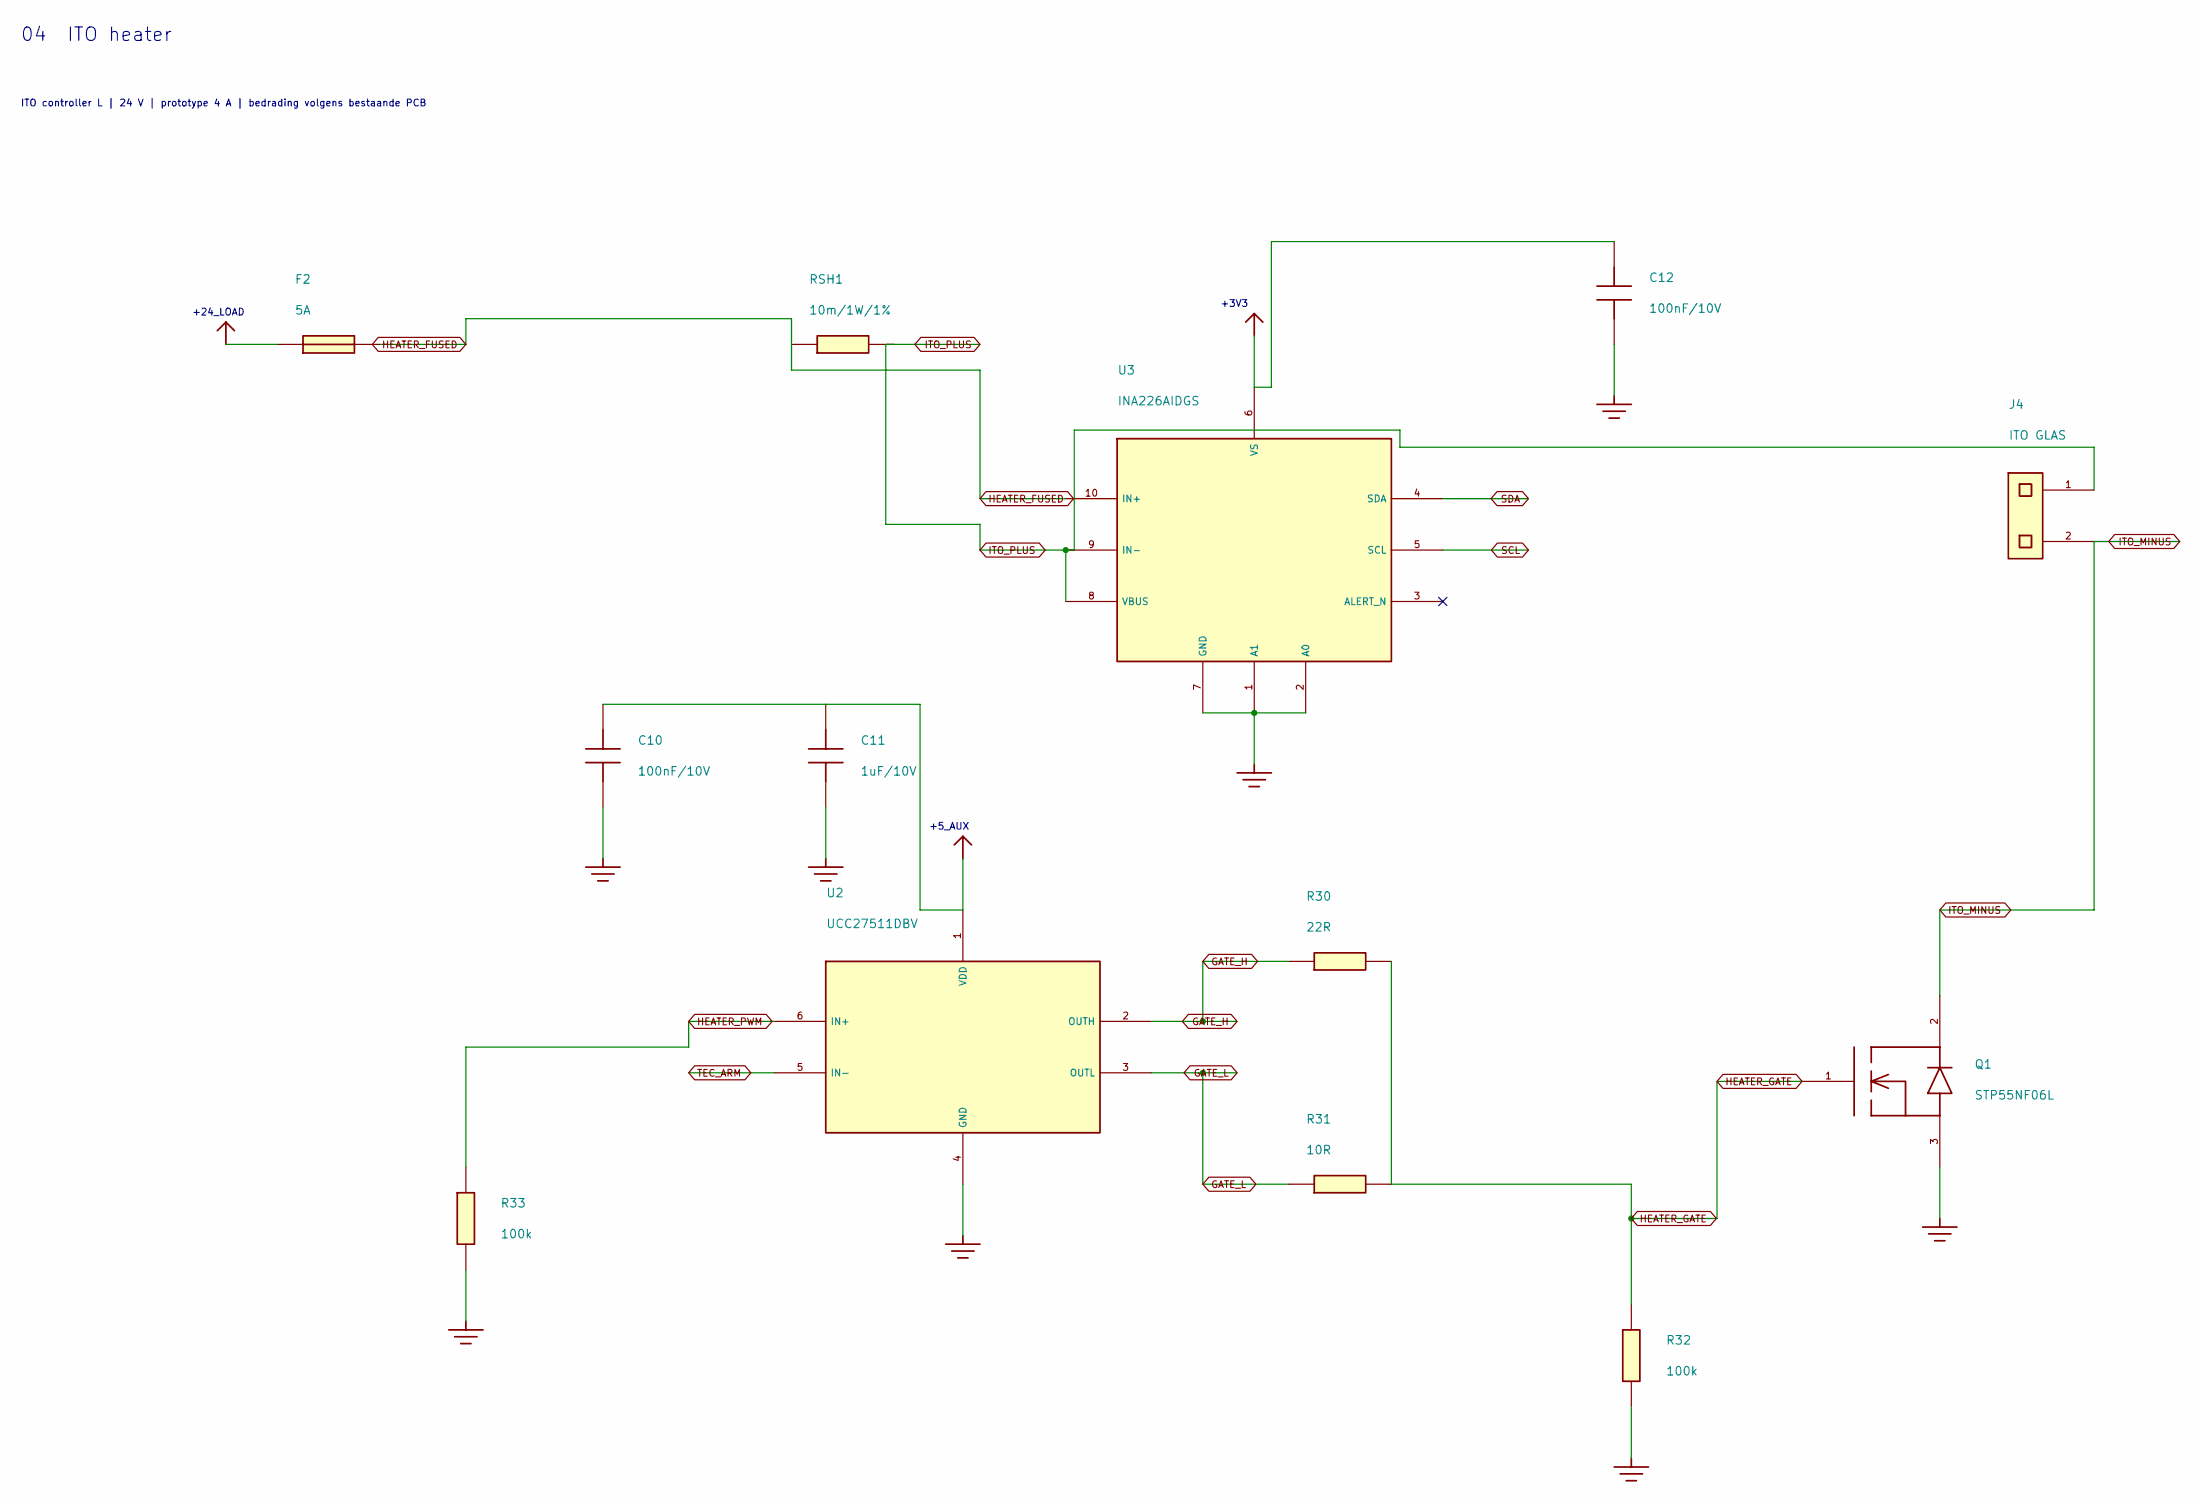
[picture p75: schematic sheet_04.kicad_sch, 04 ITO heater]

Parts:
C10, C12: 100n / 10V; C_0805_2012Metric; MPN GRM21BR71H104KA01L
C11: 1u / 10V; C_0805_2012Metric; MPN GRM21BR71H105KA12L
F2: 5A / 125V DC 0451005.MRL; Littelfuse_451; MPN 0451005.MRL
J4: Connector 2 pins; TerminalBlock_Phoenix_MKDS-1,5-2-5.08_1x02_P5.08mm_Horizont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; MPN 1715721
Q1: STP55NF06L; TO-220-3_Vertical; MPN STP55NF06L
R30: 22R; R_0805_2012Metric; MPN RC0805FR-0722RL
R31: 10R; R_0805_2012Metric; MPN RC0805FR-0710RL
R32, R33: 100k; R_0805_2012Metric; MPN RC0805FR-07100KL
RSH1: 10m / 1W / 1% WSL2512R0100FEA; WSL2512_7m_to_500m; MPN WSL2512R0100FEA
U2: UCC27511DBV; SOT-23-6; MPN UCC27511DBVR
U3: INA226AIDGS; VSSOP-10_3x3mm_P0.5mm; MPN INA226AIDGSR

Connections:
+3V3: C12.1, U3.6 (VS); also elsewhere on the board
+5_AUX: C10.1, C11.1, U2.1 (VDD); also elsewhere on the board
+24_LOAD: F2.1; also elsewhere on the board
GATE_H: R30.1, U2.2 (OUTH)
GATE_L: R31.1, U2.3 (OUTL)
GND: C10.2, C11.2, C12.2, Q1.3, R32.2, R33.2, U2.4 (GND), U3.1 (A1), U3.2 (A0), U3.7 (GND); also elsewhere on the board
HEATER_FUSED: F2.2, RSH1.1, U3.10 (IN+)
HEATER_GATE: Q1.1, R30.2, R31.2, R32.1
HEATER_PWM: R33.1, U2.6 (IN+); also elsewhere on the board
ITO_MINUS: J4.2, Q1.2
ITO_PLUS: J4.1, RSH1.2, U3.8 (VBUS), U3.9 (IN-)
SCL: U3.5 (SCL); also elsewhere on the board
SDA: U3.4 (SDA); also elsewhere on the board
TEC_ARM: U2.5 (IN-); also elsewhere on the board

Notes on the sheet:
+24_LOAD
+5_AUX
+3V3
04 ITO heater
ITO controller L | 24 V | prototype 4 A | bedrading volgens bestaande PCB
