luciddreams/ito-controller/ito-controller.kicad_pcb

## KiCad design ito-controller.kicad_pcb (continued)

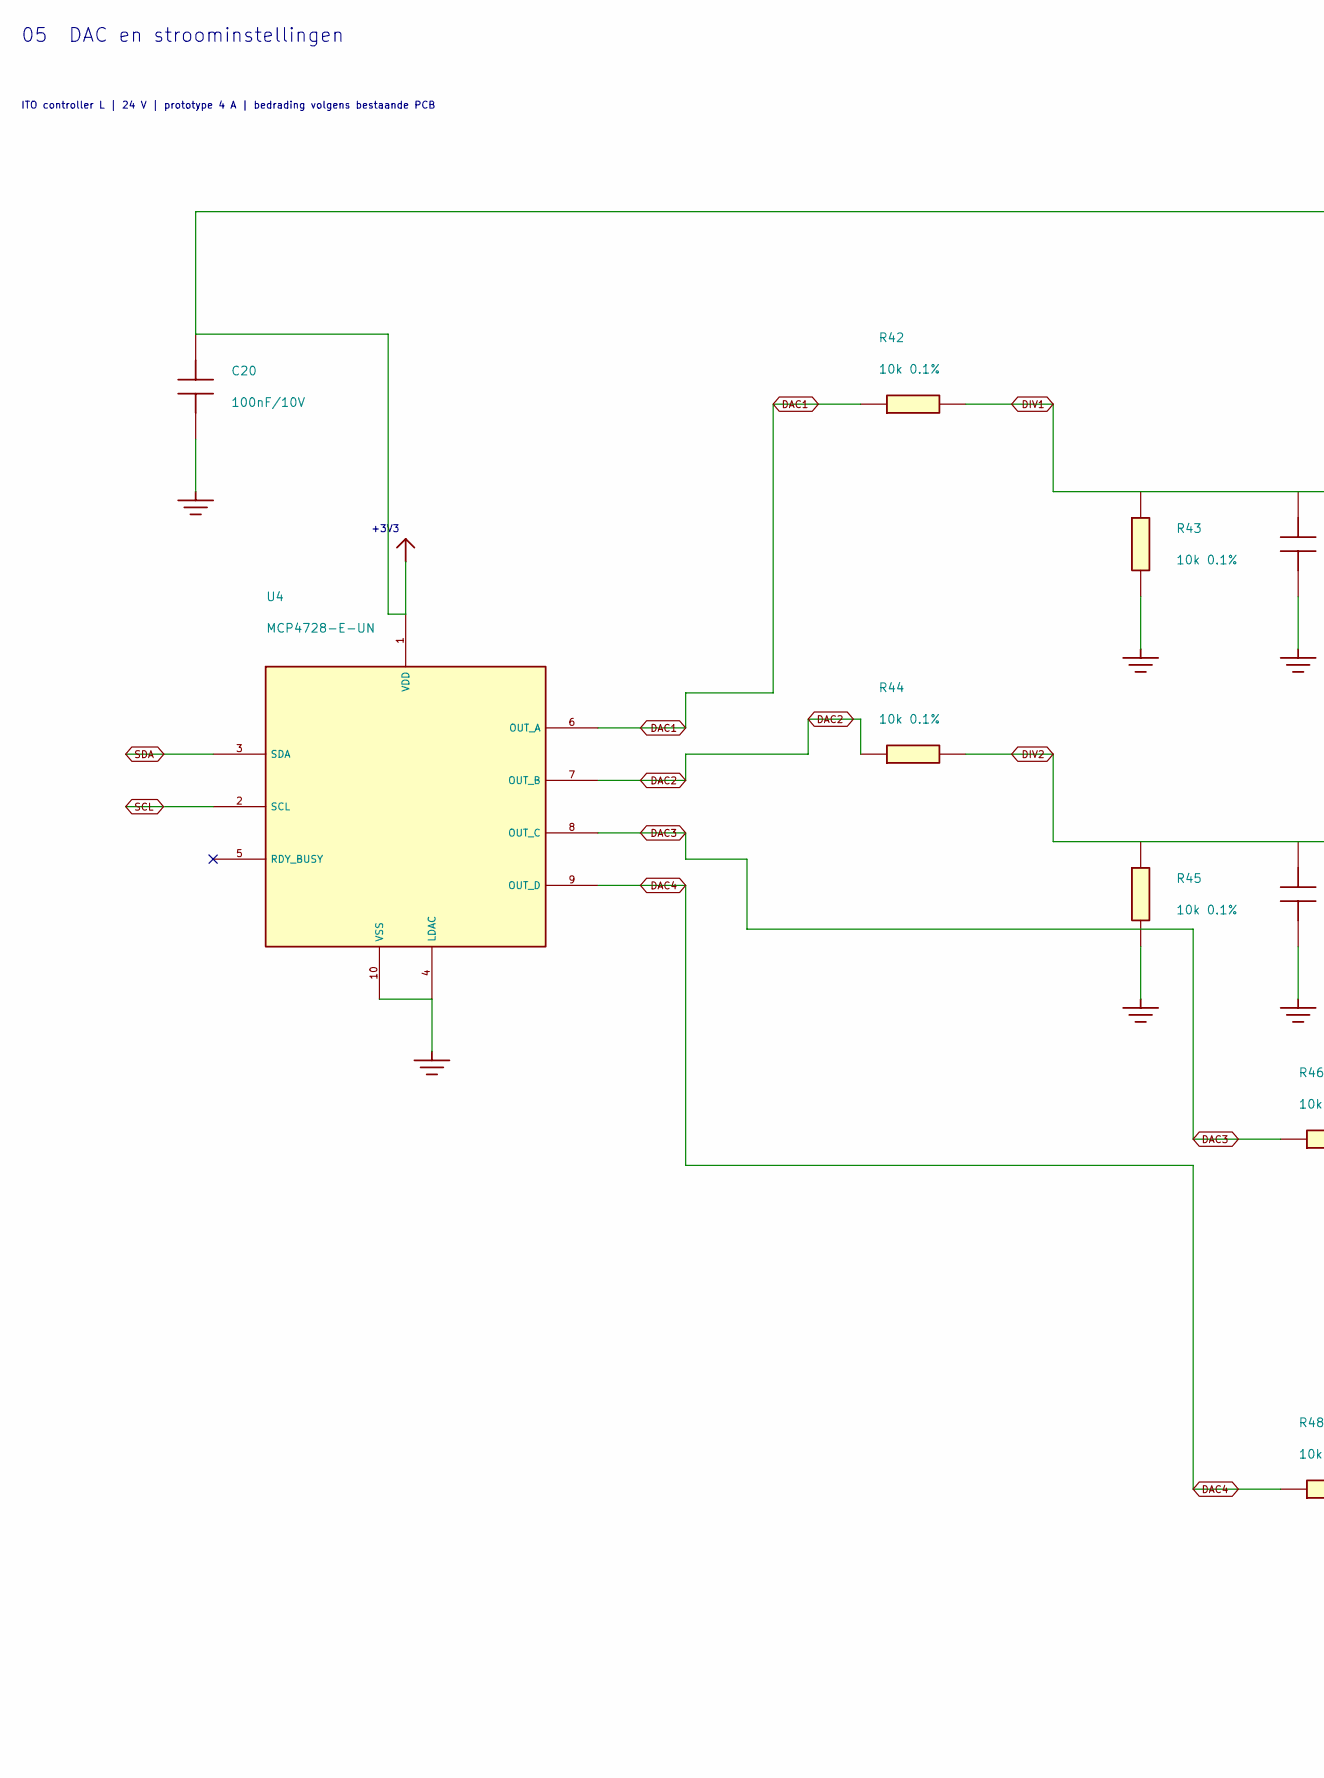
[picture p76: schematic sheet_05.kicad_sch, 05 DAC en stroominstellingen, part in row 1, column 1]

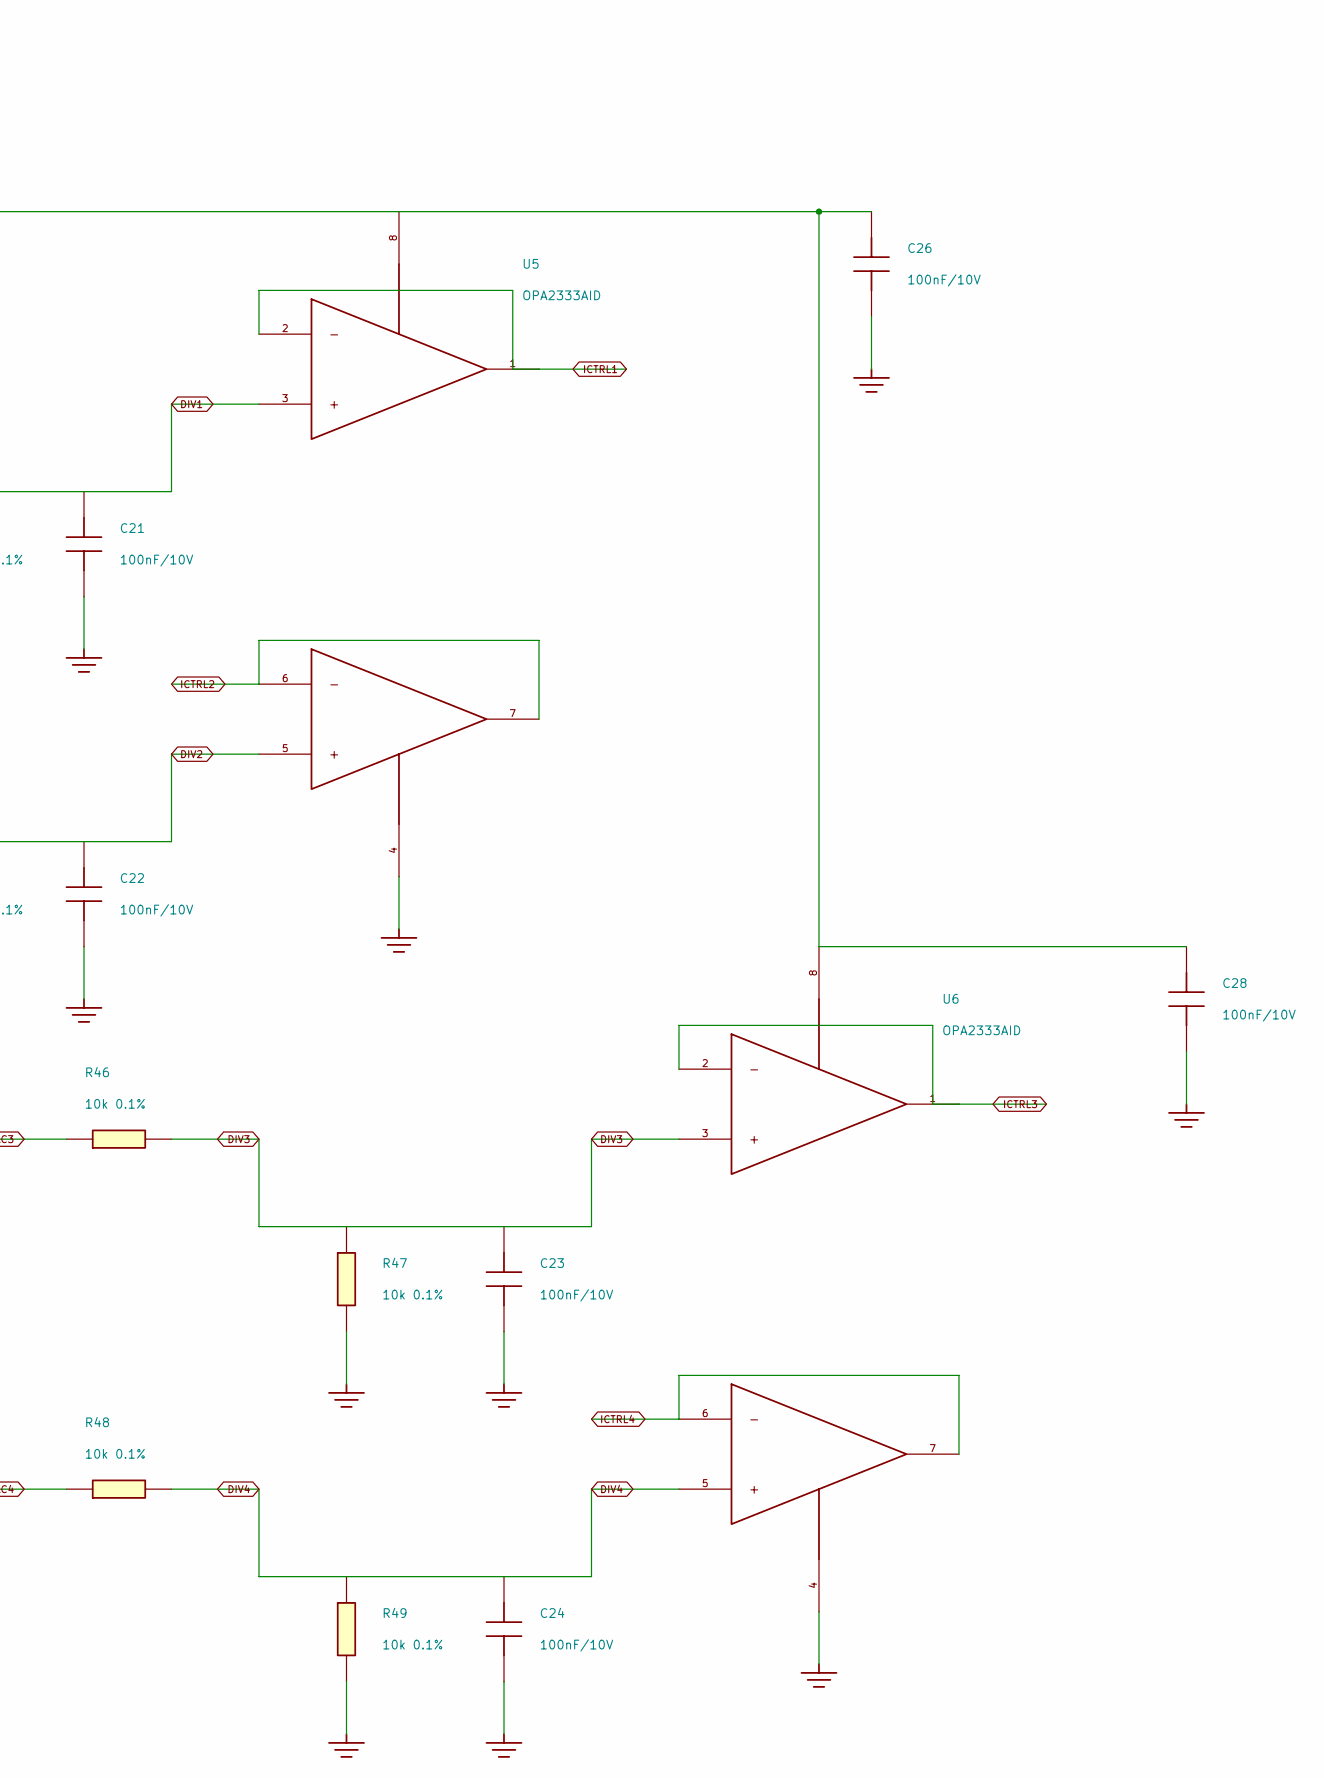
[picture p77: schematic sheet_05.kicad_sch, 05 DAC en stroominstellingen, part in row 1, column 2]

Parts:
C20, C21, C22, C23, C24, C26, C28: 100n / 10V; C_0805_2012Metric; MPN GRM21BR71H104KA01L
R42, R43, R44, R45, R46, R47, R48, R49: 10k 0.1%; R_0805_2012Metric; MPN RT0805BRD0710KL
U4: MCP4728-E-UN; MSOP-10_3x3mm_P0.5mm; MPN MCP4728-E/UN
U5, U6: OPA2333AID; SOIC-8_3.9x4.9mm_P1.27mm; MPN OPA2333AIDR

Connections:
+3V3: C20.1, C26.1, C28.1, U4.1 (VDD), U5.8 (V+), U6.8 (V+); also elsewhere on the board
DAC1: R42.1, U4.6 (OUT_A)
DAC2: R44.1, U4.7 (OUT_B)
DAC3: R46.1, U4.8 (OUT_C)
DAC4: R48.1, U4.9 (OUT_D)
DIV1: C21.1, R42.2, R43.1, U5.3 (IN+_A)
DIV2: C22.1, R44.2, R45.1, U5.5 (IN+_B)
DIV3: C23.1, R46.2, R47.1, U6.3 (IN+_A)
DIV4: C24.1, R48.2, R49.1, U6.5 (IN+_B)
GND: C20.2, C21.2, C22.2, C23.2, C24.2, C26.2, C28.2, R43.2, R45.2, R47.2, R49.2, U4.4 (LDAC), U4.10 (VSS), U5.4 (V-), U6.4 (V-); also elsewhere on the board
ICTRL1: U5.1 (OUT_A), U5.2 (IN-_A); also elsewhere on the board
ICTRL2: U5.6 (IN-_B), U5.7 (OUT_B); also elsewhere on the board
ICTRL3: U6.1 (OUT_A), U6.2 (IN-_A); also elsewhere on the board
ICTRL4: U6.6 (IN-_B), U6.7 (OUT_B); also elsewhere on the board
SCL: U4.2 (SCL); also elsewhere on the board
SDA: U4.3 (SDA); also elsewhere on the board

Notes on the sheet:
+3V3
05 DAC en stroominstellingen
ITO controller L | 24 V | prototype 4 A | bedrading volgens bestaande PCB

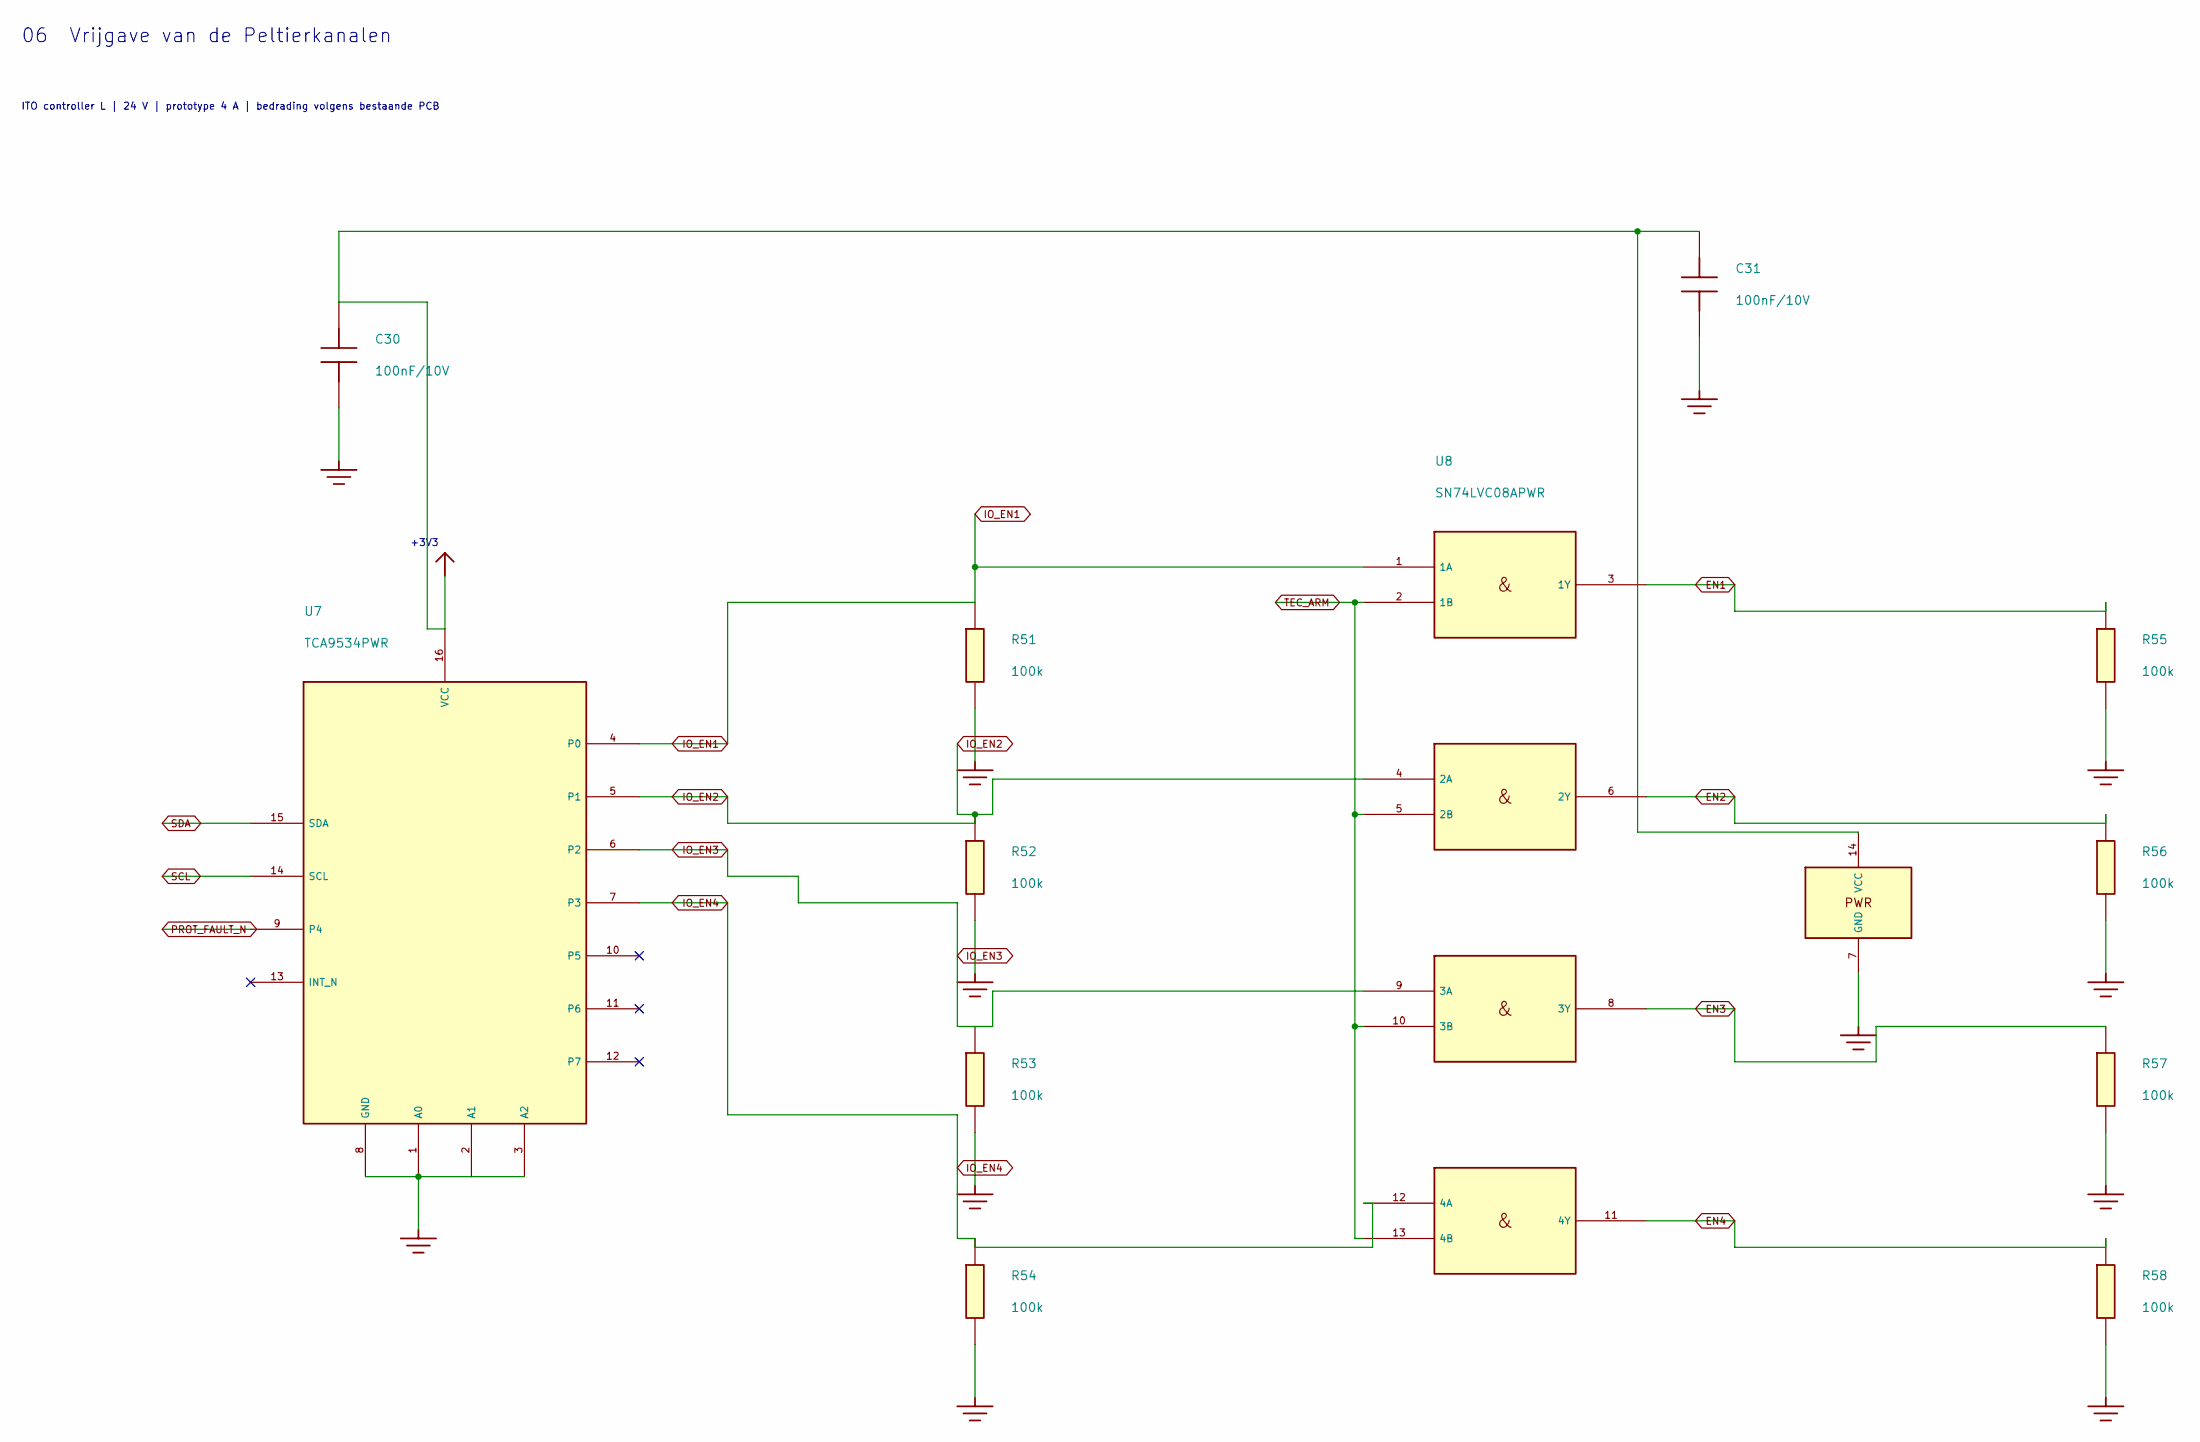
[picture p78: schematic sheet_06.kicad_sch, 06 Vrijgave van de Peltierkanalen]

Parts:
C30, C31: 100n / 10V; C_0805_2012Metric; MPN GRM21BR71H104KA01L
R51, R52, R53, R54, R55, R56, R57, R58: 100k; R_0805_2012Metric; MPN RC0805FR-07100KL
U7: TCA9534PWR; TSSOP-16_4.4x5mm_P0.65mm; MPN TCA9534PWR
U8: SN74LVC08APWR; TSSOP-14_4.4x5mm_P0.65mm; MPN SN74LVC08APWR

Connections:
+3V3: C30.1, C31.1, U7.16 (VCC), U8.14 (VCC); also elsewhere on the board
EN1: R55.1, U8.3 (1Y); also elsewhere on the board
EN2: R56.1, U8.6 (2Y); also elsewhere on the board
EN3: R57.1, U8.8 (3Y); also elsewhere on the board
EN4: R58.1, U8.11 (4Y); also elsewhere on the board
GND: C30.2, C31.2, R51.2, R52.2, R53.2, R54.2, R55.2, R56.2, R57.2, R58.2, U7.1 (A0), U7.2 (A1), U7.3 (A2), U7.8 (GND), U8.7 (GND); also elsewhere on the board
IO_EN1: R51.1, U7.4 (P0), U8.1 (1A)
IO_EN2: R52.1, U7.5 (P1), U8.4 (2A)
IO_EN3: R53.1, U7.6 (P2), U8.9 (3A)
IO_EN4: R54.1, U7.7 (P3), U8.12 (4A)
PROT_FAULT_N: U7.9 (P4); also elsewhere on the board
SCL: U7.14 (SCL); also elsewhere on the board
SDA: U7.15 (SDA); also elsewhere on the board
TEC_ARM: U8.2 (1B), U8.5 (2B), U8.10 (3B), U8.13 (4B); also elsewhere on the board

Notes on the sheet:
+3V3
06 Vrijgave van de Peltierkanalen
ITO controller L | 24 V | prototype 4 A | bedrading volgens bestaande PCB

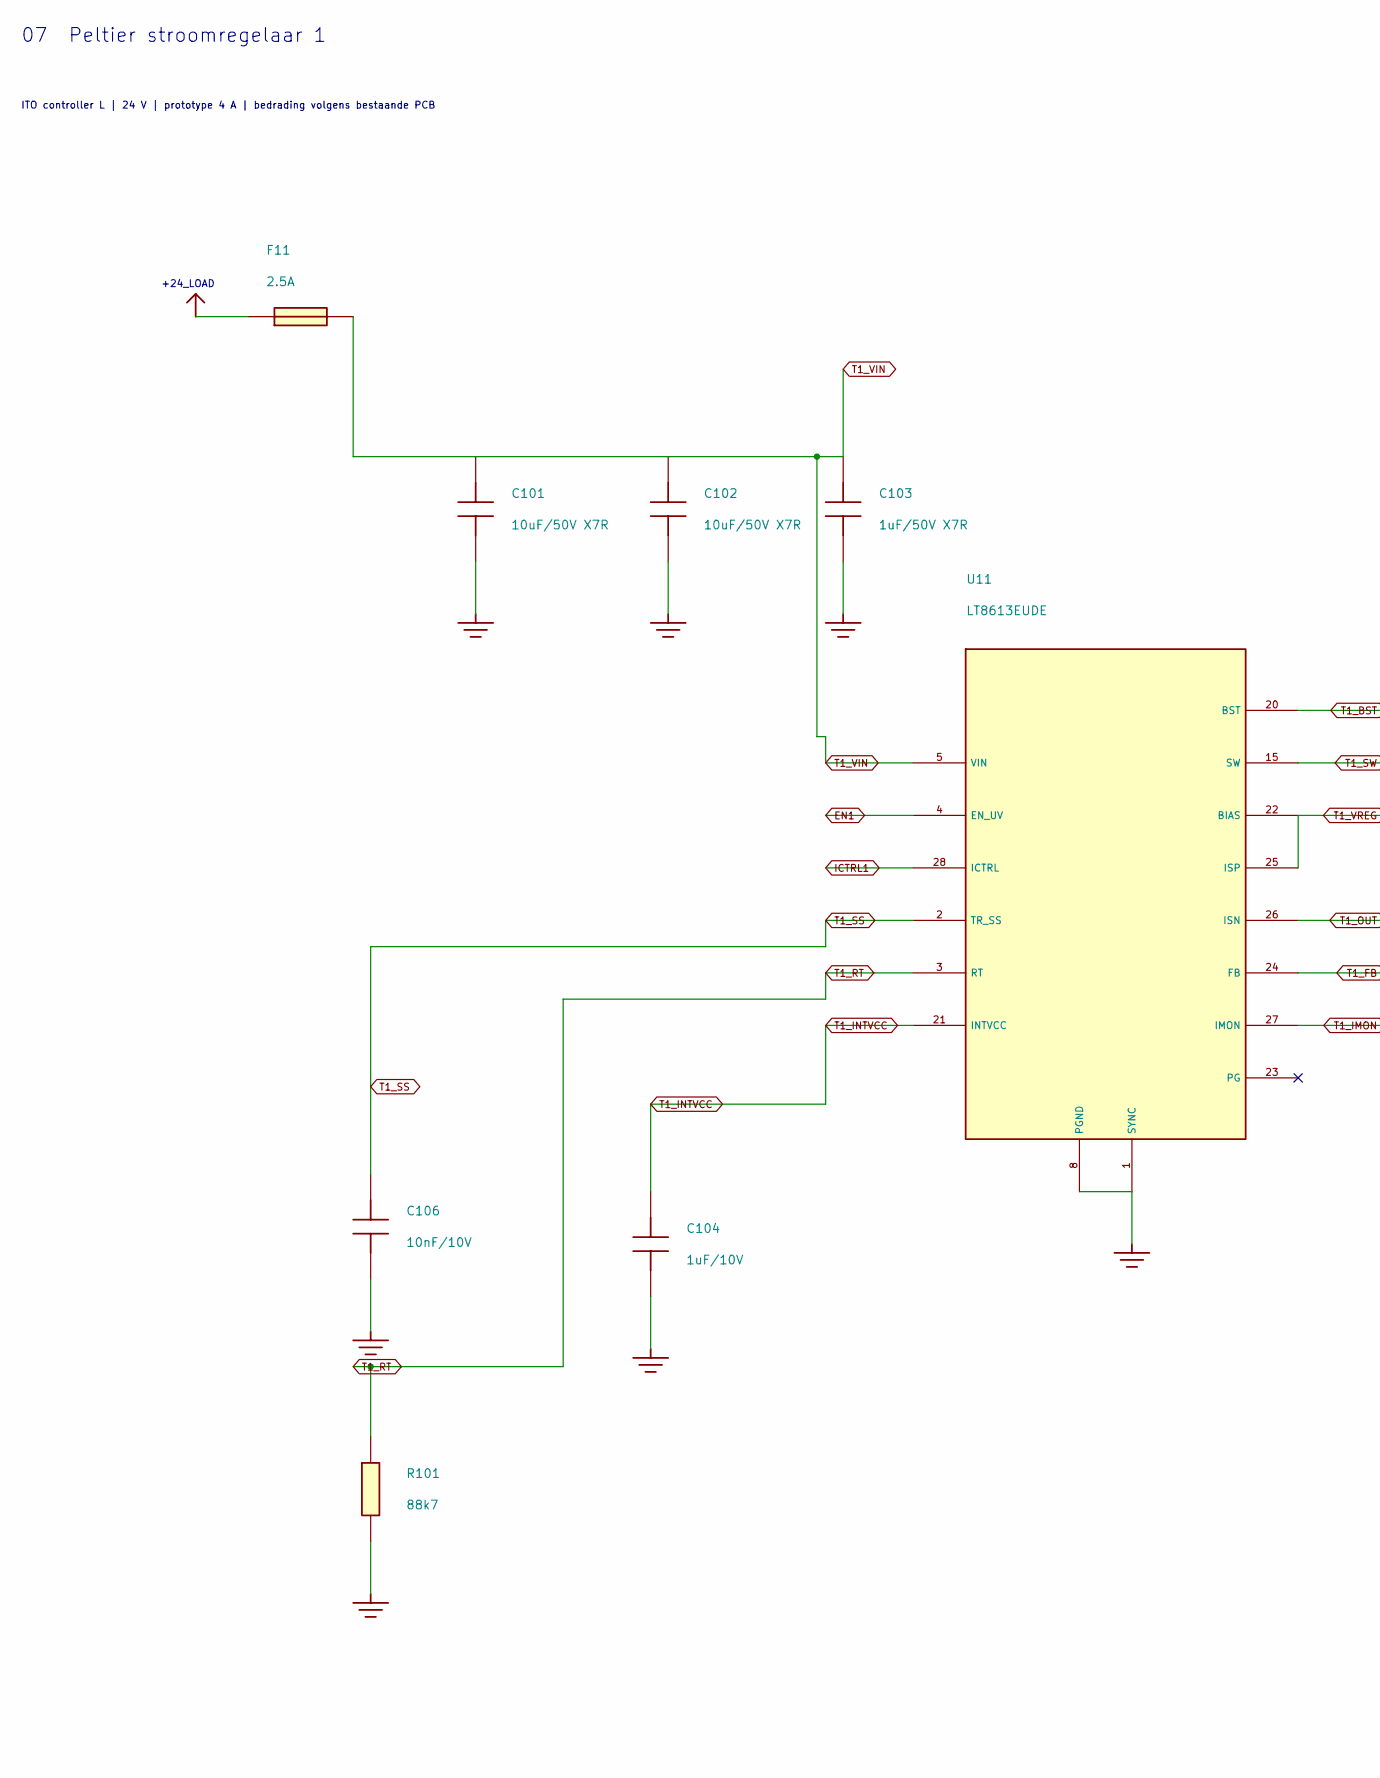
[picture p79: schematic sheet_07.kicad_sch, 07 Peltier stroomregelaar 1, part in row 1, column 1]

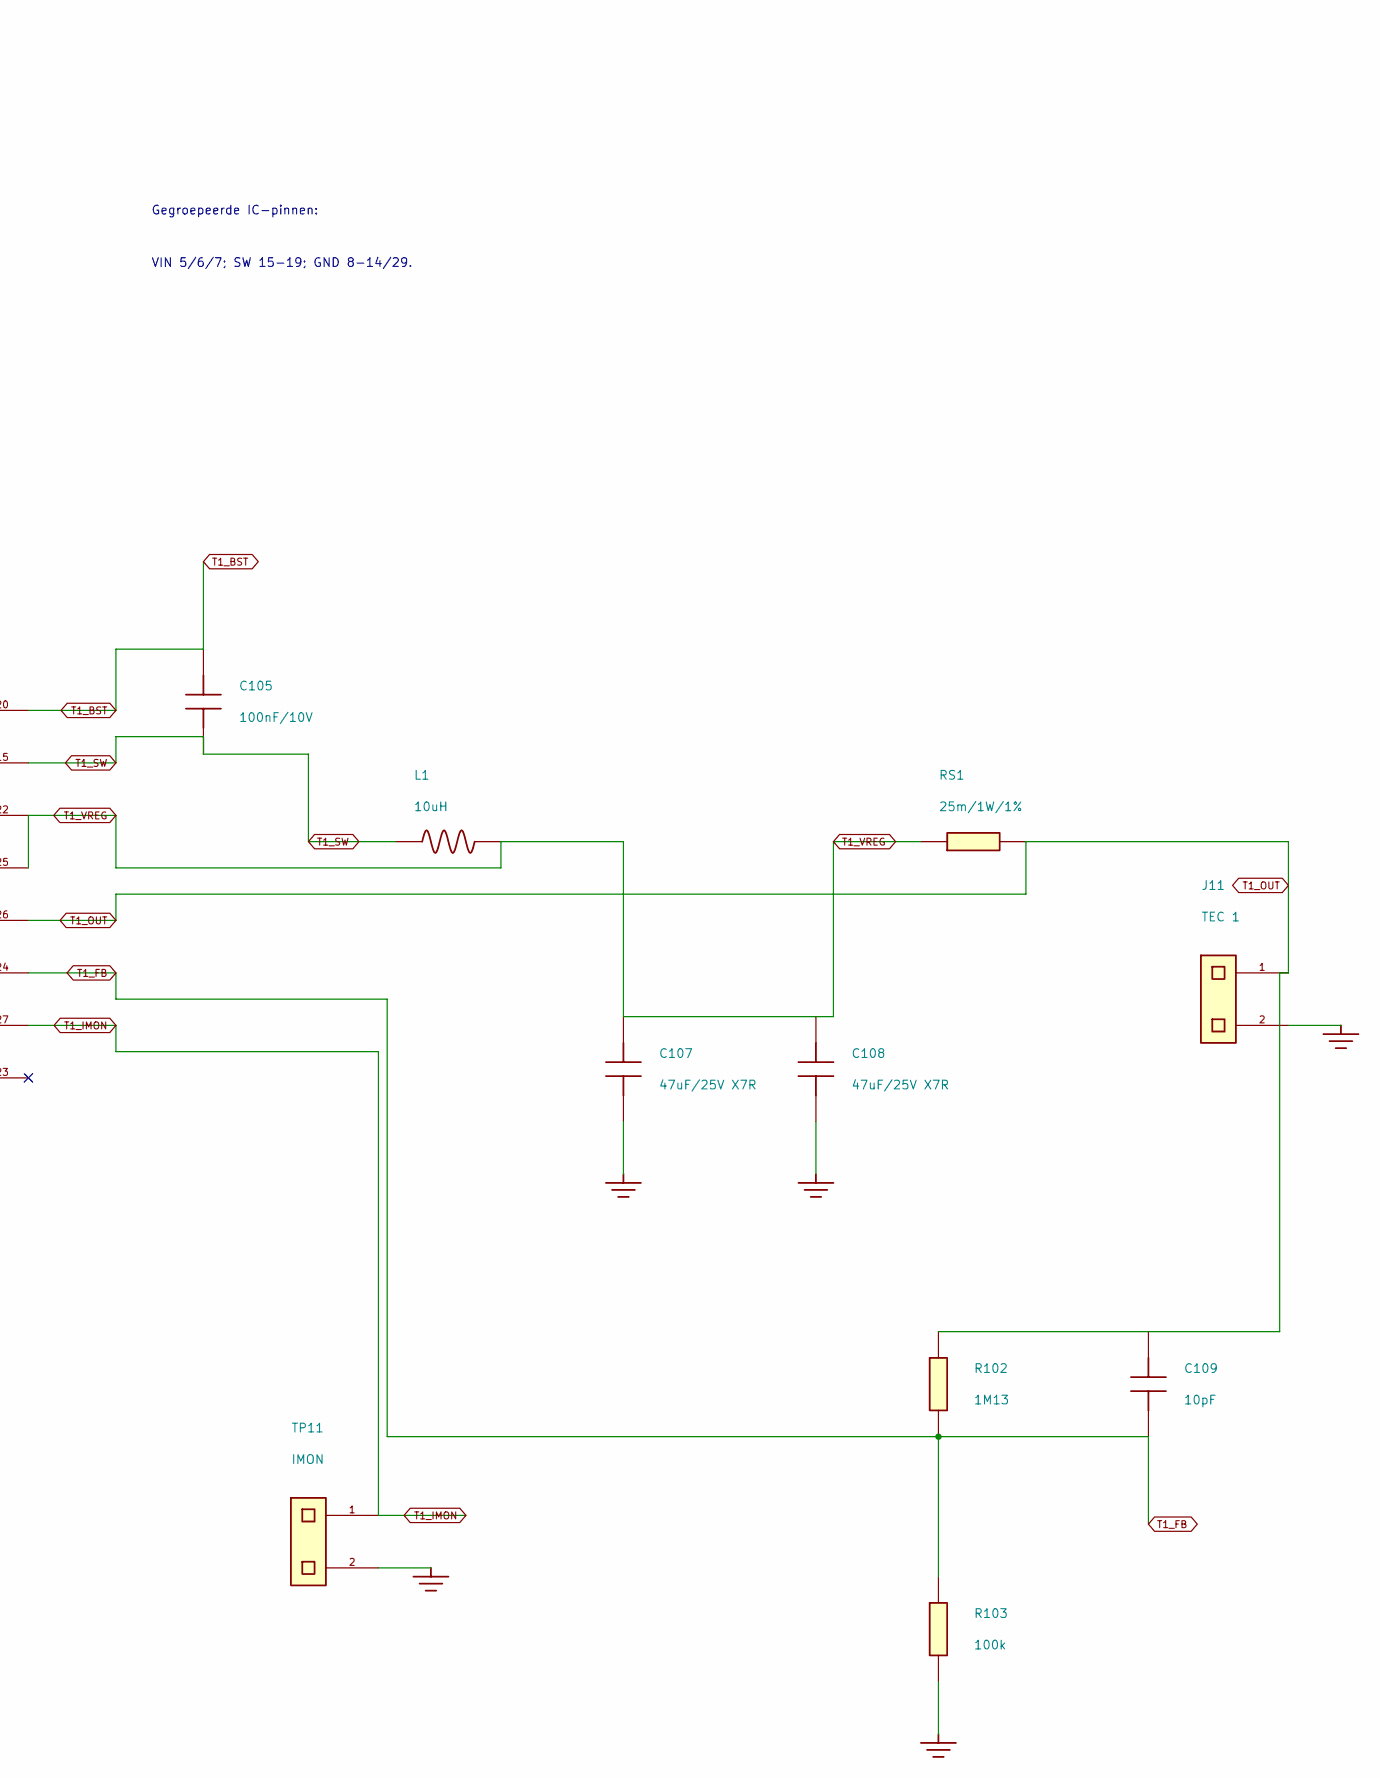
[picture p80: schematic sheet_07.kicad_sch, 07 Peltier stroomregelaar 1, part in row 1, column 2]

Parts:
C101, C102: 10u / 50V X7R; C_1210_3225Metric; MPN GRM32ER71H106KA12L
C103: 1u / 50V X7R; C_0805_2012Metric; MPN GRM21BR71H105KA12L
C104: 1u / 10V; C_0805_2012Metric; MPN GRM21BR71H105KA12L
C105: 100n / 10V; C_0805_2012Metric; MPN GRM21BR71H104KA01L
C106: 10n / 10V; C_0805_2012Metric; MPN GRM21BR71H103KA01L
C107, C108: 47u / 25V X7R C2220C476M3R2C7186; KEMET_KPS_2220_Double; MPN C2220C476M3R2C7186
C109: 10p C0G; C_0805_2012Metric; MPN C0805C100J5GACTU
F11: 2.5A / 125V DC 045102.5MRL; Littelfuse_451; MPN 045102.5MRL
J11: Connector 2 pins; TerminalBlock_Phoenix_MKDS-1,5-2-5.08_1x02_P5.08mm_Horizont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; MPN 1715721
L1: 10uH IHLP6767GZEK100M11; L_Vishay_IHLP-6767; MPN IHLP6767GZEK100M11
R101: 88k7 1%; R_0805_2012Metric; MPN RC0805FR-0788K7L
R102: 1M13 1%; R_0805_2012Metric; MPN RC0805FR-071M13L
R103: 100k 1%; R_0805_2012Metric; MPN RC0805FR-07100KL
RS1: 25m / 1W / 1% WSL2512R0250FEA; WSL2512_7m_to_500m; MPN WSL2512R0250FEA
TP11: Connector 2 pins; PinHeader_1x02_P2.54mm_Vertical; MPN TSW-102-07-G-S
U11: LT8613EUDE; QFN-28-1EP_3x6mm_P0.5mm_EP1.7x4.75mm; MPN LT8613EUDE#PBF

Connections:
+24_LOAD: F11.1; also elsewhere on the board
EN1: U11.4 (EN_UV); also elsewhere on the board
GND: C101.2, C102.2, C103.2, C104.2, C106.2, C107.2, C108.2, J11.2, R101.2, R103.2, TP11.2, U11.1 (SYNC), U11.8 (PGND), U11.9 (PGND), U11.10 (PGND), U11.11 (GND), U11.12 (GND), U11.13 (GND), U11.14 (GND), U11.29 (EP_GND); also elsewhere on the board
ICTRL1: U11.28 (ICTRL); also elsewhere on the board
T1_BST: C105.1, U11.20 (BST)
T1_FB: C109.2, R102.2, R103.1, U11.24 (FB)
T1_IMON: TP11.1, U11.27 (IMON)
T1_INTVCC: C104.1, U11.21 (INTVCC)
T1_OUT: C109.1, J11.1, R102.1, RS1.2, U11.26 (ISN)
T1_RT: R101.1, U11.3 (RT)
T1_SS: C106.1, U11.2 (TR_SS)
T1_SW: C105.2, L1.1, U11.15 (SW), U11.16 (SW), U11.17 (SW), U11.18 (SW), U11.19 (SW)
T1_VIN: C101.1, C102.1, C103.1, F11.2, U11.5 (VIN), U11.6 (VIN), U11.7 (VIN)
T1_VREG: C107.1, C108.1, L1.2, RS1.1, U11.22 (BIAS), U11.25 (ISP)

Notes on the sheet:
Gegroepeerde IC-pinnen:
VIN 5/6/7; SW 15-19; GND 8-14/29.
+24_LOAD
07 Peltier stroomregelaar 1
ITO controller L | 24 V | prototype 4 A | bedrading volgens bestaande PCB

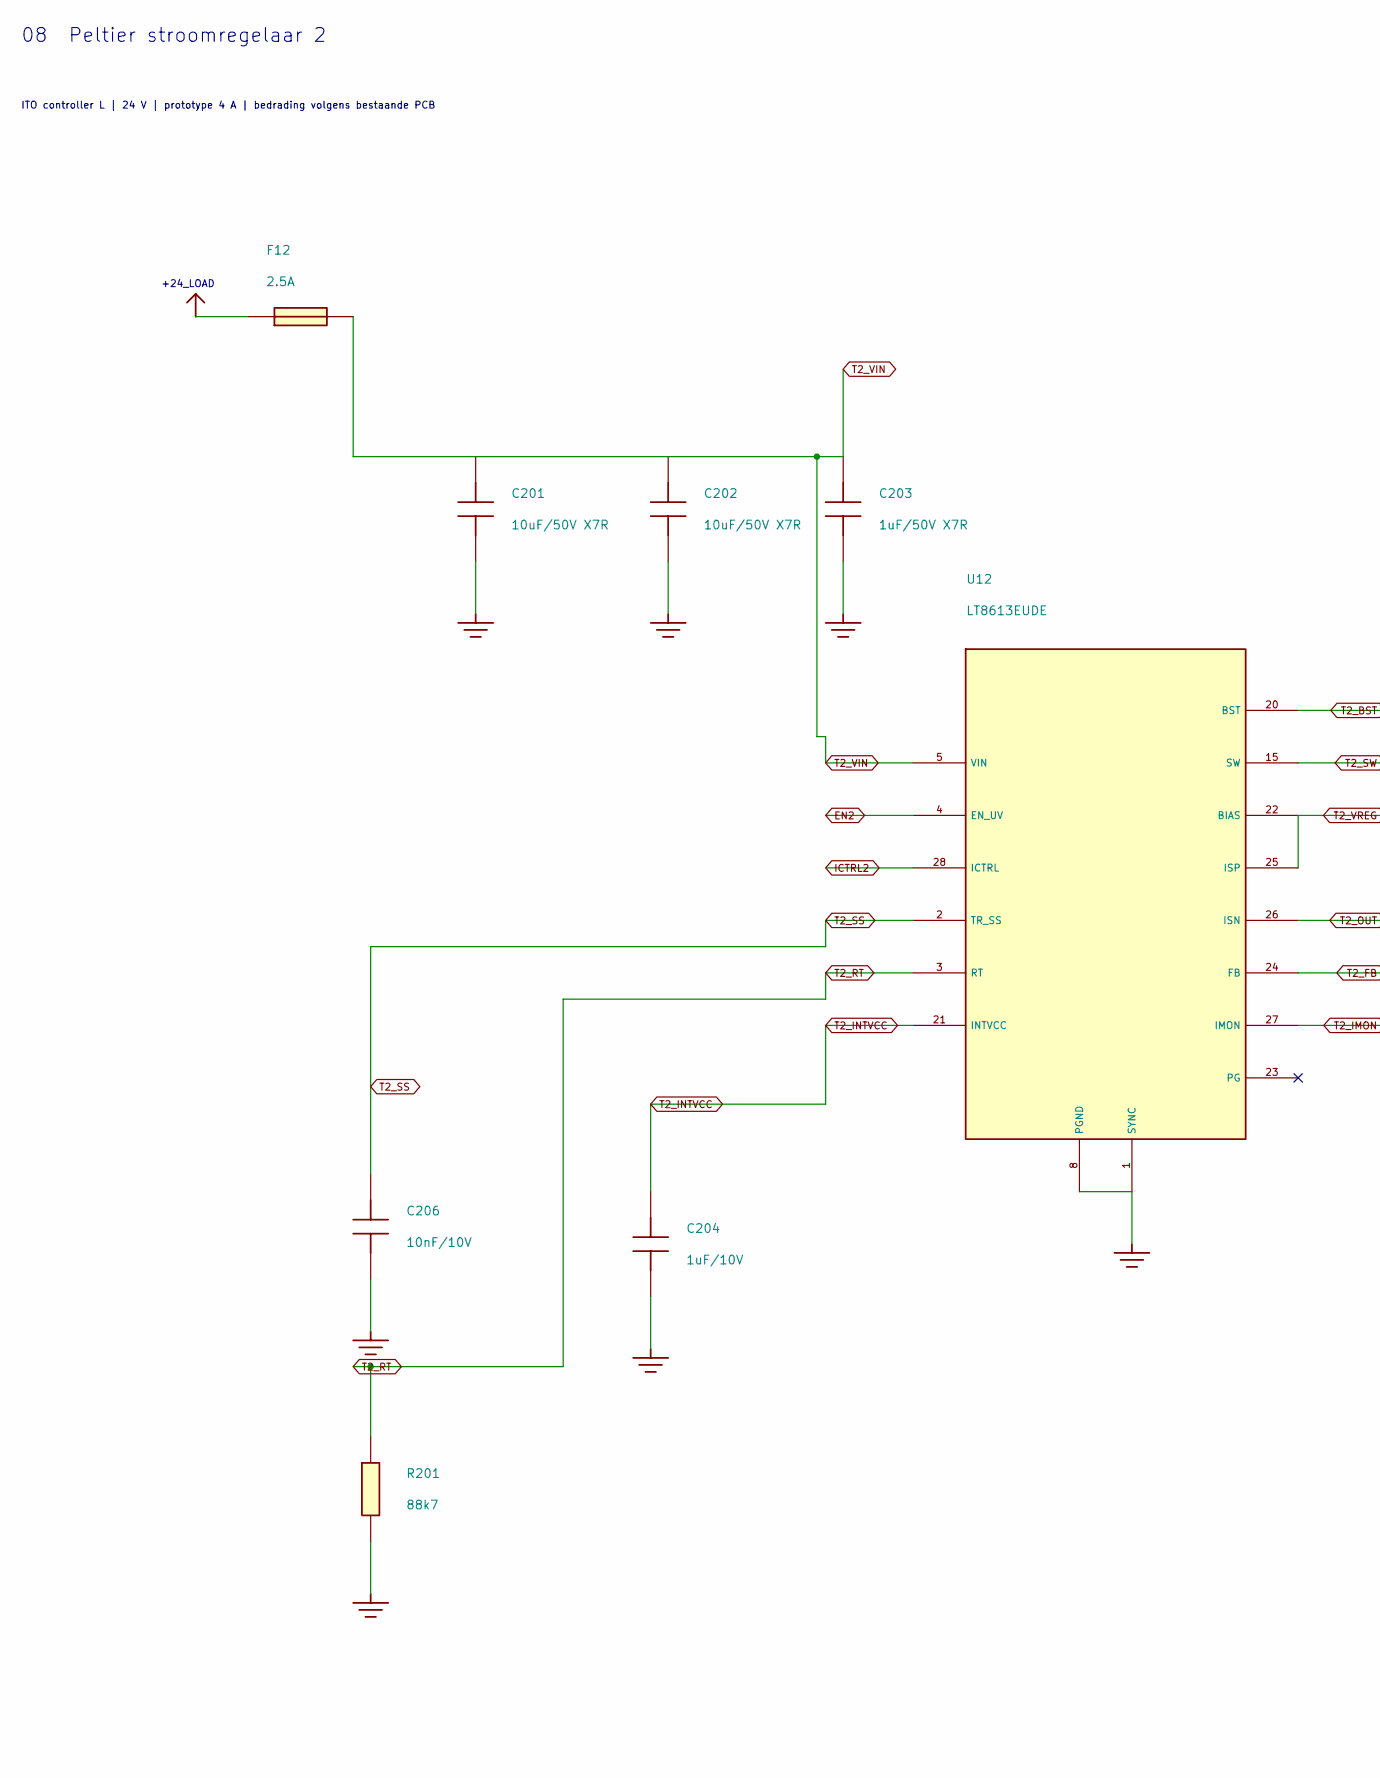
[picture p81: schematic sheet_08.kicad_sch, 08 Peltier stroomregelaar 2, part in row 1, column 1]

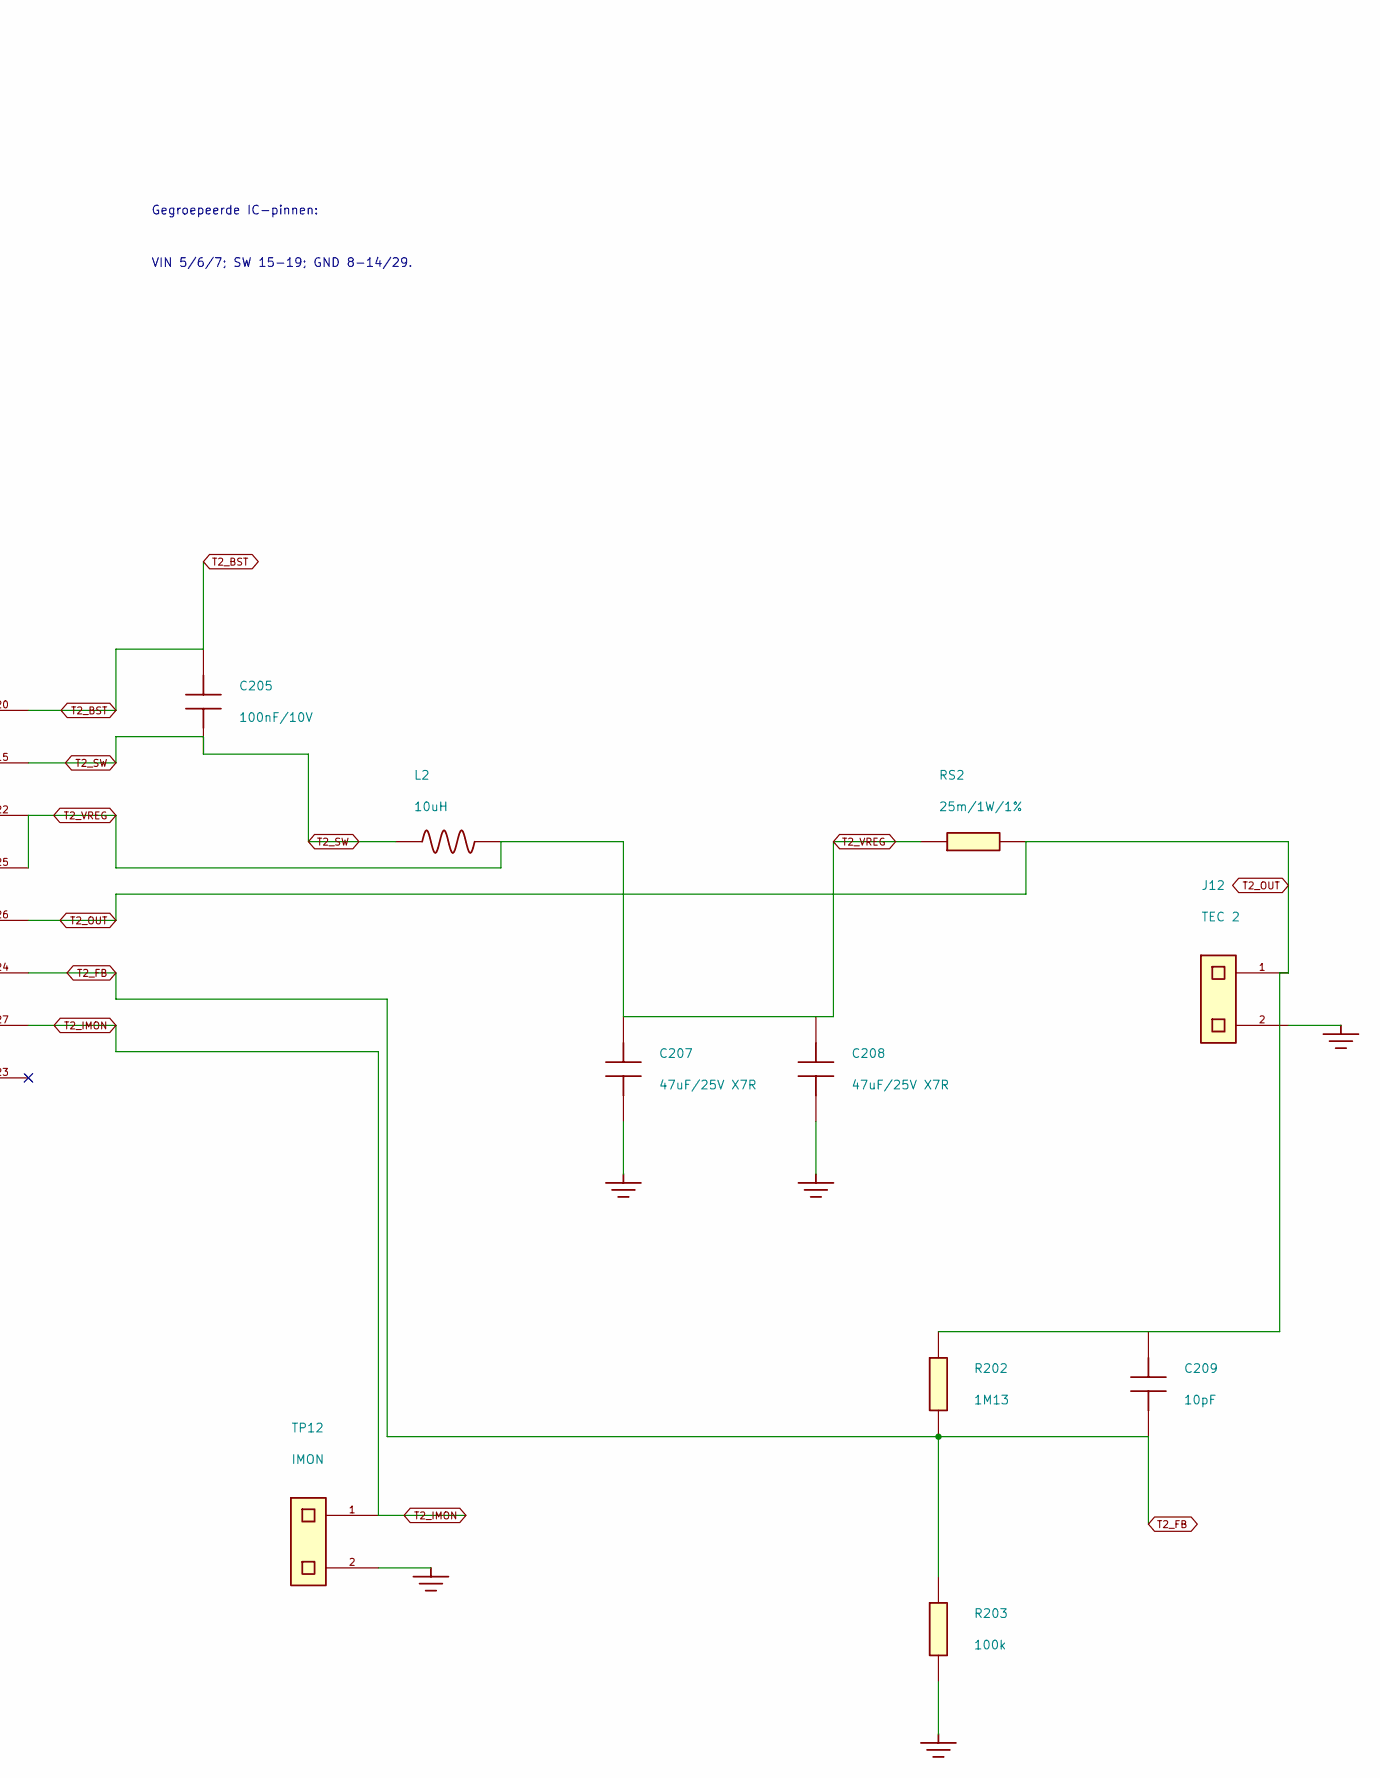
[picture p82: schematic sheet_08.kicad_sch, 08 Peltier stroomregelaar 2, part in row 1, column 2]

Parts:
C201, C202: 10u / 50V X7R; C_1210_3225Metric; MPN GRM32ER71H106KA12L
C203: 1u / 50V X7R; C_0805_2012Metric; MPN GRM21BR71H105KA12L
C204: 1u / 10V; C_0805_2012Metric; MPN GRM21BR71H105KA12L
C205: 100n / 10V; C_0805_2012Metric; MPN GRM21BR71H104KA01L
C206: 10n / 10V; C_0805_2012Metric; MPN GRM21BR71H103KA01L
C207, C208: 47u / 25V X7R C2220C476M3R2C7186; KEMET_KPS_2220_Double; MPN C2220C476M3R2C7186
C209: 10p C0G; C_0805_2012Metric; MPN C0805C100J5GACTU
F12: 2.5A / 125V DC 045102.5MRL; Littelfuse_451; MPN 045102.5MRL
J12: Connector 2 pins; TerminalBlock_Phoenix_MKDS-1,5-2-5.08_1x02_P5.08mm_Horizont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; MPN 1715721
L2: 10uH IHLP6767GZEK100M11; L_Vishay_IHLP-6767; MPN IHLP6767GZEK100M11
R201: 88k7 1%; R_0805_2012Metric; MPN RC0805FR-0788K7L
R202: 1M13 1%; R_0805_2012Metric; MPN RC0805FR-071M13L
R203: 100k 1%; R_0805_2012Metric; MPN RC0805FR-07100KL
RS2: 25m / 1W / 1% WSL2512R0250FEA; WSL2512_7m_to_500m; MPN WSL2512R0250FEA
TP12: Connector 2 pins; PinHeader_1x02_P2.54mm_Vertical; MPN TSW-102-07-G-S
U12: LT8613EUDE; QFN-28-1EP_3x6mm_P0.5mm_EP1.7x4.75mm; MPN LT8613EUDE#PBF

Connections:
+24_LOAD: F12.1; also elsewhere on the board
EN2: U12.4 (EN_UV); also elsewhere on the board
GND: C201.2, C202.2, C203.2, C204.2, C206.2, C207.2, C208.2, J12.2, R201.2, R203.2, TP12.2, U12.1 (SYNC), U12.8 (PGND), U12.9 (PGND), U12.10 (PGND), U12.11 (GND), U12.12 (GND), U12.13 (GND), U12.14 (GND), U12.29 (EP_GND); also elsewhere on the board
ICTRL2: U12.28 (ICTRL); also elsewhere on the board
T2_BST: C205.1, U12.20 (BST)
T2_FB: C209.2, R202.2, R203.1, U12.24 (FB)
T2_IMON: TP12.1, U12.27 (IMON)
T2_INTVCC: C204.1, U12.21 (INTVCC)
T2_OUT: C209.1, J12.1, R202.1, RS2.2, U12.26 (ISN)
T2_RT: R201.1, U12.3 (RT)
T2_SS: C206.1, U12.2 (TR_SS)
T2_SW: C205.2, L2.1, U12.15 (SW), U12.16 (SW), U12.17 (SW), U12.18 (SW), U12.19 (SW)
T2_VIN: C201.1, C202.1, C203.1, F12.2, U12.5 (VIN), U12.6 (VIN), U12.7 (VIN)
T2_VREG: C207.1, C208.1, L2.2, RS2.1, U12.22 (BIAS), U12.25 (ISP)

Notes on the sheet:
Gegroepeerde IC-pinnen:
VIN 5/6/7; SW 15-19; GND 8-14/29.
+24_LOAD
08 Peltier stroomregelaar 2
ITO controller L | 24 V | prototype 4 A | bedrading volgens bestaande PCB
