luciddreams/ito-controller/ito-controller.kicad_pcb

## KiCad design ito-controller.kicad_pcb (continued)

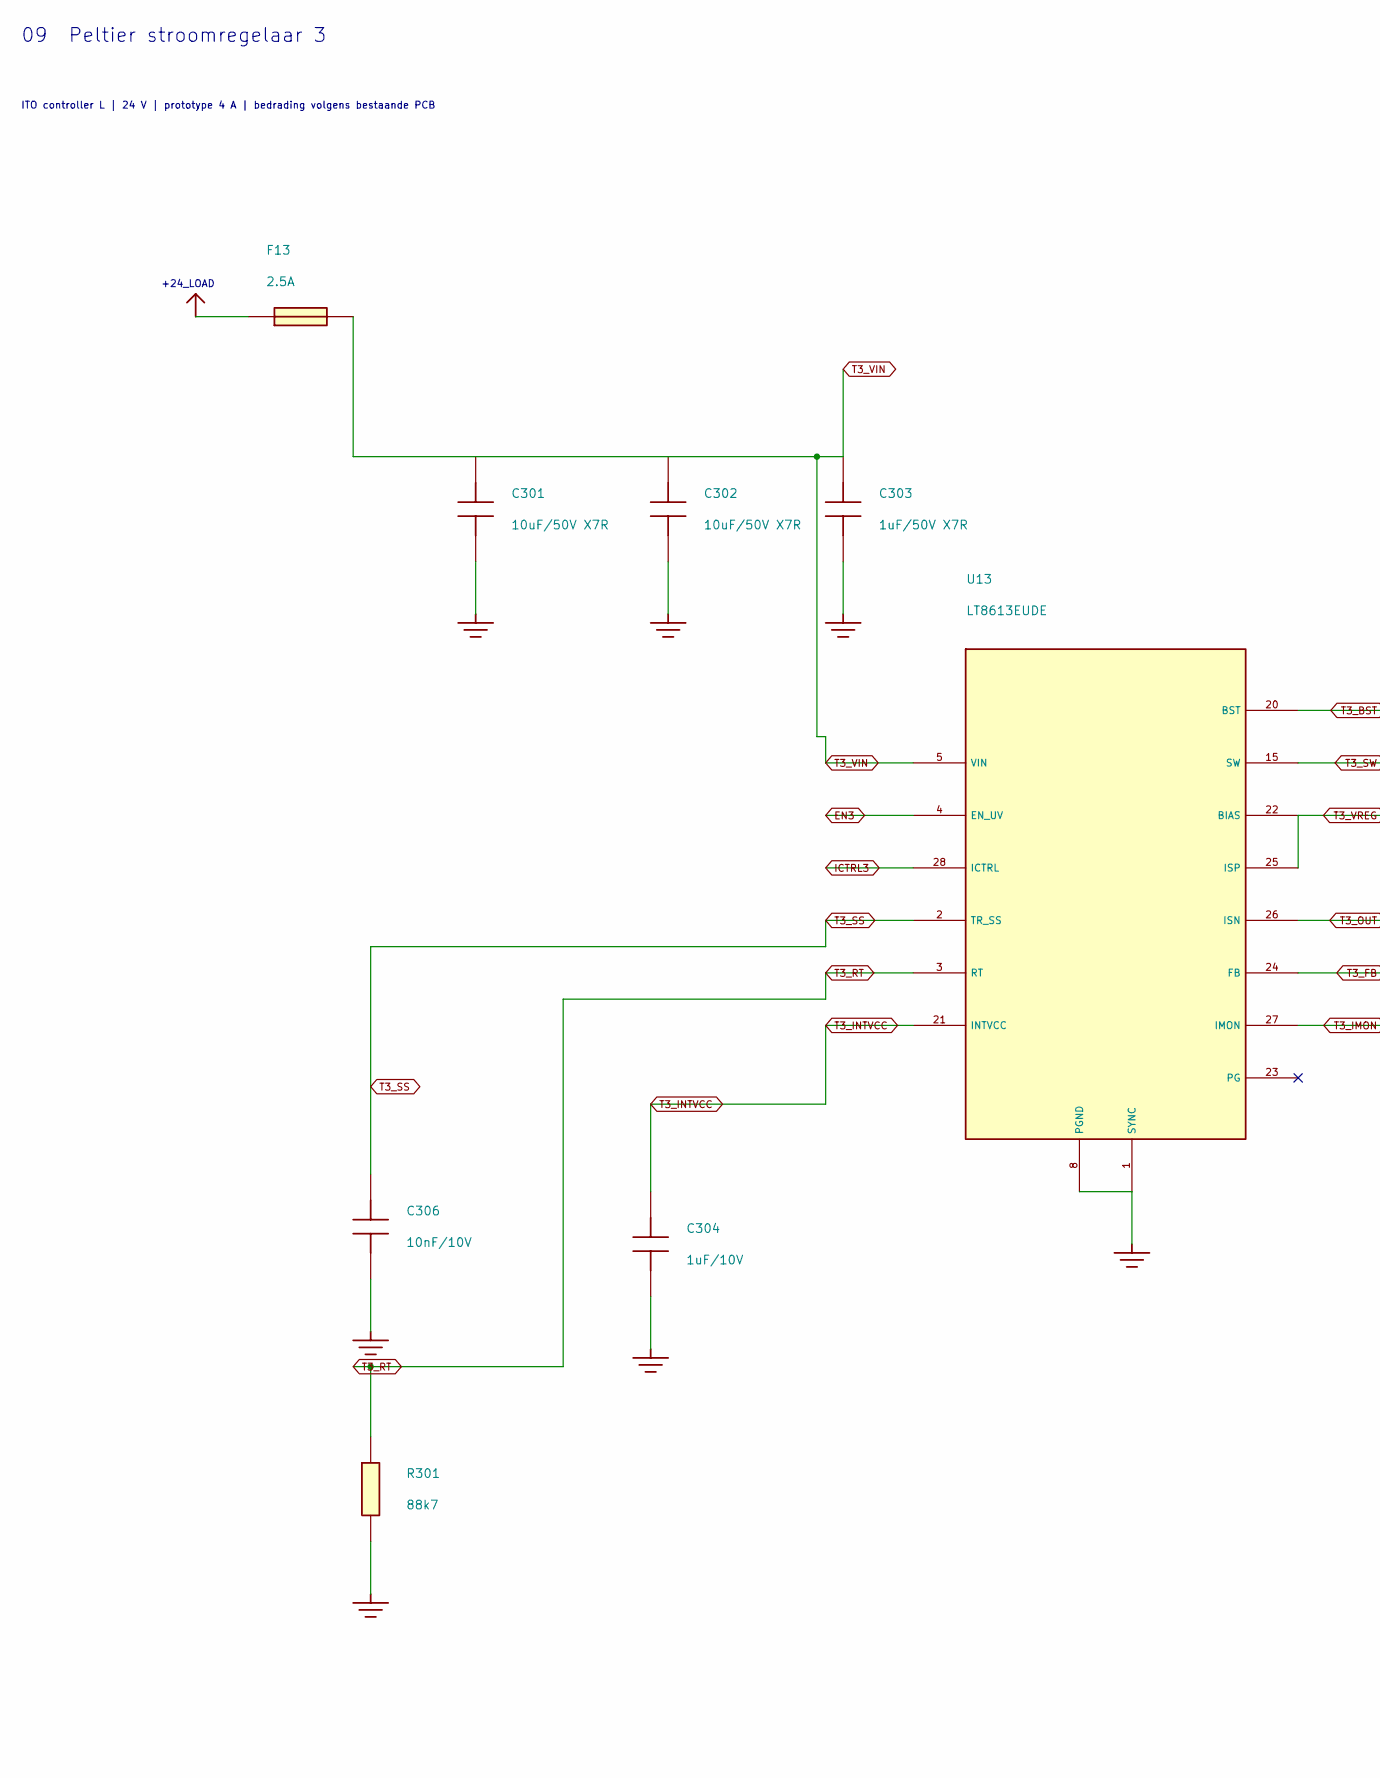
[picture p83: schematic sheet_09.kicad_sch, 09 Peltier stroomregelaar 3, part in row 1, column 1]

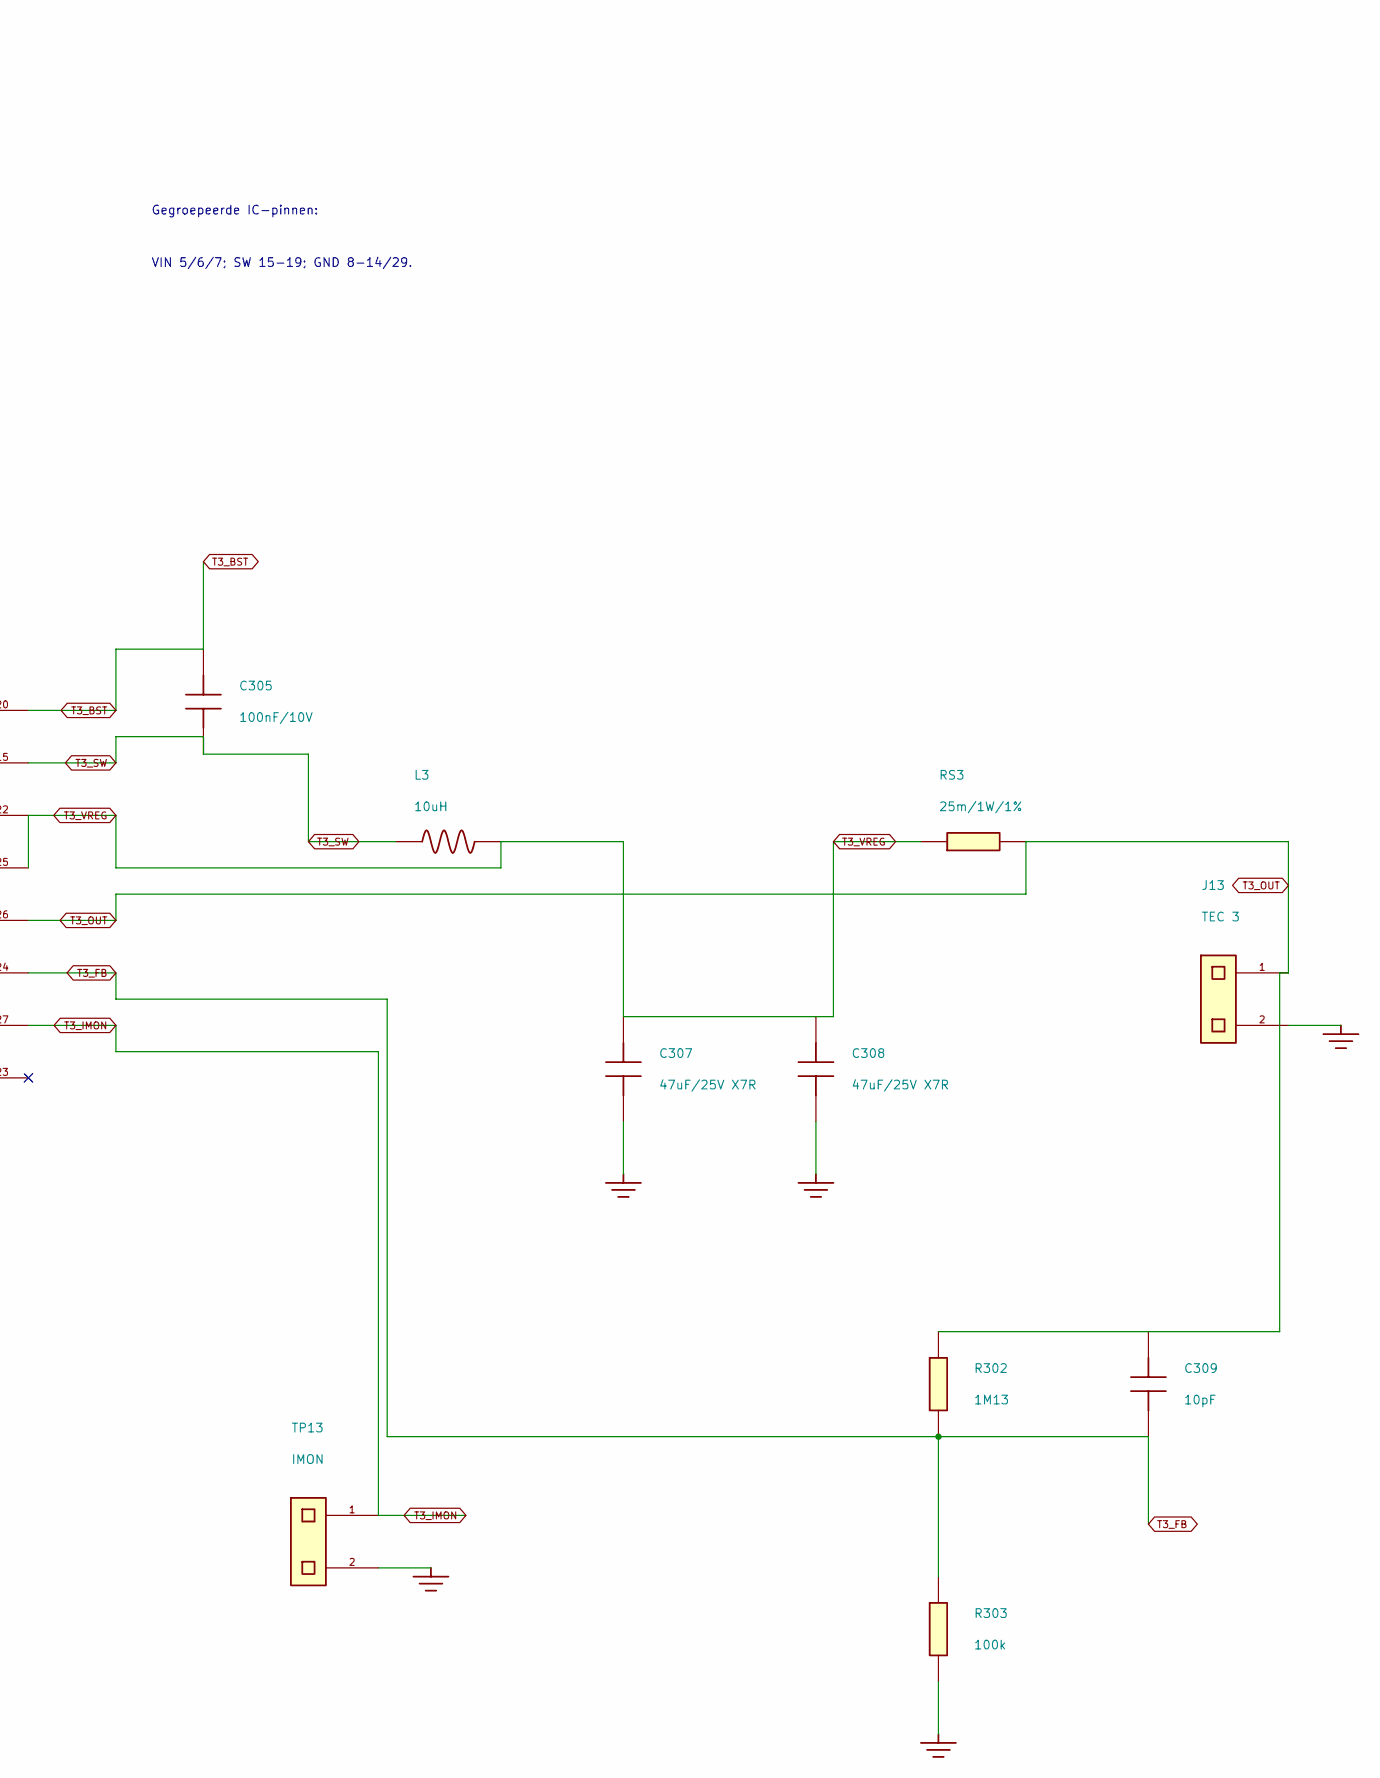
[picture p84: schematic sheet_09.kicad_sch, 09 Peltier stroomregelaar 3, part in row 1, column 2]

Parts:
C301, C302: 10u / 50V X7R; C_1210_3225Metric; MPN GRM32ER71H106KA12L
C303: 1u / 50V X7R; C_0805_2012Metric; MPN GRM21BR71H105KA12L
C304: 1u / 10V; C_0805_2012Metric; MPN GRM21BR71H105KA12L
C305: 100n / 10V; C_0805_2012Metric; MPN GRM21BR71H104KA01L
C306: 10n / 10V; C_0805_2012Metric; MPN GRM21BR71H103KA01L
C307, C308: 47u / 25V X7R C2220C476M3R2C7186; KEMET_KPS_2220_Double; MPN C2220C476M3R2C7186
C309: 10p C0G; C_0805_2012Metric; MPN C0805C100J5GACTU
F13: 2.5A / 125V DC 045102.5MRL; Littelfuse_451; MPN 045102.5MRL
J13: Connector 2 pins; TerminalBlock_Phoenix_MKDS-1,5-2-5.08_1x02_P5.08mm_Horizont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; MPN 1715721
L3: 10uH IHLP6767GZEK100M11; L_Vishay_IHLP-6767; MPN IHLP6767GZEK100M11
R301: 88k7 1%; R_0805_2012Metric; MPN RC0805FR-0788K7L
R302: 1M13 1%; R_0805_2012Metric; MPN RC0805FR-071M13L
R303: 100k 1%; R_0805_2012Metric; MPN RC0805FR-07100KL
RS3: 25m / 1W / 1% WSL2512R0250FEA; WSL2512_7m_to_500m; MPN WSL2512R0250FEA
TP13: Connector 2 pins; PinHeader_1x02_P2.54mm_Vertical; MPN TSW-102-07-G-S
U13: LT8613EUDE; QFN-28-1EP_3x6mm_P0.5mm_EP1.7x4.75mm; MPN LT8613EUDE#PBF

Connections:
+24_LOAD: F13.1; also elsewhere on the board
EN3: U13.4 (EN_UV); also elsewhere on the board
GND: C301.2, C302.2, C303.2, C304.2, C306.2, C307.2, C308.2, J13.2, R301.2, R303.2, TP13.2, U13.1 (SYNC), U13.8 (PGND), U13.9 (PGND), U13.10 (PGND), U13.11 (GND), U13.12 (GND), U13.13 (GND), U13.14 (GND), U13.29 (EP_GND); also elsewhere on the board
ICTRL3: U13.28 (ICTRL); also elsewhere on the board
T3_BST: C305.1, U13.20 (BST)
T3_FB: C309.2, R302.2, R303.1, U13.24 (FB)
T3_IMON: TP13.1, U13.27 (IMON)
T3_INTVCC: C304.1, U13.21 (INTVCC)
T3_OUT: C309.1, J13.1, R302.1, RS3.2, U13.26 (ISN)
T3_RT: R301.1, U13.3 (RT)
T3_SS: C306.1, U13.2 (TR_SS)
T3_SW: C305.2, L3.1, U13.15 (SW), U13.16 (SW), U13.17 (SW), U13.18 (SW), U13.19 (SW)
T3_VIN: C301.1, C302.1, C303.1, F13.2, U13.5 (VIN), U13.6 (VIN), U13.7 (VIN)
T3_VREG: C307.1, C308.1, L3.2, RS3.1, U13.22 (BIAS), U13.25 (ISP)

Notes on the sheet:
Gegroepeerde IC-pinnen:
VIN 5/6/7; SW 15-19; GND 8-14/29.
+24_LOAD
09 Peltier stroomregelaar 3
ITO controller L | 24 V | prototype 4 A | bedrading volgens bestaande PCB

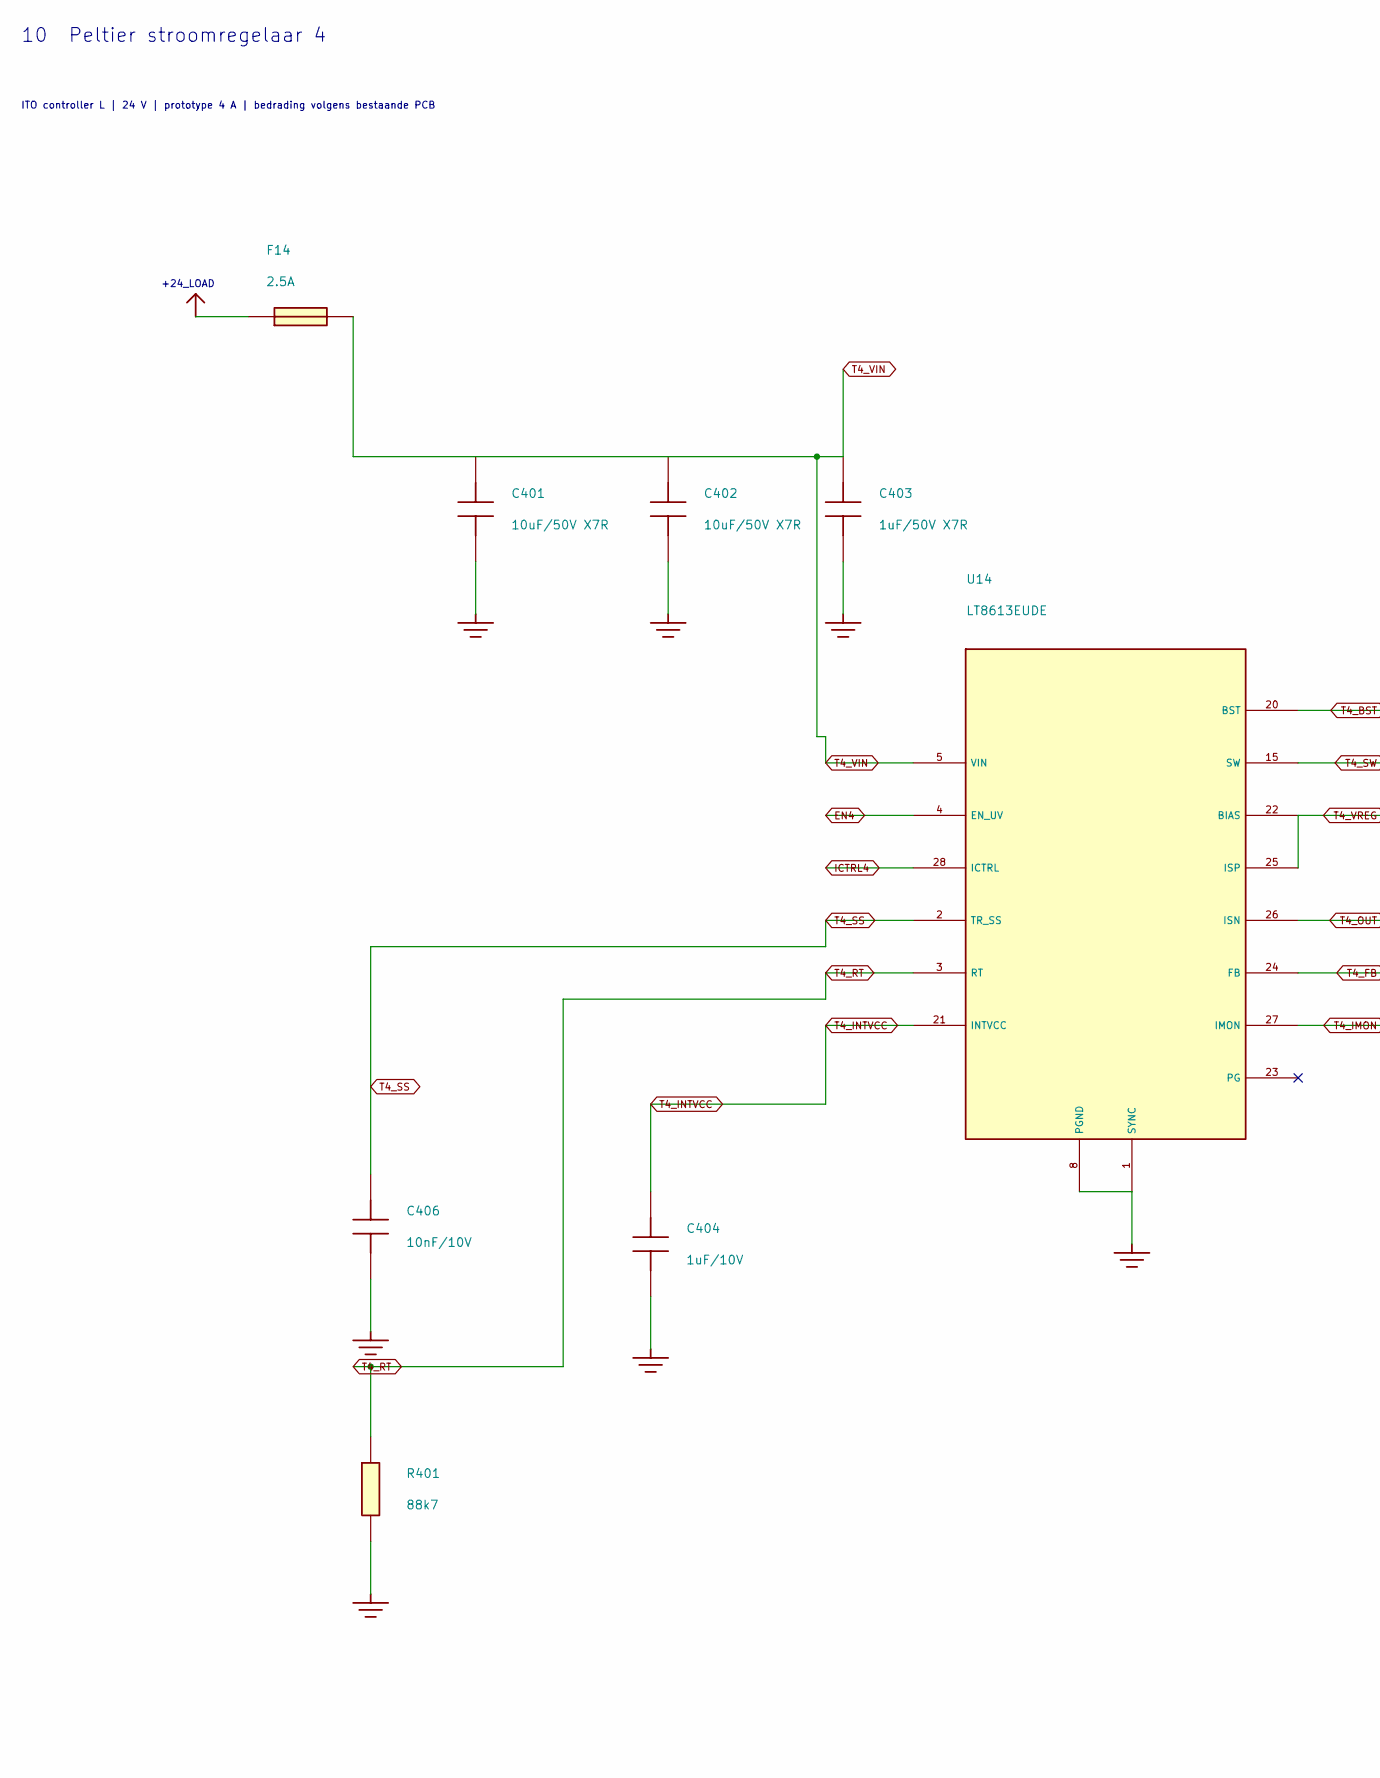
[picture p85: schematic sheet_10.kicad_sch, 10 Peltier stroomregelaar 4, part in row 1, column 1]

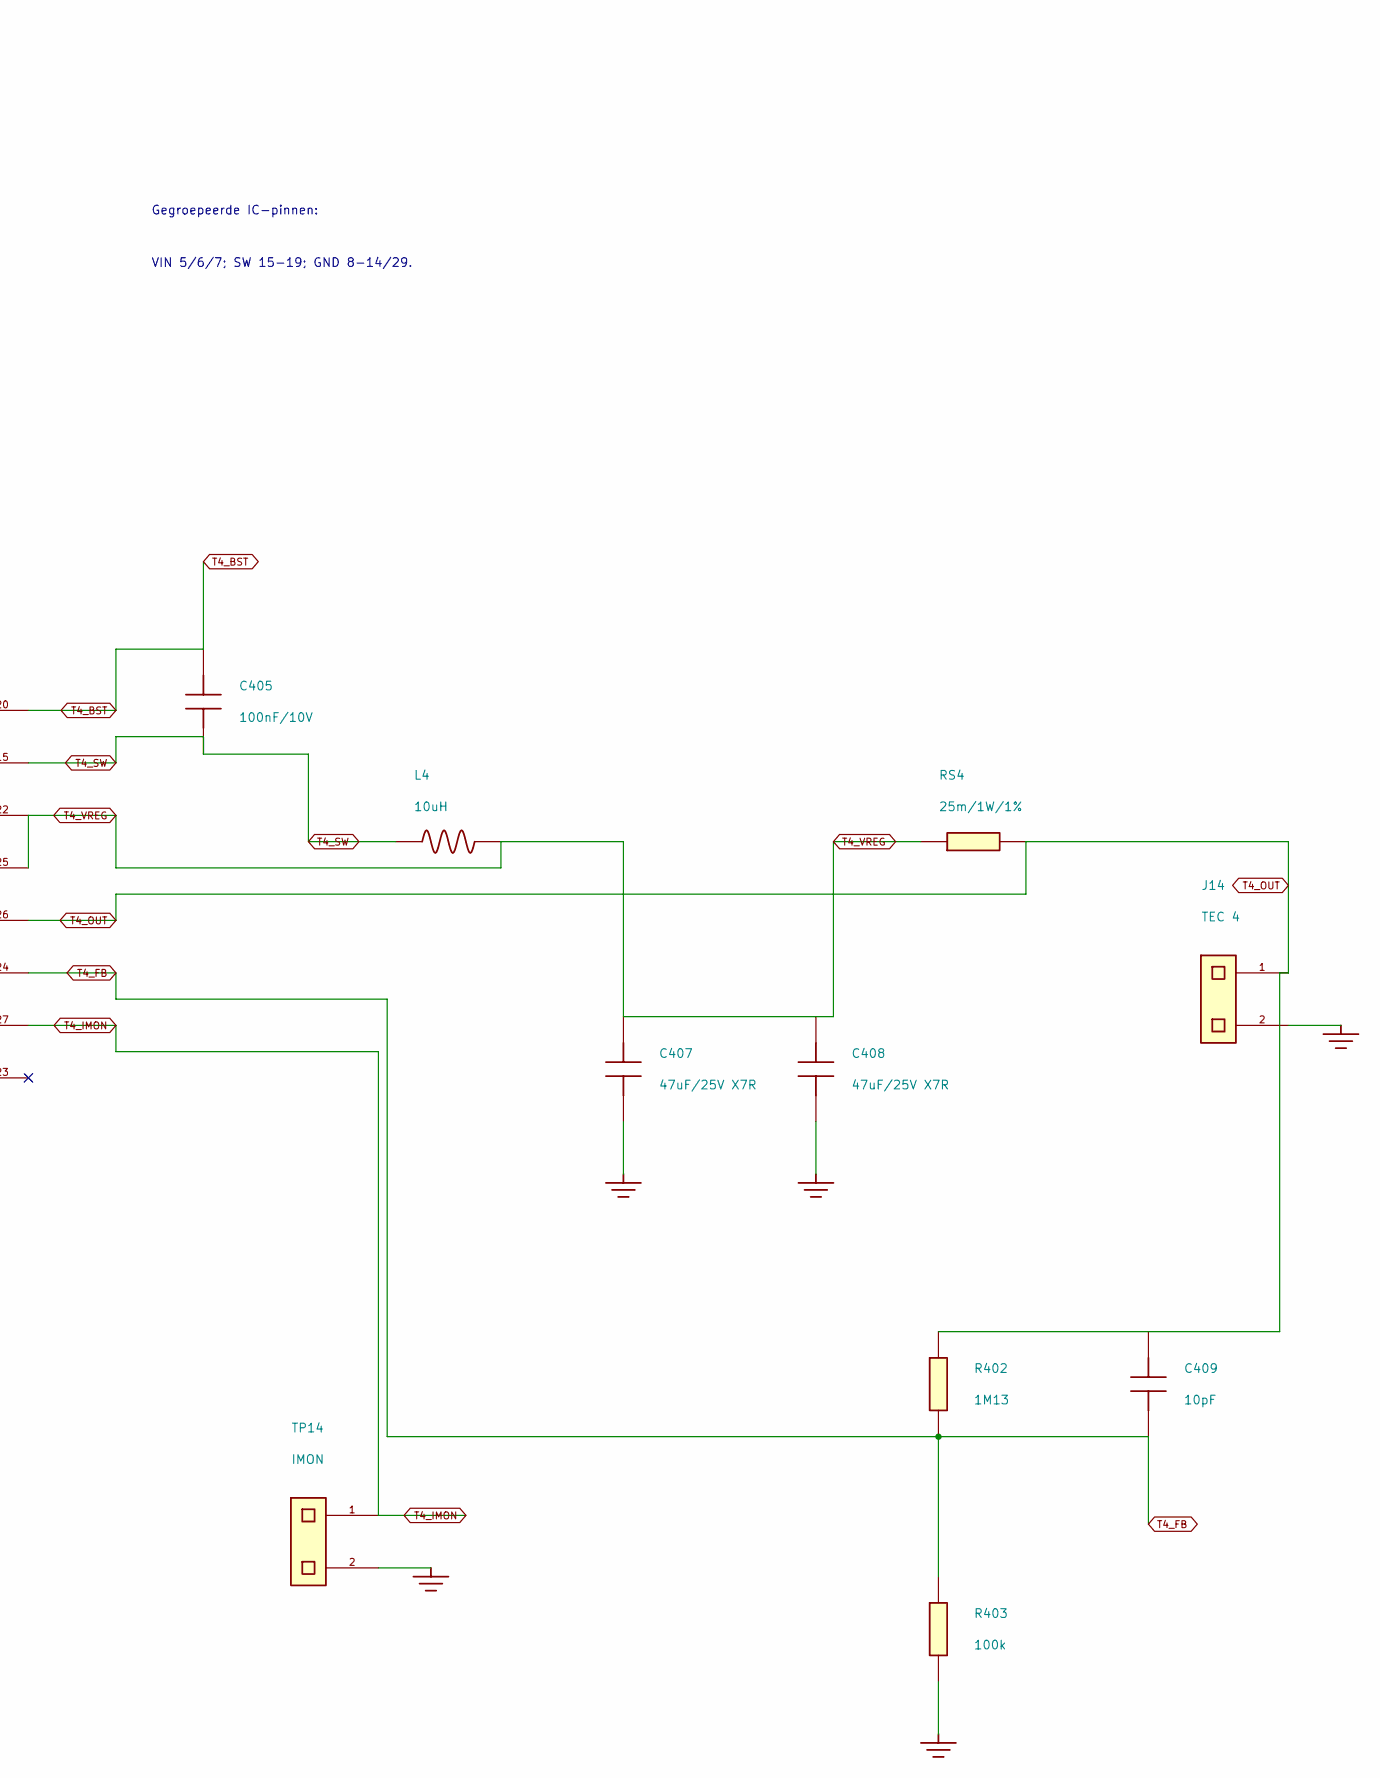
[picture p86: schematic sheet_10.kicad_sch, 10 Peltier stroomregelaar 4, part in row 1, column 2]

Parts:
C401, C402: 10u / 50V X7R; C_1210_3225Metric; MPN GRM32ER71H106KA12L
C403: 1u / 50V X7R; C_0805_2012Metric; MPN GRM21BR71H105KA12L
C404: 1u / 10V; C_0805_2012Metric; MPN GRM21BR71H105KA12L
C405: 100n / 10V; C_0805_2012Metric; MPN GRM21BR71H104KA01L
C406: 10n / 10V; C_0805_2012Metric; MPN GRM21BR71H103KA01L
C407, C408: 47u / 25V X7R C2220C476M3R2C7186; KEMET_KPS_2220_Double; MPN C2220C476M3R2C7186
C409: 10p C0G; C_0805_2012Metric; MPN C0805C100J5GACTU
F14: 2.5A / 125V DC 045102.5MRL; Littelfuse_451; MPN 045102.5MRL
J14: Connector 2 pins; TerminalBlock_Phoenix_MKDS-1,5-2-5.08_1x02_P5.08mm_Horizont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; MPN 1715721
L4: 10uH IHLP6767GZEK100M11; L_Vishay_IHLP-6767; MPN IHLP6767GZEK100M11
R401: 88k7 1%; R_0805_2012Metric; MPN RC0805FR-0788K7L
R402: 1M13 1%; R_0805_2012Metric; MPN RC0805FR-071M13L
R403: 100k 1%; R_0805_2012Metric; MPN RC0805FR-07100KL
RS4: 25m / 1W / 1% WSL2512R0250FEA; WSL2512_7m_to_500m; MPN WSL2512R0250FEA
TP14: Connector 2 pins; PinHeader_1x02_P2.54mm_Vertical; MPN TSW-102-07-G-S
U14: LT8613EUDE; QFN-28-1EP_3x6mm_P0.5mm_EP1.7x4.75mm; MPN LT8613EUDE#PBF

Connections:
+24_LOAD: F14.1; also elsewhere on the board
EN4: U14.4 (EN_UV); also elsewhere on the board
GND: C401.2, C402.2, C403.2, C404.2, C406.2, C407.2, C408.2, J14.2, R401.2, R403.2, TP14.2, U14.1 (SYNC), U14.8 (PGND), U14.9 (PGND), U14.10 (PGND), U14.11 (GND), U14.12 (GND), U14.13 (GND), U14.14 (GND), U14.29 (EP_GND); also elsewhere on the board
ICTRL4: U14.28 (ICTRL); also elsewhere on the board
T4_BST: C405.1, U14.20 (BST)
T4_FB: C409.2, R402.2, R403.1, U14.24 (FB)
T4_IMON: TP14.1, U14.27 (IMON)
T4_INTVCC: C404.1, U14.21 (INTVCC)
T4_OUT: C409.1, J14.1, R402.1, RS4.2, U14.26 (ISN)
T4_RT: R401.1, U14.3 (RT)
T4_SS: C406.1, U14.2 (TR_SS)
T4_SW: C405.2, L4.1, U14.15 (SW), U14.16 (SW), U14.17 (SW), U14.18 (SW), U14.19 (SW)
T4_VIN: C401.1, C402.1, C403.1, F14.2, U14.5 (VIN), U14.6 (VIN), U14.7 (VIN)
T4_VREG: C407.1, C408.1, L4.2, RS4.1, U14.22 (BIAS), U14.25 (ISP)

Notes on the sheet:
Gegroepeerde IC-pinnen:
VIN 5/6/7; SW 15-19; GND 8-14/29.
+24_LOAD
10 Peltier stroomregelaar 4
ITO controller L | 24 V | prototype 4 A | bedrading volgens bestaande PCB

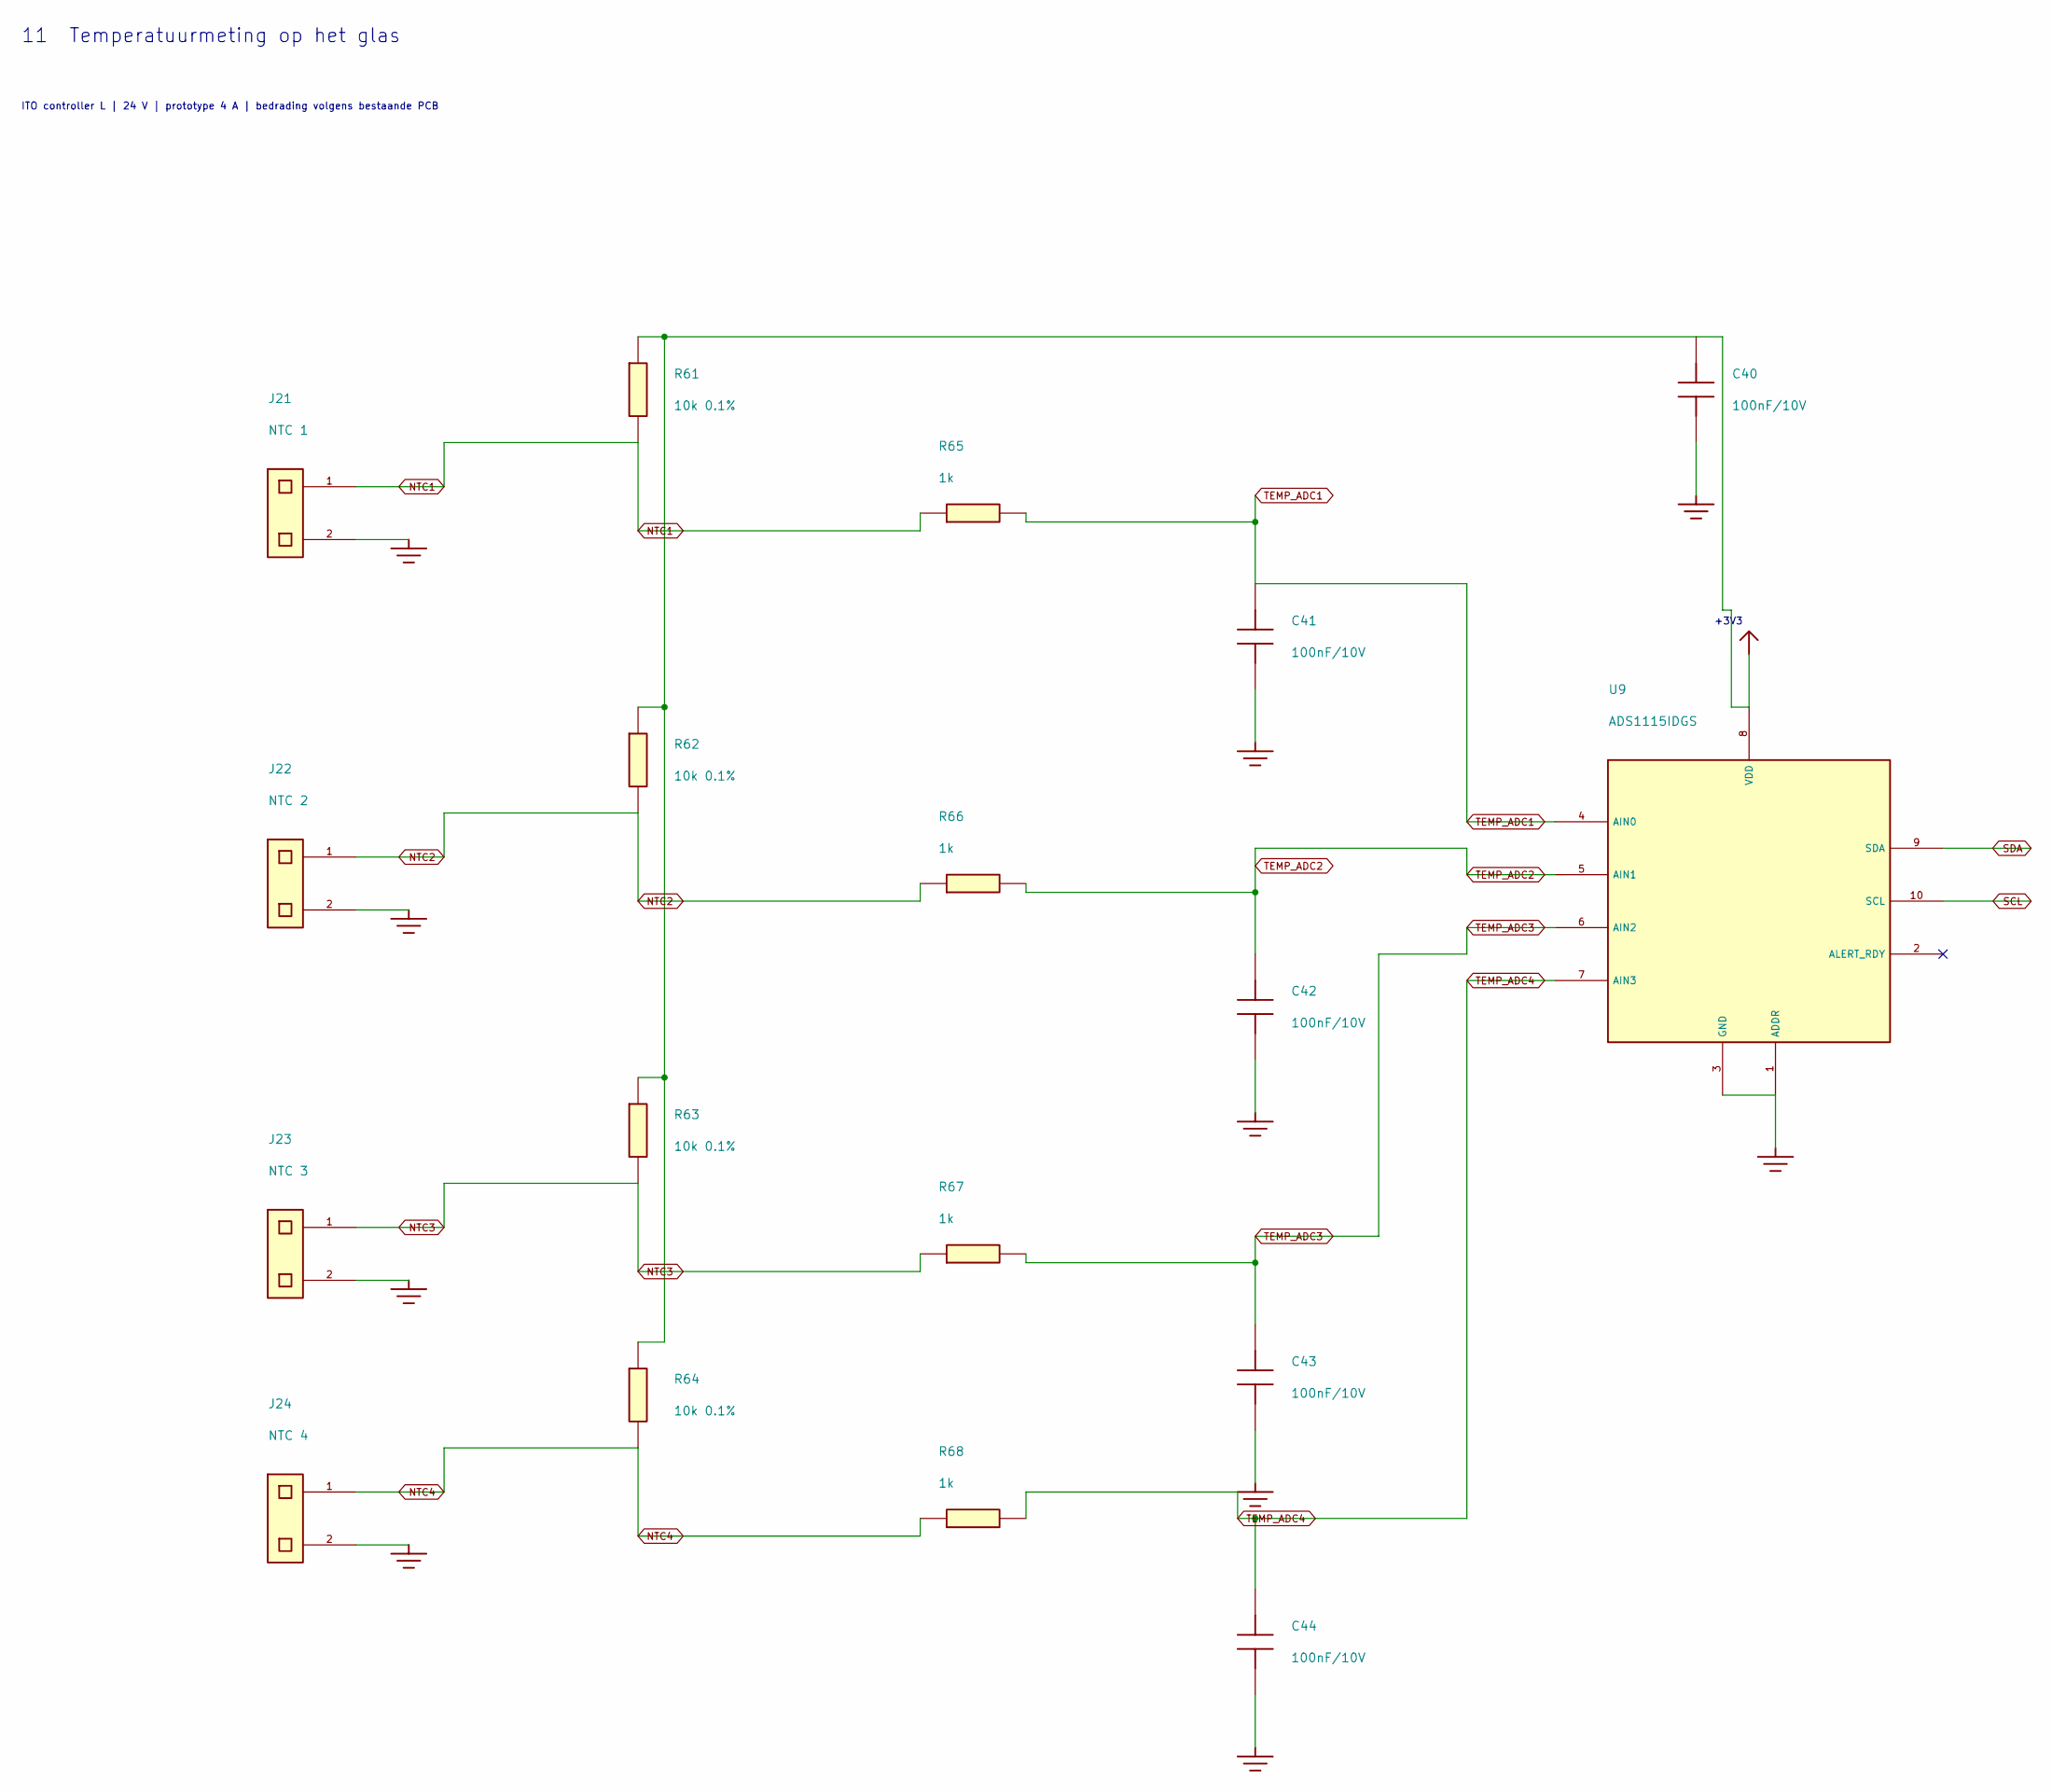
[picture p87: schematic sheet_11.kicad_sch, 11 Temperatuurmeting op het glas]

Parts:
C40, C41, C42, C43, C44: 100n / 10V; C_0805_2012Metric; MPN GRM21BR71H104KA01L
J21, J22, J23, J24: Connector 2 pins; JST_XH_B2B-XH-A_1x02_P2.50mm_Vertical; MPN B2B-XH-A(LF)(SN)
R61, R62, R63, R64: 10k 0.1%; R_0805_2012Metric; MPN RT0805BRD0710KL
R65, R66, R67, R68: 1k; R_0805_2012Metric; MPN RC0805FR-071KL
U9: ADS1115IDGS; VSSOP-10_3x3mm_P0.5mm; MPN ADS1115IDGSR

Connections:
+3V3: C40.1, R61.1, R62.1, R63.1, R64.1, U9.8 (VDD); also elsewhere on the board
GND: C40.2, C41.2, C42.2, C43.2, C44.2, J21.2, J22.2, J23.2, J24.2, U9.1 (ADDR), U9.3 (GND); also elsewhere on the board
NTC1: J21.1, R61.2, R65.1
NTC2: J22.1, R62.2, R66.1
NTC3: J23.1, R63.2, R67.1
NTC4: J24.1, R64.2, R68.1
SCL: U9.10 (SCL); also elsewhere on the board
SDA: U9.9 (SDA); also elsewhere on the board
TEMP_ADC1: C41.1, R65.2, U9.4 (AIN0)
TEMP_ADC2: C42.1, R66.2, U9.5 (AIN1)
TEMP_ADC3: C43.1, R67.2, U9.6 (AIN2)
TEMP_ADC4: C44.1, R68.2, U9.7 (AIN3)

Notes on the sheet:
+3V3
11 Temperatuurmeting op het glas
ITO controller L | 24 V | prototype 4 A | bedrading volgens bestaande PCB

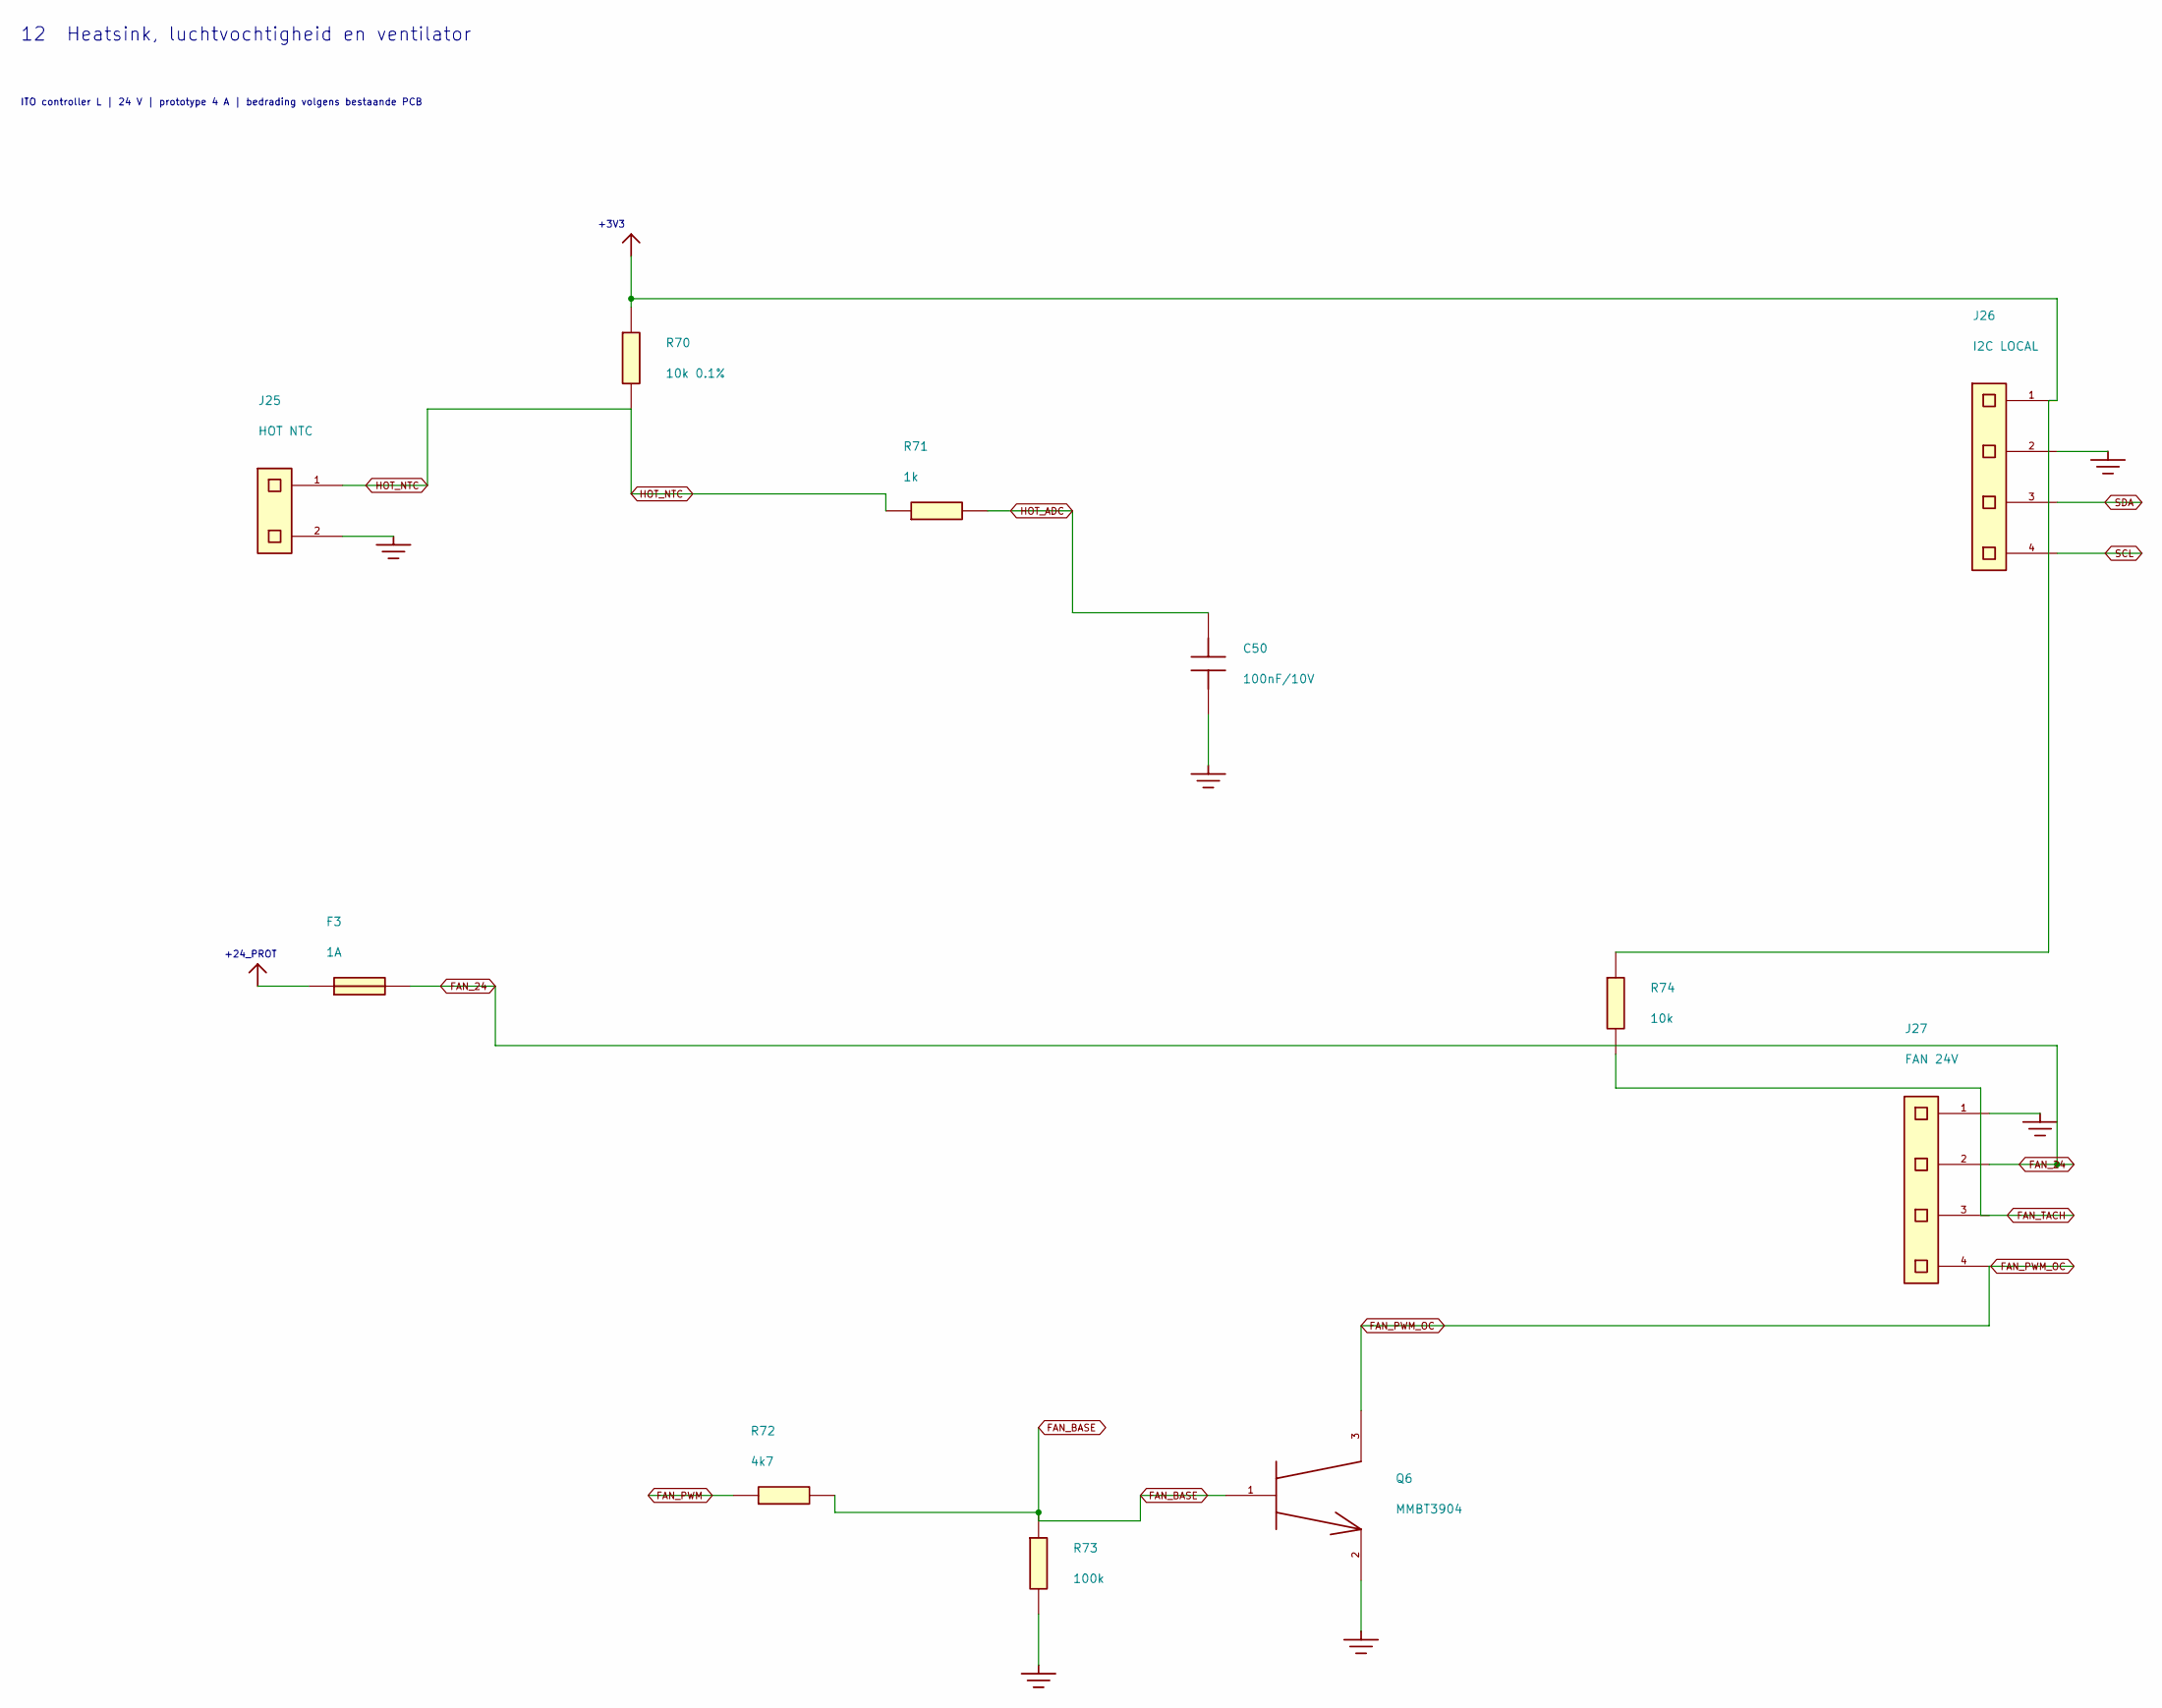
[picture p88: schematic sheet_12.kicad_sch, 12 Heatsink, luchtvochtigheid en ventilator]

Parts:
C50: 100n / 10V; C_0805_2012Metric; MPN GRM21BR71H104KA01L
F3: 1A / 125V DC 0451001.MRL; Littelfuse_451; MPN 0451001.MRL
J25: Connector 2 pins; JST_XH_B2B-XH-A_1x02_P2.50mm_Vertical; MPN B2B-XH-A(LF)(SN)
J26, J27: Connector 4 pins; JST_XH_B4B-XH-A_1x04_P2.50mm_Vertical; MPN B4B-XH-A(LF)(SN)
Q6: MMBT3904; SOT-23; MPN MMBT3904LT1G
R70: 10k 0.1%; R_0805_2012Metric; MPN RT0805BRD0710KL
R71: 1k; R_0805_2012Metric; MPN RC0805FR-071KL
R72: 4k7; R_0805_2012Metric; MPN RC0805FR-074K7L
R73: 100k; R_0805_2012Metric; MPN RC0805FR-07100KL
R74: 10k; R_0805_2012Metric; MPN RC0805FR-0710KL

Connections:
+3V3: J26.1, R70.1, R74.1; also elsewhere on the board
+24_PROT: F3.1; also elsewhere on the board
FAN_24: F3.2, J27.2
FAN_BASE: Q6.1, R72.2, R73.1
FAN_PWM: R72.1; also elsewhere on the board
FAN_PWM_OC: J27.4, Q6.3
FAN_TACH: J27.3, R74.2; also elsewhere on the board
GND: C50.2, J25.2, J26.2, J27.1, Q6.2, R73.2; also elsewhere on the board
HOT_ADC: C50.1, R71.2; also elsewhere on the board
HOT_NTC: J25.1, R70.2, R71.1
SCL: J26.4; also elsewhere on the board
SDA: J26.3; also elsewhere on the board

Notes on the sheet:
+3V3
+24_PROT
12 Heatsink, luchtvochtigheid en ventilator
ITO controller L | 24 V | prototype 4 A | bedrading volgens bestaande PCB
