luciddreams/ito-controller/ito-controller.kicad_pcb

## KiCad design ito-controller.kicad_pcb (continued)

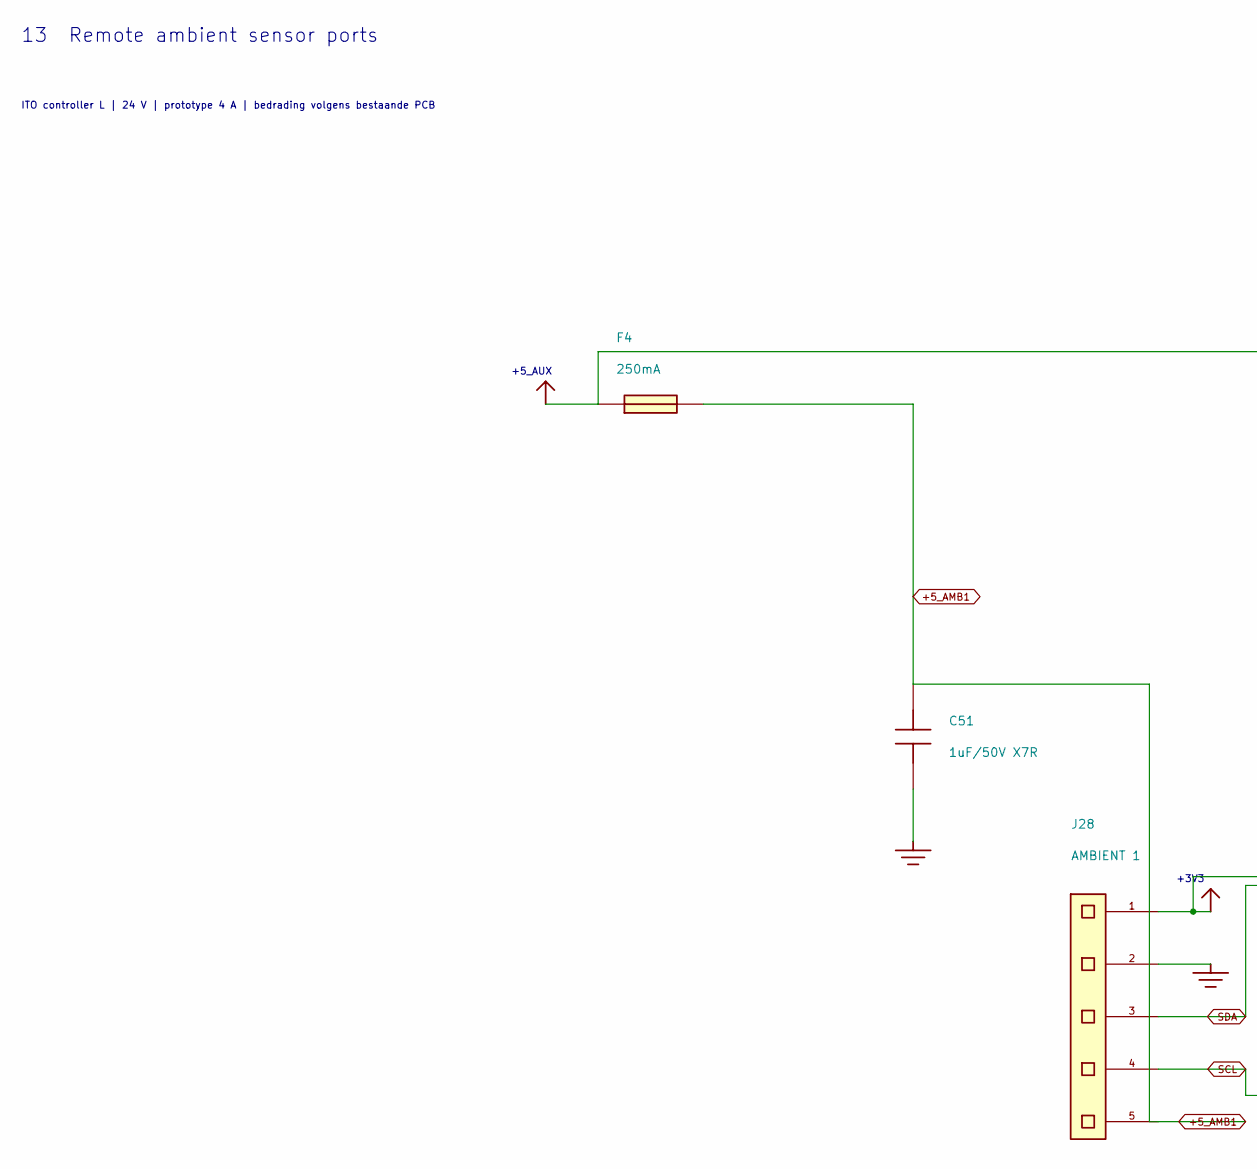
[picture p89: schematic sheet_13.kicad_sch, 13 Remote ambient sensor ports, part in row 1, column 1]

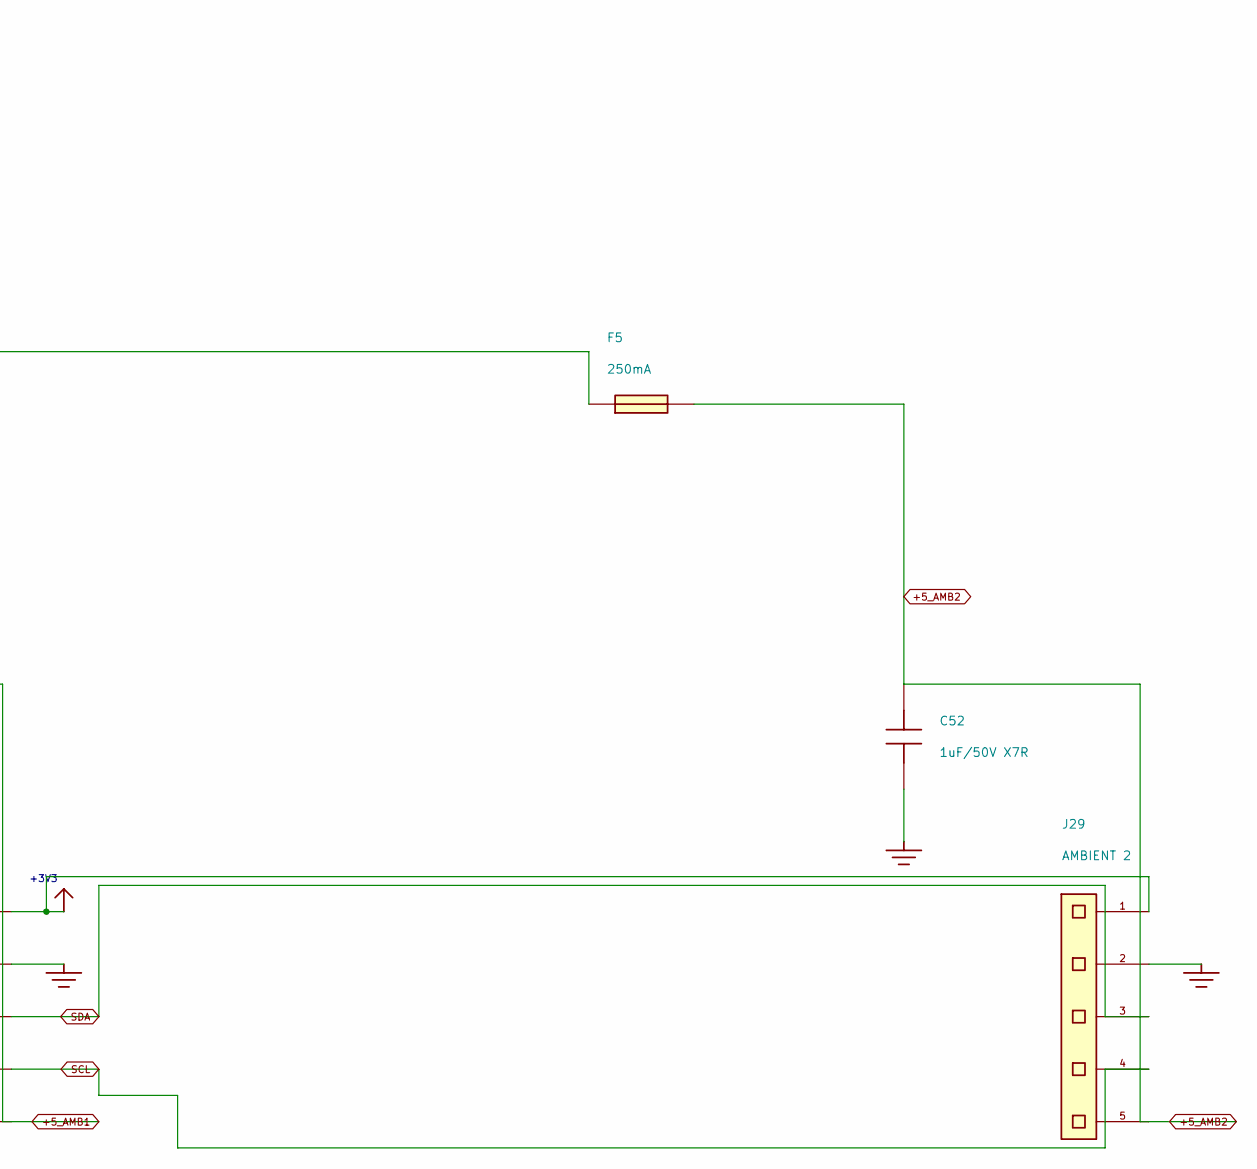
[picture p90: schematic sheet_13.kicad_sch, 13 Remote ambient sensor ports, part in row 1, column 2]

Parts:
C51, C52: 1u / 50V X7R; C_0805_2012Metric
F4, F5: 250mA / 125V 0451.250MRL; Littelfuse_451
J28: AMBIENT 1 - LOCAL ADAPTER; JST_XH_B5B-XH-A_1x05_P2.50mm_Vertical
J29: AMBIENT 2 - LOCAL ADAPTER; JST_XH_B5B-XH-A_1x05_P2.50mm_Vertical

Connections:
+3V3: J28.1 (3V3REF), J29.1 (3V3REF); also elsewhere on the board
+5_AMB1: C51.1, F4.2, J28.5 (5V)
+5_AMB2: C52.1, F5.2, J29.5 (5V)
+5_AUX: F4.1, F5.1; also elsewhere on the board
GND: C51.2, C52.2, J28.2 (GND), J29.2 (GND); also elsewhere on the board
SCL: J28.4 (SCL), J29.4 (SCL); also elsewhere on the board
SDA: J28.3 (SDA), J29.3 (SDA); also elsewhere on the board

Notes on the sheet:
+3V3
+5_AUX
13 Remote ambient sensor ports
ITO controller L | 24 V | prototype 4 A | bedrading volgens bestaande PCB

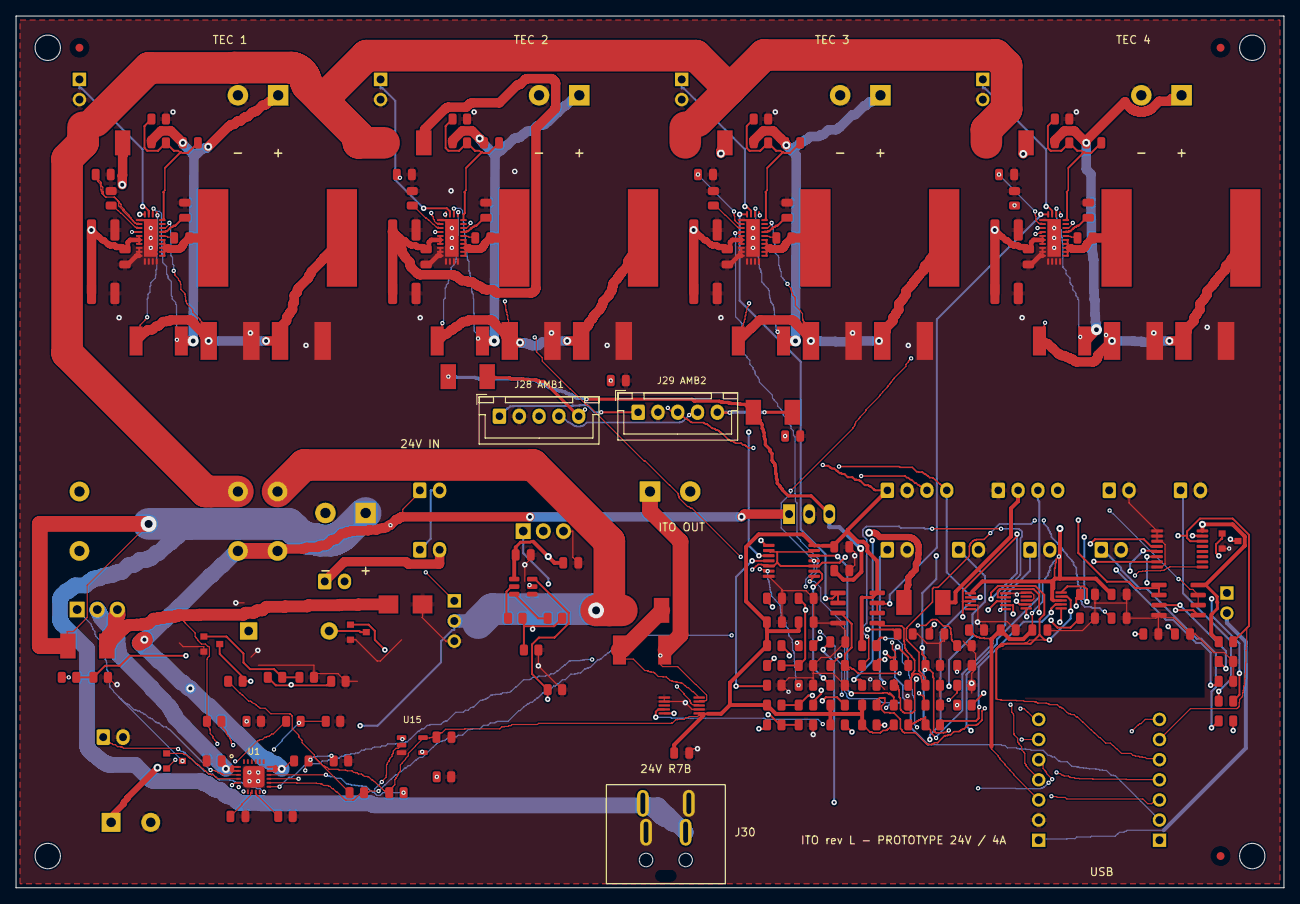
[picture p91: board ito-controller.kicad_pcb from above]

Board: 4 copper layers, 160.0 x 110.0 mm, 209 parts (0 on the bottom side), 119 nets.

Other parts of the board:
FID1, FID2, FID3: Fiducial 1mm; Fiducial_1mm_Mask2mm
H1, H2, H3, H4: MountingHole_3.2mm
