luciddreams/ito-controller/firmware/tailscale/main/tailnet_local.example.h

#pragma once
// Copy to tailnet_local.h. Never commit the configured file or share its binary.
#define ITO_WIFI_SSID "YOUR_2_4_GHZ_NETWORK"
#define ITO_WIFI_PASSWORD "YOUR_WIFI_PASSWORD"
#define ITO_TAILSCALE_AUTH_KEY "YOUR_TAILSCALE_AUTH_KEY"
#define ITO_TAILSCALE_NAME "ito-controller"
#define ITO_MQTT_HOST "luciddreams.tail8decad.ts.net"
#define ITO_MQTT_PORT 1883
#define ITO_MQTT_CLIENT_ID "ito-controller-01"
#define ITO_MQTT_TOPIC "ito/controller-01/telemetry"
#define ITO_MQTT_USER "ito-controller-01"
#define ITO_MQTT_PASSWORD "YOUR_MQTT_PASSWORD"
