luciddreams/ito-controller/firmware/esp32s3/tests/Arduino.h

#pragma once
#include <stdint.h>
#include <stddef.h>
#include <string>
#include <string.h>
#define IRAM_ATTR
#define ADC_11db 3
static bool mockWatchdogOK=true;
#define LOW 0
#define HIGH 1
#define INPUT 0
#define OUTPUT 1
#define FALLING 2
#define AR_INTERNAL 0
constexpr unsigned D0=0,D1=1,D2=2,D3=3,D4=4,D5=5,D6=6,D7=7,D8=8,D9=9,D10=10,A0=0,A1=1;
static uint32_t clockMs=5000;
static int gpio[11]={};
static unsigned mockRaw[2]={2048,0},mockMv[2]={1650,0};
inline uint32_t millis(){return clockMs;}
inline uint32_t micros(){return clockMs*1000;}
inline void delay(unsigned n){clockMs+=n;}
inline void delayMicroseconds(unsigned){}
inline void digitalWrite(unsigned p,int v){gpio[p]=v;}
inline int digitalRead(unsigned p){return gpio[p];}
inline void pinMode(unsigned,int){}
inline void noInterrupts(){}
inline void interrupts(){}
inline unsigned digitalPinToInterrupt(unsigned p){return p;}
inline void attachInterrupt(unsigned,void(*)(),int){}
inline void analogReference(unsigned){}
inline void analogReadResolution(unsigned){}
inline unsigned analogRead(unsigned p){return mockRaw[p];}
inline unsigned analogReadMilliVolts(unsigned p){return mockMv[p];}
inline void analogSetPinAttenuation(unsigned,unsigned){}
struct SerialMock{
 bool connected=true;std::string output;std::string input;int capacity=1024;
 operator bool()const{return connected;}
 void begin(unsigned){}
 void setTxTimeoutMs(unsigned){}
 int availableForWrite(){return capacity;}
 size_t write(const uint8_t* p,size_t n){output.append((const char*)p,n);return n;}
 int available(){return input.size();}int read(){if(input.empty())return -1;char c=input[0];input.erase(0,1);return c;}
};
static SerialMock Serial;
