luciddreams/ito-controller/(commit log)

2026-09-26 Import complete revision L: KiCad, firmware, fabrication, 40 datasheets and detailed documentation
    [BOM-prototype.csv, BOM-review.csv, CP_Radial_D12.5mm_P5.00mm.step, C_0805_2012Metric.step, C_1210_3225Metric.step, Converter_DCDC_TRACO_TSR-1_THT.step, D_DO-41_SOD81_P10.16mm_Horizontal.step, D_SMB.step]
2026-09-26 Use English for active documentation and schematic annotations; preserve electrical design
    [BOM-prototype.csv, connector-pinout.csv, ito-controller.kicad_sch, sheet_01.kicad_sch, sheet_02.kicad_sch, sheet_03.kicad_sch, sheet_04.kicad_sch, sheet_05.kicad_sch]
2026-09-26 Add purchasing BOM with browser checkboxes, Excel order tracker and usage guide
    [ITO-Controller-Order-Tracker.xlsx]
2026-10-25 Add diagnostic-first XIAO ESP32S3 firmware for revision L
2026-10-25 Add local Next.js dashboard and read-only ESP32S3 Wi-Fi telemetry
2026-10-25 Fix Windows collision with ESP32 Network.h by renaming Wi-Fi monitor header
    [controller.h, ito_wifi_monitor.h]
2026-10-25 Fix TinyUSB source mismatch by pinning compatible 0.19.0
    [bootstrap.py]
2026-10-25 Align USB builder and TinyUSB with Arduino 3.3.2 generation
2026-10-25 Match TinyUSB register definitions to pinned Espressif USB driver
2026-10-25 Pin TinyUSB revision exposing Espressif driver spin-lock API
2026-10-25 Fix Tailscale monitor reboot loop and add USB-visible diagnostics
    MicroLink pins ml_coord (priority 5) and ml_wg_mgr (priority 7) to core 1 and
    logs through the blocking UART0 console, which starved the priority-2 control
    loop past its 250 ms task watchdog every 12-20 s. Run the control loop at
    priority 10 and capture ESP-IDF logging in a PSRAM ring instead of UART0.
    - main.cpp: start TinyUSB (Arduino autostart is off); RTC-backed DIAG record
    (reset reason, task-watchdog culprit, panic PC/backtrace through
    set_arduino_panic_handler, core-1 canaries, heap low-water mark); log ring
    streamed to the CDC port; 5 ms CDC write timeout (Arduino-ESP32 3.3.2 drops
    every byte at 0 ms)
    - main/C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
    [main.cpp]
2026-10-25 Raise MicroLink peer limit to 16 so MQTT reaches the broker
    The tailnet has 13 peers and the broker came 10th in the MapResponse, so
    with 8 slots MicroLink logged "Peer table full" and never built a
    WireGuard tunnel to it; MQTT stayed in mqtt_connecting. Raise both
    config.max_peers and CONFIG_ML_MAX_PEERS (which clamps it) to 16.
    Verified on hardware: broker tunnel up 18 s after boot,
    tailnet=mqtt_connected, gap_ctrl_ms=40, min free internal heap 93 KB.
    Update the handoff notes with the cause, fix and a Wi-Fi hint.
    [ito_tailnet_monitor.h]
2026-10-25 Use wall-clock WireGuard handshake timestamps so MQTT reconnects after reboot
    MicroLink's wireguard_tai64n_now() stamps handshake initiations with
    uptime, so after a reboot the broker's tailscaled dropped every new
    handshake as a replay and MQTT sat in mqtt_connecting for minutes.
    Wrap it to send NTP wall-clock TAI64N (time is synced before
    microlink_init); before a valid clock it falls back to MicroLink's value.
    Verified on hardware: reconnect ~15 s after reboot, stable for 5 min.
    Also ignore extra build-* folders, which embed credentials, and record
    the open on-PCB core-1 starvation issue and the failed core-0 attempt
    in the handoff notes.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
    [main.cpp]
