luciddreams/ito-controller/(notices)

Notices in the files:
3dmodels/WSL2512_7m_to_500m.step:
Copyright (C) 2018, kicad StepUp
This work is licensed under the [Creative Commons CC-BY-SA 4.0 License](https://creativecommons.org/licenses/by-sa/4.0/legalcode),
with the following exception:
To the extent that the creation of electronic designs that use 'Licensed Material' can be considered to be 'Adapted Material',
You are free to use the library data in your own projects without the obligation to share your project files under this or any other license agreement.
3dmodels/SOT-23.step:
Copyright (C) 2017, kicad StepUp
3dmodels/D_SMB.step:
This program is free software: you can redistribute it and/or modify
it under the terms of the GNU General Public License as published by
the Free Software Foundation, either version 3 of the License, or
any later version.
itself might be covered by the GNU General Public License.
3dmodels/JST_XH_B2B-XH-A_1x02_P2.50mm_Vertical.step:
Copyright (C) 2019, Rene Poeschl
3dmodels/TerminalBlock_Phoenix_MKDS-1,5-2-5.08_1x02_P5.08mm_Horizontal.step:
Copyright (C) 2020, kicad StepUp
